CongducPham/PEPR_AgriFutur/README.md

Sensing Platform for the PEPR AgriFutur project
=======================================================

Read the latest news
-------

Read the [latest News for the PEPR AgriFutur project](https://iotsensingsystem.live-website.com/news-on-pepr-agrifutur) that are maintained on the [IoT-Sensing-System at UPPA web site](https://iotsensingsystem.live-website.com).

History
-------
- **Jan-25** Preliminary codes have been uploaded: the code for a Generic Simple Sensor Node and the code for a PoC LoRa image sensor node (LoRaCAM-AI).

- **Nov-24** We created the GitHub repository for the AgriFutur flagship project of the PEPR program. Check contributions & activities of UPPA team project on the [IoT-Sensing-System web site](https://iotsensingsystem.live-website.com/news-on-pepr-agrifutur). AgriFutur officially started in Feb. 1st, 2025. Stay tuned!

Quick start
-----------

The [Arduino sketch](https://github.com/CongducPham/PEPR_AgriFutur/tree/main/Arduino/Generic_Simple_Sensor_Node) for the Generic Simple Sensor Node is in the [Arduino folder](https://github.com/CongducPham/PEPR_AgriFutur/tree/main/Arduino). It is based on the code developed for the [PRIMA INTEL-IRRIS project](https://intel-irris.eu/) that is now extended and maintained in the context of AgriFutur. All the tutorials to build sensor devices with the developed PCB v4.1 (RFM95) and PCB v5 (RAK3172) are in the [Tutorials](https://github.com/CongducPham/PEPR_AgriFutur/tree/main/Tutorials) folder. Fully assembled PCBs can be ordered directly from the PCB manufacturer. See the [README](https://github.com/CongducPham/PEPR_AgriFutur/blob/main/PCBs/README.md) for guidelines to do so. 

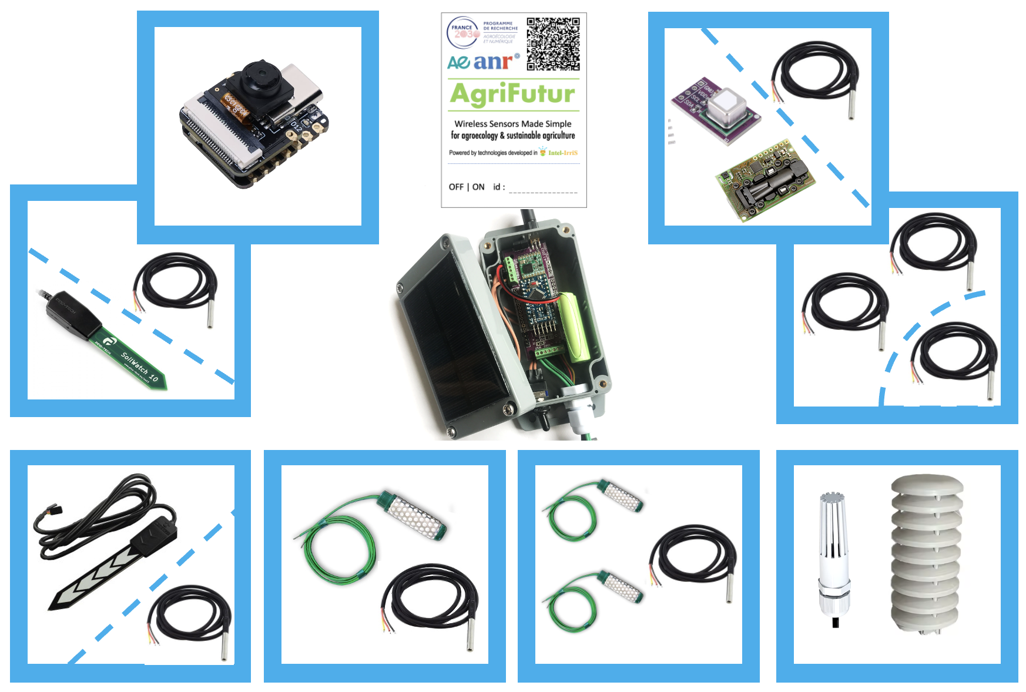
[picture p1: images/generic-sensors.png]


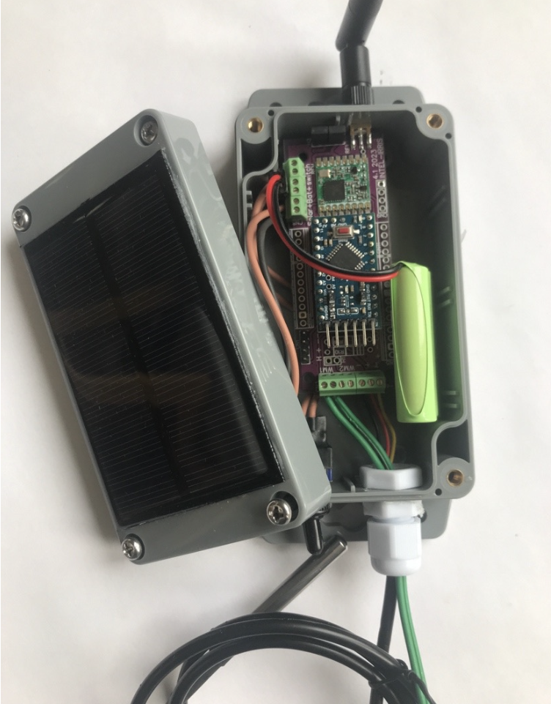
[picture p2: images/sensor-device.png]


The [PoC of a LoRa image sensor (LoRaCAM-AI)](https://github.com/CongducPham/PEPR_AgriFutur/tree/main/Arduino_ESP32/Arduino_ESP32_LoRaCAM_AI_on_esp32v3) based on ESP32 camera board is in the [Arduino_ESP32 folder](https://github.com/CongducPham/PEPR_AgriFutur/tree/main/Arduino_ESP32) where a dedicated [README](https://github.com/CongducPham/PEPR_AgriFutur/tree/main/Arduino_ESP32/README.md) is available. We tested several ESP32-based camera boards. The main criterion was to have enough pins left to easily connect an SPI LoRa radio module. 3 boards offer this capabilities: `Freenove ESP32-S3 WROOM`, `Freenove ESP32 WROVER v1.6` and `XIAO ESP32-S3 Sense`. The choice was finally set to the state-of-the-art `XIAO ESP32-S3 Sense` which has a huge developer community and enough resource to run some embedded AI processing that we want to add in the future, and all this in a quite compact format. If other boards appear on the market, the [LoRa test sketch](https://github.com/CongducPham/PEPR_AgriFutur/tree/main/Arduino_ESP32/Arduino_ESP32_LoRa_SX12XX_test) can be used to test whether the LoRa radio module you choose can be controlled by the pins on the new boards. Of course, you have to change the pin mapping and test.

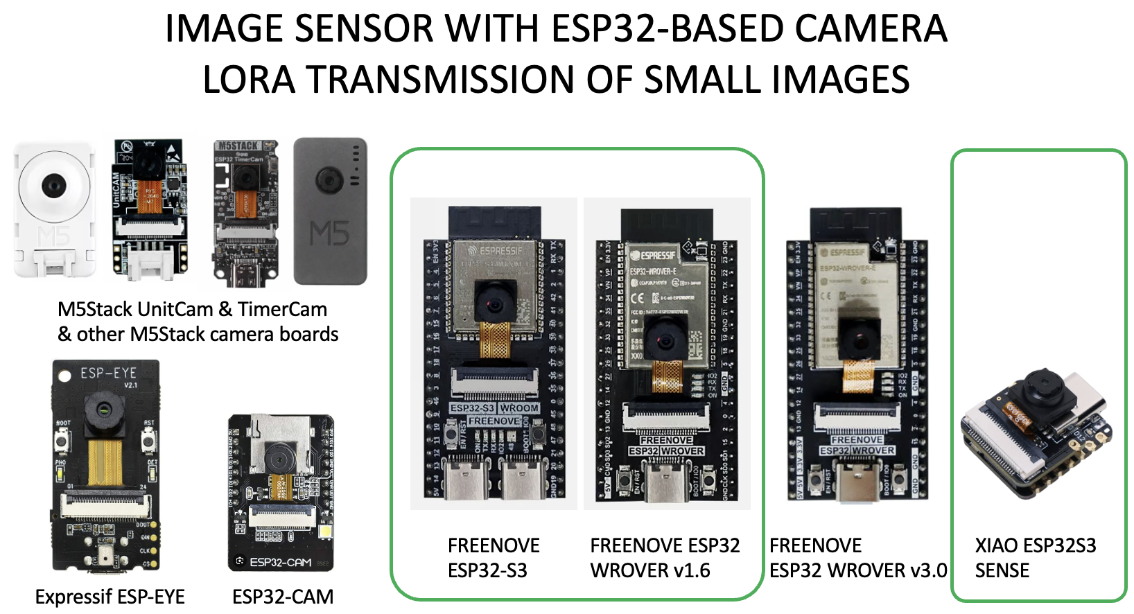
[picture p3: images/ESP32-camera-board.png]


For the LoRaCAM image sensor, the [Tools folder](https://github.com/CongducPham/PEPR_AgriFutur/tree/main/Arduino_ESP32/Tools) contains the various software tools to test the customized image encoding approach in order to have a robust encoding scheme for efficient LoRa transmission of images.

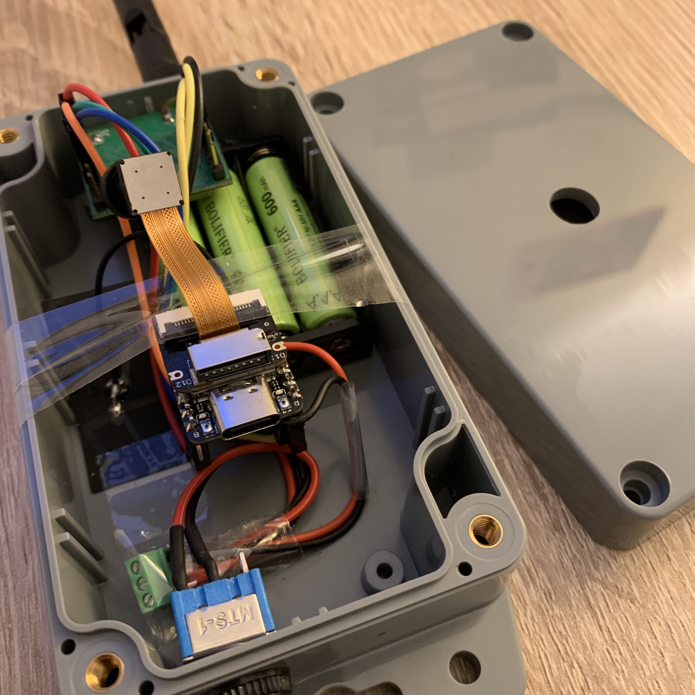
[picture p4: images/lora_cam_1.jpg]
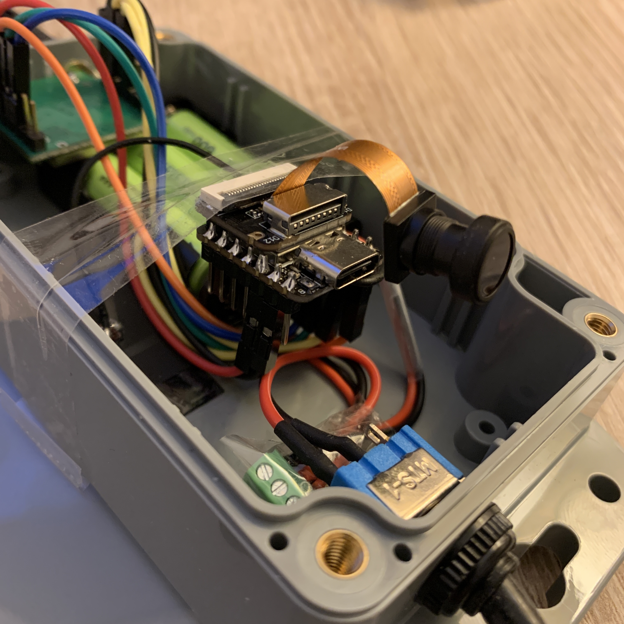
[picture p5: images/lora_cam_2.jpg]
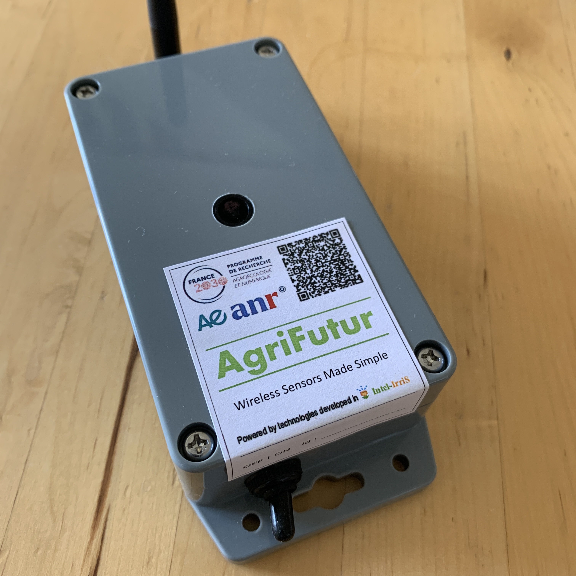
[picture p6: images/lora_cam_3.jpg]
  

Images from LoRaCAM-AI devices are integrated in the gateway dashboard using Home Assistant. Read this specific [README](https://github.com/CongducPham/PEPR_AgriFutur/tree/main/Gateway/scripts/loracam-ai/README.md) to understand how images from LoRaCAM-AI devices are handled and processed by the gateway.

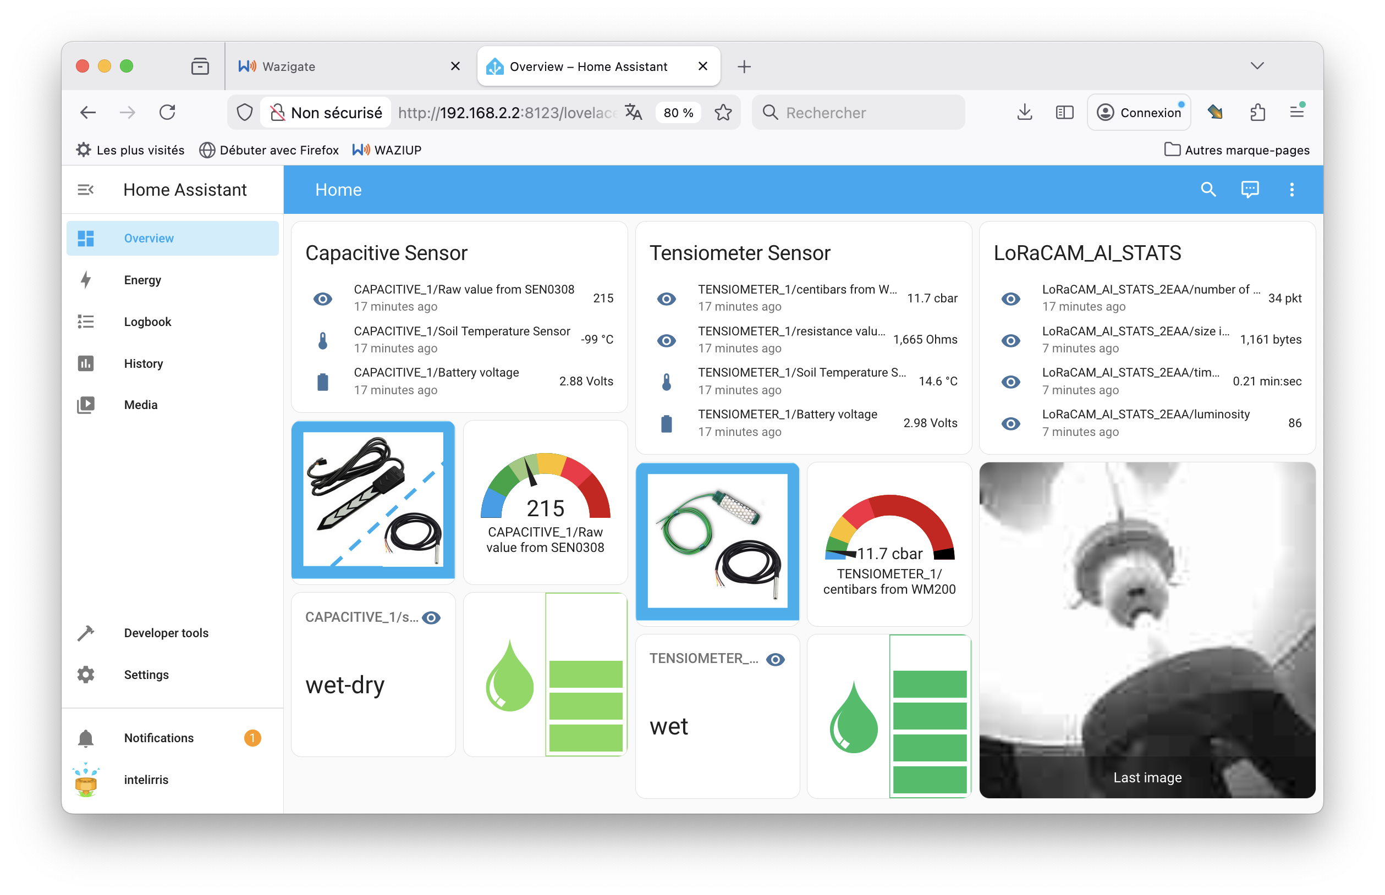
[picture p7: images/ha_default_view.png]


Enjoy!
C. Pham
Scientific Leader for the Sensing Platform
