CongducPham/PEPR_AgriFutur/PCBs/README.md

RFM95W/RFM96W breakout
----------------------

The RFM95W/RFM96W breakout board was developed in our early [LowCostLoRaGw project](https://github.com/CongducPham/LowCostLoRaGw/tree/master). It provides a simple solution to have a LoRa hat for the Raspberry Pi single-channel gateway.

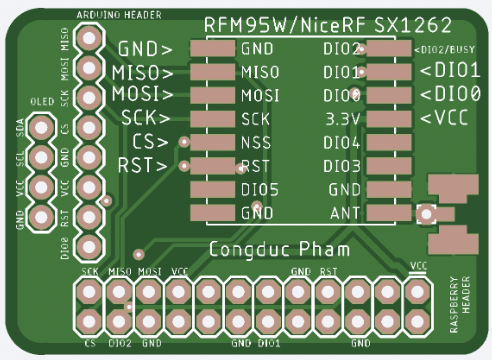
[picture p13: images/RFM95Breakout-pcb-top.png]


You can download the zipped Gerber file `RFM95Breakout_2020-11-13-long.zip` in this folder and make them manufactured by a PCB manufacturer. You can look at the tutorial produced in the context of the INTEL-IRRIS project on how to order PCB: [Building the INTEL-IRRIS IoT platform. Annex 1: ordering the PCBs, including PCBA](https://github.com/CongducPham/PRIMA-Intel-IrriS/blob/main/Tutorials/Intel-Irris-PCB-update-PCBA.pdf). 

PCB v4.1
----

This PCB for the Arduino ProMini (3.3v, 8MHz version) can be used for prototyping and even integration purpose. It allows much simpler wiring of the soil humidity sensor, the watermark sensors and the soil temperature sensor (placeholder for associated resistors are already there). It is based on the PCB developed by IRD for the [PRIMA INTEL-IRRIS](https://intel-irris.eu/) project. In PEPR AgriFutur, a larger variety of physical sensors will be connected.

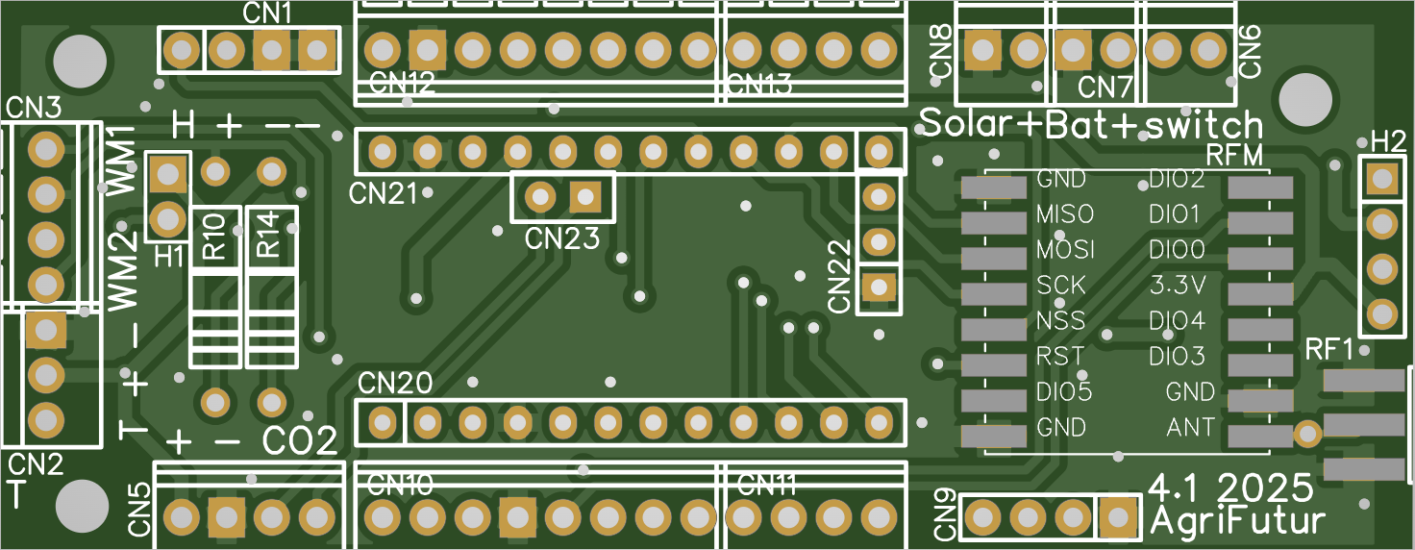
[picture p14: images/raw-pcbv4.1-top.png]


This PCB also integrates by default a low-cost solar charging circuit to add solar panel and rechargeable NiMh batteries. The whole solar circuit appears on the back of the PCB (left part of the PCB) as illustrated below.

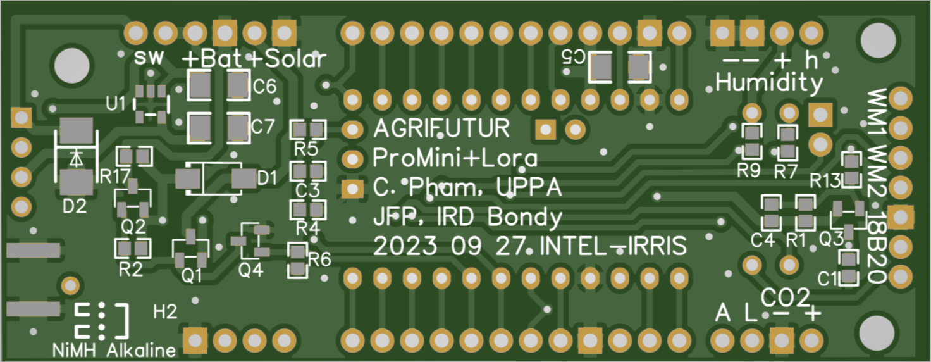
[picture p15: images/raw-pcbv4.1-bottom.png]


You can download the Gerber zipped archive and view them on an [online Gerber viewer](https://www.pcbgogo.com/GerberViewer.html).

- Arduino ProMini PCB v4.1 for RFM95W/RFM96W zipped Gerber archive, 2-layer board of 30.89x79.5mm [.zip](https://github.com/CongducPham/PEPR_AgriFutur/raw/main/PCBs/IRD_PCB_4_1/Gerber_IISS_4.1-version-for-PEPR-AgriFutur_PCB4_IISS_2025-02-19.zip)

The raw PCB will of course not have the additional electronic components. While it is possible to add these component manually, in practice it is not recommended as the components are small and manually soldering them is prone to errors. 

PCBA v4.1
----

Instead, the fully assembled PCB (PCBA) with solar circuit can be ordered fully assembled from PCB manufacturers.

You can download the BOM & CPL files to order the fully assembled board from PCB manufacturers. You can look at the tutorial produced in the context of the INTEL-IRRIS project on how to order PCB that are fully assembled by the manufacturer: [Building the INTEL-IRRIS IoT platform. Annex 1: ordering the PCBs, including PCBA](https://github.com/CongducPham/PRIMA-Intel-IrriS/blob/main/Tutorials/Intel-Irris-PCB-update-PCBA.pdf).  

- Bill of Materiels (BOM) file for the PCB v4.1 RFM95W 868 [.xlsx](https://github.com/CongducPham/PEPR_AgriFutur/raw/main/PCBs/IRD_PCB_4_1/BOM_SMT_TB_RFM95_868_IISS_PCB4_1_wH2_last-modified.xlsx). If you want the version without CN1 nor CN5 to have more flexibility to connect physical sensors, you can take this one [.xlsx](https://github.com/CongducPham/PEPR_AgriFutur/raw/main/PCBs/IRD_PCB_4_1/BOM_SMT_TB_RFM95_868_IISS_PCB4_1_wH2_last-modified-noCN1-noCN5.xlsx)

- CPL file for the PCB v4.1 [.csv](https://github.com/CongducPham/PEPR_AgriFutur/raw/main/PCBs/IRD_PCB_4_1/CPL_PCB4_1_RFM9X.csv)

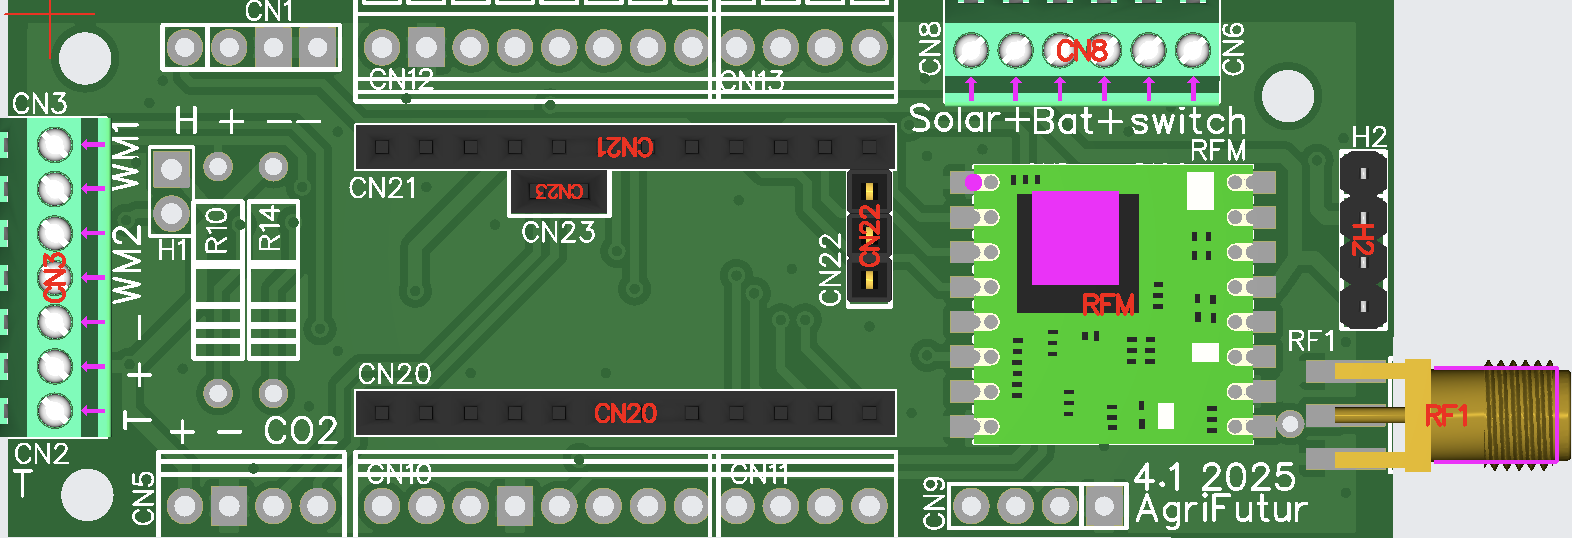
[picture p16: images/pcbav4.1-top.png]


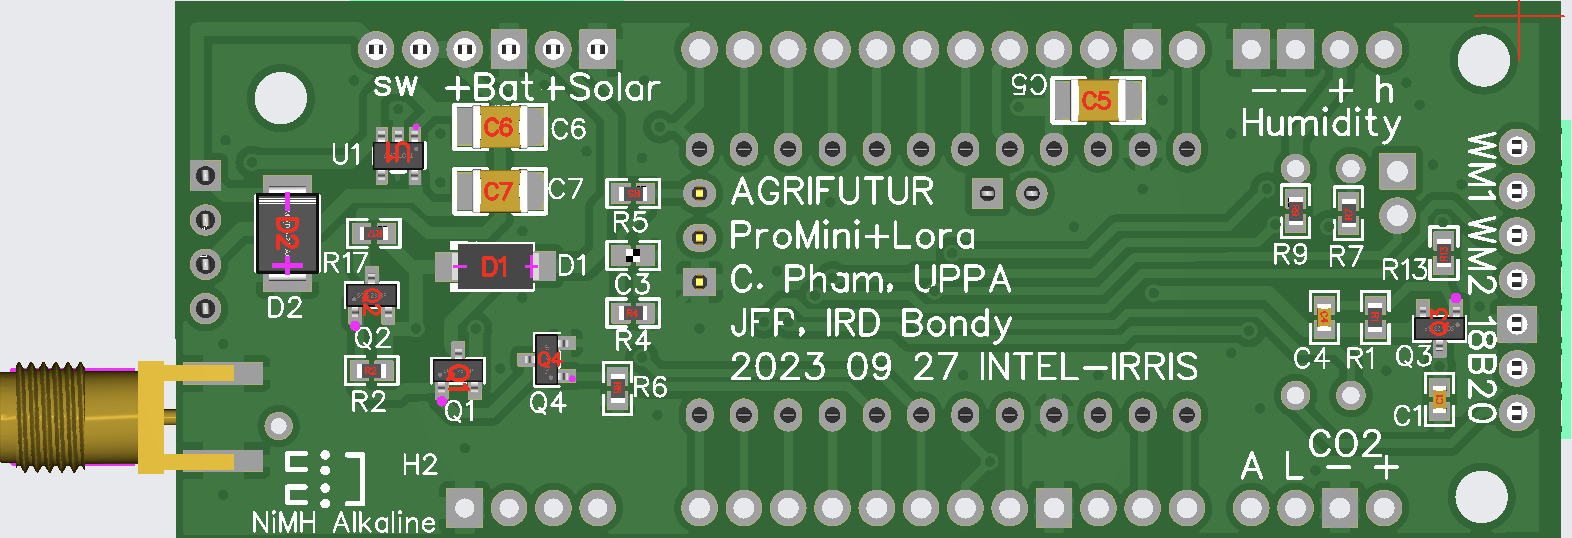
[picture p17: images/pcbav4.1-bottom.png]


Read [INTEL-IRRIS Newsletter #4](https://intel-irris.eu/intel-irris-newsletter-4) that presented a brief description with additional images.

PCB v5
----

This PCB is the RAK3172 version of the PCB v4.1. It is based on the PCB developed by IRD for the [PRIMA INTEL-IRRIS](https://intel-irris.eu/) project.

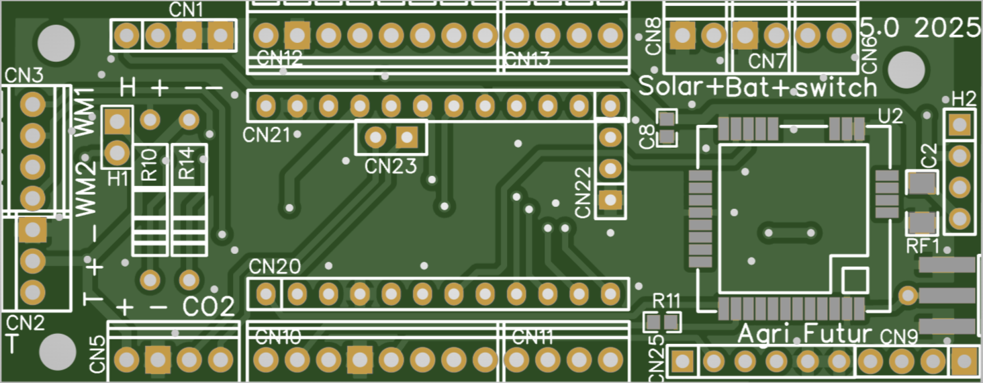
[picture p18: images/raw-pcbv5-top.png]


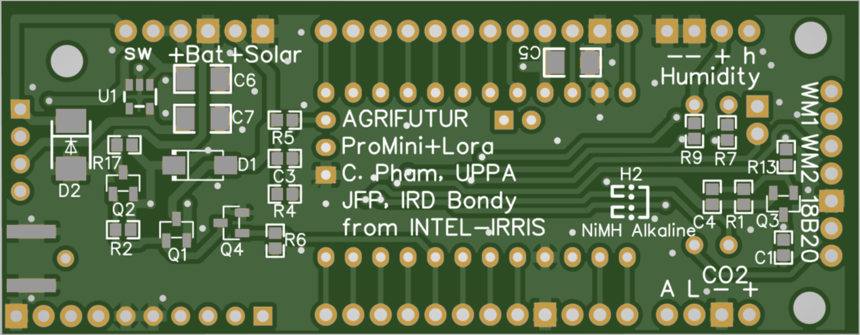
[picture p19: images/raw-pcbv5-bottom.png]


You can download the Gerber zipped archive and view them on an [online Gerber viewer](https://www.pcbgogo.com/GerberViewer.html).

- Arduino ProMini PCB v5 for RAK3172 zipped Gerber archive, 2 layer board of 30.89x79.5mm [.zip](https://github.com/CongducPham/PEPR_AgriFutur/raw/main/PCBs/IRD_PCB_5/Gerber_IISS_5-version-for-PEPR-AgriFutur_PCB5_IISS_2025-02-19.zip)

Because the RAK3172 module is connected to the Arduino's serial port (UART), there is a specific procedure to debug the board in order to see the text output normally printed to the serial monitor window of the Arduino IDE. See the [tutorial on using this PCB v5](https://docs.google.com/viewer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) produced in the context of the INTEL-IRRIS project. A correct output would be similar to [this output example](https://github.com/CongducPham/PEPR_AgriFutur/raw/main/PCBs/IRD_PCB_5/dump-serial-debug.txt)

PCBA v5
----

The fully assembled PCB (PCBA) with solar circuit can be ordered fully assembled from PCB manufacturers.

You can download the BOM & CPL files to order the fully assembled board from PCB manufacturers. You can look at the tutorial produced in the context of the INTEL-IRRIS project on how to order PCB that are fully assembled by the manufacturer: [Building the INTEL-IRRIS IoT platform. Annex 1: ordering the PCBs, including PCBA](https://github.com/CongducPham/PRIMA-Intel-IrriS/blob/main/Tutorials/Intel-Irris-PCB-update-PCBA.pdf). 

- Bill of Materiels (BOM) file for the PCB v5 RAK3172 [.xlsx](https://github.com/CongducPham/PEPR_AgriFutur/raw/main/PCBs/IRD_PCB_5/BOM_SMT_TB_RAK3172_868_IISS_PCB5.xlsx). If you want the version without CN1 nor CN5 to have more flexibility to connect physical sensors, you can take this one [.xlsx](https://github.com/CongducPham/PEPR_AgriFutur/raw/main/PCBs/IRD_PCB_5/BOM_SMT_TB_RAK3172_868_IISS_PCB5-noCN1-noCN5.xlsx) 

- CPL file for the PCB v5 [.csv](https://github.com/CongducPham/PEPR_AgriFutur/raw/main/PCBs/IRD_PCB_5/CPL_PCB5_RAK3172.csv)

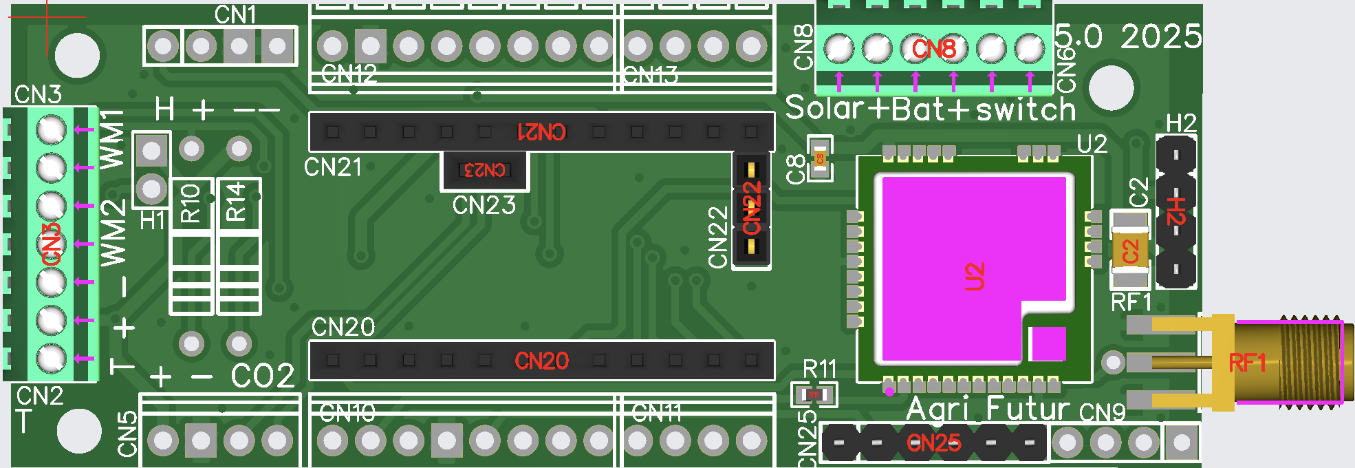
[picture p20: images/pcbav5-top.png]


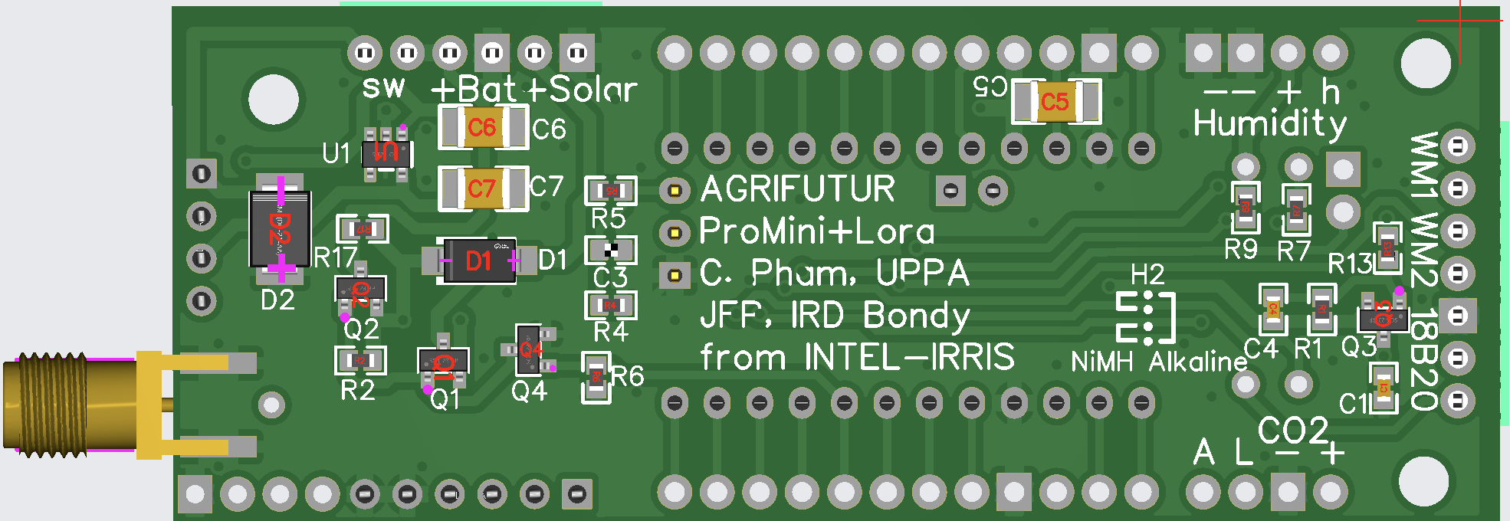
[picture p21: images/pcbav5-bottom.png]
