CongducPham/PEPR_AgriFutur/Gateway/custom-wazigate-version.txt

Main version history

Nov 6th, 2026
-------------
- addition of an MQTT Bridge service

Jun 4th, 2026
-------------
- A version of the SD card image has Home Assistant (Docker container) upgraded to Core 2026.6.0 and Frontend 20260527.4
  - Needs an RPI4B/4GB
  - For RPI3B/3B+ it is advised to keep the version with Home Assistant Core 2025.3.3 Frontend 20250306.0

May 5, 2026
-----------
- major updates in device creation scripts to be more generic and support OTAA devices

Mar 8, 2026
-----------
- major updates in scripts to better integrate with Home Assistant which will be used for dashboards

Feb 24, 2025
------------
- rebrand gateway to generic gateway that will be improved independently from INTEL-IRRIS project

For all changes up to Feb 24, 2025
see https://github.com/CongducPham/PRIMA-Intel-IrriS/commits/main for all commits
---------------------------------------------------------------------------------

Feb 5, 2023
-----------
- if /boot/gateway.zip then unzip -o /boot/gateway.zip to /home/pi to update the whole distribution

Jan 9, 2023
-----------
- add Home Assistant integration for starter-kit default devices

Nov 6, 2022
-----------
- Update for WaziGate v2

Jun 15, 2022 
------------
- add INTEL-IRRIS WaziGate auto configuration features
- add RTC support by default

Mar 14, 2022 
------------
- add main INTEL-IRRIS WaziGate features including OLED service
