CongducPham/PEPR_AgriFutur/Arduino_ESP32/Tools/crop-128x128-gray.bmp

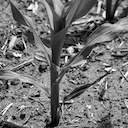
Arduino_ESP32/Tools/crop-128x128-gray.bmp
