CongducPham/PEPR_AgriFutur/Arduino_ESP32/Tools/desert-320x320-gray.bmp

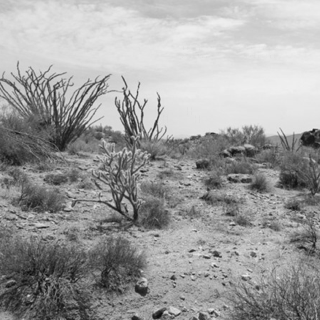
Arduino_ESP32/Tools/desert-320x320-gray.bmp
