CongducPham/PEPR_AgriFutur/Gateway-enclosure/Thingiverse-3012012/images/3a9fb1669e163fa8e6f62b41e994cbb3.png

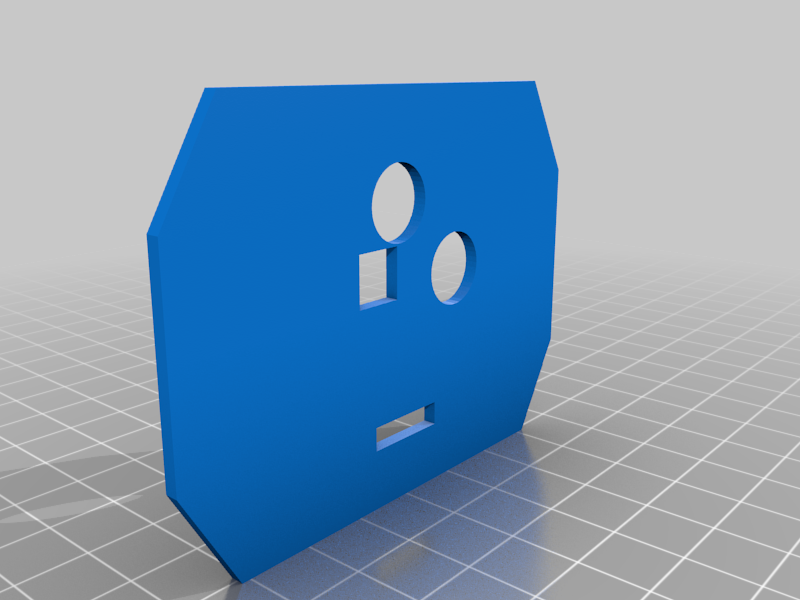
Gateway-enclosure/Thingiverse-3012012/images/3a9fb1669e163fa8e6f62b41e994cbb3.png
