CongducPham/PEPR_AgriFutur/Gateway-enclosure/Thingiverse-3012012/images/5d9ff9ce8ffc4cafd219a67ea2d53af6.png

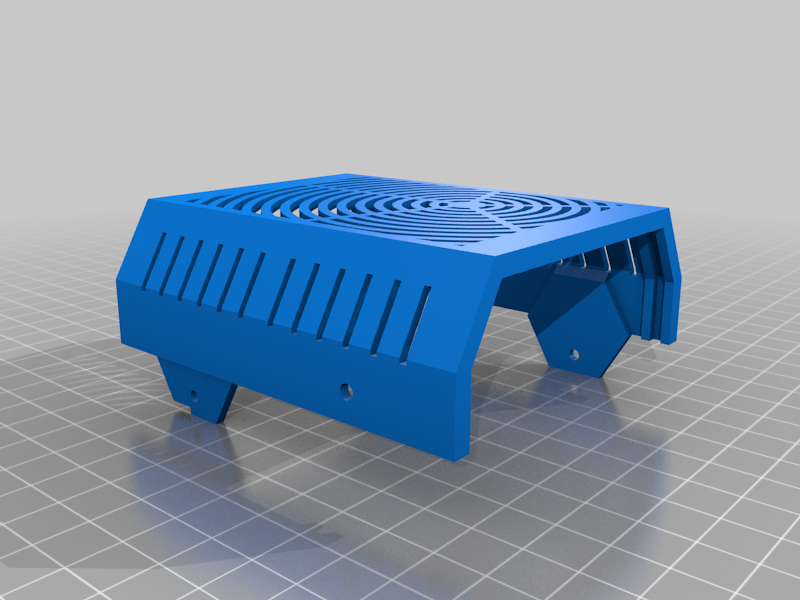
Gateway-enclosure/Thingiverse-3012012/images/5d9ff9ce8ffc4cafd219a67ea2d53af6.png
