CongducPham/PEPR_AgriFutur/Gateway-enclosure/Thingiverse-3012012/images/035e2898fc129eb11a27253a7164e232.png

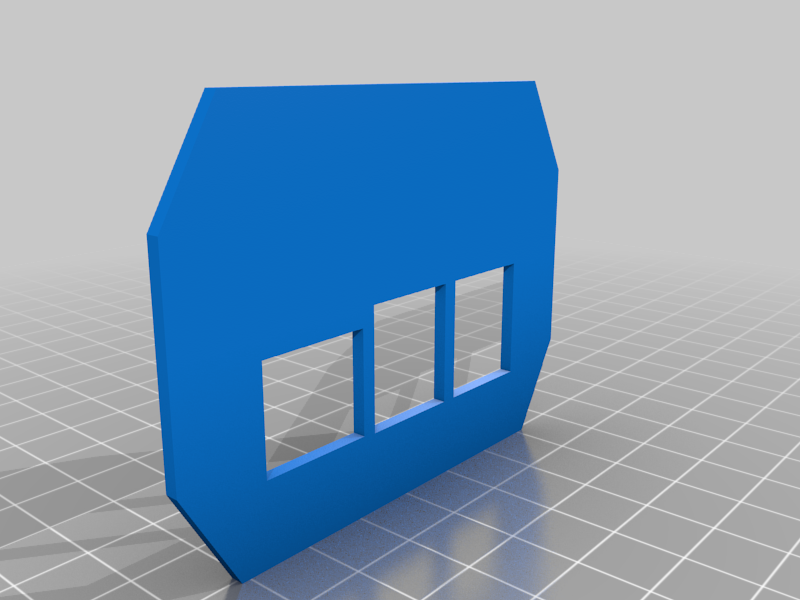
Gateway-enclosure/Thingiverse-3012012/images/035e2898fc129eb11a27253a7164e232.png
