CongducPham/PEPR_AgriFutur/Gateway-enclosure/Thingiverse-3012012/images/b7720d26d454f8fca5810aec2a01b513.png

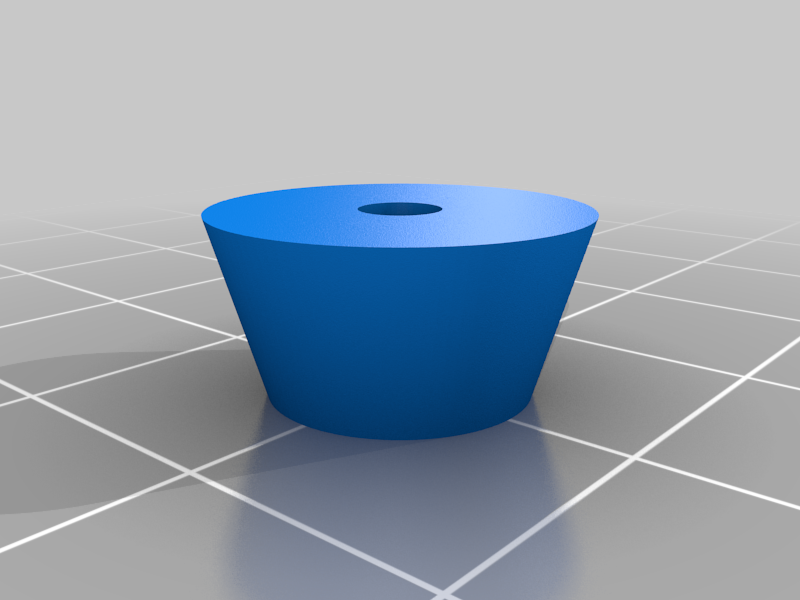
Gateway-enclosure/Thingiverse-3012012/images/b7720d26d454f8fca5810aec2a01b513.png
