CongducPham/PEPR_AgriFutur/Gateway-enclosure/Thingiverse-3012012/images/ffb8839986fd340b0de97bd7aa0d657d.png

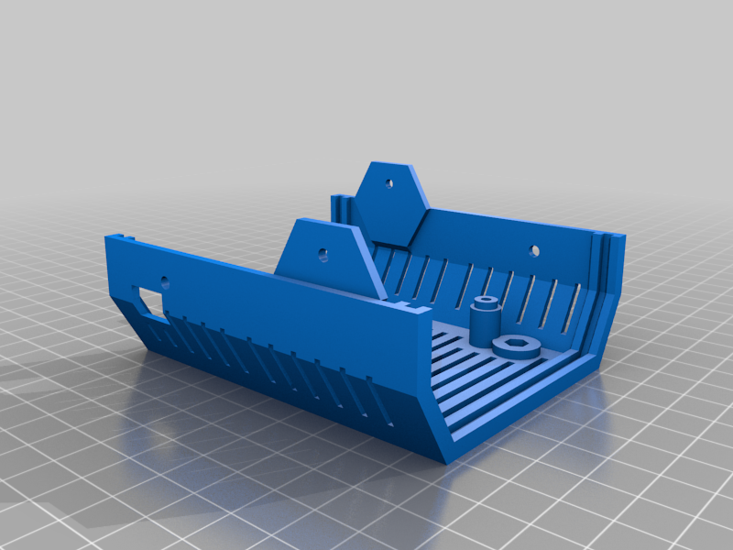
Gateway-enclosure/Thingiverse-3012012/images/ffb8839986fd340b0de97bd7aa0d657d.png
