CongducPham/PEPR_AgriFutur/Gateway-enclosure/Thingiverse-3012012/images/TTNRak831-001.jpg

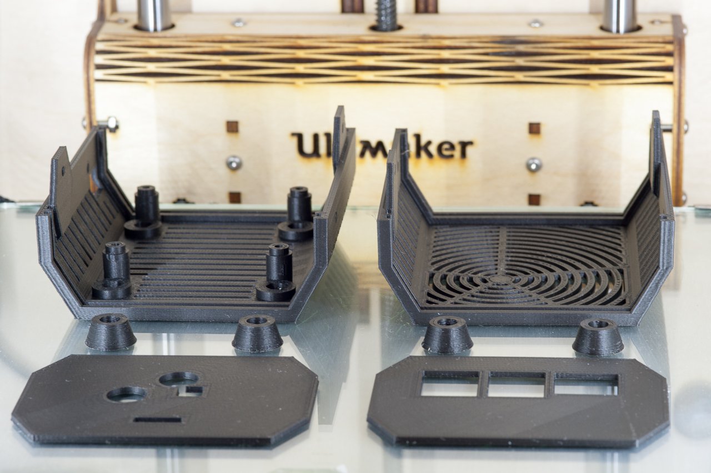
Gateway-enclosure/Thingiverse-3012012/images/TTNRak831-001.jpg
