CongducPham/PEPR_AgriFutur/Gateway-enclosure/Thingiverse-3012012/images/TTNRak831-002.jpg

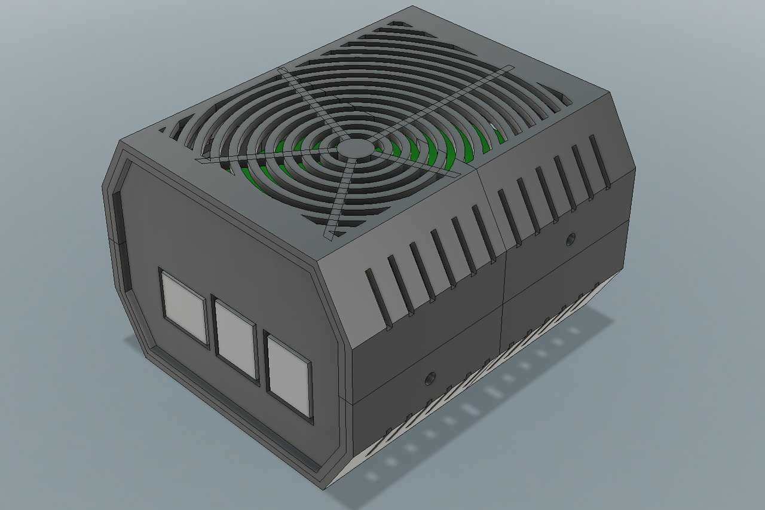
Gateway-enclosure/Thingiverse-3012012/images/TTNRak831-002.jpg
