CongducPham/PEPR_AgriFutur/Gateway-enclosure/Thingiverse-3012012/images/TTNRak831-003.jpg

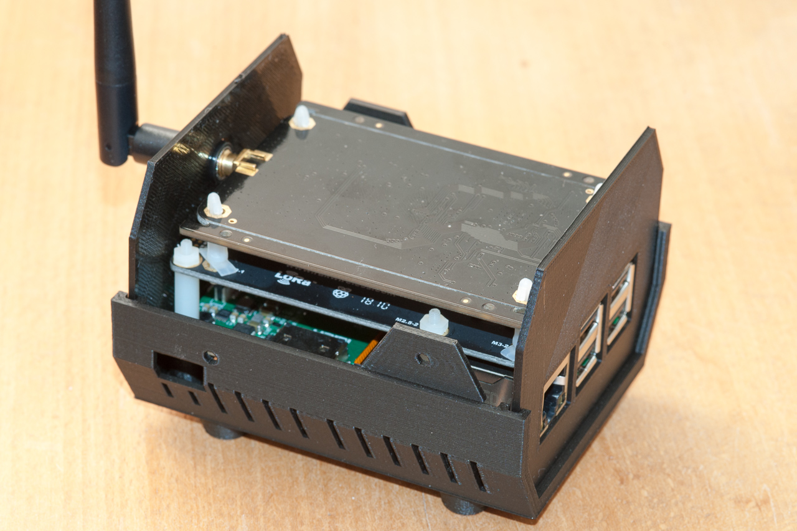
Gateway-enclosure/Thingiverse-3012012/images/TTNRak831-003.jpg
