CongducPham/PEPR_AgriFutur/Gateway-enclosure/Thingiverse-3012012/images/TTNRak831-004.jpg

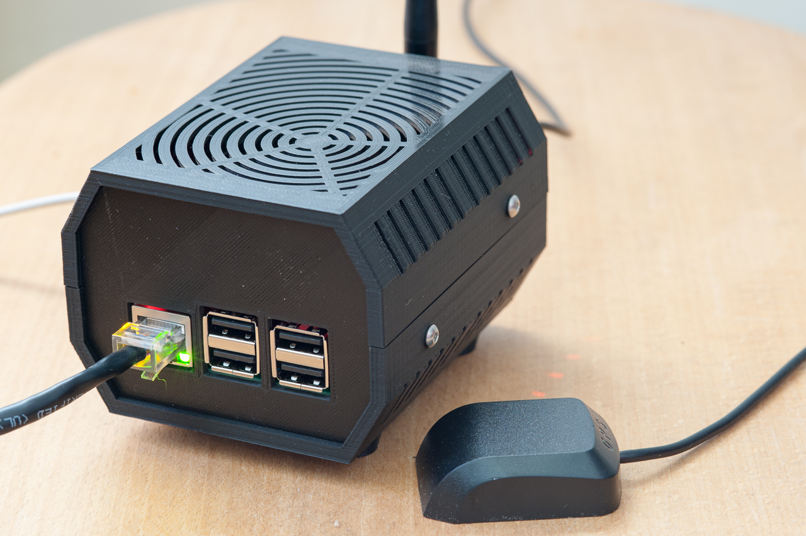
Gateway-enclosure/Thingiverse-3012012/images/TTNRak831-004.jpg
