CongducPham/PEPR_AgriFutur/Gateway-enclosure/Thingiverse-3012012/new-images/IMG_2732-removebg-preview.png

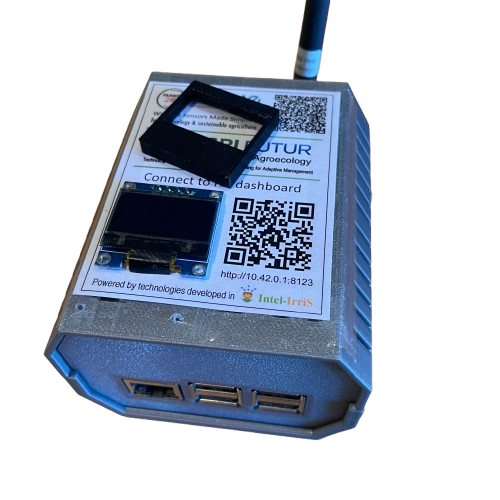
Gateway-enclosure/Thingiverse-3012012/new-images/IMG_2732-removebg-preview.png
