CongducPham/PEPR_AgriFutur/Gateway/homeassistant/www/sensors/2tensiometer_temp.png

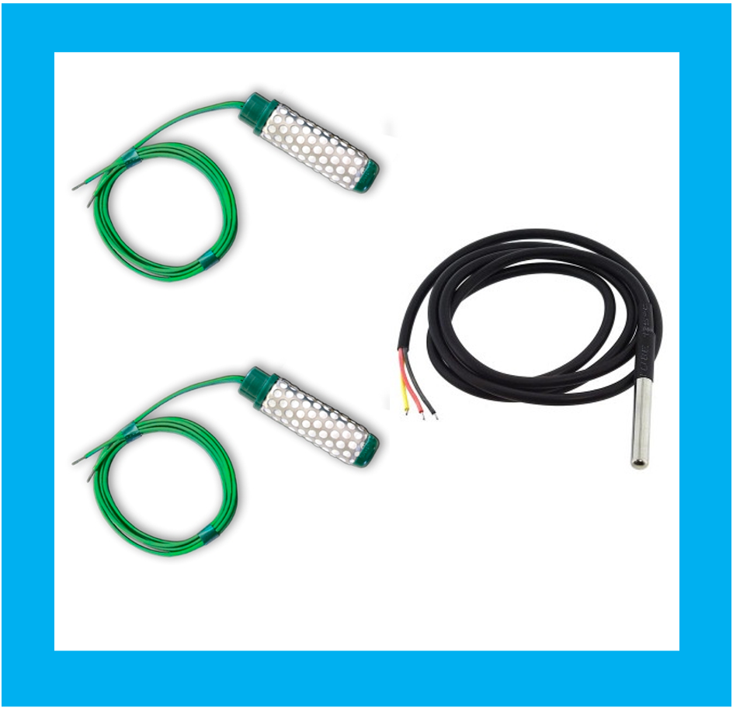
Gateway/homeassistant/www/sensors/2tensiometer_temp.png
