CongducPham/PEPR_AgriFutur/Gateway/homeassistant/www/sensors/air_temp_hum.png

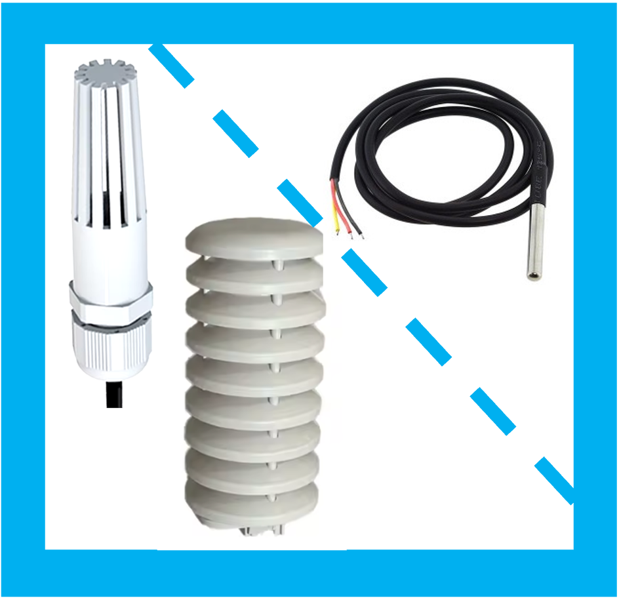
Gateway/homeassistant/www/sensors/air_temp_hum.png
