CongducPham/PEPR_AgriFutur/Gateway/homeassistant/www/sensors/capacitive_temp.png

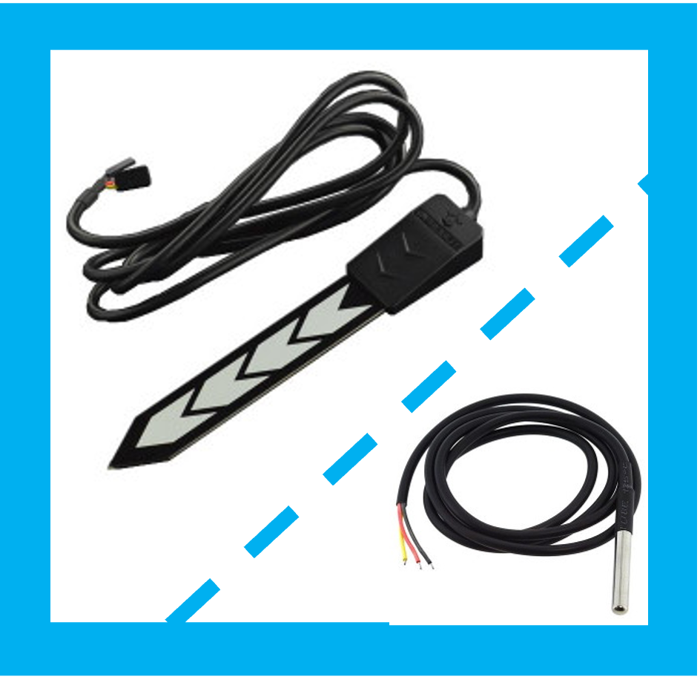
Gateway/homeassistant/www/sensors/capacitive_temp.png
