CongducPham/PEPR_AgriFutur/Gateway/homeassistant/www/sensors/co2_temp.png

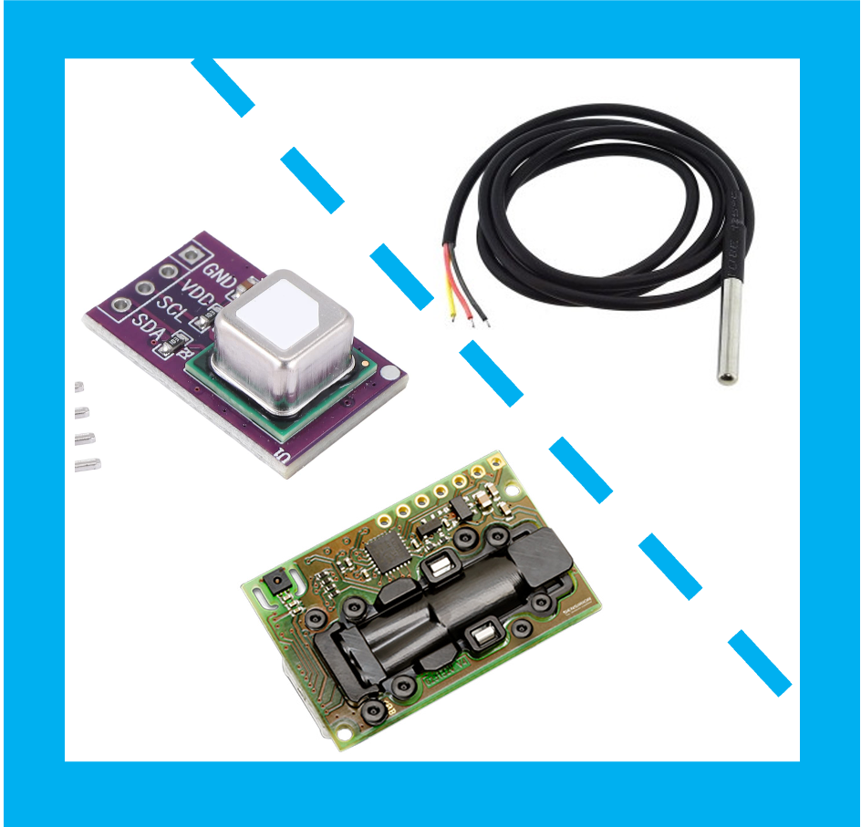
Gateway/homeassistant/www/sensors/co2_temp.png
