CongducPham/PEPR_AgriFutur/Gateway/homeassistant/www/sensors/lorain.png

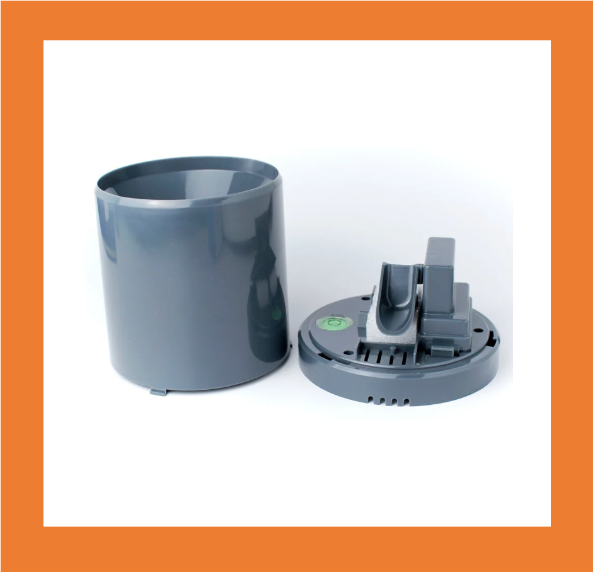
Gateway/homeassistant/www/sensors/lorain.png
