CongducPham/PEPR_AgriFutur/Gateway/homeassistant/www/sensors/sensecap2120.png

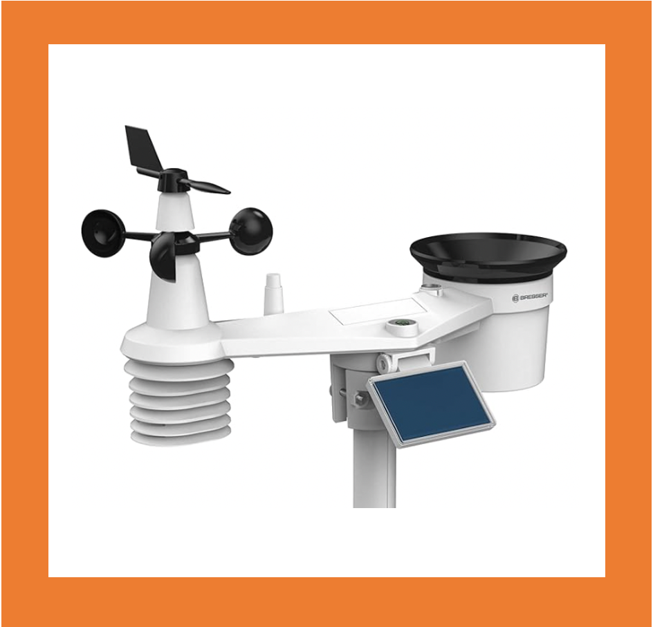
Gateway/homeassistant/www/sensors/sensecap2120.png
