CongducPham/PEPR_AgriFutur/Gateway/homeassistant/www/sensors/soil_temp.png

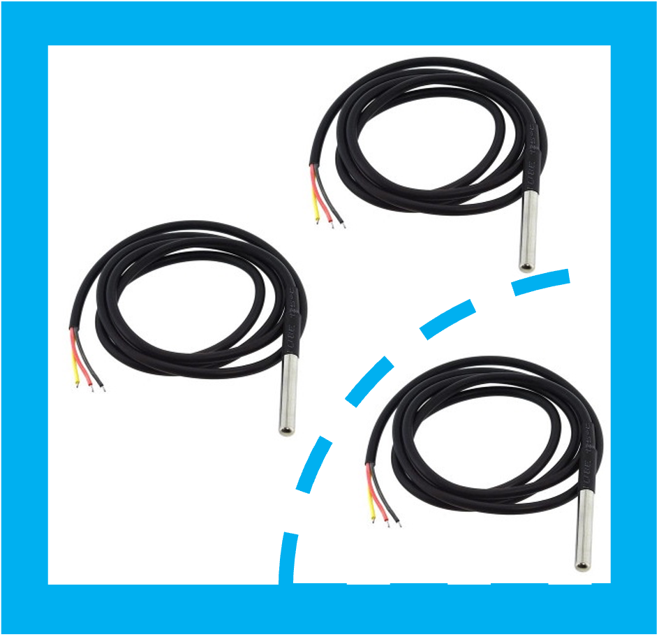
Gateway/homeassistant/www/sensors/soil_temp.png
