CongducPham/PEPR_AgriFutur/Gateway/homeassistant/www/sensors/tensiometer_temp.png

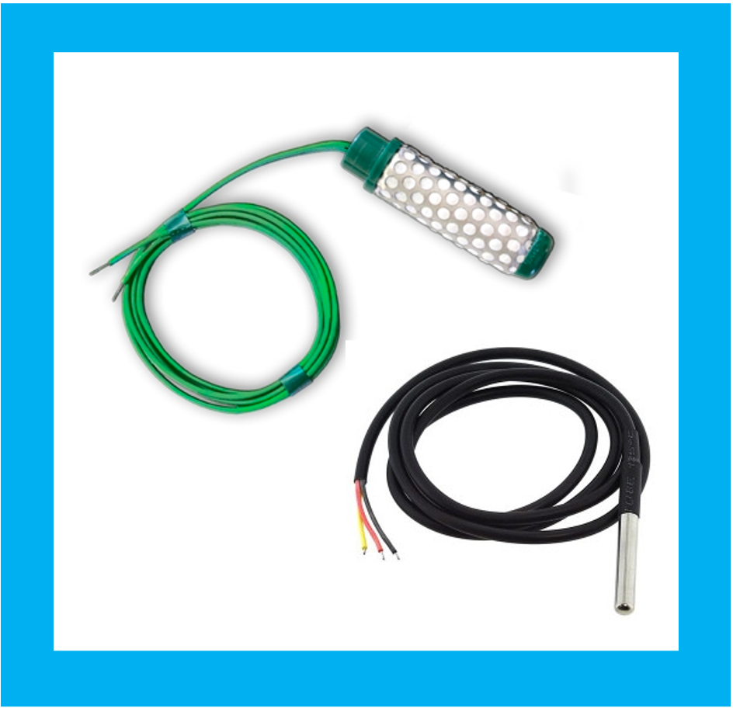
Gateway/homeassistant/www/sensors/tensiometer_temp.png
