CongducPham/PEPR_AgriFutur/Gateway/oled/wifi.png

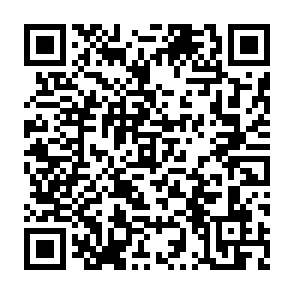
Gateway/oled/wifi.png
