CongducPham/PEPR_AgriFutur/Gateway/scripts/loracam-ai/tools/decode-2025-02-26-09-54-31_image_dat.txt-P60-S1985.bmp

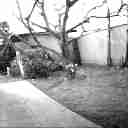
Gateway/scripts/loracam-ai/tools/decode-2025-02-26-09-54-31_image_dat.txt-P60-S1985.bmp
