CongducPham/PEPR_AgriFutur/Gateway/scripts/loracam-ai/tools/gw-images/example/decode-2025-02-28-11-00-41_LoRaCAM_AI_DEV_2DAB.txt-P49-S1699.bmp

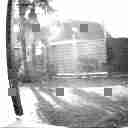
Gateway/scripts/loracam-ai/tools/gw-images/example/decode-2025-02-28-11-00-41_LoRaCAM_AI_DEV_2DAB.txt-P49-S1699.bmp
