CongducPham/PEPR_AgriFutur/Gateway/scripts/loracam-ai/tools/gw-images/example/decode-2025-03-20-22-11-55_LoRaCAM_AI_DEV_2DAA.txt-P34-S1161.bmp

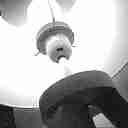
Gateway/scripts/loracam-ai/tools/gw-images/example/decode-2025-03-20-22-11-55_LoRaCAM_AI_DEV_2DAA.txt-P34-S1161.bmp
