CongducPham/PEPR_AgriFutur/Gateway/scripts/lorain-aquascope/lorain-1.png

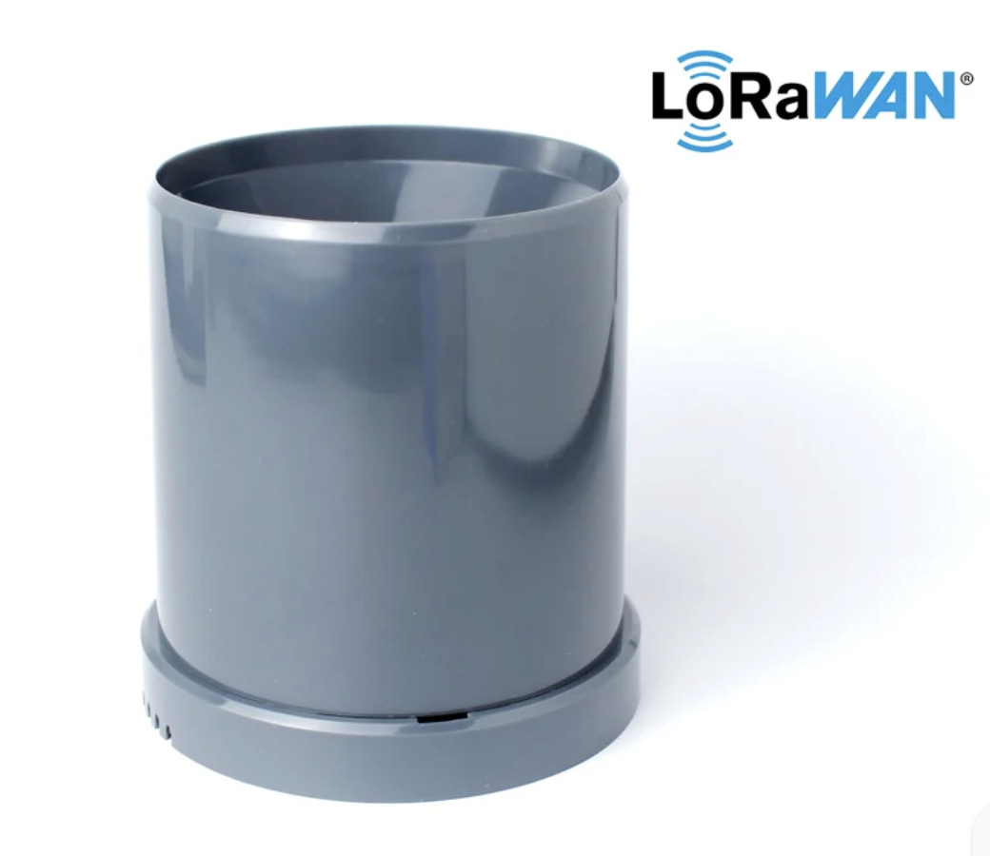
Gateway/scripts/lorain-aquascope/lorain-1.png
