CongducPham/PEPR_AgriFutur/Gateway/scripts/lorain-aquascope/lorain-2.png

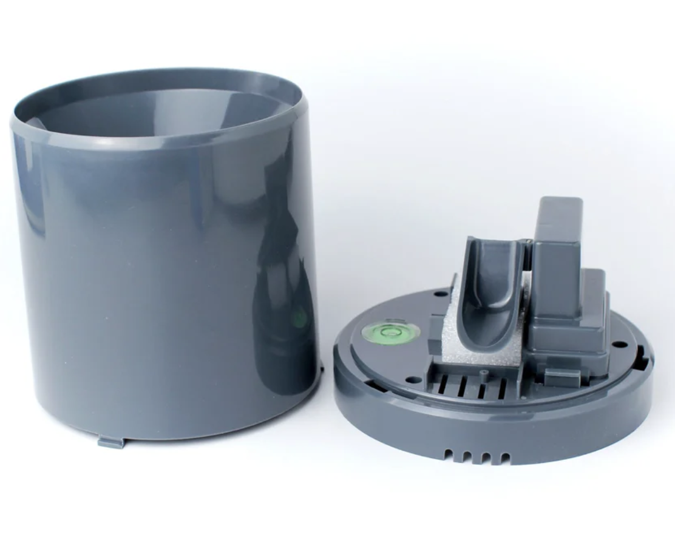
Gateway/scripts/lorain-aquascope/lorain-2.png
