CongducPham/PEPR_AgriFutur/images/RFM95Breakout-pcb-bottom.png

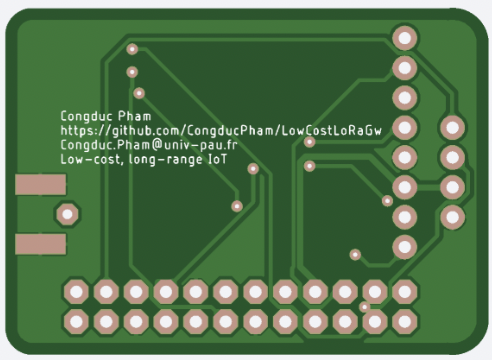
images/RFM95Breakout-pcb-bottom.png
