CongducPham/PEPR_AgriFutur/Gateway-enclosure/Thingiverse-3012012/new-images/new-parts.png

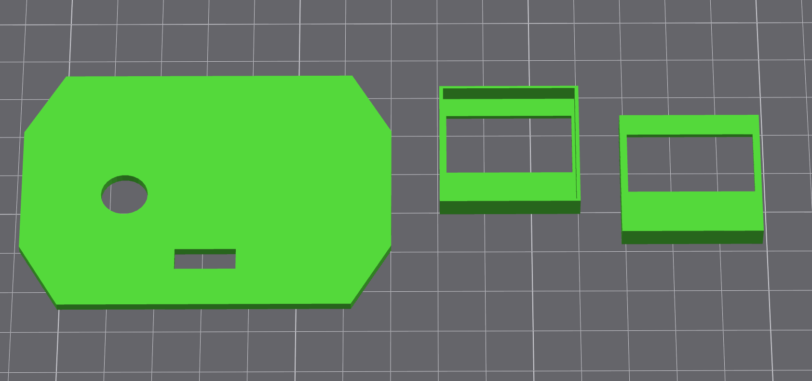
Gateway-enclosure/Thingiverse-3012012/new-images/new-parts.png
