CongducPham/PEPR_AgriFutur/Gateway-enclosure/Thingiverse-3012012/files/TTNRak831OledCover.stl

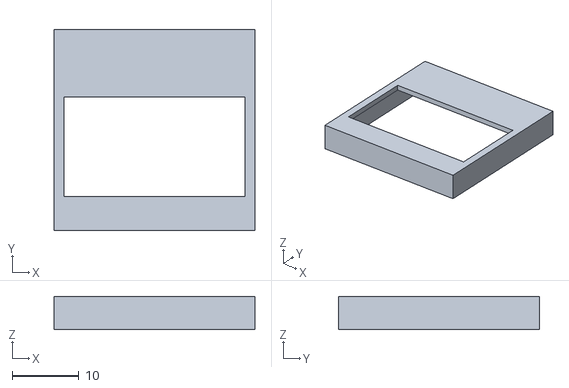
[picture p80: CAD file, 2026-05-27]
Gateway-enclosure/Thingiverse-3012012/files/TTNRak831OledCover.stl
30.0 x 30.0 x 5.00
