CongducPham/PEPR_AgriFutur/Gateway-enclosure/Thingiverse-3012012/files/TTNRak831PanelBackNew.stl

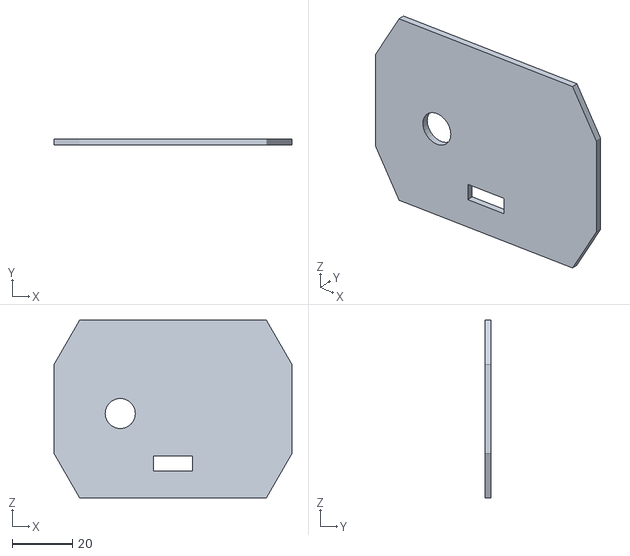
[picture p81: CAD file, 2026-05-27]
Gateway-enclosure/Thingiverse-3012012/files/TTNRak831PanelBackNew.stl
79.0 x 2.00 x 59.0
