CongducPham/PEPR_AgriFutur/Gateway-enclosure/Thingiverse-3012012/files/TTNRak831Foot.stl

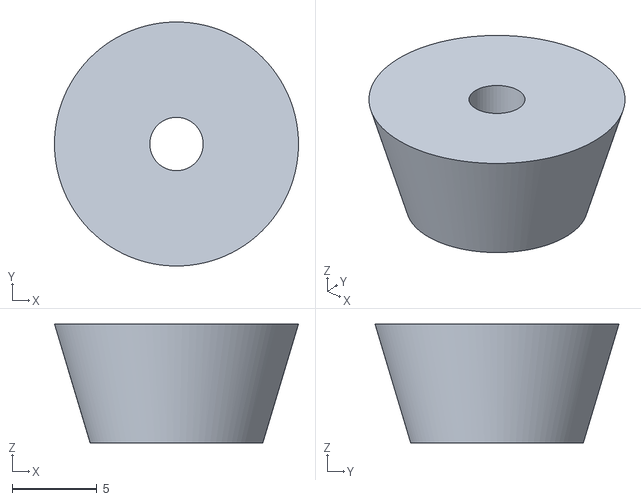
[picture p83: CAD file, 2026-05-21]
Gateway-enclosure/Thingiverse-3012012/files/TTNRak831Foot.stl
14.4 x 14.4 x 7.00
