CongducPham/PEPR_AgriFutur/Gateway-enclosure/Thingiverse-3012012/files/TTNRak831CaseTop.stl

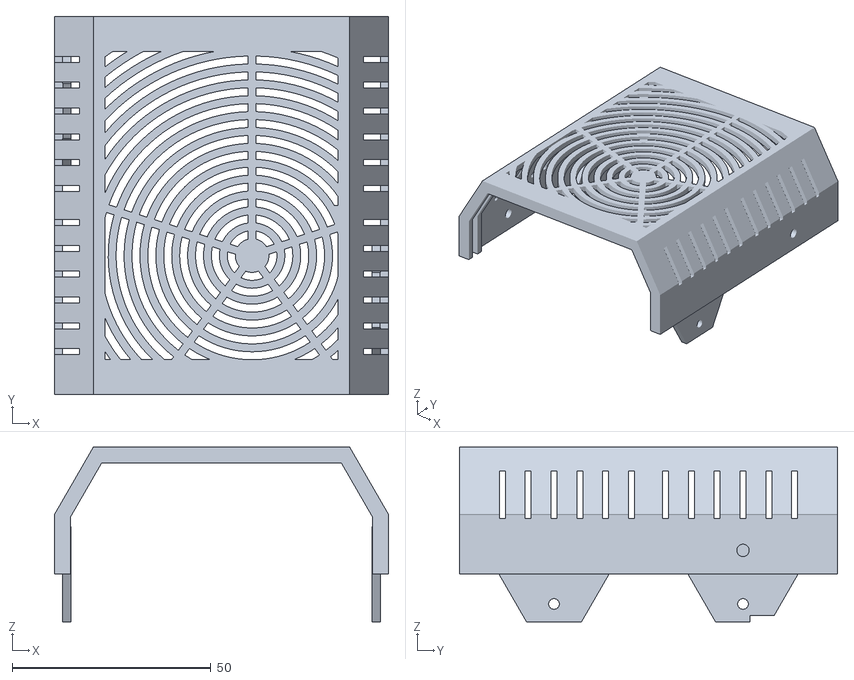
[picture p84: CAD file, 2026-05-21]
Gateway-enclosure/Thingiverse-3012012/files/TTNRak831CaseTop.stl
84.2 x 95.2 x 44.0
