CongducPham/PEPR_AgriFutur/Gateway-enclosure/Thingiverse-3012012/files/TTNRak831CaseBottom.stl

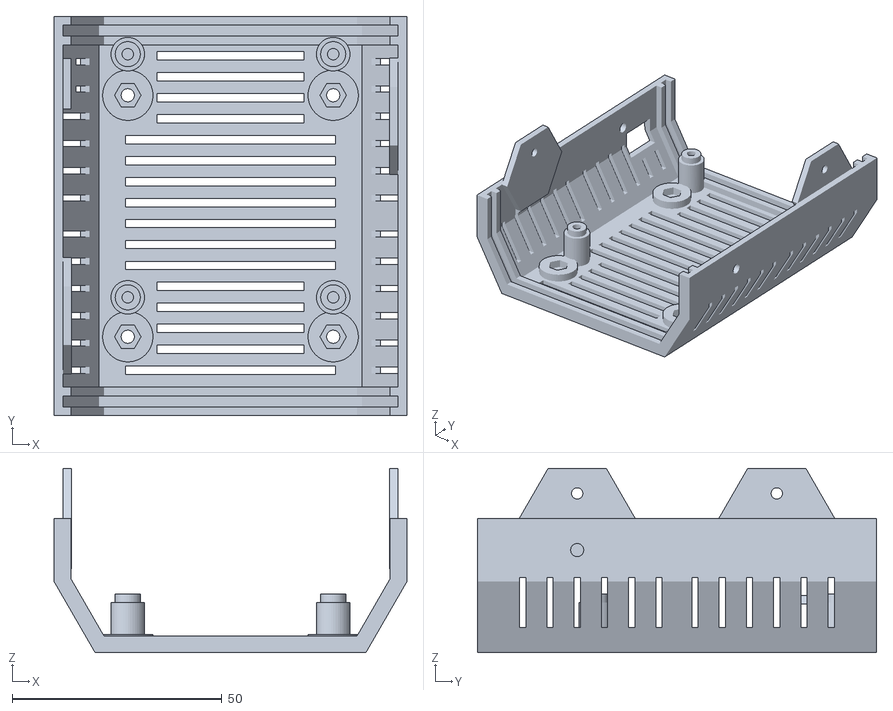
[picture p85: CAD file, 2026-05-21]
Gateway-enclosure/Thingiverse-3012012/files/TTNRak831CaseBottom.stl
84.2 x 95.2 x 44.0
