CongducPham/PEPR_AgriFutur/Gateway-enclosure/Thingiverse-3012012/files/TTNRak831PanelBack.stl

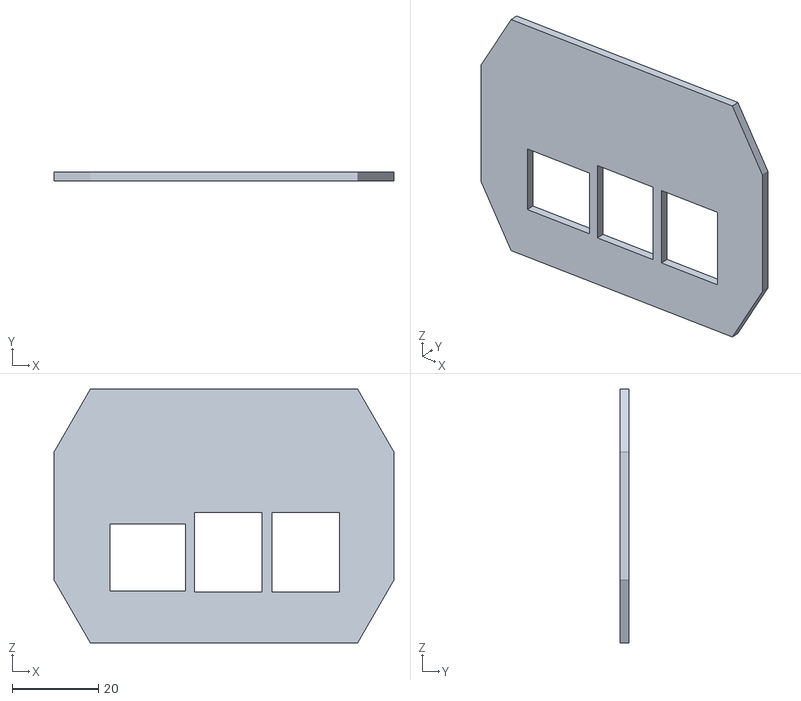
[picture p86: CAD file, 2026-05-21]
Gateway-enclosure/Thingiverse-3012012/files/TTNRak831PanelBack.stl
79.0 x 2.00 x 59.0
