CongducPham/PEPR_AgriFutur/Gateway-enclosure/Thingiverse-3012012/files/TTNRak831Case.step

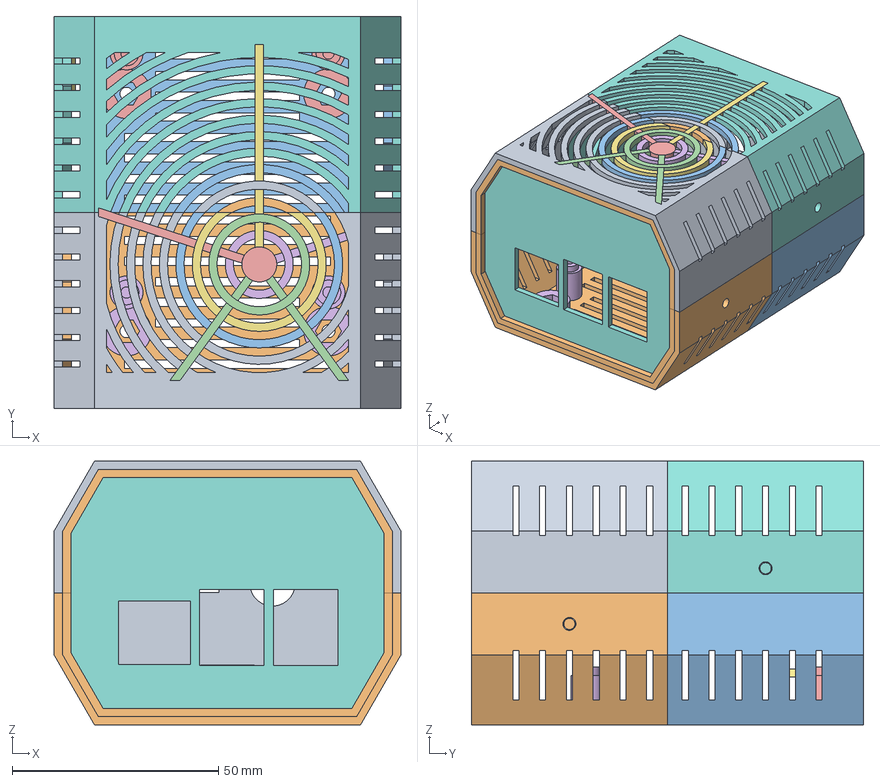
[picture p87: CAD file, 2026-05-21]
Gateway-enclosure/Thingiverse-3012012/files/TTNRak831Case.step
84.2 x 95.2 x 64.0 mm
QuarterCaseTopFront
QuarterCaseTopBack
PanelFront
PanelBack
QuarterCaseBottomFront
QuarterCaseBottomBack
BottomParts
PowerSupply
