CongducPham/PEPR_AgriFutur/Tutorials/Customized-edge-gateway.pdf

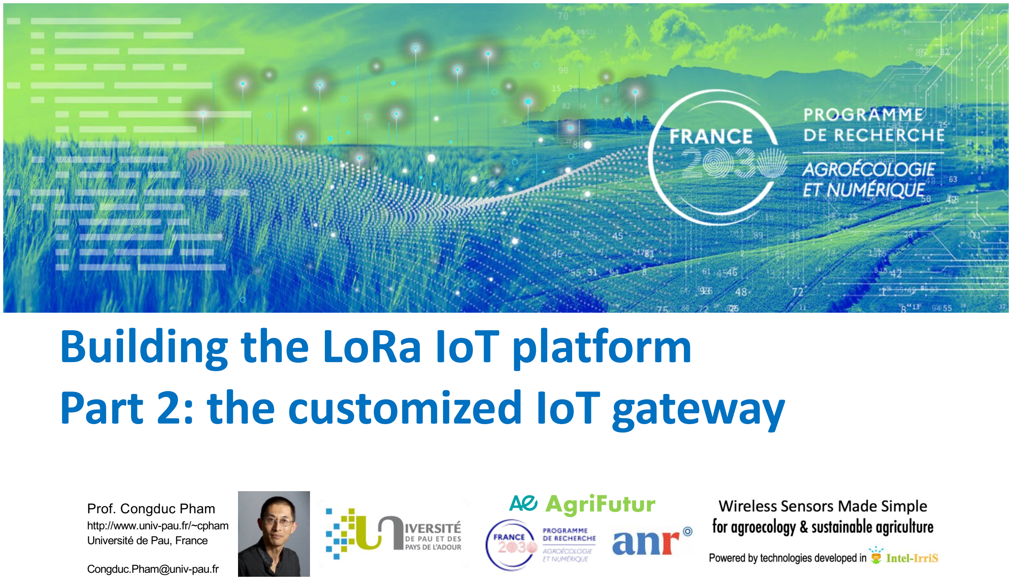
[picture p88: page 1]

Prof. Congduc Pham
http://www.univ-pau.fr/~cpham Université de Pau, France

Congduc.Pham@univ-pau.fr

AgriFutur

# Building the LoRa IoT platform Part 2: the customized IoT gateway

Prof. Congduc Pham

http://www.univ-pau.fr/~cpham

2

## The customized IoT gateway

⊙ The customized IoT gateway is based on the generic WaziGate ⊙ WaziGate is an IoT LoRa Gateway developed by WAZIUP
⊙ WaziGate implements the edge-enabled IoT gateway approach ⊙ customized applications can be directly hosted in the gateway
⊙ the gateway can easily work without Internet connectivity
⊙ data are available to end-users in an embedded database
⊙ web-based visualization module provides graphical user interface ⊙ You can find all the WaziGate documentation on the WaziGate documentation page. (https://www.waziup.io/documentation/wazigate/)
⊙ The customized IoT gateway adds many more features
⊙ Simple configuration for all supported sensor types
⊙ Sensor dashboard based on Home Assistant
⊙ Automatic backup and simple restore procedure for sensor data ⊙ Display on OLED screen, …

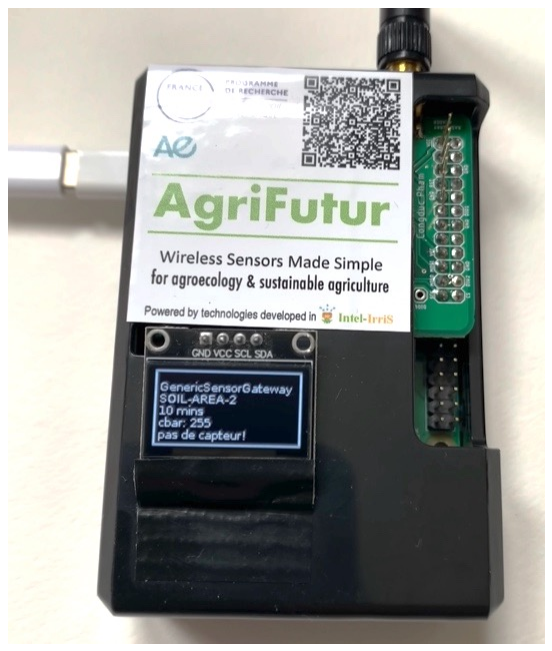
[picture p89: figure]

Prof. Congduc Pham

http://www.univ-pau.fr/~cpham

3

## Install software for your gateway

⊙ PEPR AgriFutur gateway distribution (RPI3B/3B+/4B)
⊙ comes pre-configured
⊙ will work out-of-the box with the default sensor devices
⊙ Including the LoRaCAM-AI device
⊙ Download the gateway SD card image from project GitHub
⊙ https://github.com/CongducPham/PEPR_AgriFutur/tree/main/Gateway ⊙ Image uses EU868 frequency band
⊙ EU433 or other bands can be configured afterwards
⊙ Flash the SD card image on a class 10 SD card

Look at the video produced for INTEL-IRRIS for the main steps Video at t=124s: https://youtu.be/j-1Nk0tv0xM?t=124

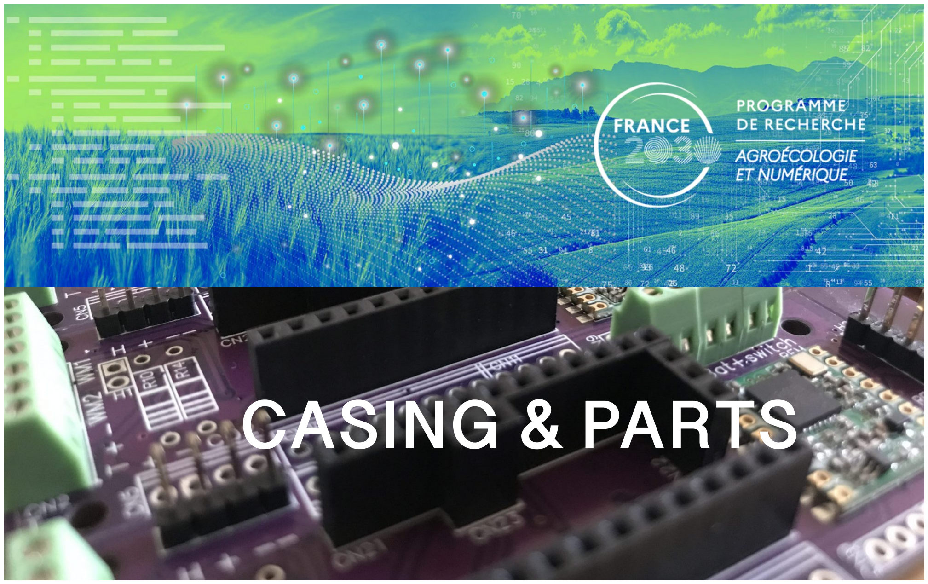
[picture p90: page 4]

# CASING & PARTS

## Raspberry PI enclosure

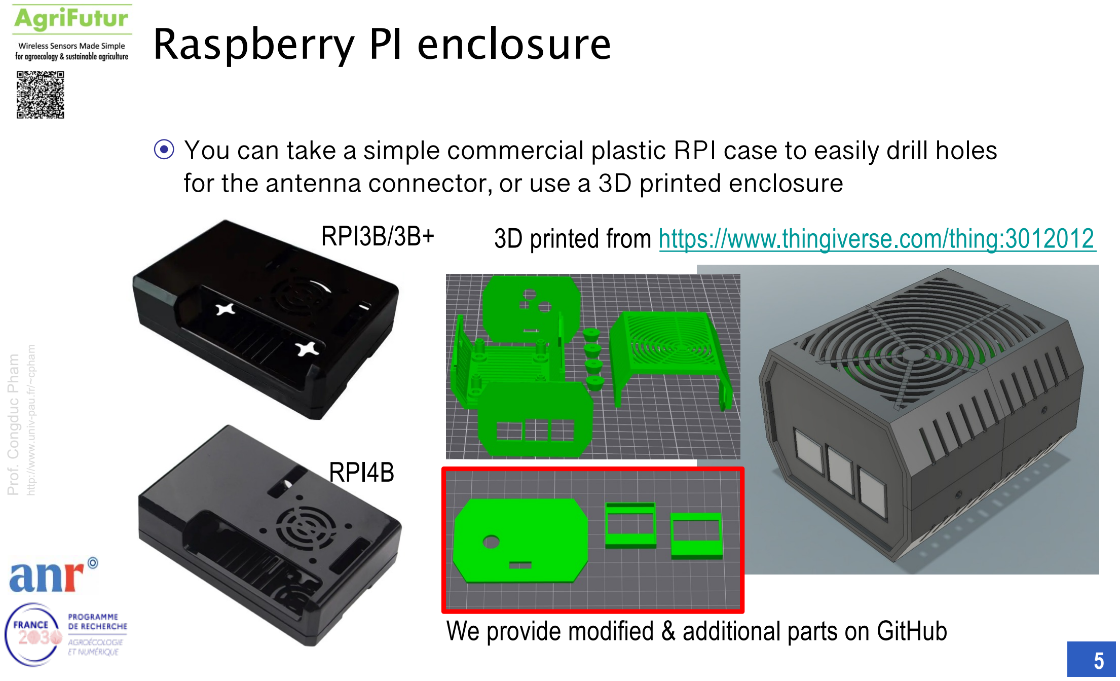
[picture p91: page 5]

Prof. Congduc Pham

http://www.univ-pau.fr/~cpham

5

⊙ You can take a simple commercial plastic RPI case to easily drill holes for the antenna connector, or use a 3D printed enclosure
RPI3B/3B+

RPI4B

3D printed from https://www.thingiverse.com/thing:3012012

We provide modified & additional parts on GitHub

Prof. Congduc Pham

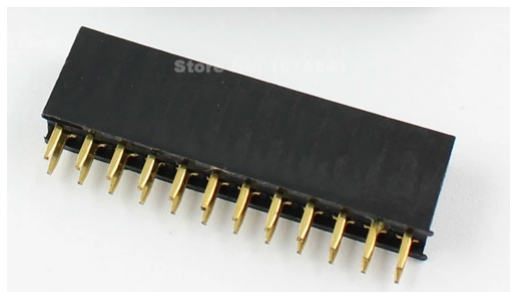
[picture p92: figure]

http://www.univ-pau.fr/~cpham

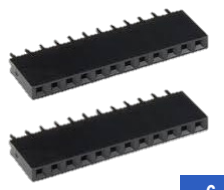
[picture p93: figure]

6

## Single-channel: the LoRa radio hat

2-row 12-pin header
or

### 2 X 1-row 12-pin header

Information on how to manufacture and order a PCB: https://github.com/CongducPham/PRIMA-Intel-IrriS/blob/main/Tutorials/Intel-Irris-PCB-update-PCBA.pdf

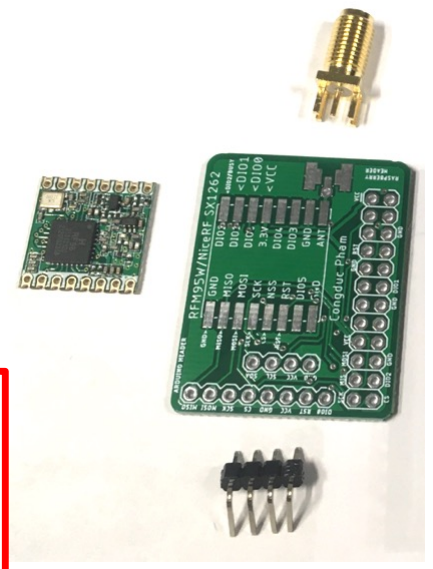
[picture p94: figure]
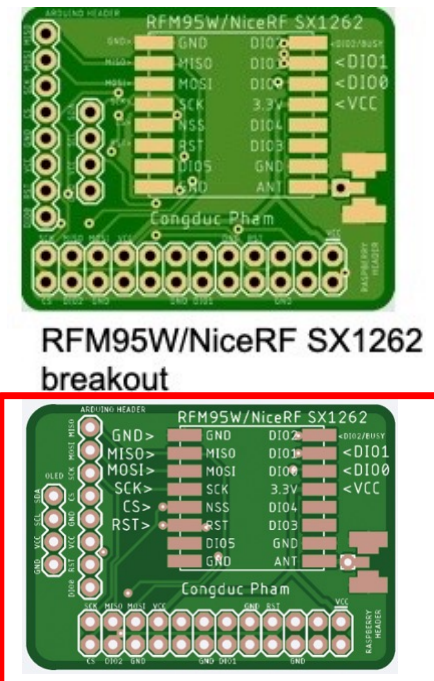
[picture p95: figure]

Get the zipped Gerber file from:

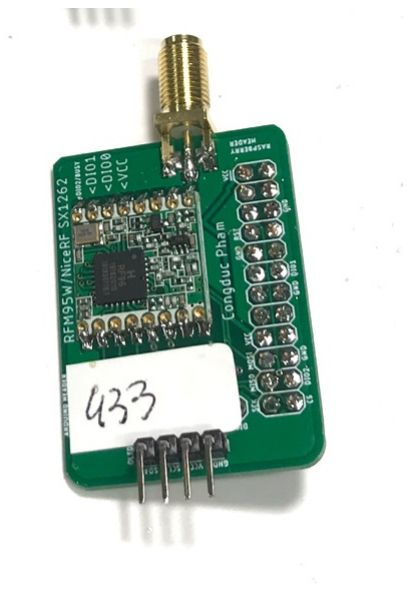
[picture p96: figure]

https://github.com/CongducPham/PEPR_AgriFutur/blob/main/PCBs/RFM95Breakout_2020-11-13-long.zip (https://github.com/CongducPham/PEPR_AgriFutur/blob/main/PCBs/RFM95Breakout_2020-11-13-long.zip)

## Installing OLED

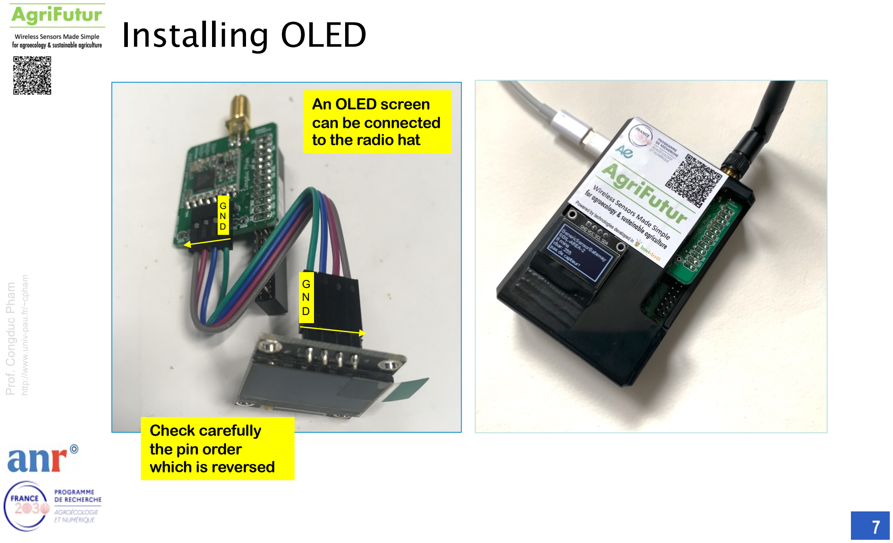
[picture p97: page 7]

Prof. Congduc Pham

http://www.univ-pau.fr/~cpham

7

An OLED screen
can be connected
to the radio hat

GND

GND

Check carefully
the pin order
which is reversed

## Connecting an RTC module

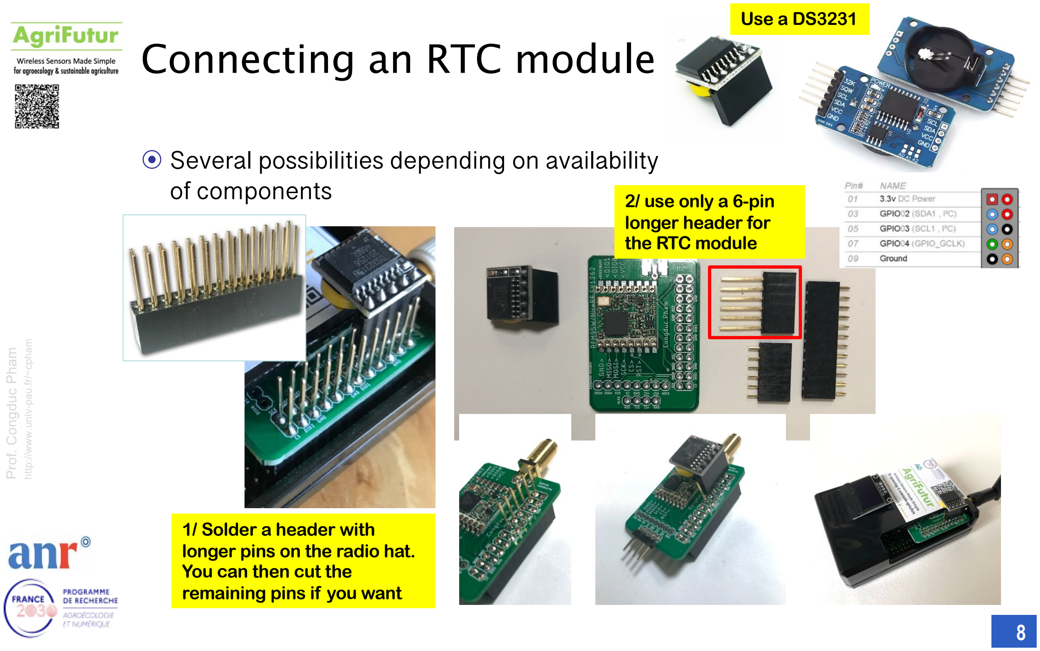
[picture p98: page 8]

Prof. Congduc Pham

http://www.univ-pau.fr/~cpham

8

⊙ Several possibilities depending on availability of components

1/ Solder a header with
longer pins on the radio hat. You can then cut the
remaining pins if you want

2/ use only a 6-pin
longer header for
the RTC module

Use a DS3231

## Preparing the enclosure

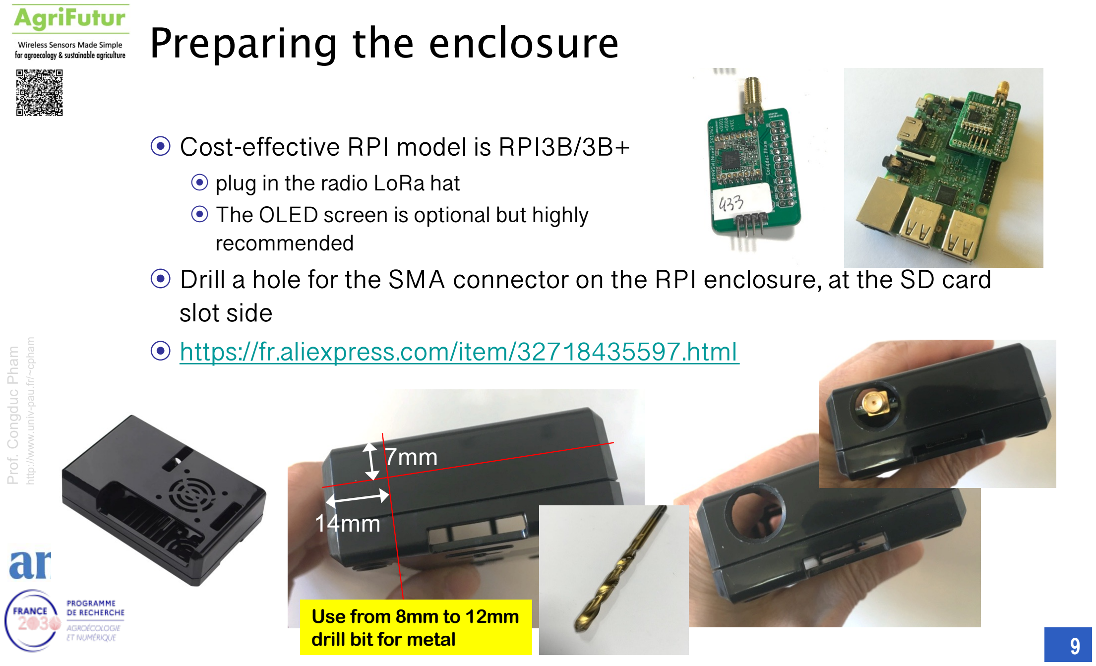
[picture p99: page 9]

Prof. Congduc Pham

http://www.univ-pau.fr/~cpham

9

⊙ Cost-effective RPI model is RPI3B/3B+
⊙ plug in the radio LoRa hat
⊙ The OLED screen is optional but highly
recommended
⊙ Drill a hole for the SMA connector on the RPI enclosure, at the SD card slot side
⊙ https://fr.aliexpress.com/item/32718435597.html

14mm

7mm

Use from 8mm to 12mm
drill bit for metal

## Using WAZIUP LoRa gateway hat

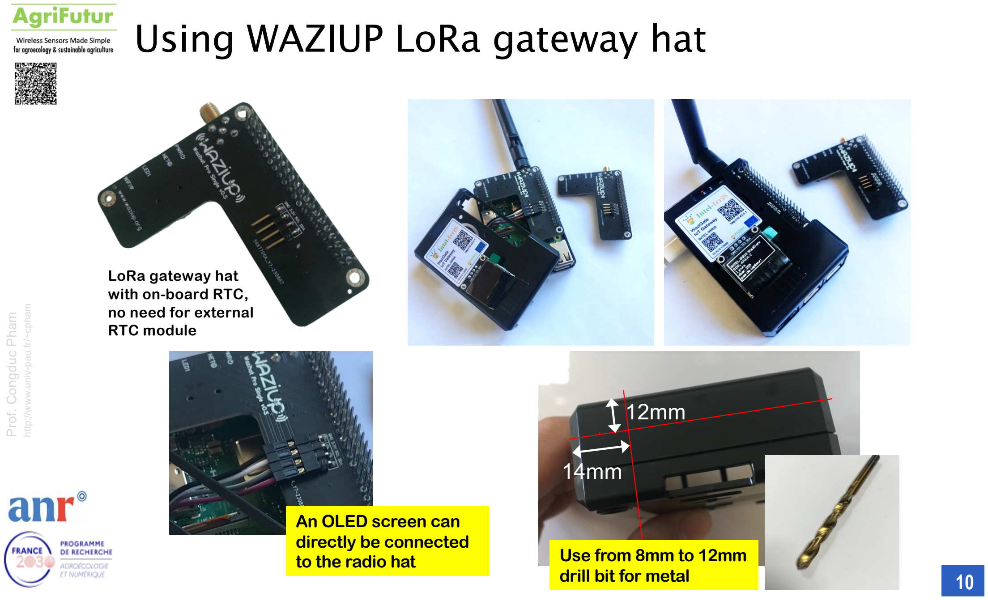
[picture p100: page 10]

Prof. Congduc Pham

http://www.univ-pau.fr/~cpham

10

LoRa gateway hat
with on-board RTC,
no need for external
RTC module

An OLED screen can
directly be connected
to the radio hat

14mm

12mm

Use from 8mm to 12mm
drill bit for metal

## Using the Thingiverse case

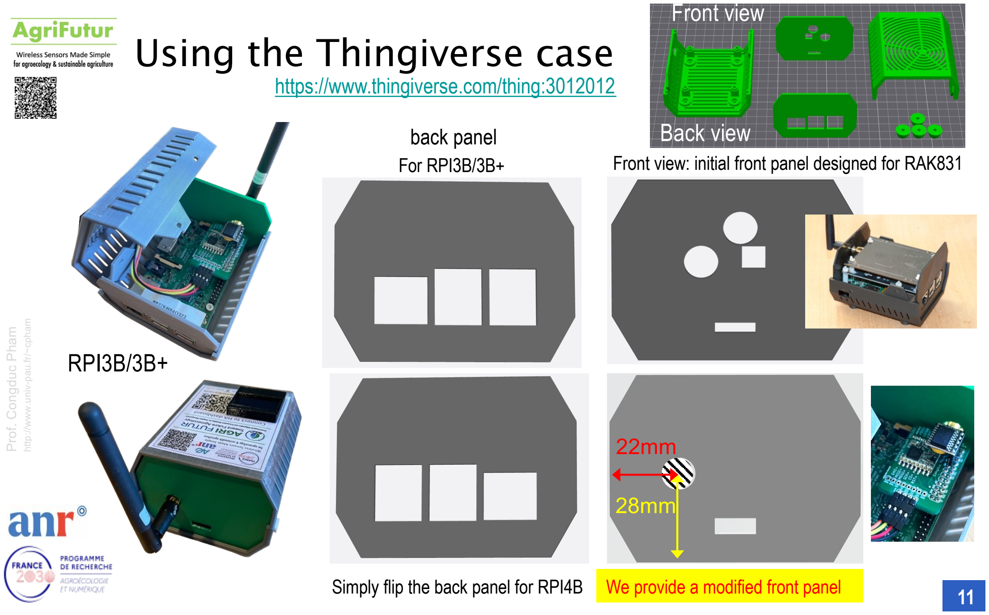
[picture p101: page 11]

Prof. Congduc Pham

http://www.univ-pau.fr/~cpham

11

RPI3B/3B+

For RPI3B/3B+

Simply flip the back panel for RPI4B

Front view: initial front panel designed for RAK831

back panel | Back view

Front view

We provide a modified front panel https://www.thingiverse.com/thing:3012012

28mm

22mm

## OLED cover with the Thingiverse case

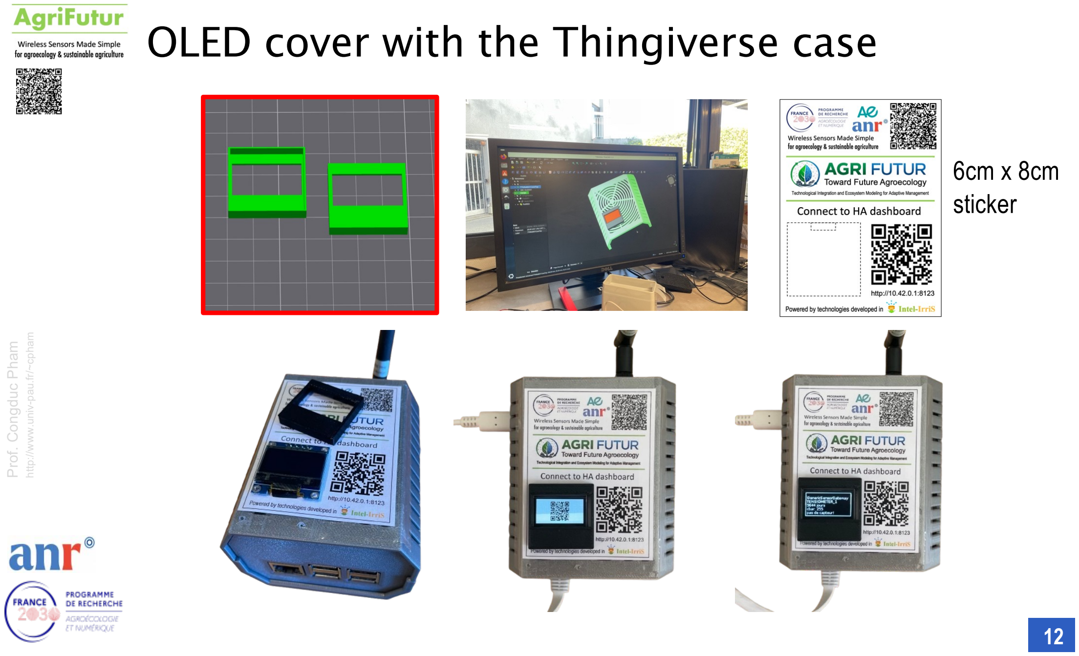
[picture p102: page 12]

Prof. Congduc Pham

http://www.univ-pau.fr/~cpham

12

6cm x 8cm
sticker

Prof. Congduc Pham

http://www.univ-pau.fr/~cpham

13

## Multi-channel/Multi-SF

⊙ It is possible to have a muti-channel/multi-SF gateway by connecting a LoRa radio concentrator such as the RAK2245 or the new RAK5146 with the RAK5146 Pi Hat (right photo)
⊙ The LoRa radio concentrator will be automatically detected
⊙ IMPORTANT: a reliable 5V 2.5A power source is necessary

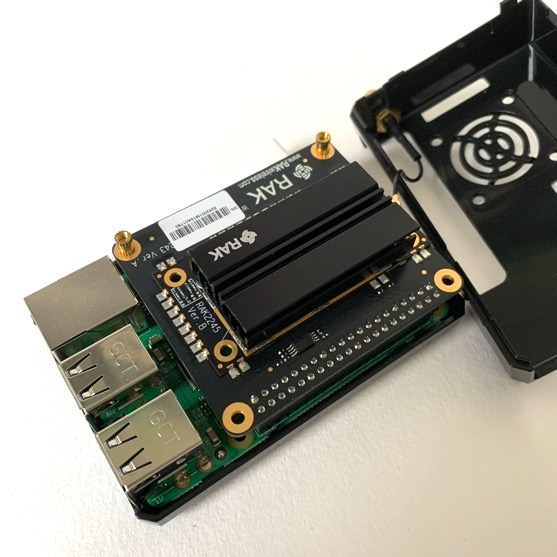
[picture p103: figure]
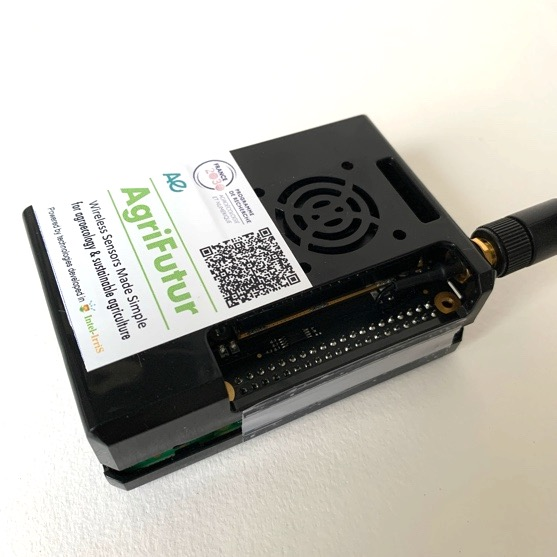
[picture p104: figure]
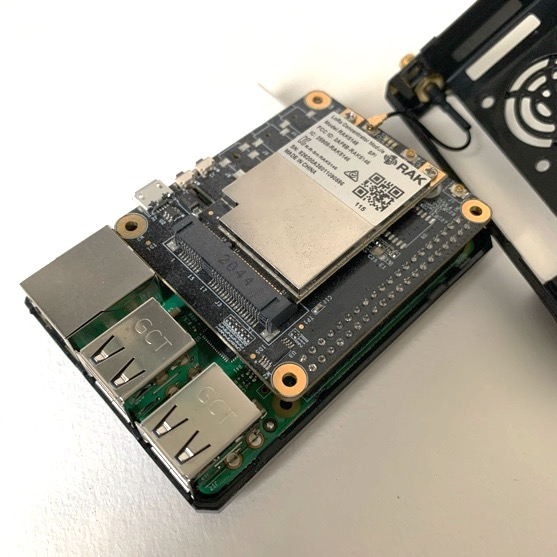
[picture p105: figure]

RAK2245 | RAK5146

## Thingiverse enclosure with multi-channel

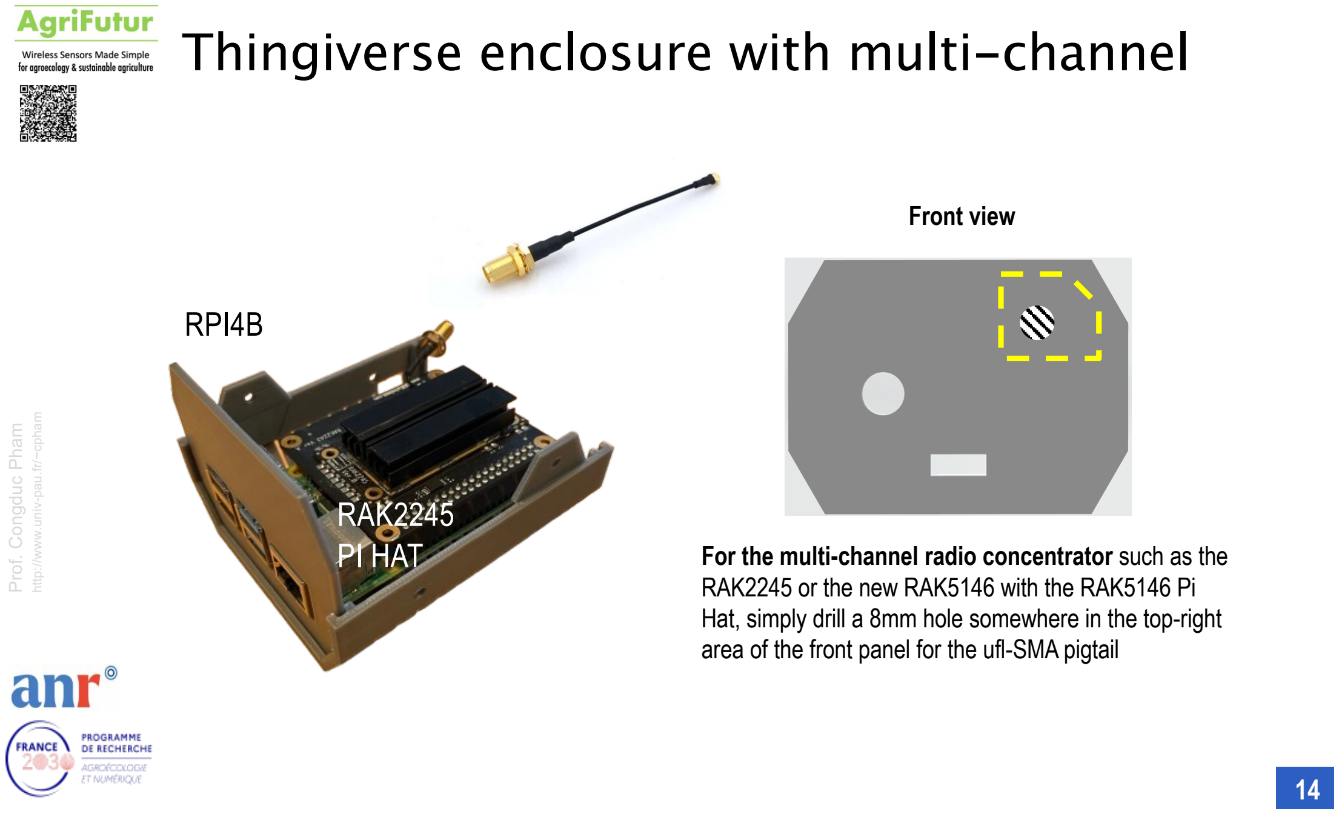
[picture p106: page 14]

Prof. Congduc Pham

http://www.univ-pau.fr/~cpham

14

Front view

For the multi-channel radio concentrator such as the RAK2245 or the new RAK5146 with the RAK5146 Pi Hat, simply drill a 8mm hole somewhere in the top-right area of the front panel for the ufl-SMA pigtail

RAK2245
PI HAT

RPI4B

## Boot with mSATA SSD

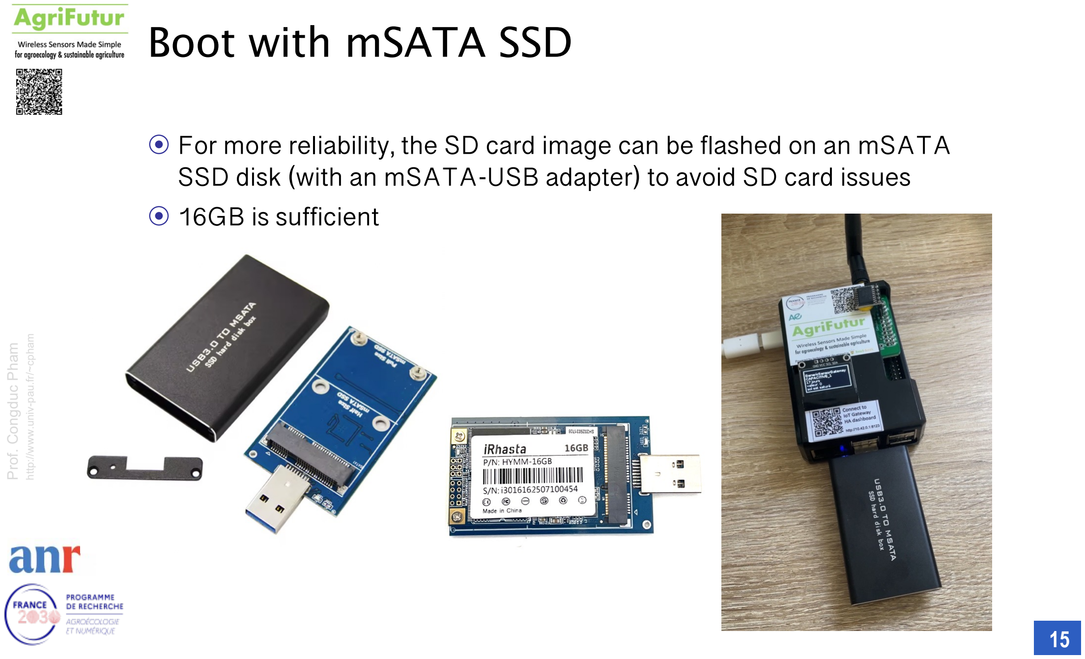
[picture p107: page 15]

Prof. Congduc Pham

http://www.univ-pau.fr/~cpham

15

⊙ For more reliability, the SD card image can be flashed on an mSATA SSD disk (with an mSATA-USB adapter) to avoid SD card issues
⊙ 16GB is sufficient

## Compute Module 4 with eMMC

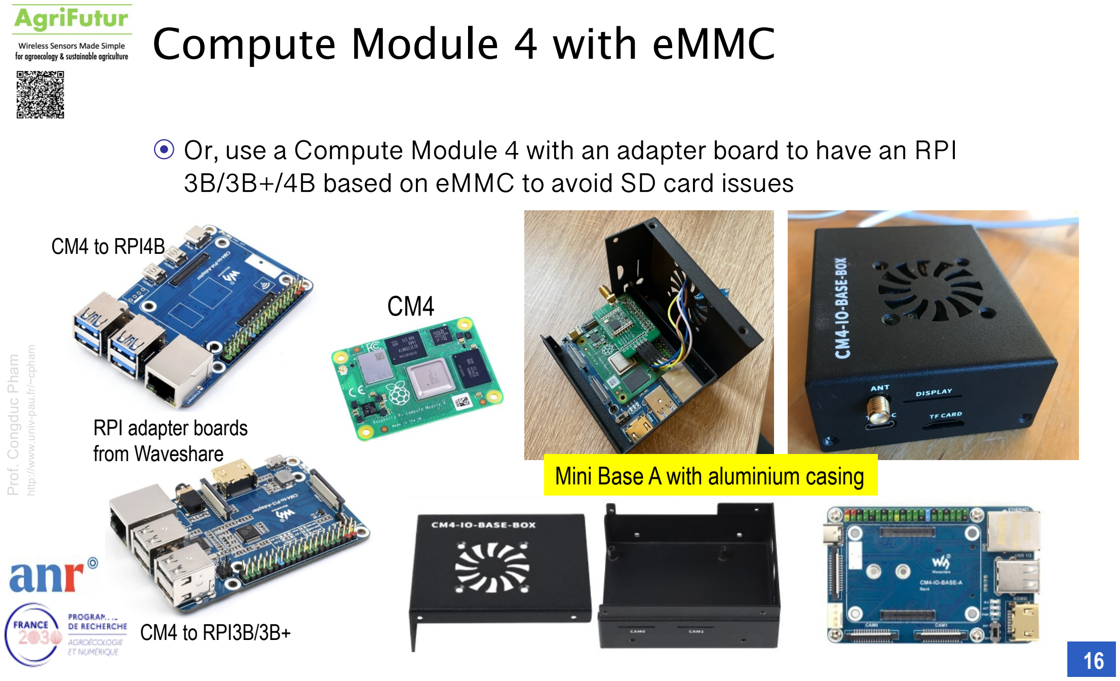
[picture p108: page 16]

Prof. Congduc Pham

http://www.univ-pau.fr/~cpham

16

⊙ Or, use a Compute Module 4 with an adapter board to have an RPI 3B/3B+/4B based on eMMC to avoid SD card issues

CM4 to RPI4B

CM4 to RPI3B/3B+

Mini Base A with aluminium casing

RPI adapter boards
from Waveshare

CM4

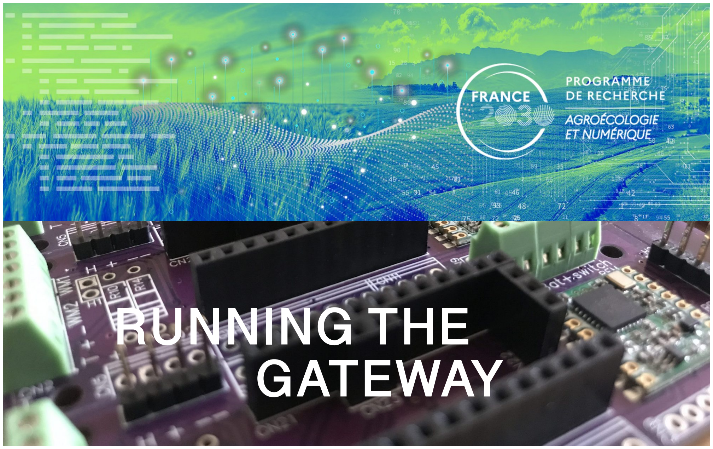
[picture p109: page 17]

# RUNNING THE GATEWAY

Prof. Congduc Pham

http://www.univ-pau.fr/~cpham

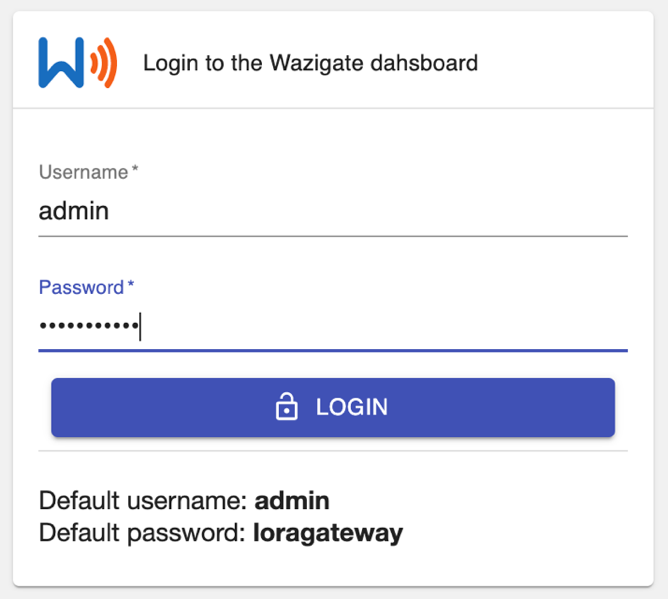
[picture p110: figure]

18

## Checking the gateway (Ethernet cable)

⊙ Connect the gateway to your laptop which has Internet
⊙ Enable Internet sharing, laptop provides IP address to gateway ⊙ Power the gateway, wait 3-4mins for boot process
⊙ Open web navigator. Go to http://wazigate.local or use IP address

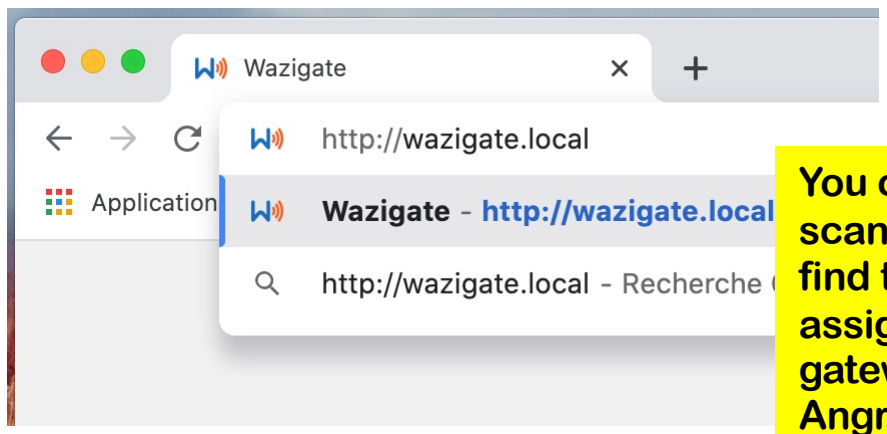
[picture p111: figure]

⊙ Use default login to connect
⊙ User: admin
⊙ Password: loragateway

You can use an IP
scanner program to
find the IP address
assigned to your
gateway (such as
Angry IP Scanner)

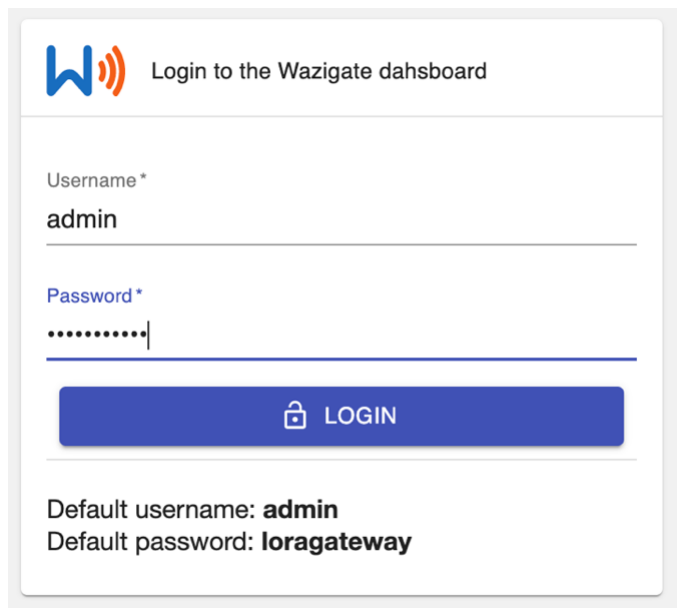
[picture p112: figure]

Prof. Congduc Pham

http://www.univ-pau.fr/~cpham

19

## Checking the gateway (WiFi)

⊙ Use a smartphone to check access to gateway through WiFi
⊙ Connect to WAZIGATE_XXXXXXXXXXXX WiFi network
⊙ default WiFi password is loragateway
⊙ Open web navigator. Go to http://wazigate.local or http://10.42.0.1

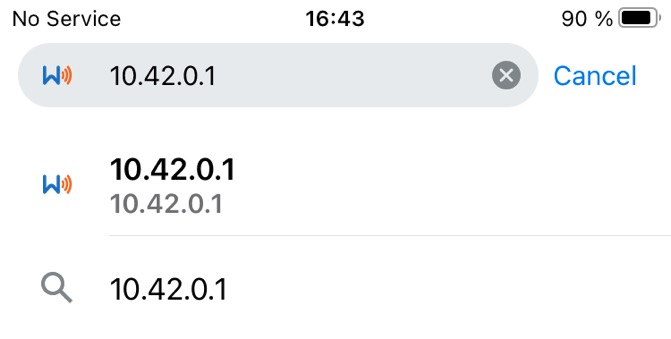
[picture p113: figure]

⊙ Use default login to connect
⊙ User: admin
⊙ Password: loragateway

## Default gateway configuration ⊙ The default configuration will

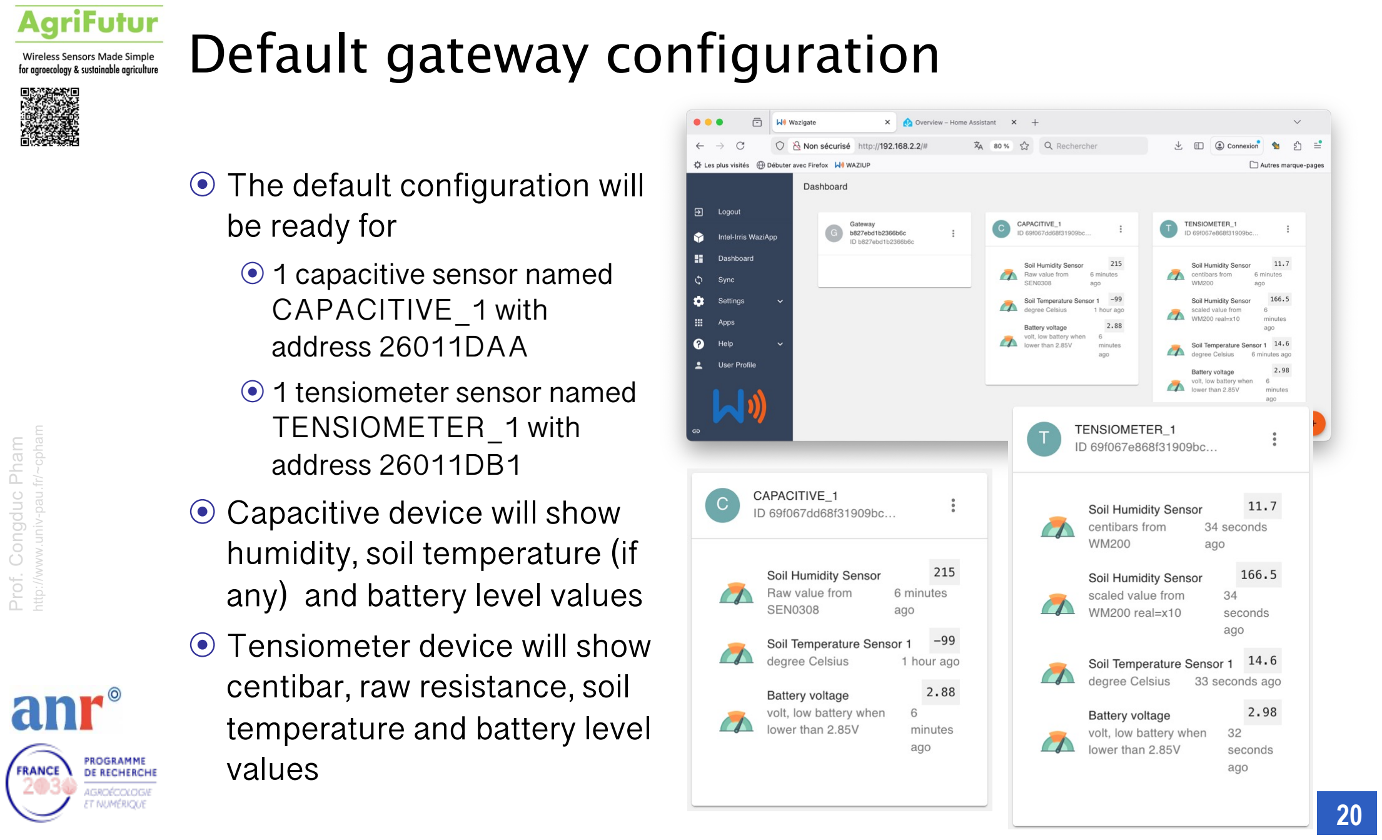
[picture p114: page 20]

Prof. Congduc Pham

http://www.univ-pau.fr/~cpham

20

be ready for ⊙ 1 capacitive sensor named

CAPACITIVE_1 with
address 26011DAA
⊙ 1 tensiometer sensor named TENSIOMETER_1 with
address 26011DB1
⊙ Capacitive device will show humidity, soil temperature (if any) and battery level values ⊙ Tensiometer device will show centibar, raw resistance, soil temperature and battery level values

## From a smartphone

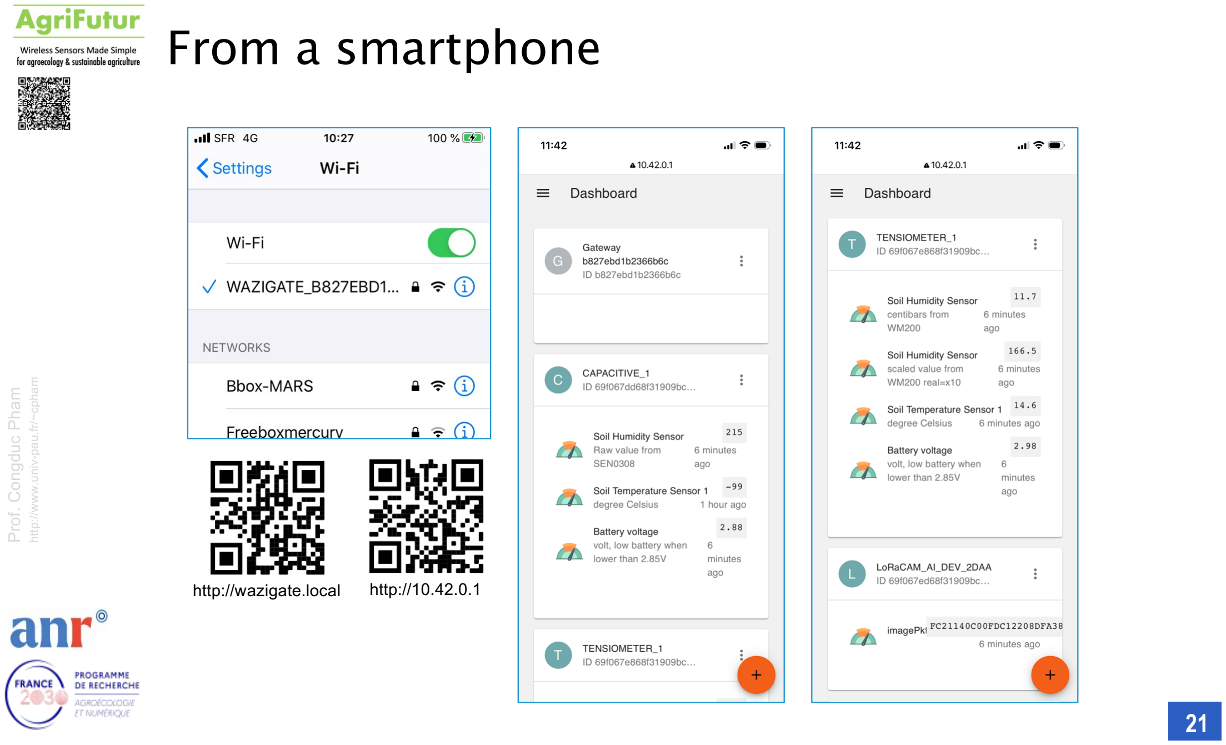
[picture p115: page 21]

Prof. Congduc Pham

http://www.univ-pau.fr/~cpham

21

http://wazigate.local http://10.42.0.1

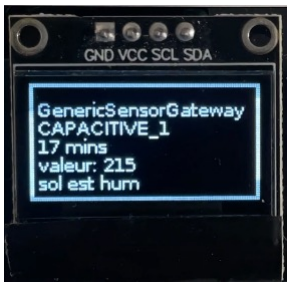
[picture p116: figure]
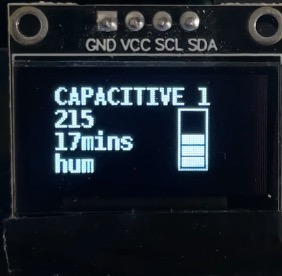
[picture p117: figure]
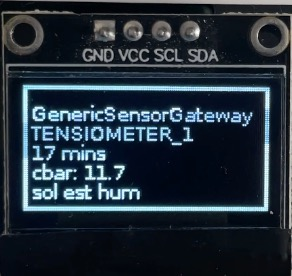
[picture p118: figure]

Prof. Congduc Pham

http://www.univ-pau.fr/~cpham

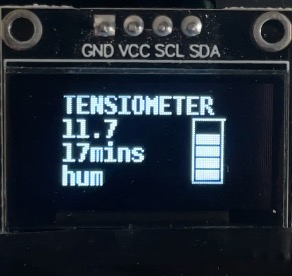
[picture p119: figure]

22

Sensor information on OLED ⊙ The OLED displays the latest

received sensor data for the end

user: the device name, the time of last received data, the sensor raw value and the soil condition
⊙ The main screen is displayed for 6s every 30s. Then a screen saver display will show a shorter version of these information with a 5

-bar
visual
⊙ 5 bars: saturated | 4 bars: wet ⊙ 3 bars: wet | | 2 bars: dry ⊙ 1 bar: dry | | 0 bar: very dry

Prof. Congduc Pham

http://www.univ-pau.fr/~cpham

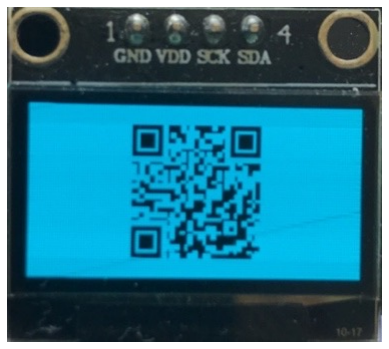
[picture p120: figure]
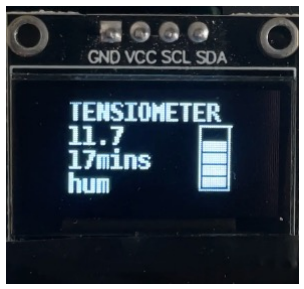
[picture p121: figure]

23

## QR code for connecting to WiFi

⊙ The gateway WiFi is WAZIGATE_XXXXXXXXXXXX where XXXXXXXXXXXX will be the MAC address of the RPI
⊙ For instance, WAZIGATE_B827EBD1B236
⊙ A QR code for joining the WiFi network is displayed for 10s before the main screen to join with a smartphone
⊙ Then, users can scan static QR code to connect to the
gateway's dashboard
⊙ OLED cycling pattern | http://wazigate.local http://10.42.0.1

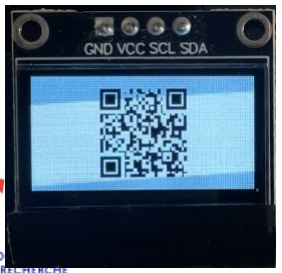
[picture p122: figure]
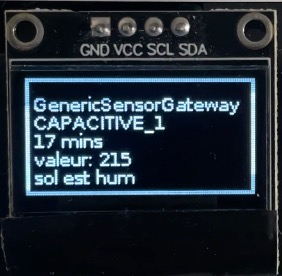
[picture p123: figure]

## Home Assistant dashboard

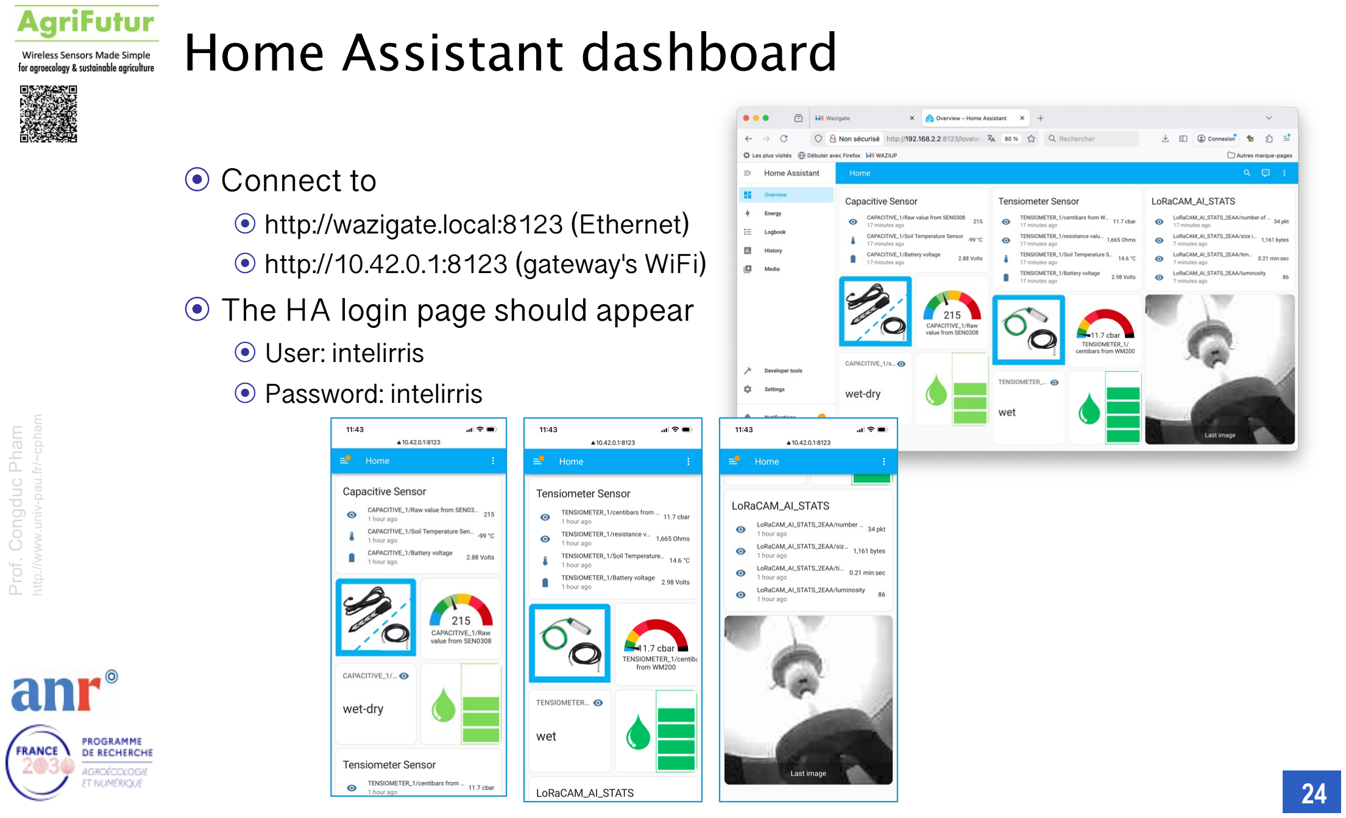
[picture p124: page 24]

Prof. Congduc Pham

http://www.univ-pau.fr/~cpham

24

⊙ Connect to
⊙ http://wazigate.local:8123 (Ethernet) ⊙ http://10.42.0.1:8123 (gateway's WiFi)
⊙ The HA login page should appear
⊙ User: intelirris
⊙ Password: intelirris

Prof. Congduc Pham

http://www.univ-pau.fr/~cpham

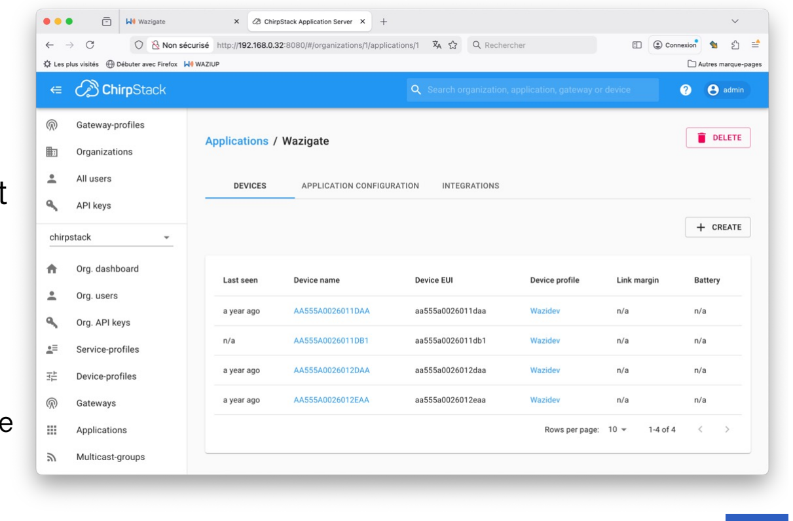
[picture p125: figure]

25

## Connect to ChirpStack Network Server

⊙ The generic WaziGate comes with ChirpStack Network Server
⊙ Open web navigator. Go to http://wazigate.local:8080 or use IP address

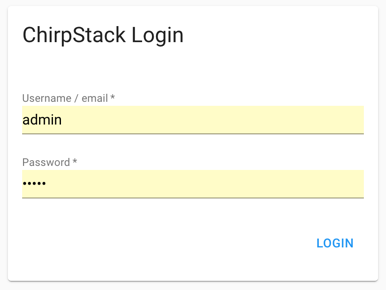
[picture p126: figure]

⊙ Use default login to connect
⊙ User: admin
⊙ Password: admin
⊙ Then get access to
⊙ registered devices
⊙ live LoRaWAN packet capture ⊙ downlink, …

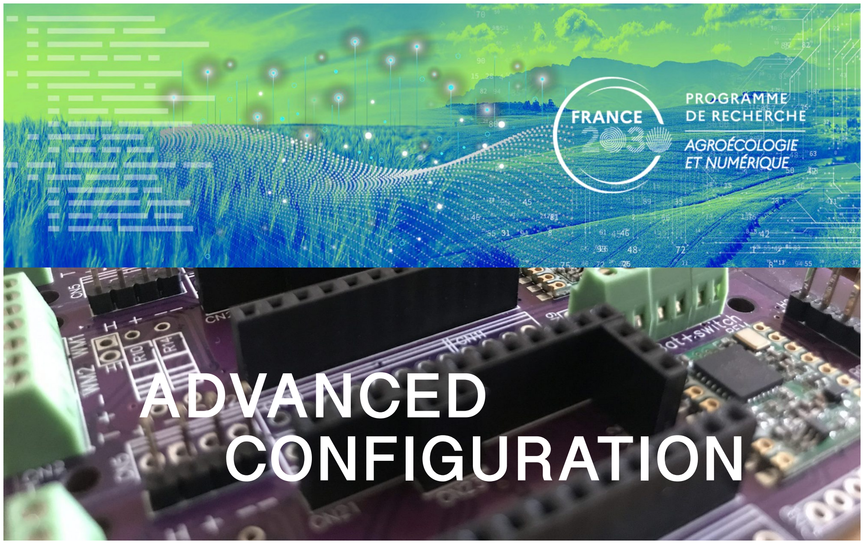
[picture p127: page 26]

# ADVANCED CONFIGURATION

Prof. Congduc Pham

http://www.univ-pau.fr/~cpham

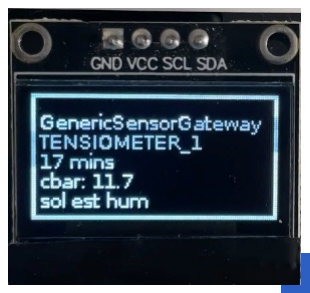
[picture p128: figure]

27

## Synching RTC module

Option 1: with Internet, enabling RTC to sync on boot

⊙ Use your laptop that should itself be connected to the Internet (using your smartphone's WiFi sharing feature for instance)
⊙ Make sure that your laptop will share its Internet connection to devices connected on its Ethernet port. See how to do so: https://www.waziup.io/documentation/wazigate/v2/install/#connect-with-ethernet-cable-to-pc (https://www.waziup.io/documentation/wazigate/v2/install/)
⊙ Before powering gateway, connect it to your laptop by Ethernet cable ⊙ As the gateway will normally run without Internet once deployed, its clock should be synched with the RTC that also needs to be synched ⊙ Then power the gateway. You should see the first [Internet OK] screen. Wait 3-4mins for the main gateway screen to appear
⊙ On boot (and only on boot), the RTC
module will then be automatically
synched with Internet's time & date

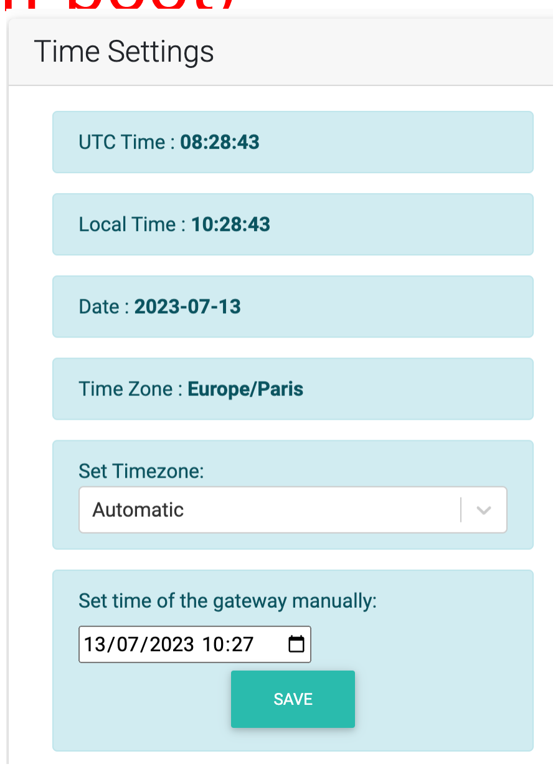
[picture p129: figure]

Prof. Congduc Pham

http://www.univ-pau.fr/~cpham

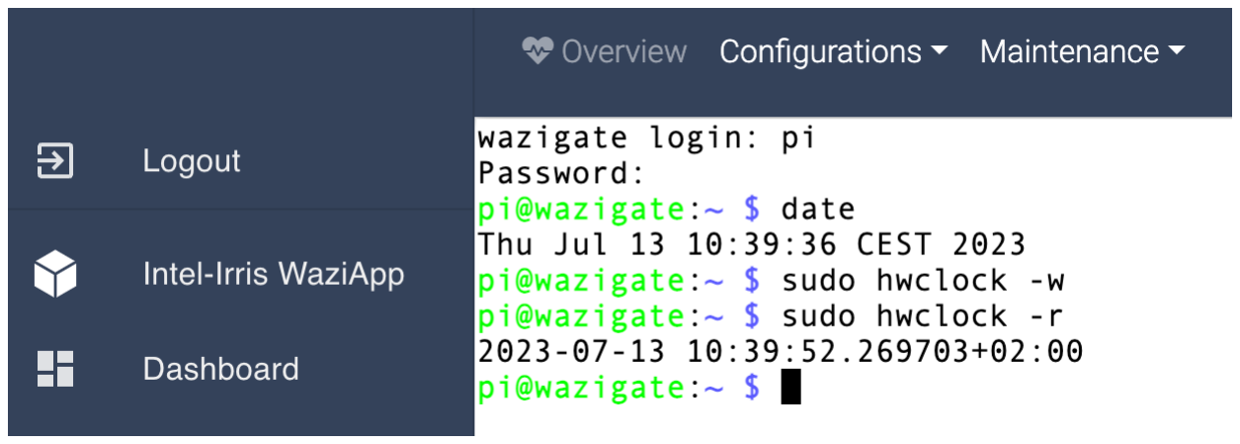
[picture p130: figure]

28

## Synching RTC module

Option 2: without Internet (RTC can not sync on boot)

⊙ It is possible to sync the RTC manually, after boot
⊙ First, power gateway then connect to gateway's WiFi
⊙ Go to Settings then Configuration in Configurations top menu. Set time & date manually. Click on SAVE ⊙ Then use the embedded SSH functionalities (in Settings/Maintenance) to log in the gateway (user pi/ pwd loragateway)
⊙ Then type "date" to check if the previously date & time has been saved
⊙ Then "sudo hwclock -w"
⊙ Check with "sudo hwclock -r"
⊙ It is possible to sync other RTC modules with this method by hot plugging another RTC module

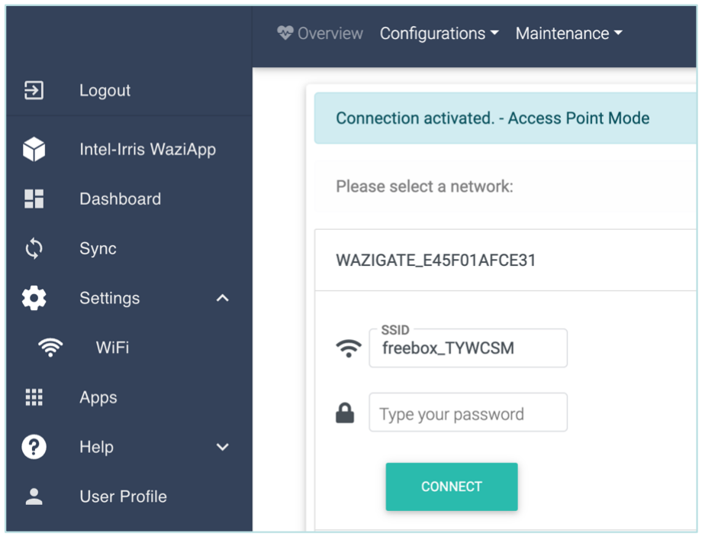
[picture p131: figure]

Prof. Congduc Pham

http://www.univ-pau.fr/~cpham

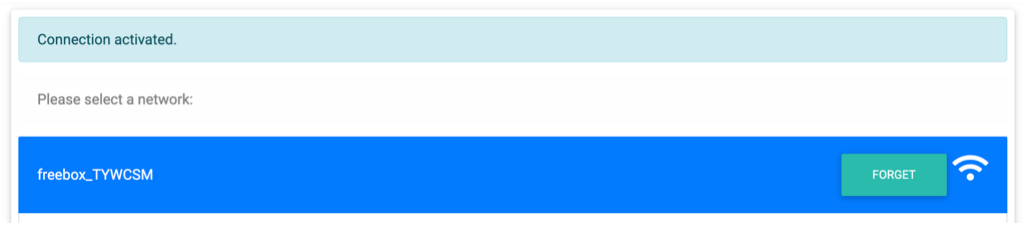
[picture p132: figure]

29

## WiFi client

connect gateway to a WiFi network ⊙ By default, the gateway acts as a

WiFi Access Point
⊙ To connect the gateway to a WiFi network, go to Setting/WiFi to list all available WiFi networks
⊙ Then select the one you want in order to provide the WiFi password ⊙ Ex: connect to freebox_TYWCSM ⊙ Once connected, gateway is in

WiFi Client mode

Prof. Congduc Pham

http://www.univ-pau.fr/~cpham

30

## WiFi client

connect gateway to a WiFi network, con't

⊙ You can connect to several WiFi networks, one after another, to have a list of known WiFi networks
⊙ They will be memorized and if the current WiFi network is not available, another available network in the list of known WiFi networks will be selected
⊙ If there are no available WiFi networks in the list of known WiFi networks anymore, then the gateway switches back to Access Point mode

Prof. Congduc Pham

http://www.univ-pau.fr/~cpham

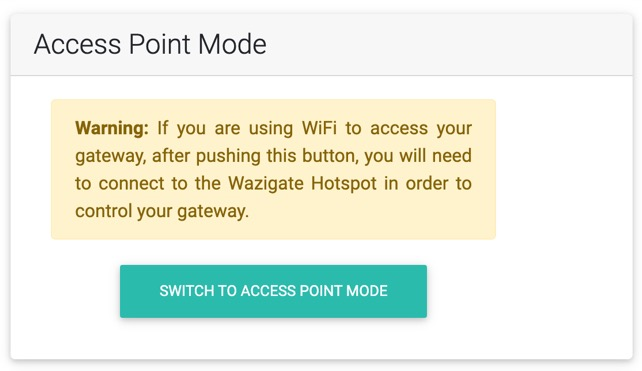
[picture p133: figure]

31

## WiFi AP

switch gateway back to WiFi access point mode

⊙ To get back to Access Point mode, got to Setting/WiFi and simply click on "Forget" for the current WiFi network

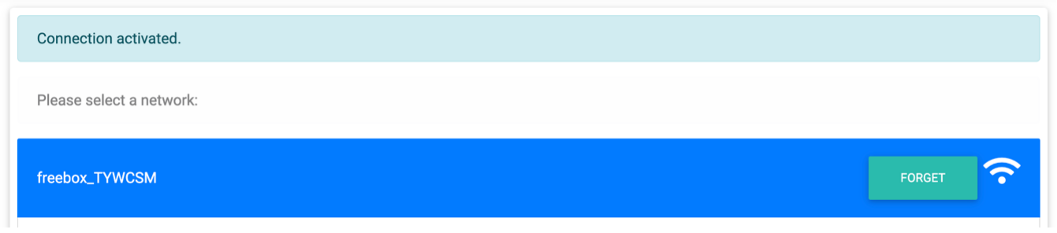
[picture p134: figure]

⊙ If you previously added several WiFi networks, click on "Forget" for ALL known & memorized WiFi networks
⊙ DO NOT USE the "SWITCH TO
ACCESS POINT MODE" option
⊙ IT IS NOT STABLE!

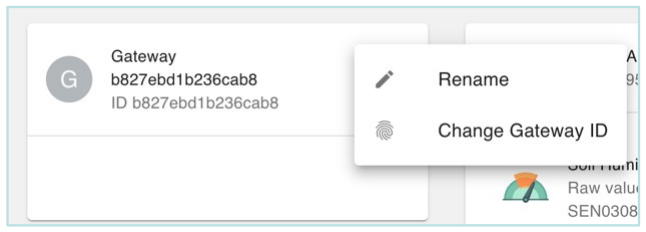
[picture p135: figure]

Prof. Congduc Pham

http://www.univ-pau.fr/~cpham

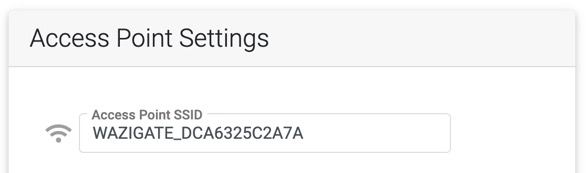
[picture p136: figure]
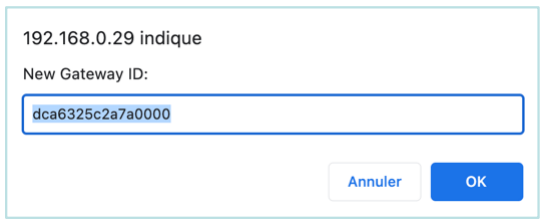
[picture p137: figure]

32

## WaziCloud

Synching your gateway to the cloud

⊙ If you want to sync your gateway to the WAZIUP Cloud (WaziCloud), look at this tutorial page
⊙ https://www.waziup.io/documentation/wazigate/v2/install/#registration-with-the-cloud (https://www.waziup.io/documentation/wazigate/v2/install/)
⊙ You will need an account on WaziCloud
⊙ If you don't have one, you need to create one first
⊙ https://dashboard.waziup.io/
⊙ Then, you NEED to change your gateway id
⊙ Use the unique MAC address of your gateway that appears in Settings/Configuration (it is used as your gateway's WiFi hotspot)
⊙ Here: DCA6325C2A7A
⊙ Add 0000 at the end to have 16 digits
⊙ -> DCA6325C2A7A0000

Prof. Congduc Pham

http://www.univ-pau.fr/~cpham

33

## WaziCloud

Synching your gateway to the cloud, con't

⊙ You should have a new gateway on your dashboard with the new ID

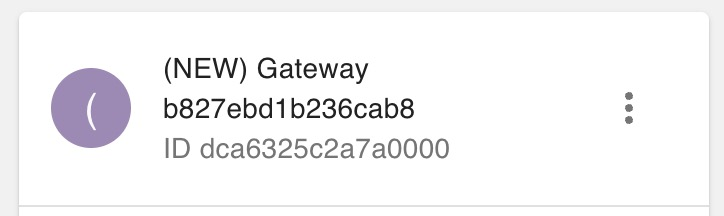
[picture p138: figure]

⊙ Enter your WaziCloud credentials in the Sync menu
⊙ Then, just activate sync on your gateway
which needs to be connected to Internet
⊙ Log in the WaziCloud dashboard

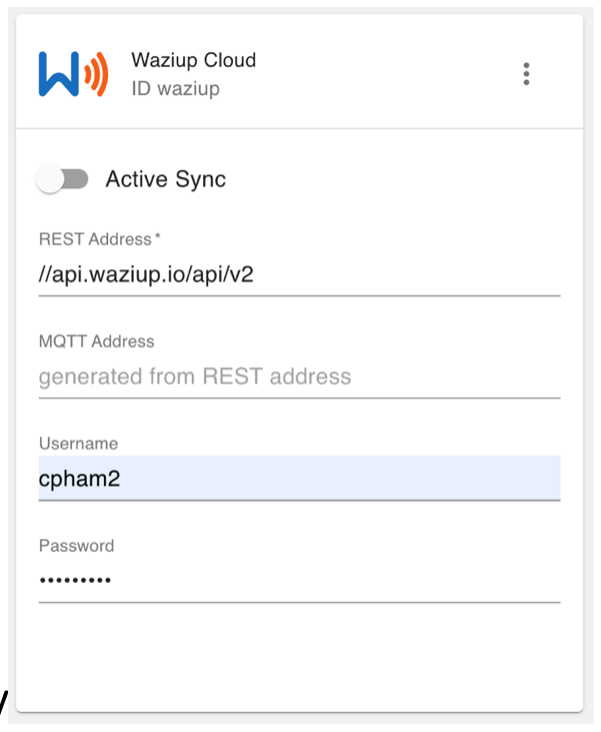
[picture p139: figure]

and check that you see your gateway and your device ⊙ You can activate/deactivate synchronization at anytime

Prof. Congduc Pham

http://www.univ-pau.fr/~cpham

34

## MQTT

MQTT integration from WaziCloud

⊙ With sensor data on WaziCloud, it is possible to subscribe to those data with MQTT protocol
⊙ With command line mosquitto_sub
⊙ moquitto_sub
-L "mqtt://api.waziup.io/devices/<deviceID>/sensors/<sensorID>/value" ⊙ mosquitto_sub
-h api.waziup.io -t devices/<deviceID>/sensors/<sensorID>/value
⊙ With other MQTT integration client/platform
⊙ Host: api.waziup.io
⊙ Topic: devices/<deviceID>/sensors/<sensorID>/value
⊙ Output
⊙ {"value":34,"timestamp":"2022-12-23T10:23:54Z"}

## MQTT

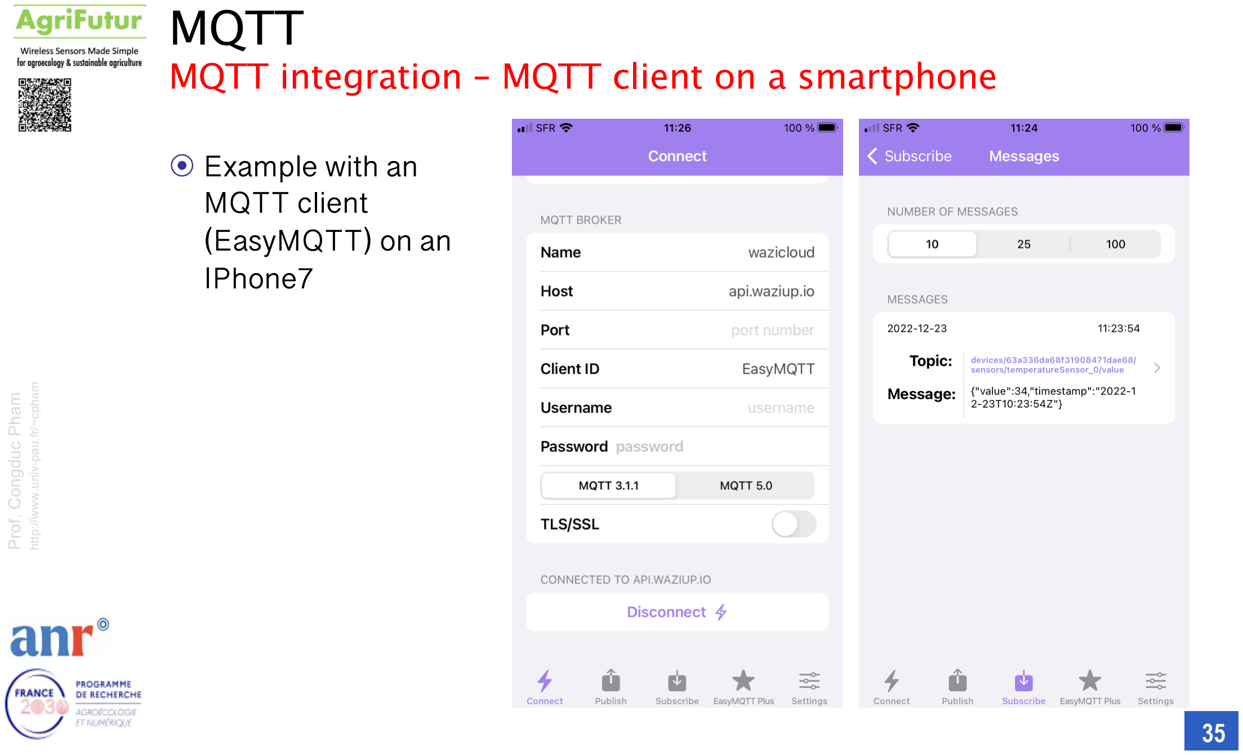
[picture p140: page 35]

Prof. Congduc Pham

http://www.univ-pau.fr/~cpham

35

MQTT integration – MQTT client on a smartphone

⊙ Example with an
MQTT client
(EasyMQTT) on an
IPhone7
