CongducPham/PEPR_AgriFutur/Tutorials/agrifutur-approach.pdf

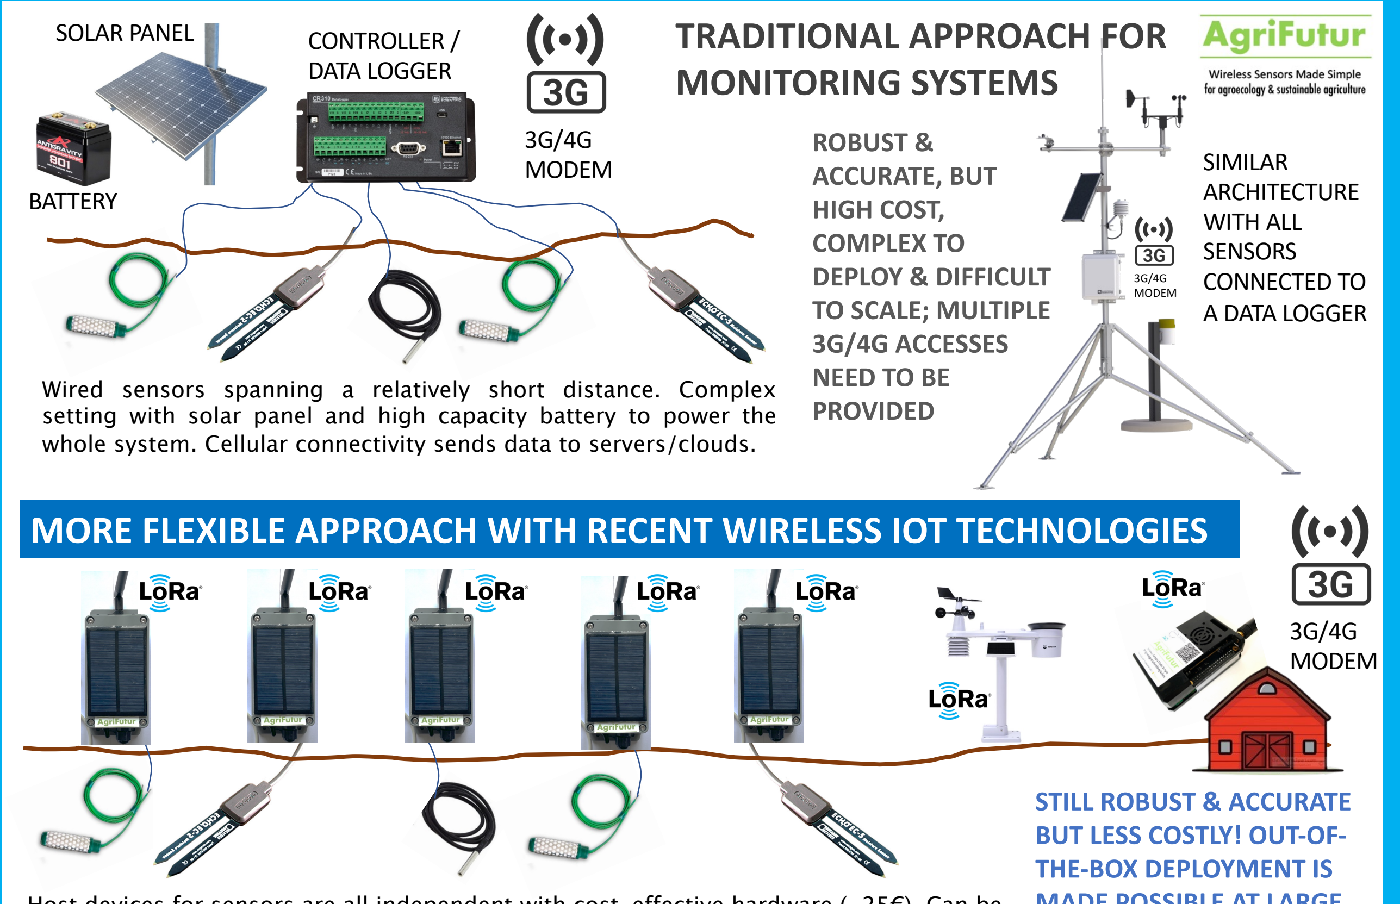
[picture p141: figure]
CONTROLLER / DATA LOGGER; SOLAR PANEL; 3G/4G MODEM; TRADITIONAL APPROACH FOR MONITORING SYSTEMS; SIMILAR ARCHITECTURE WITH ALL SENSORS CONNECTED TO A DATA LOGGER; ROBUST & ACCURATE, BUT HIGH COST, COMPLEX TO DEPLOY & DIFFICULT TO SCALE; MULTIPLE 3G/4G ACCESSES NEED TO BE PROVIDED; BATTERY; STILL ROBUST & ACCURATE BUT LESS COSTLY! OUT-OF- THE-BOX DEPLOYMENT IS

Wired sensors spanning a relatively short distance. Complex setting with solar panel and high capacity battery to power the whole system. Cellular connectivity sends data to servers/clouds.

Host devices for sensors are all independent with cost-effective hardware (~25€). Can be deployed on a large area and run on AA batteries for several years. Small solar panel on device can provide extended autonomy for more power-consuming sensors. IoT wireless connectivity (no charge, 2-8km range) sends data to a single edge-enabled IoT gateway.

# MORE FLEXIBLE APPROACH WITH RECENT WIRELESS IOT TECHNOLOGIES

## MADE POSSIBLE AT LARGE SCALE! EDGE-ENABLED GATEWAY PROVIDES

ADVANCED FEATURES.

# THE ECOSYSTEM WE ARE DEVELOPING FOR OUT-OF-THE-BOX SENSING SYSTEMS – MORE ADAPTED TO SMALL FARMS

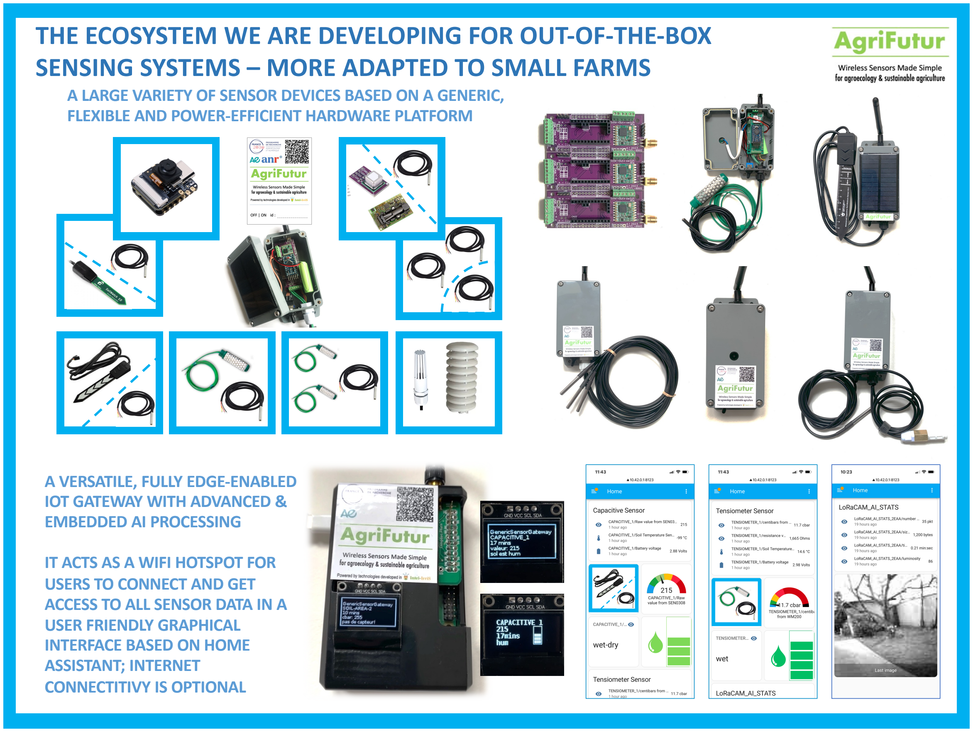
[picture p142: page 2]

A LARGE VARIETY OF SENSOR DEVICES BASED ON A GENERIC,

### FLEXIBLE AND POWER-EFFICIENT HARDWARE PLATFORM

### A VERSATILE, FULLY EDGE-ENABLED IOT GATEWAY WITH ADVANCED & EMBEDDED AI PROCESSING

### IT ACTS AS A WIFI HOTSPOT FOR USERS TO CONNECT AND GET ACCESS TO ALL SENSOR DATA IN A USER FRIENDLY GRAPHICAL INTERFACE BASED ON HOME ASSISTANT; INTERNET CONNECTITIVY IS OPTIONAL
