CongducPham/PEPR_AgriFutur/Tutorials/Generic-IOT-platform-PCBv4-PCBA.pdf

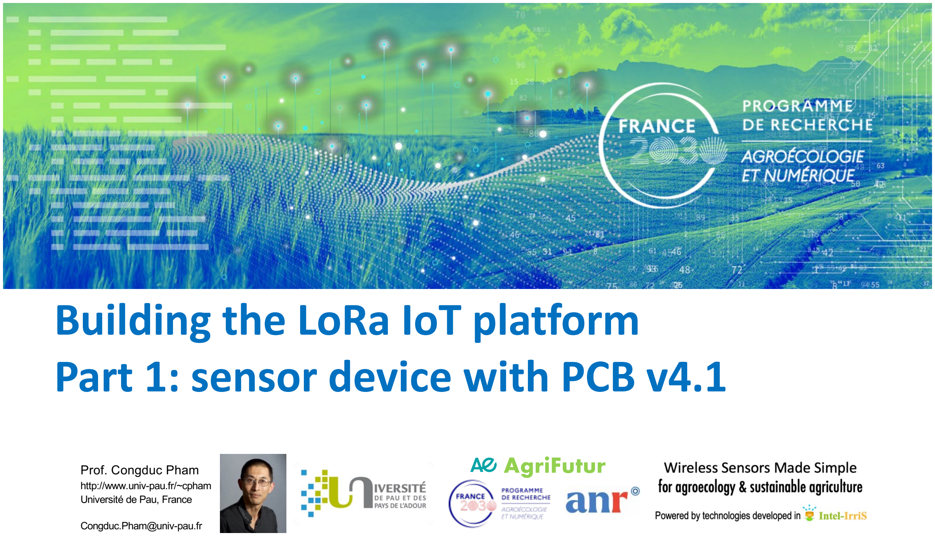
[picture p143: page 1]

Prof. Congduc Pham
http://www.univ-pau.fr/~cpham Université de Pau, France

Congduc.Pham@univ-pau.fr

AgriFutur

# Building the LoRa IoT platform Part 1: sensor device with PCB v4.1

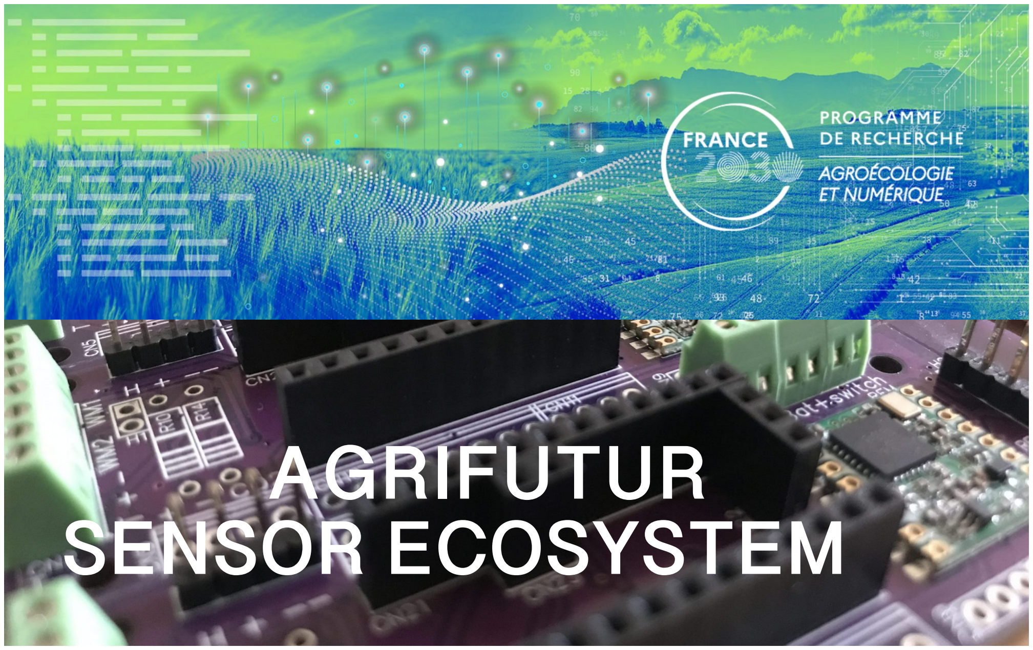
[picture p144: page 2]

# AGRIFUTUR SENSOR ECOSYSTEM

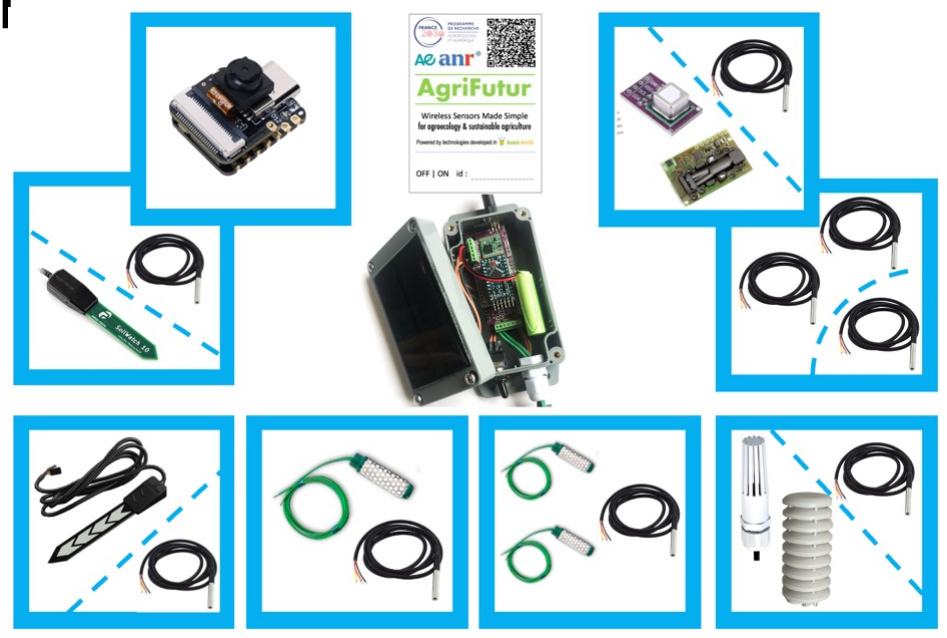
[picture p145: figure]
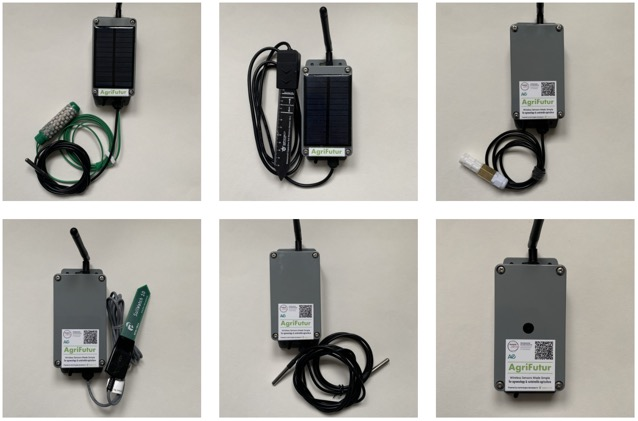
[picture p146: figure]

Prof. Congduc Pham

http://www.univ-pau.fr/~cpham

3

Going beyond irrigation ⊙ Use the same approach of cost-

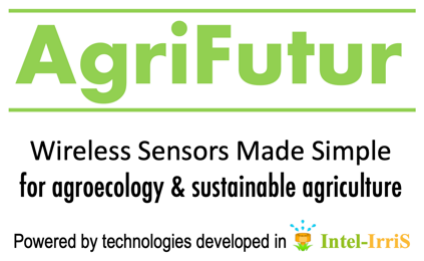
[picture p147: figure]

efficiency and out-of-the-box deployment, expanding the sensor ecosystem
⊙ Complementarity & Adaptability: high -
end, low

-end, innovative,

…
⊙ Target Agroecology, Nature
-Based
Solutions & Sustainable Agriculture ⊙ Better Qualify & Quantify the impact of these new practices
⊙ More data = more correlation in agroecological system


# CASING & PARTS

## List of components

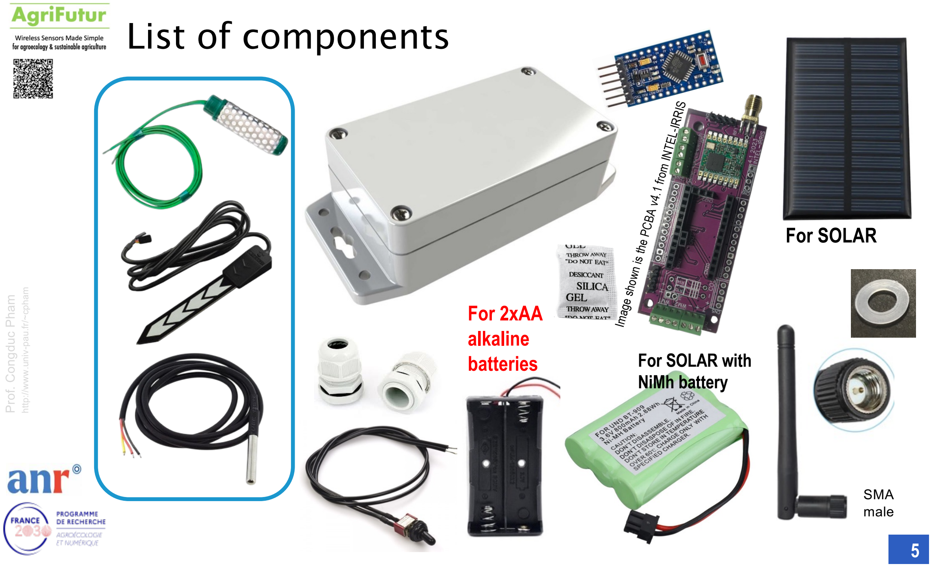
[picture p148: page 5]

Prof. Congduc Pham

http://www.univ-pau.fr/~cpham

5

SMA
male

For SOLAR with
NiMh battery

For 2xAA
alkaline
batteries

For SOLAR

# Image shown is the PCBA v4.1 from INTEL-IRRIS

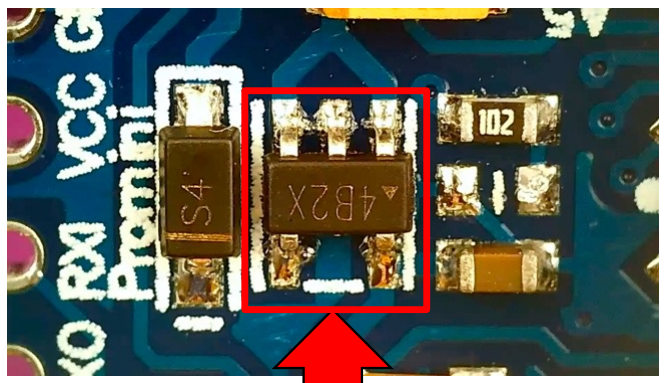
[picture p149: figure]

Prof. Congduc Pham

http://www.univ-pau.fr/~cpham

6

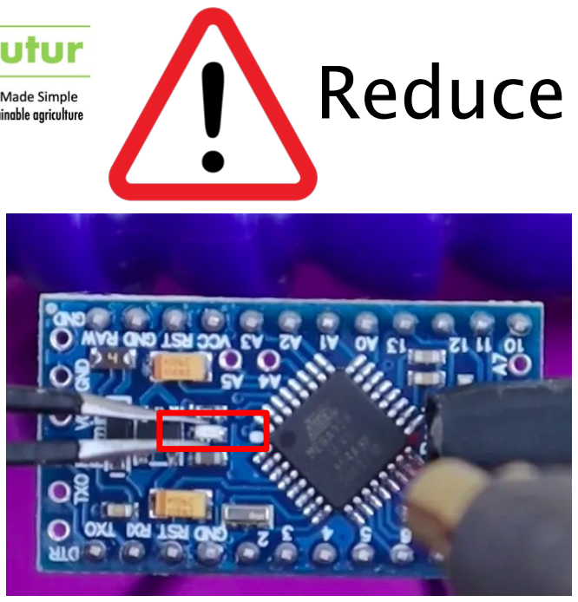
[picture p150: figure]

## Reduce power consumption

Do not forget to remove the power LED by just clipping it off with some wire cutters

Do not forget to
remove the
voltage regulator
with a small plier

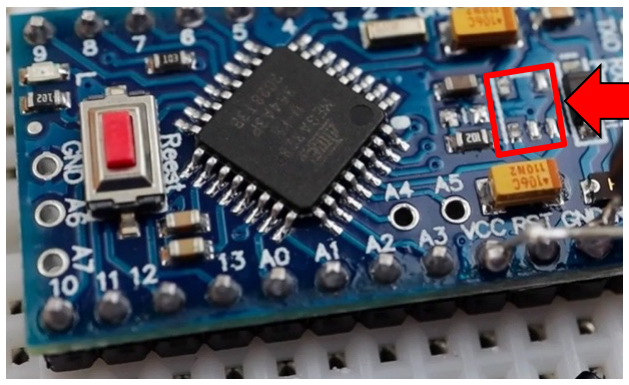
[picture p151: figure]

Only inject up to 3.6V through the VCC pin

https://www.the-diy-life.com/making-an-ultra-low-power-arduino-pro/

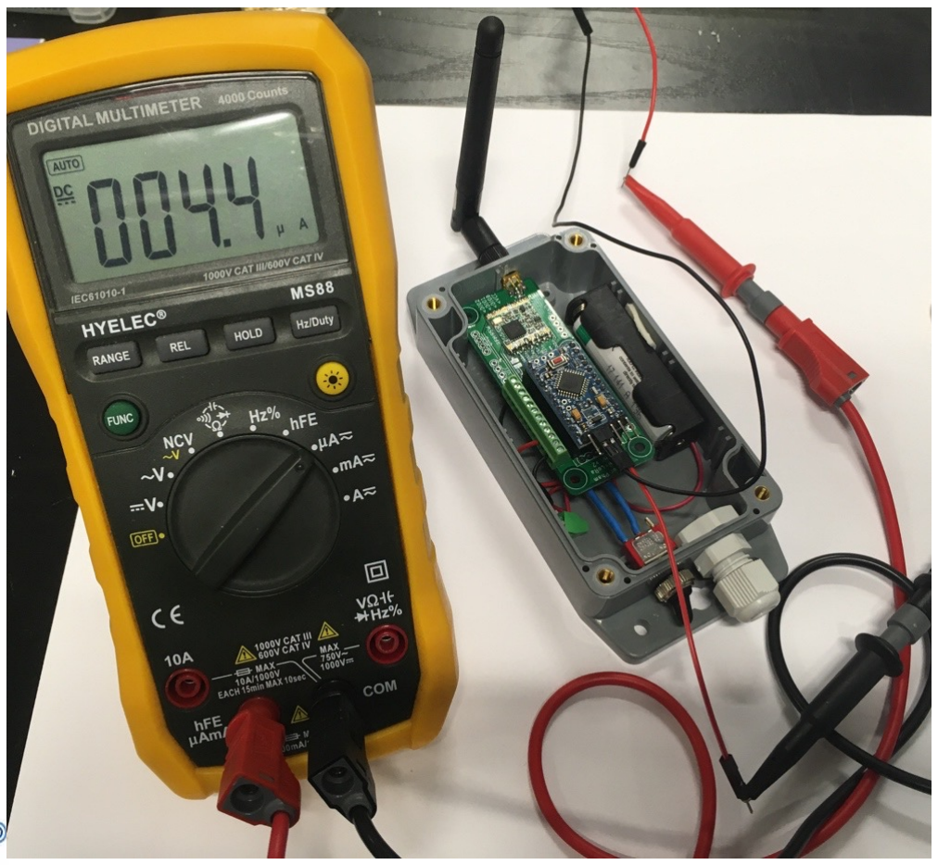
[picture p152: figure]

Prof. Congduc Pham

http://www.univ-pau.fr/~cpham

7

## Power consumption in deep sleep

Measured below 5uA in deep sleep, between 2 active
periods with transmissions

Expected autonomy with 1
transmission / hour is over 2 years with 2 AA batteries

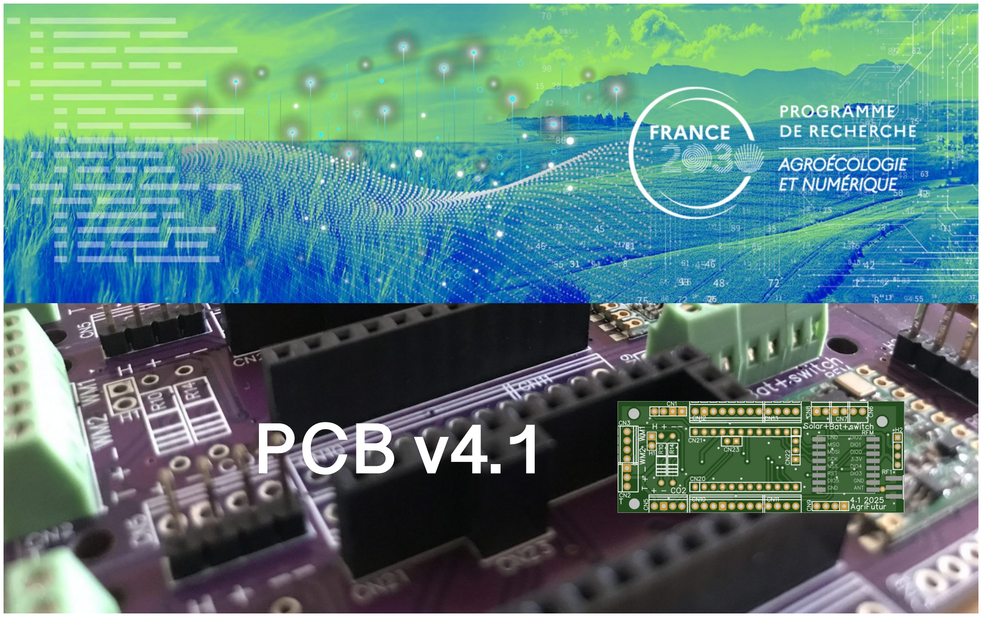
[picture p153: page 8]

# PCB v4.1

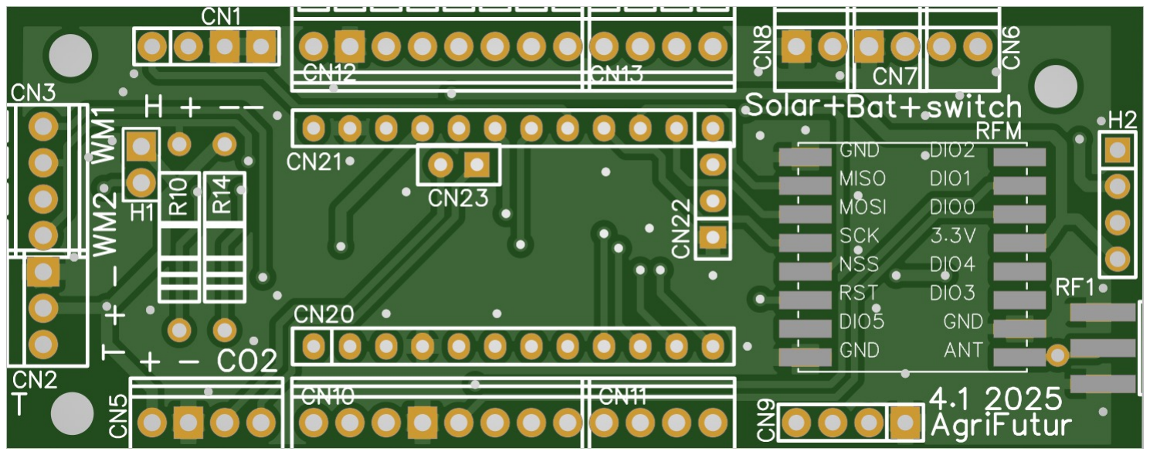
[picture p154: figure]

Prof. Congduc Pham

http://www.univ-pau.fr/~cpham

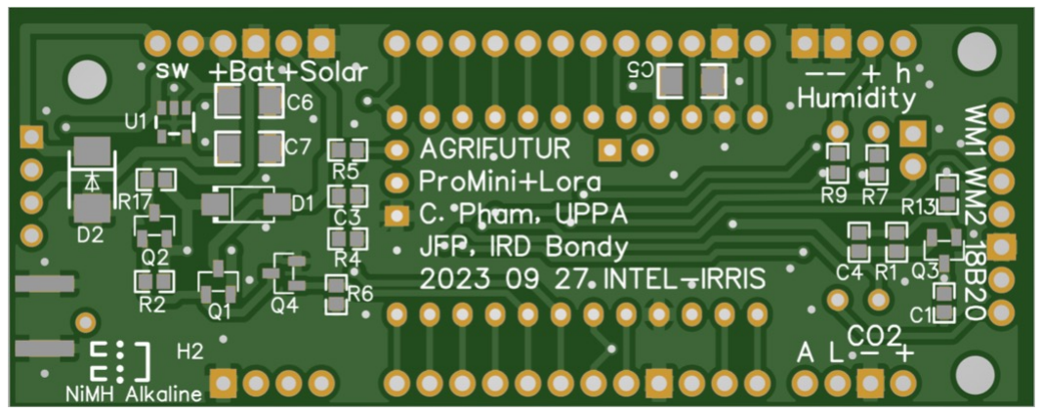
[picture p155: figure]

9

## The PCB v4.1 – raw version

⊙ You can order the raw version of IRD PCB, which means only the PCB, without any electronic components soldered by the manufacturer
⊙ It is the so-called
DIY approach
⊙ The raw version is not
intended to have solar
charging capabilities

## Electronic parts

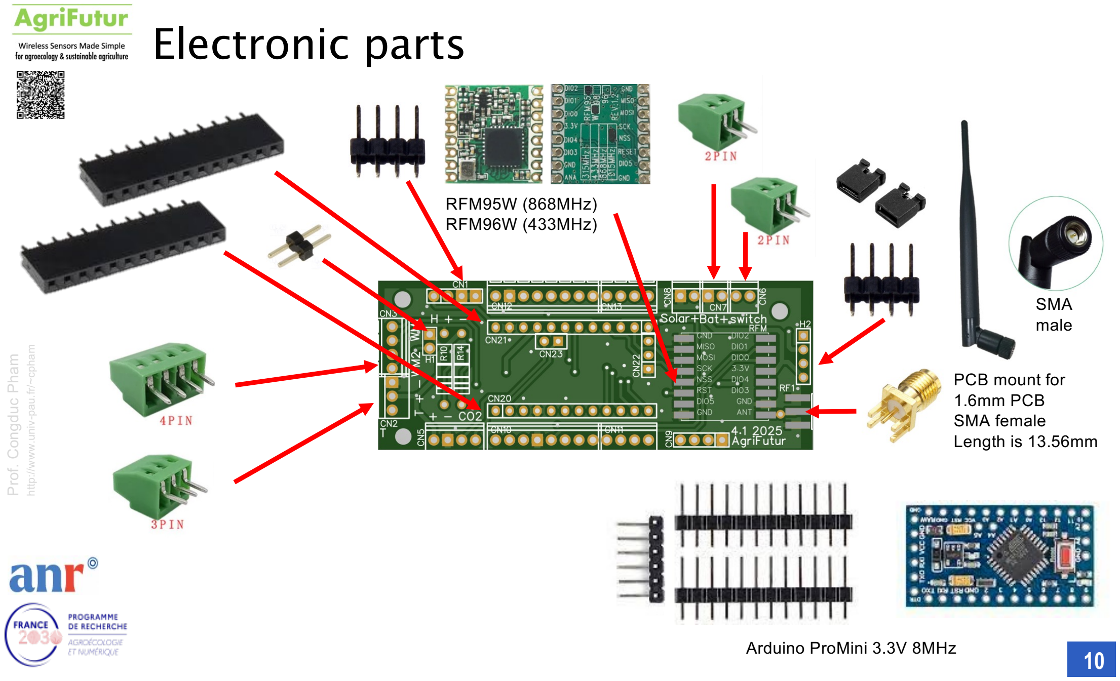
[picture p156: page 10]

Prof. Congduc Pham

http://www.univ-pau.fr/~cpham

10

RFM95W (868MHz)
RFM96W (433MHz)

PCB mount for
1.6mm PCB
SMA female
Length is 13.56mm

Arduino ProMini 3.3V 8MHz

SMA
male

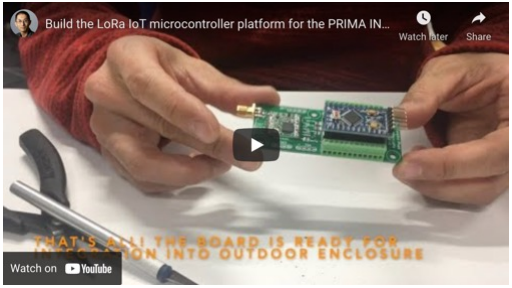
[picture p157: figure]

Prof. Congduc Pham

http://www.univ-pau.fr/~cpham

11

## Tutorial video

⊙ This dedicated video from INTEL-IRRIS will show how to solder all the components: Video n°1: https://youtu.be/3jdQ0Uo0phQ
⊙ It features the "old" version of the INTEL-IRRIS PCB but you can easily adapt for the PCB v4.1

Prof. Congduc Pham

http://www.univ-pau.fr/~cpham

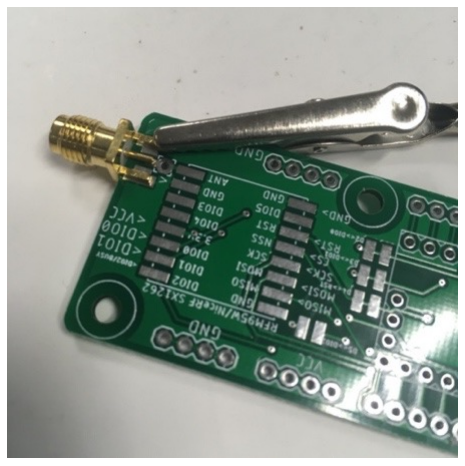
[picture p158: figure]
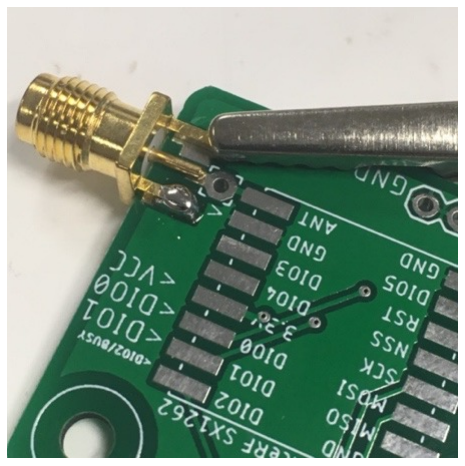
[picture p159: figure]
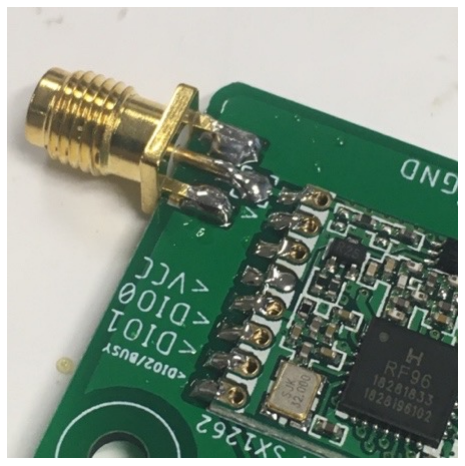
[picture p160: figure]

12

## Updates on Video n°1

⊙ Clip the SMA connector to the PCB to correctly align the connector before soldering one of the GND pad, then remove clip and finish soldering
⊙ Or, gently press SMA connector pads so that insertion on PCB is harder and SMA connector will not move during soldering
⊙ Make sure that the GND pads and the central pin are not touching each other, in doubt, do a continuity check

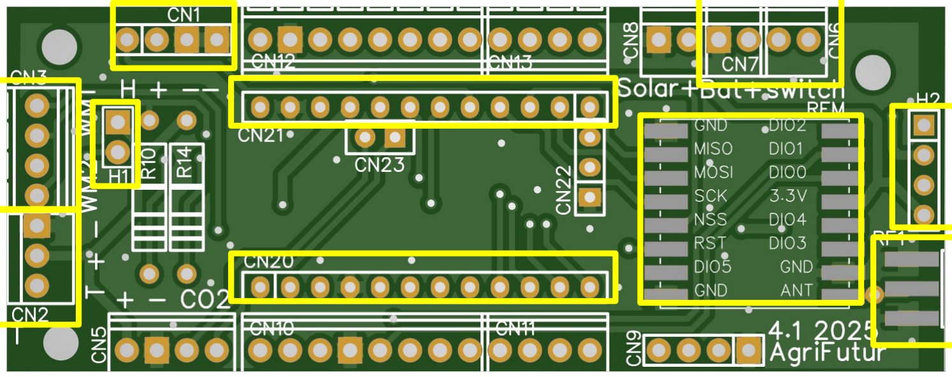
[picture p161: figure]

Prof. Congduc Pham

http://www.univ-pau.fr/~cpham

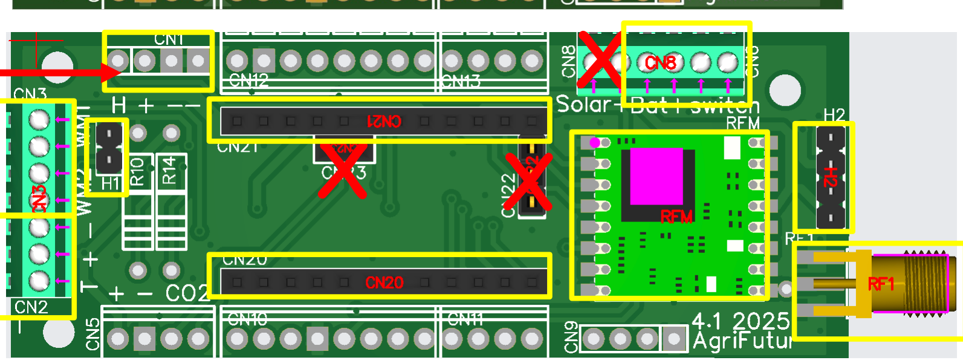
[picture p162: figure]

13

⊙ Solder the various components on the top face

## Soldering parts on PCB v4.1

X Not needed for the
raw PCB which is not
designed to have the
solar circuit
manually soldered

The raw version is not
intended to have solar
charging capabilities.
For solar charging, the
full version (see later) is the dedicated PCBA

## Wiring switch & bat on PCB v4.1

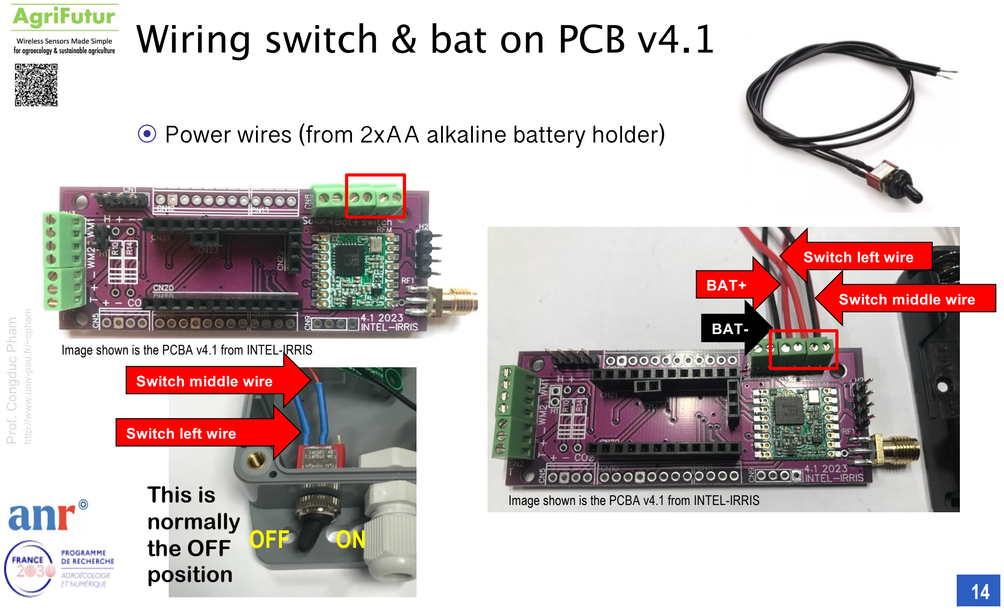
[picture p163: page 14]

Prof. Congduc Pham

http://www.univ-pau.fr/~cpham

14

⊙ Power wires (from 2xAA alkaline battery holder)

BAT+

BAT-

Switch middle wire

Switch left wire

Switch middle wire

Switch left wire

Image shown is the PCBA v4.1 from INTEL-IRRIS

This is | Image shown is the PCBA v4.1 from INTEL-IRRIS
normally
the OFF
position

OFF ON

## H1 & H2 header on PCB v4.1

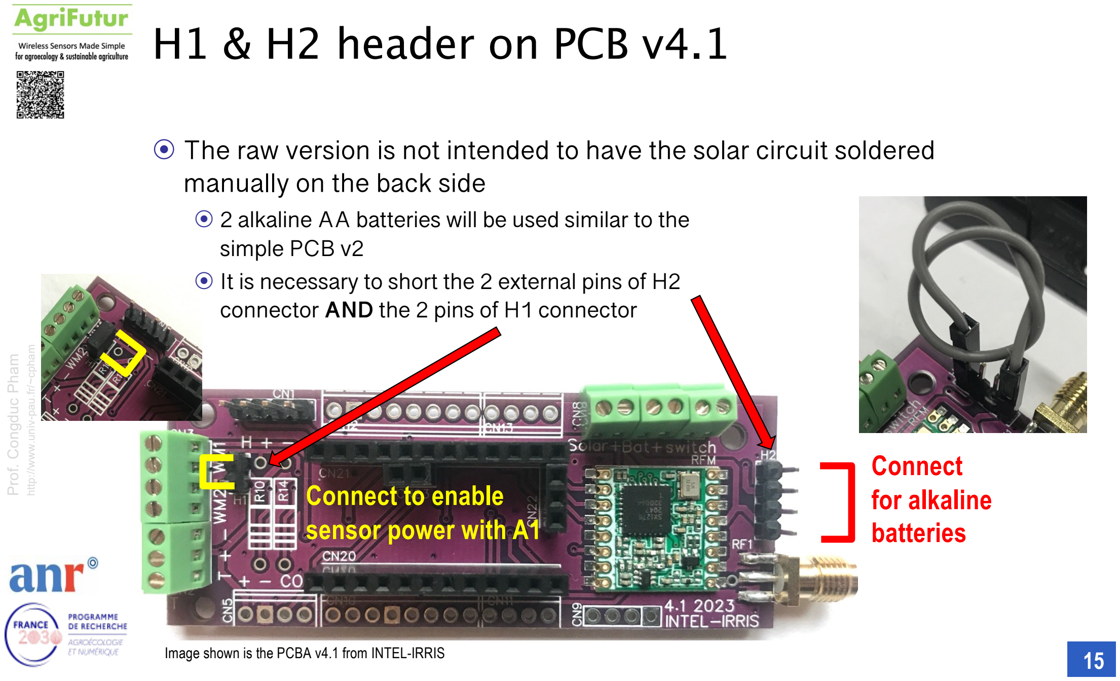
[picture p164: page 15]

Prof. Congduc Pham

http://www.univ-pau.fr/~cpham

15

⊙ The raw version is not intended to have the solar circuit soldered manually on the back side
⊙ 2 alkaline AA batteries will be used similar to the
simple PCB v2
⊙ It is necessary to short the 2 external pins of H2 connector AND the 2 pins of H1 connector

Connect
for alkaline
batteries

Connect to enable
sensor power with A1

Image shown is the PCBA v4.1 from INTEL-IRRIS

## Explanation of previous slide

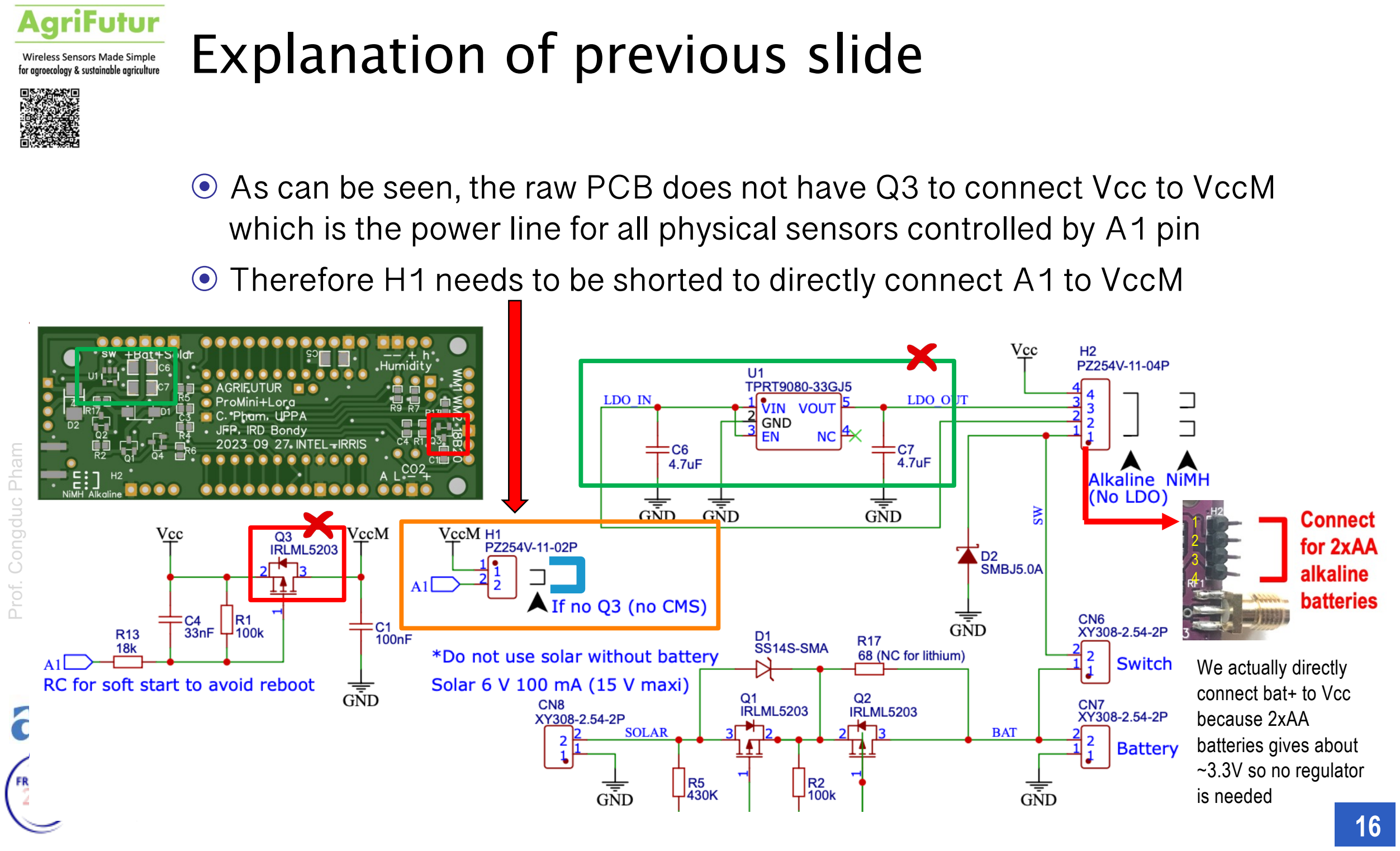
[picture p165: page 16]

Prof. Congduc Pham

http://www.univ-pau.fr/~cpham

16

⊙ As can be seen, the raw PCB does not have Q3 to connect Vcc to VccM which is the power line for all physical sensors controlled by A1 pin
⊙ Therefore H1 needs to be shorted to directly connect A1 to VccM

1
2
3
4

We actually directly
connect bat+ to Vcc
because 2xAA
batteries gives about
~3.3V so no regulator
is needed

Prof. Congduc Pham

http://www.univ-pau.fr/~cpham

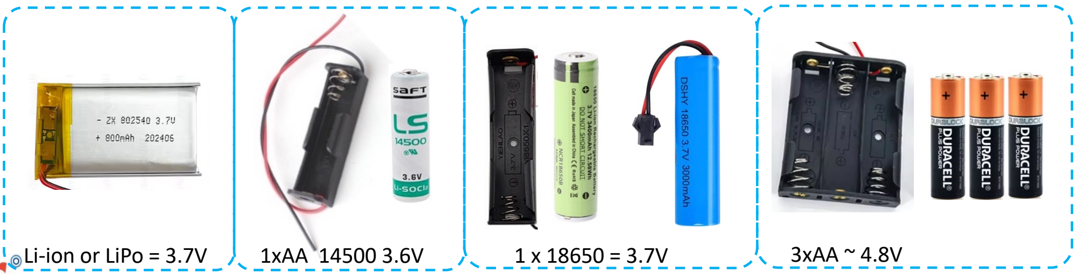
[picture p166: figure]
Li-ion or LiPo = 3.7V; 1xAA 14500 3.6V; 3xAA ~ 4.8V

17

## Alternatives for batteries

⊙ Simple 2xAA 1.5V batteries delivering ~3.2V when new can be too low for some settings where the connected sensors needs a stable voltable close to 3.3V, especially when the highest quality for alkaline/lithium AA 1.5V batteries are not easily found
⊙ There are other alternatives as illustrated below

⊙ The 3xAA is the simplest and the cheapest alternative

Prof. Congduc Pham

http://www.univ-pau.fr/~cpham

## Using 3xAA alkaline batteries

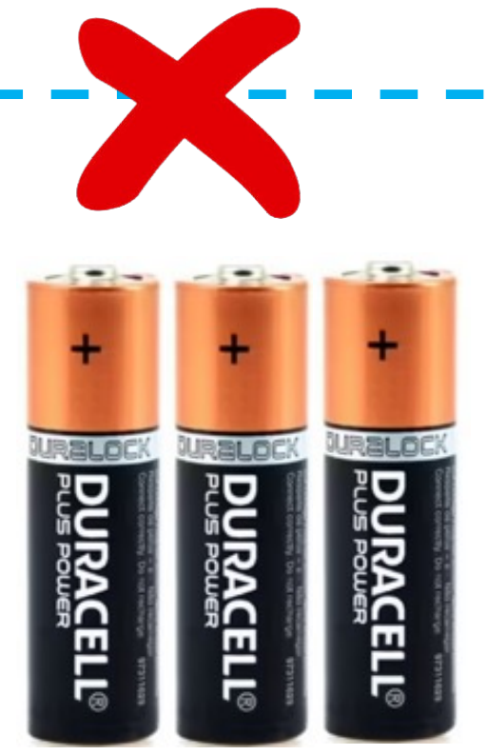
[picture p167: figure]

⊙ The 3xAA battery holder is too big for the selected case. If we keep the same case, here is a possible solution
⊙ In addition to the already 2xAA battery holder, add a 1xAA battery holder

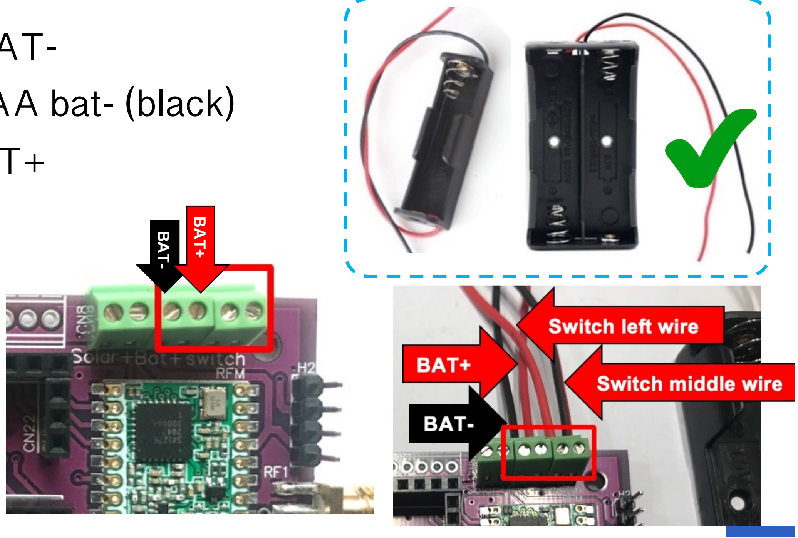
[picture p168: figure]
BAT-; BAT+

⊙ Connect 2xAA bat- (black) to BAT-
⊙ Connect 2xAA bat+ (red) to 1xAA bat- (black)
⊙ Connect 1xAA bat+ (red) to BAT+
⊙ Both battery holders can be put
in the case , see next slide

Prof. Congduc Pham

http://www.univ-pau.fr/~cpham

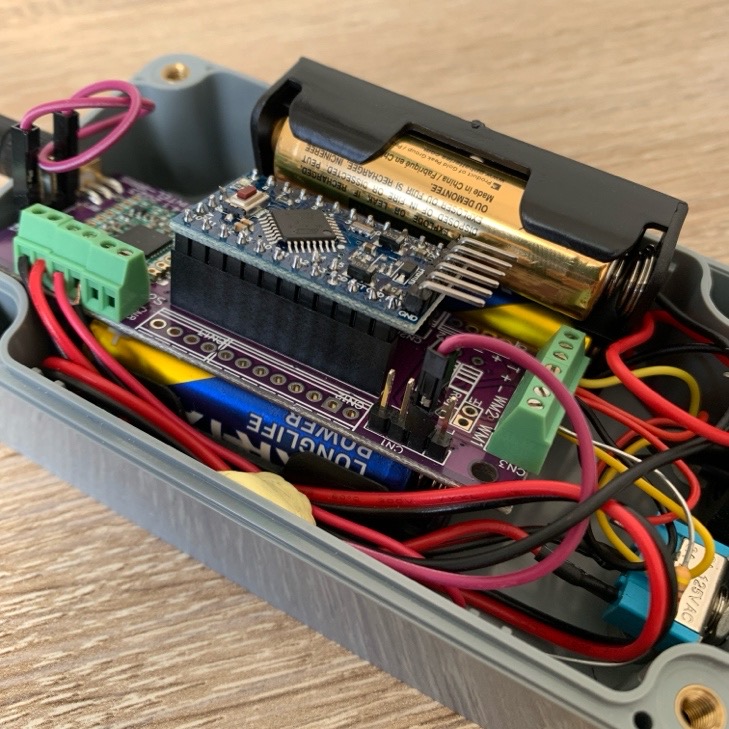
[picture p169: figure]

19

## Using 3xAA, keep Pro Mini regulator

⊙ With 3xAA providing ~ 4.8V, we MUST KEEP the Arduino Pro Mini on-

Both battery holders can be put in the case

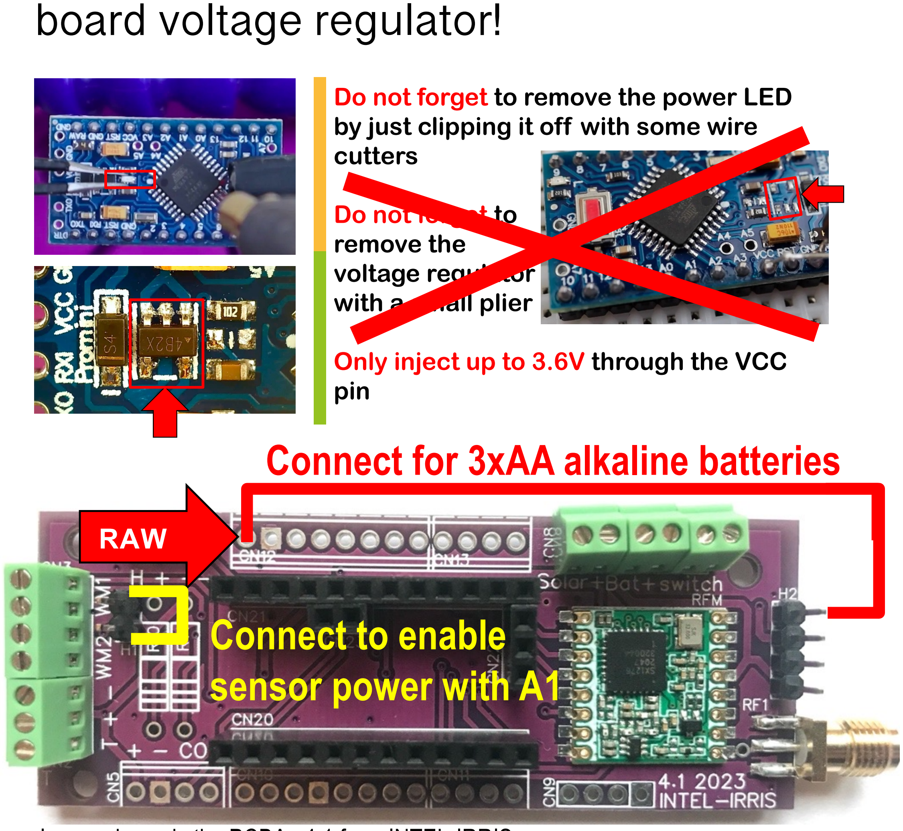
[picture p170: figure]
board voltage regulator!; Do not forget to remove the power LED by just clipping it off with some wire cutters; Do not forget to remove the voltage regulator with a small plier; Only inject up to 3.6V through the VCC pin Connect for 3xAA alkaline batteries; RAW; Connect to enable sensor power with A1

Image shown is the PCBA v4.1 from INTEL-IRRIS

## Explanation of previous slide

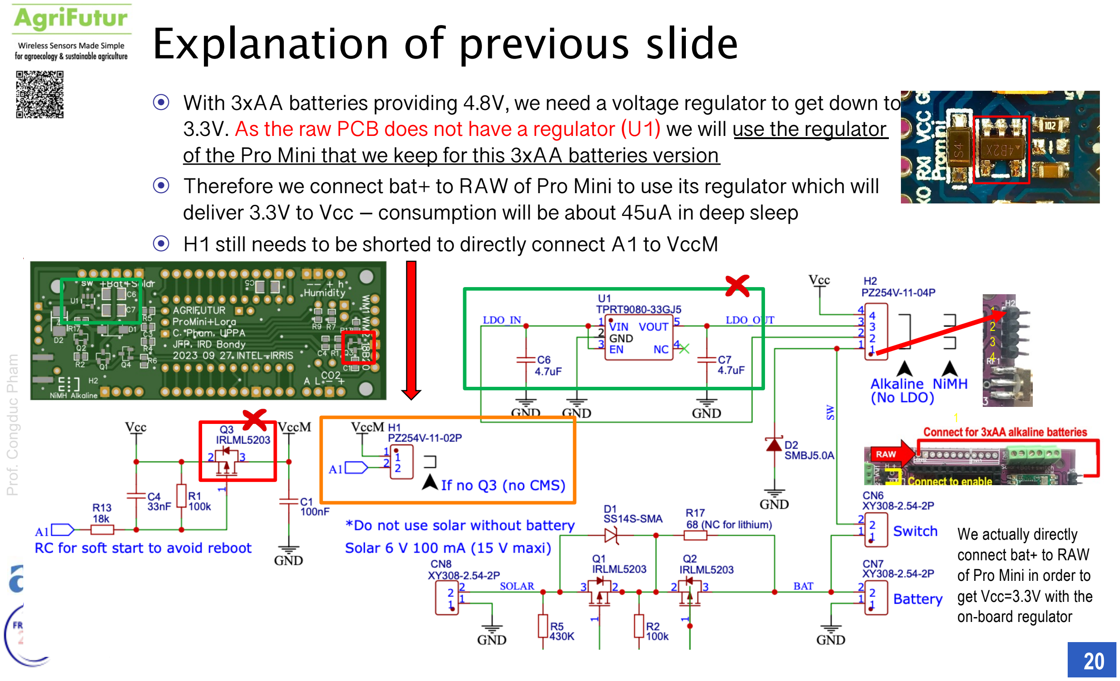
[picture p171: page 20]

Prof. Congduc Pham

http://www.univ-pau.fr/~cpham

20

⊙ With 3xAA batteries providing 4.8V, we need a voltage regulator to get down to 3.3V. As the raw PCB does not have a regulator (U1) we will use the regulator of the Pro Mini that we keep for this 3xAA batteries version
⊙ Therefore we connect bat+ to RAW of Pro Mini to use its regulator which will deliver 3.3V to Vcc – consumption will be about 45uA in deep sleep
⊙ H1 still needs to be shorted to directly connect A1 to VccM

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
We actually directly
connect bat+ to RAW
of Pro Mini in order to
get Vcc=3.3V with the
on-board regulator

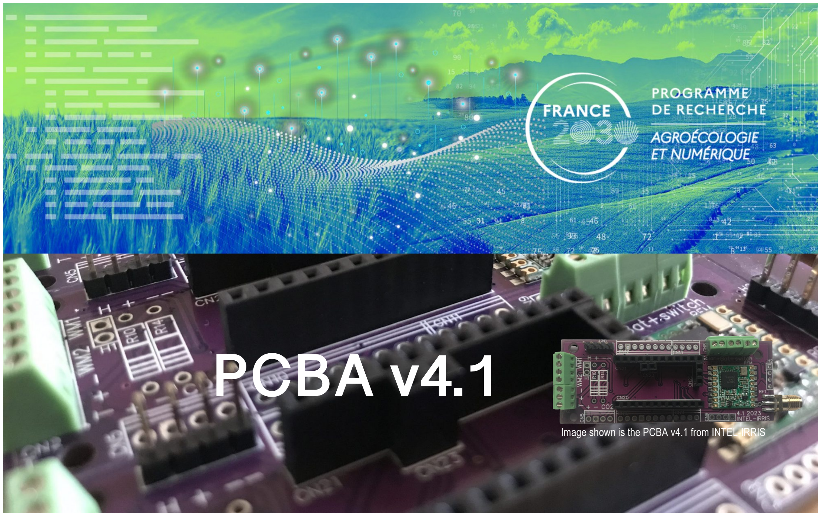
[picture p172: page 21]

# PCBA v4.1

Image shown is the PCBA v4.1 from INTEL-IRRIS

## Wiring with PCBA v4.1

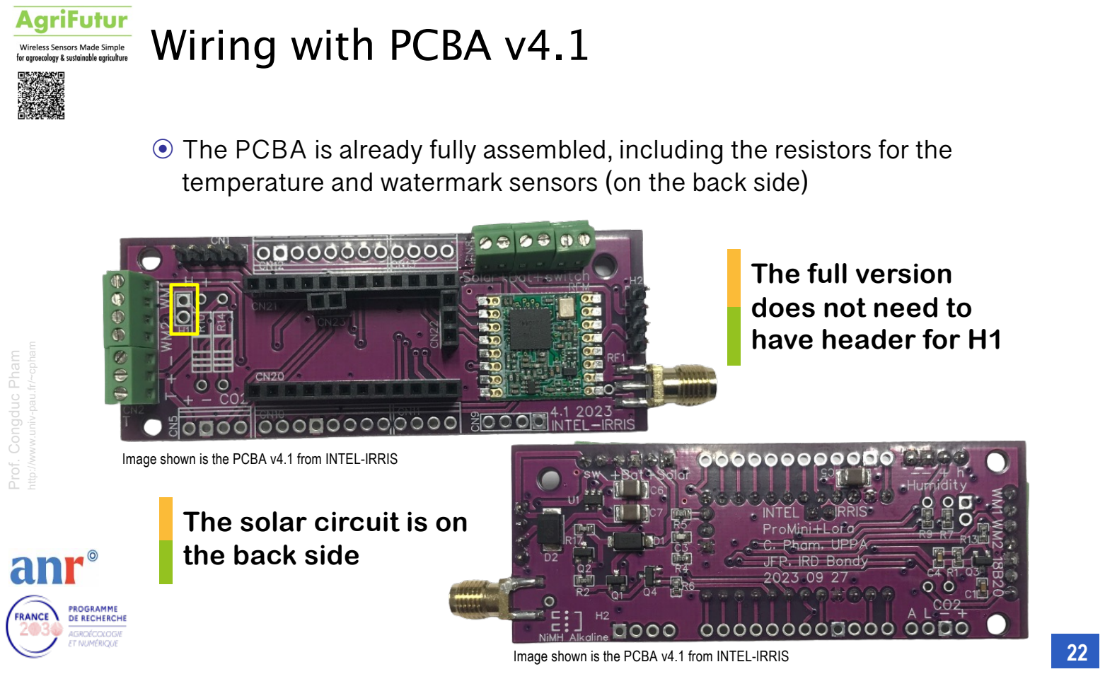
[picture p173: page 22]

Prof. Congduc Pham

http://www.univ-pau.fr/~cpham

22

⊙ The PCBA is already fully assembled, including the resistors for the temperature and watermark sensors (on the back side)

The solar circuit is on
the back side

The full version
does not need to
have header for H1

Image shown is the PCBA v4.1 from INTEL-IRRIS

Image shown is the PCBA v4.1 from INTEL-IRRIS

## Wiring with PCBA v4.1

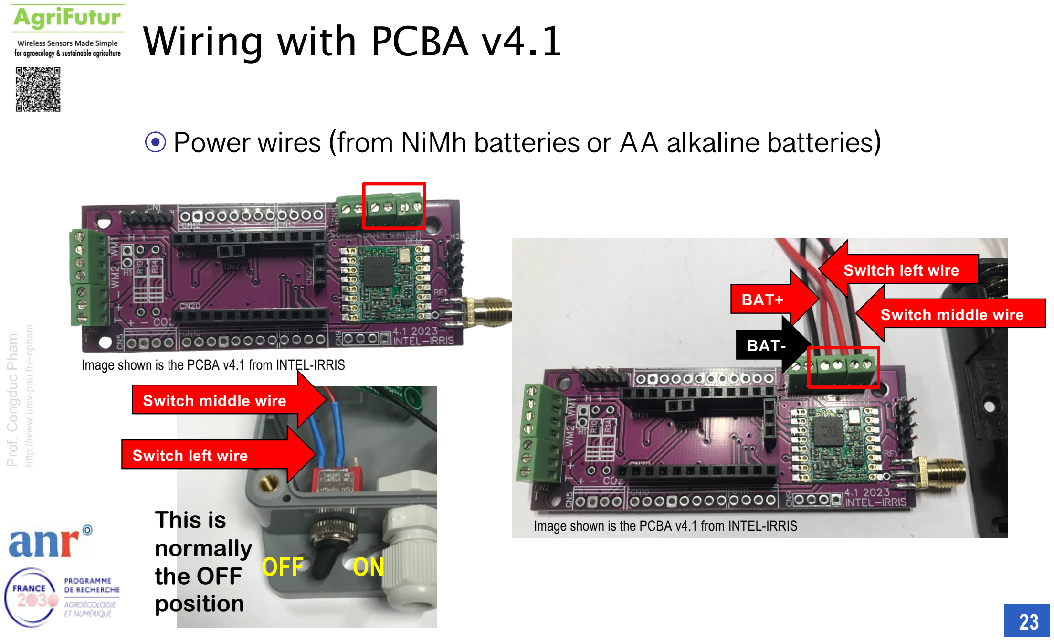
[picture p174: page 23]

Prof. Congduc Pham

http://www.univ-pau.fr/~cpham

23

⊙ Power wires (from NiMh batteries or AA alkaline batteries)

BAT+

BAT-

Switch middle wire

Switch left wire

Switch middle wire

Switch left wire

Image shown is the PCBA v4.1 from INTEL-IRRIS

This is | Image shown is the PCBA v4.1 from INTEL-IRRIS
normally
the OFF
position

OFF ON

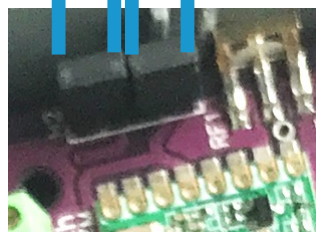
[picture p175: figure]

Prof. Congduc Pham

http://www.univ-pau.fr/~cpham

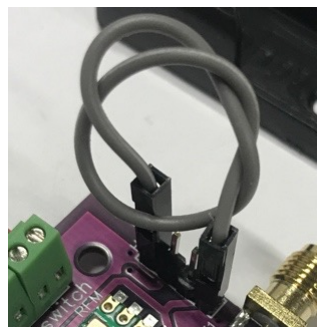
[picture p176: figure]

24

## Wiring with PCBA v4.1

⊙ The full version (PCBA) comes with the solar charging circuit
⊙ BUT you can still power it with 2 alkaline AA batteries without using a solar panel to avoid external fragile parts
⊙ You can select between solar charging with NiMh batteries or no solar charging with 2 alkaline AA batteries

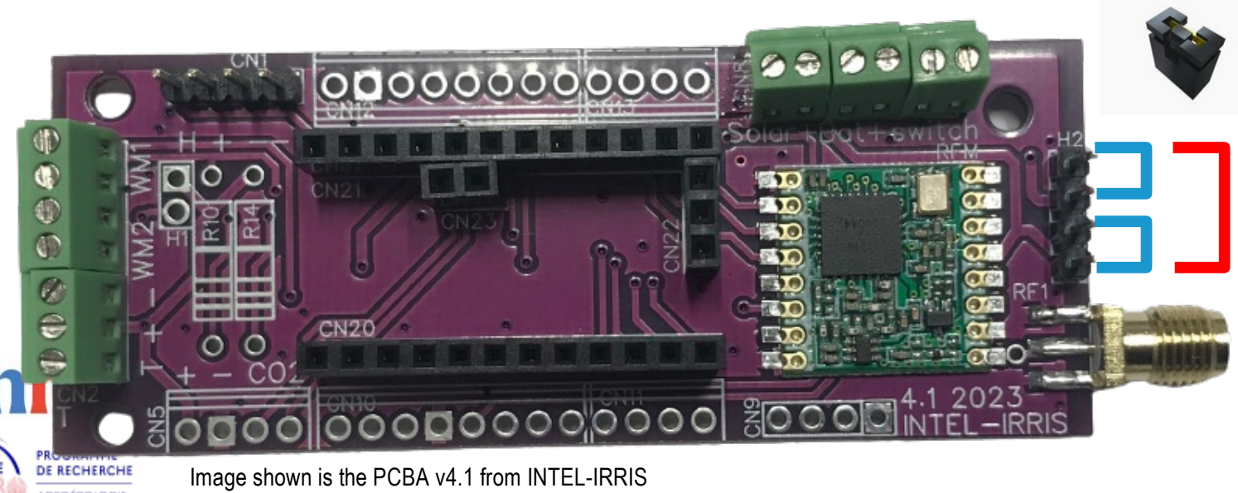
[picture p177: figure]

Connect
for SOLAR
with NiMh

Connect
for alkaline
batteries

Image shown is the PCBA v4.1 from INTEL-IRRIS

Prof. Congduc Pham

http://www.univ-pau.fr/~cpham

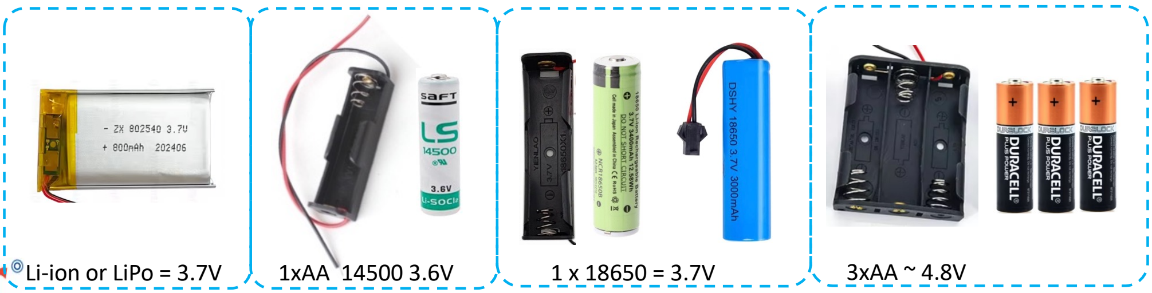
[picture p178: figure]
Li-ion or LiPo = 3.7V; 1xAA 14500 3.6V; 3xAA ~ 4.8V

25

## Alternatives for no rechargeable batteries

⊙ Simple 2xAA 1.5V batteries delivering ~3.2V when new can be too low for some settings where the connected sensors needs a stable voltable close to 3.3V, especially when the highest quality for alkaline/lithium AA 1.5V batteries are not easily found
⊙ There are other alternatives as illustrated below

⊙ The 3xAA is the simplest and the cheapest alternative

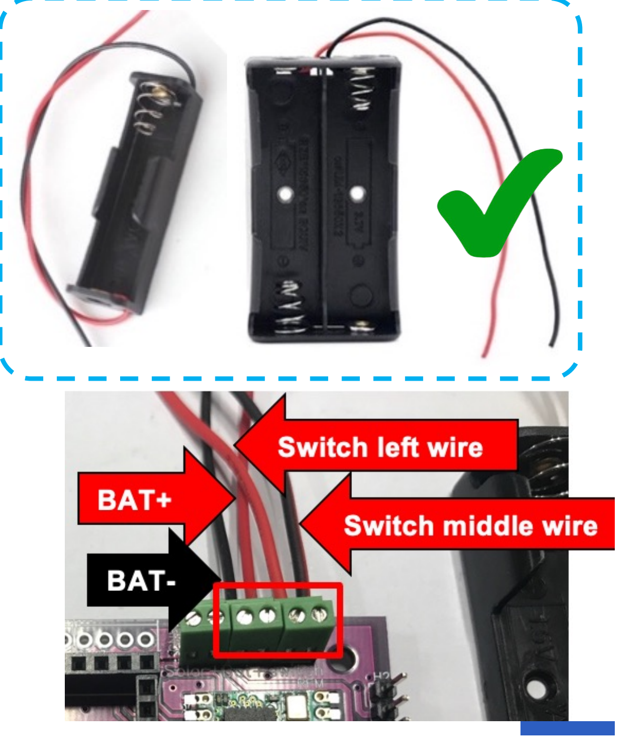
[picture p179: figure]

Prof. Congduc Pham

http://www.univ-pau.fr/~cpham

## Using 3xAA alkaline batteries

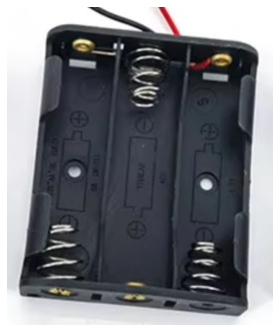
[picture p180: figure]

⊙ The 3xAA battery holder is too big for the selected case. If we keep the same case, here is a possible solution
⊙ In addition to the already 2xAA battery holder, add a 1xAA battery holder
⊙ Connect 2xAA bat- (black) to BAT-
⊙ Connect 2xAA bat+ (red) to 1xAA bat- (black)
⊙ Connect 1xAA bat+ (red) to BAT+
⊙ Both battery holder can be put
in the case , see next slide

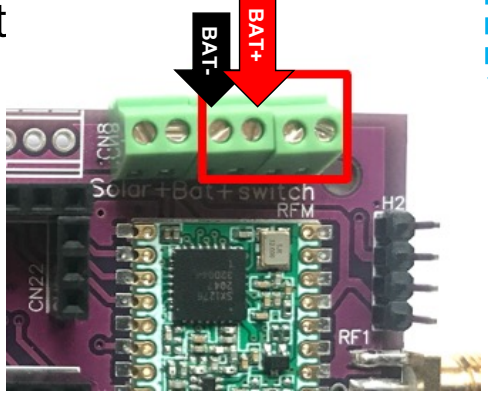
[picture p181: figure]
BAT-; BAT+

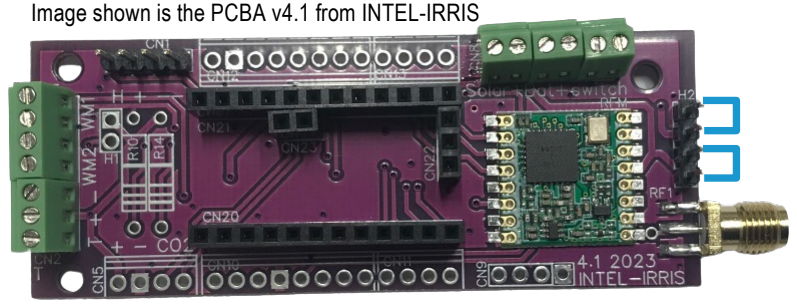
[picture p182: figure]

Prof. Congduc Pham

http://www.univ-pau.fr/~cpham

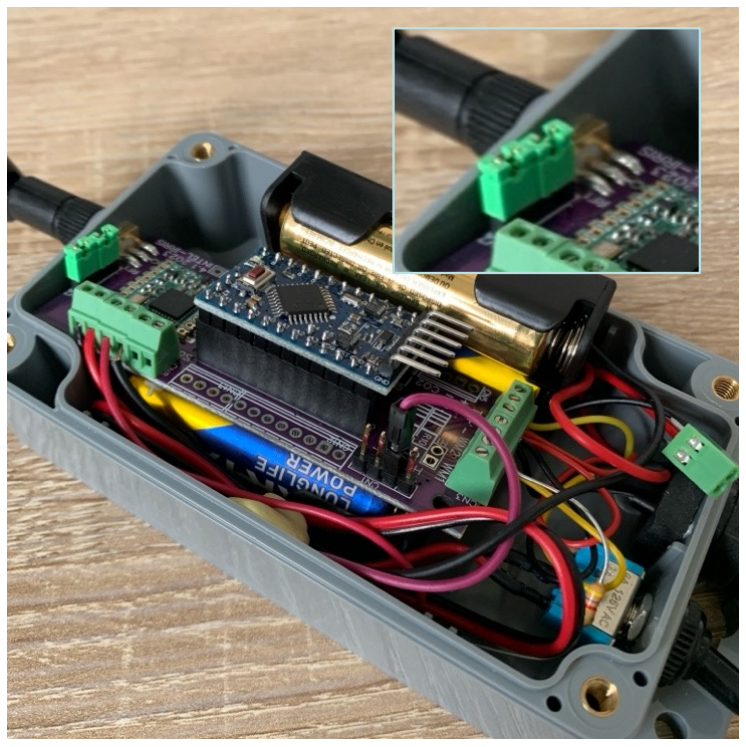
[picture p183: figure]

27

## Using 3xAA, use PCBA voltage regulator

⊙ With 3xAA providing ~ 4.8V, we can use the PCBAv4.1 on-board voltage regulator that is more efficient than the one of the Pro Mini ⊙ The regulator on the Pro Mini should then
be removed with the PCBA version
⊙ Consumption will be about 55uA in deep
sleep

Both battery holders can be put in the case

Image shown is the PCBA v4.1 from INTEL-IRRIS

## Explanation of previous slide

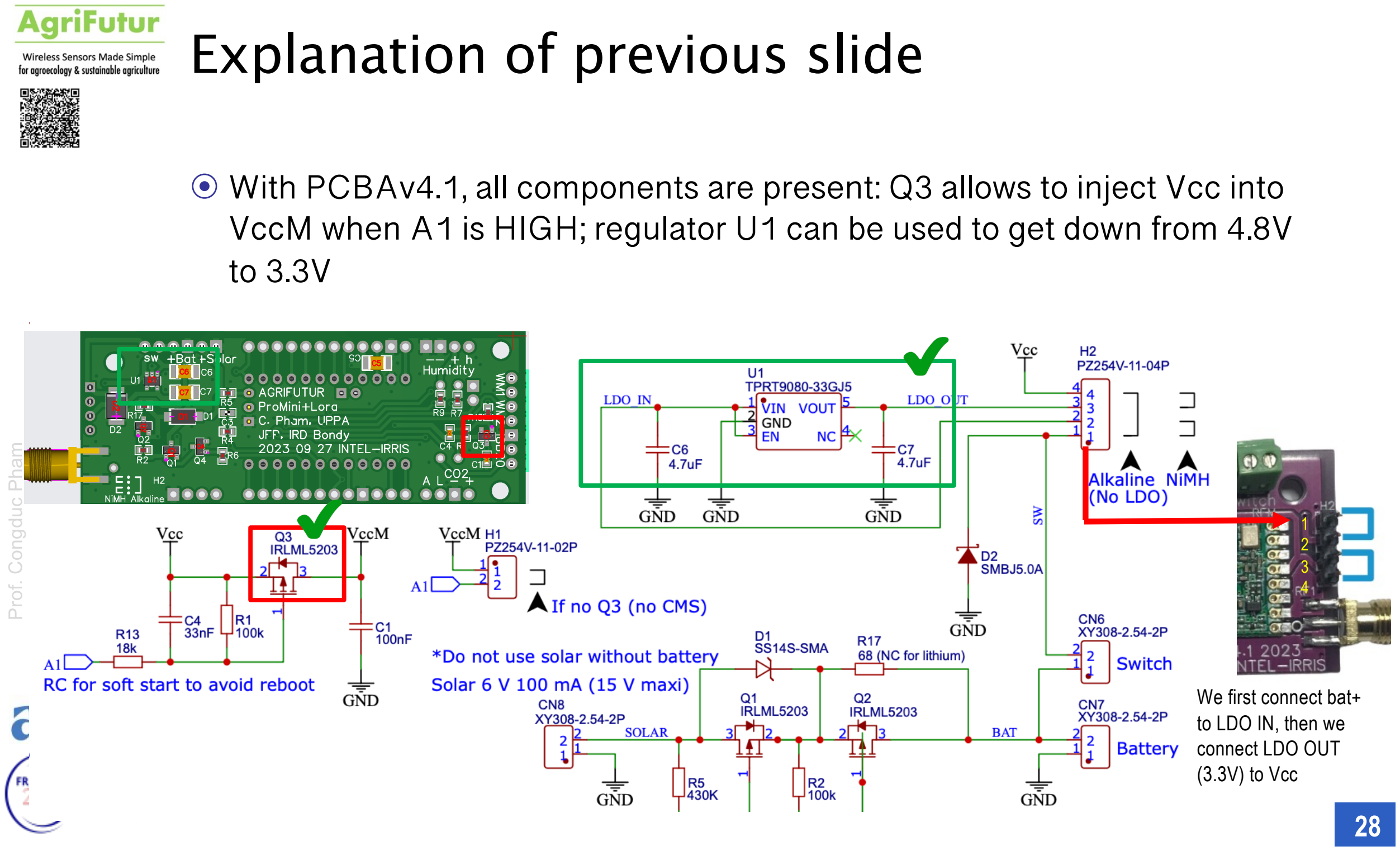
[picture p184: page 28]

Prof. Congduc Pham

http://www.univ-pau.fr/~cpham

28

⊙ With PCBAv4.1, all components are present: Q3 allows to inject Vcc into VccM when A1 is HIGH; regulator U1 can be used to get down from 4.8V to 3.3V

We first connect bat+
to LDO IN, then we
connect LDO OUT
(3.3V) to Vcc

1
2
3
4

## PCBA: Installing solar panel (1)

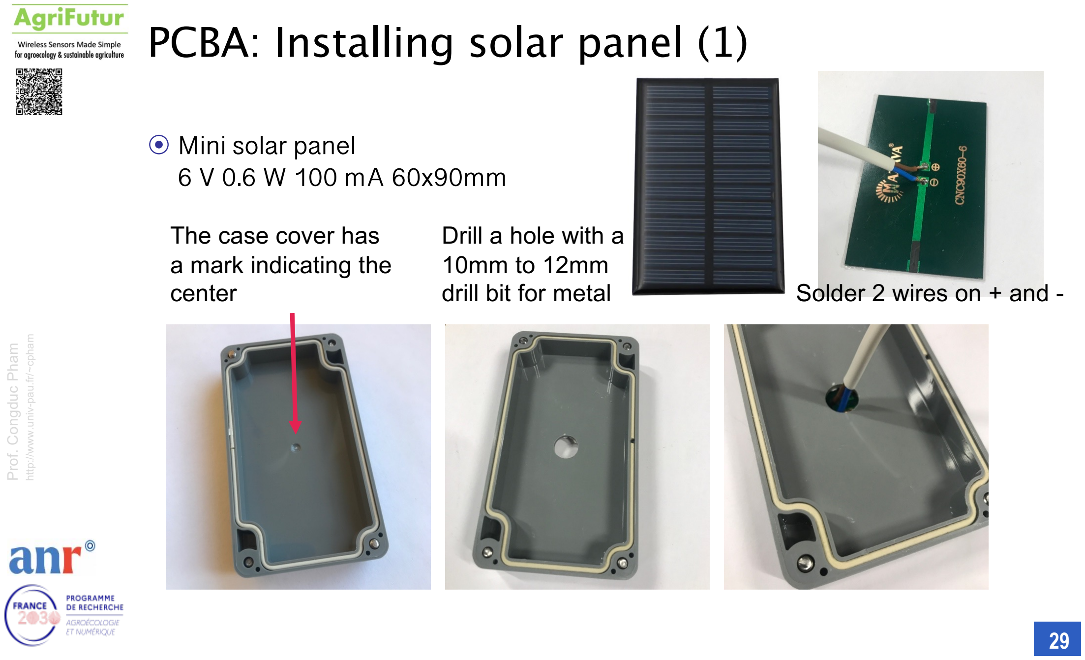
[picture p185: page 29]

Prof. Congduc Pham

http://www.univ-pau.fr/~cpham

29

⊙ Mini solar panel
6 V 0.6 W 100 mA 60x90mm

The case cover has
a mark indicating the
center

Drill a hole with a
10mm to 12mm
drill bit for metal | Solder 2 wires on + and -

## PCBA: Installing solar panel (2)

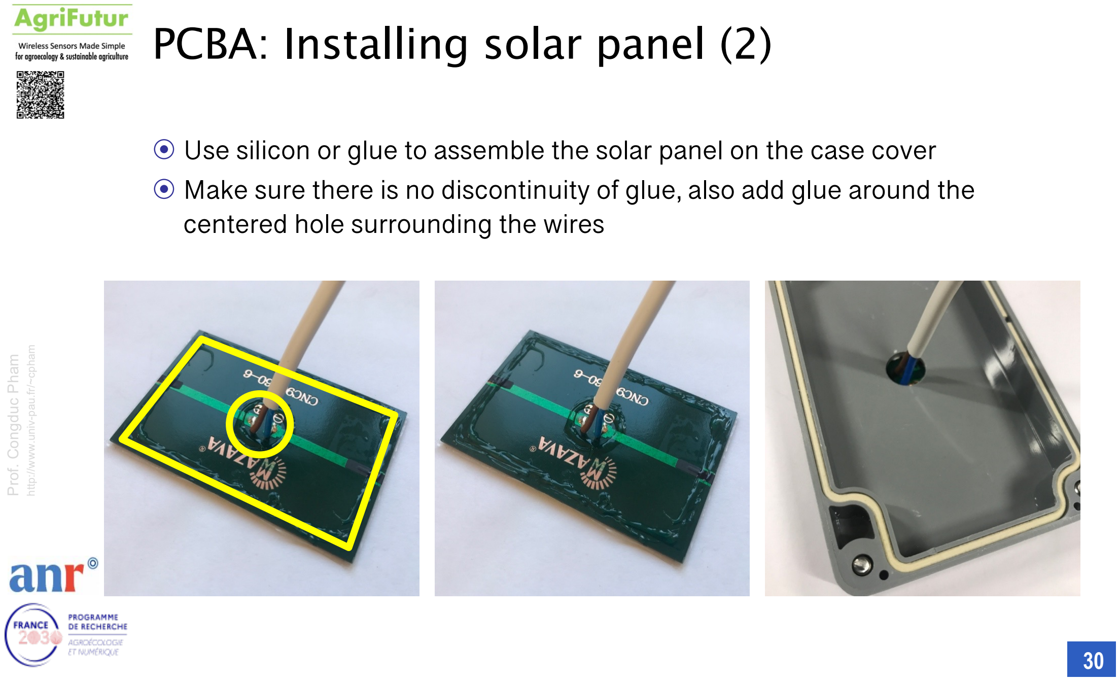
[picture p186: page 30]

Prof. Congduc Pham

http://www.univ-pau.fr/~cpham

30

⊙ Use silicon or glue to assemble the solar panel on the case cover
⊙ Make sure there is no discontinuity of glue, also add glue around the centered hole surrounding the wires

## Wiring with PCB1 v4.1

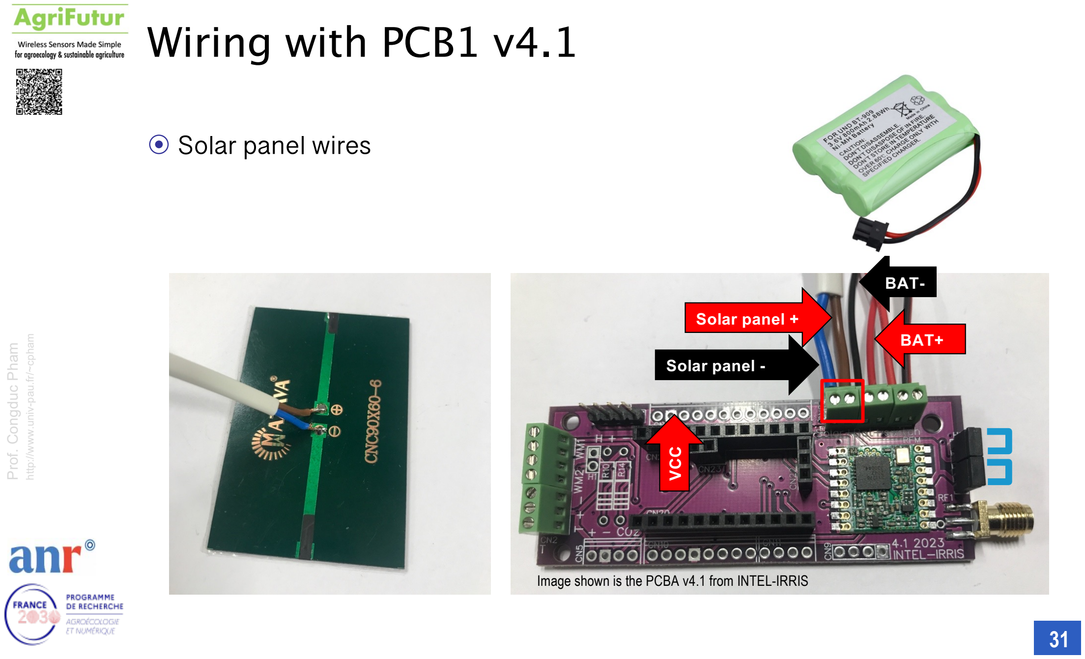
[picture p187: page 31]

Prof. Congduc Pham

http://www.univ-pau.fr/~cpham

31

⊙ Solar panel wires

VCC

BAT+

BAT-

Solar panel -

Solar panel +

Image shown is the PCBA v4.1 from INTEL-IRRIS

Prof. Congduc Pham

http://www.univ-pau.fr/~cpham

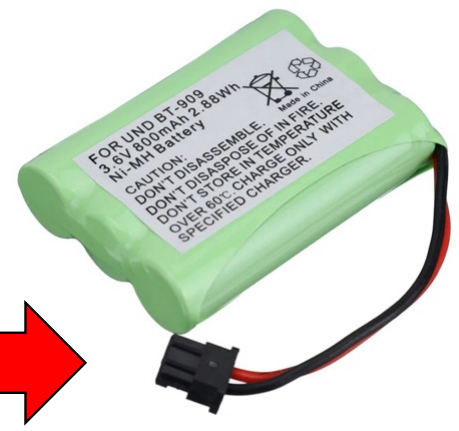
[picture p188: figure]

32

## Wiring with PCB1 v4.1

⊙ Connect NiMh batterie packs with a 2-pin female connector ⊙ You can screw in a 2-pin male 90° header

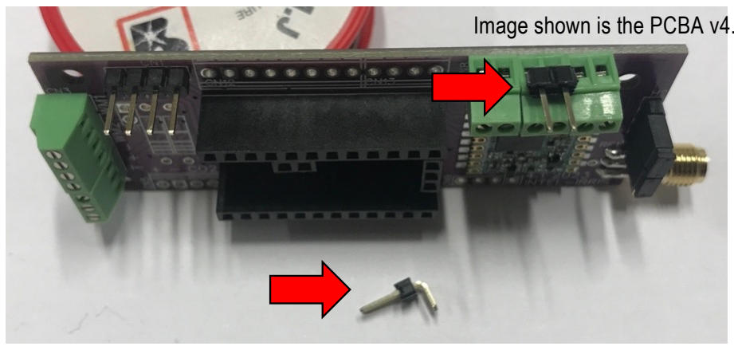
[picture p189: figure]
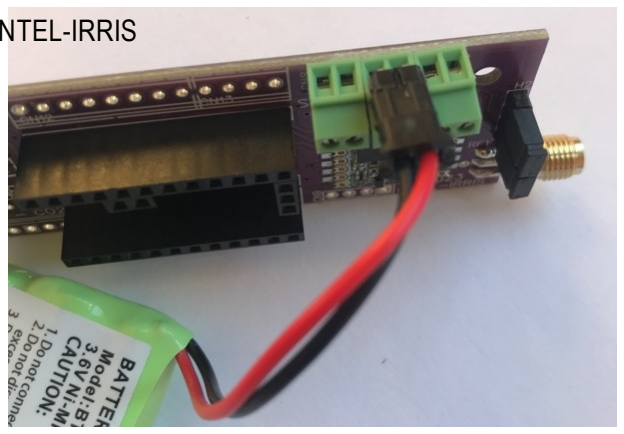
[picture p190: figure]

You can buy NiMh
battery packs with
a 2 pin connector
that can be used
for fast connection

Image shown is the PCBA v4.1 from INTEL-IRRIS

## IMPORTANT: Arduino ProMini

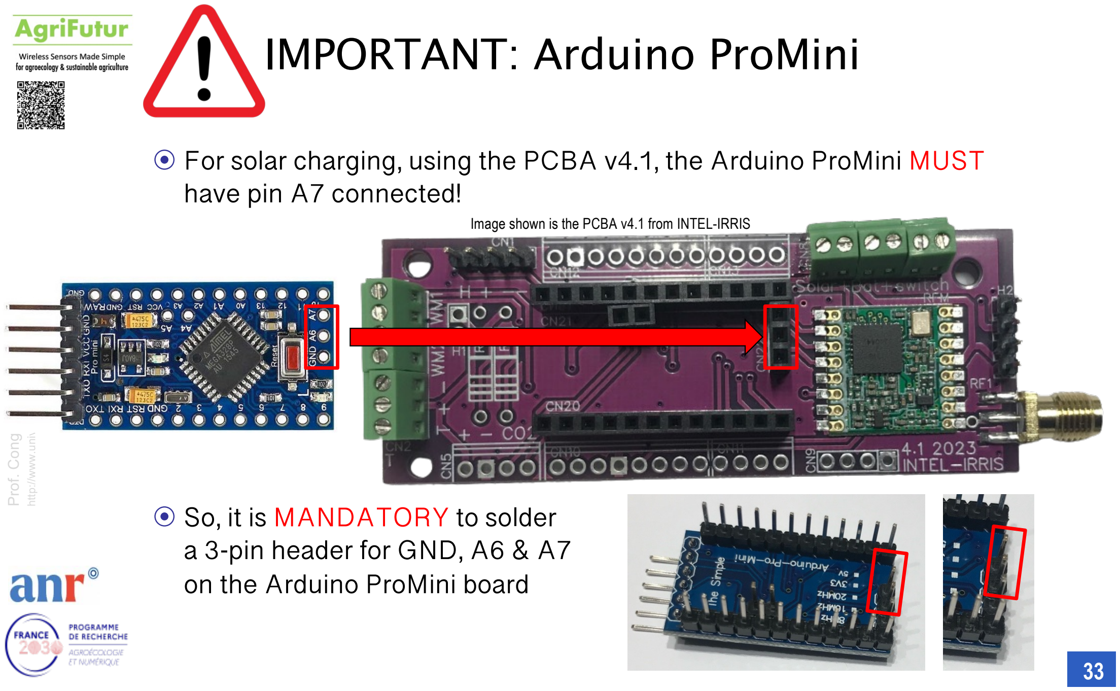
[picture p191: page 33]

Prof. Congduc Pham

http://www.univ-pau.fr/~cpham

33

⊙ For solar charging, using the PCBA v4.1, the Arduino ProMini MUST have pin A7 connected!

⊙ So, it is MANDATORY to solder a 3-pin header for GND, A6 & A7 on the Arduino ProMini board

Image shown is the PCBA v4.1 from INTEL-IRRIS

## Soil device with PCBA v4.1, final result

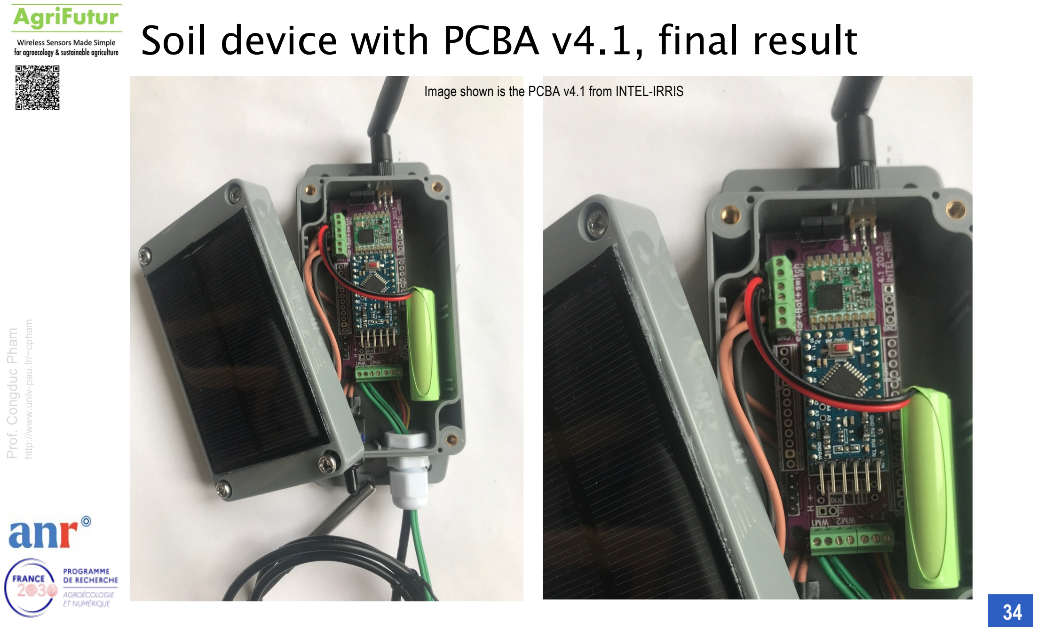
[picture p192: page 34]

Prof. Congduc Pham

http://www.univ-pau.fr/~cpham

34

Image shown is the PCBA v4.1 from INTEL-IRRIS

## Using 3xAAA batteries

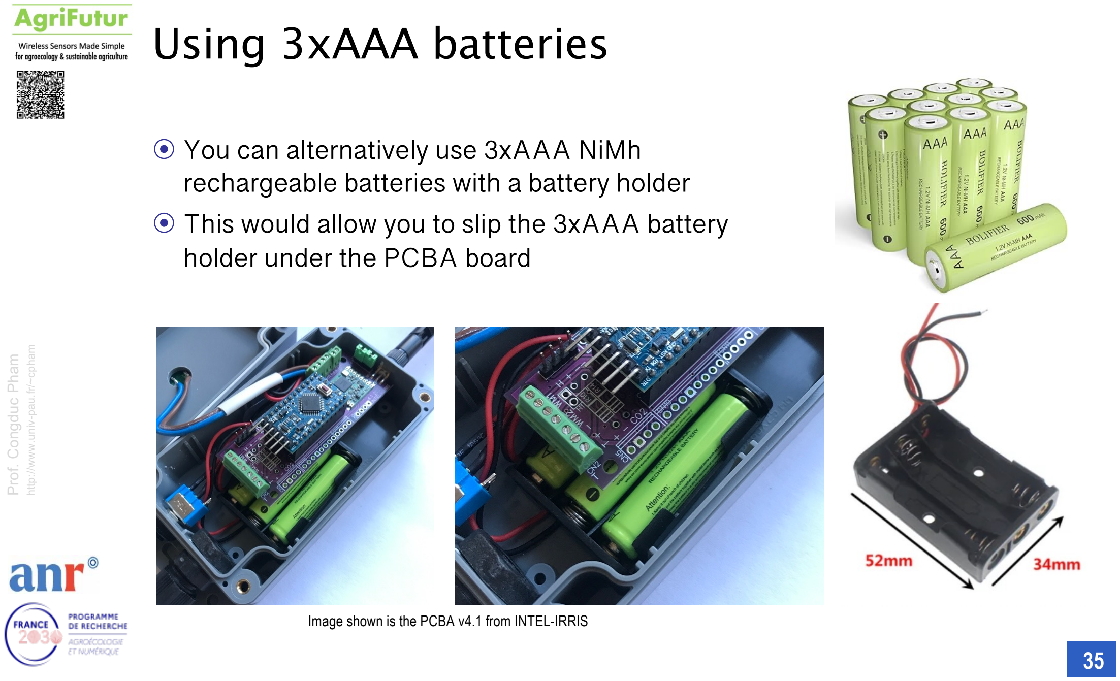
[picture p193: page 35]

Prof. Congduc Pham

http://www.univ-pau.fr/~cpham

35

⊙ You can alternatively use 3xAAA NiMh rechargeable batteries with a battery holder
⊙ This would allow you to slip the 3xAAA battery holder under the PCBA board

Image shown is the PCBA v4.1 from INTEL-IRRIS

Prof. Congduc Pham

http://www.univ-pau.fr/~cpham

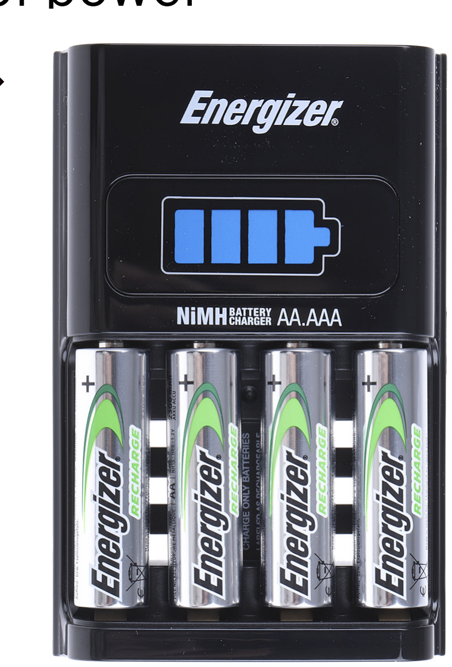
[picture p194: figure]

36

## Externally charging NiMH batteries (1)

⊙ Normally, the solar panel should charge the NiMH batteries during the day, with sufficient power for regular operation of the device
⊙ However, if the device has been stored for a long period in the dark, the battery charge level may have dropped too much
⊙ In this case, it will need to be charged by an external source of power ⊙ If you are using 3xAAA NiMh rechargeable batteries
with a battery holder, it is straightforward to charge the
individual AAA batteries with an NiMh battery charger
⊙ If you are using a 3xAAA battery pack,
you can directly use the PCBA to charge
the pack as described
in the next slide

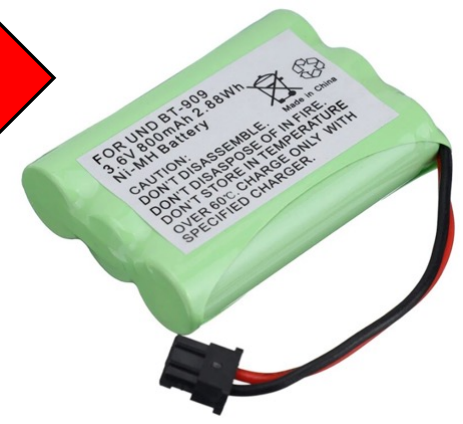
[picture p195: figure]
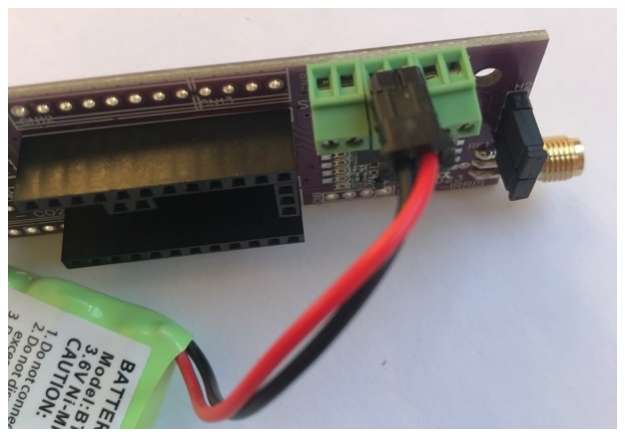
[picture p196: figure]

Image shown is the PCBA v4.1 from INTEL-IRRIS

## Externally charging NiMH batteries (2)

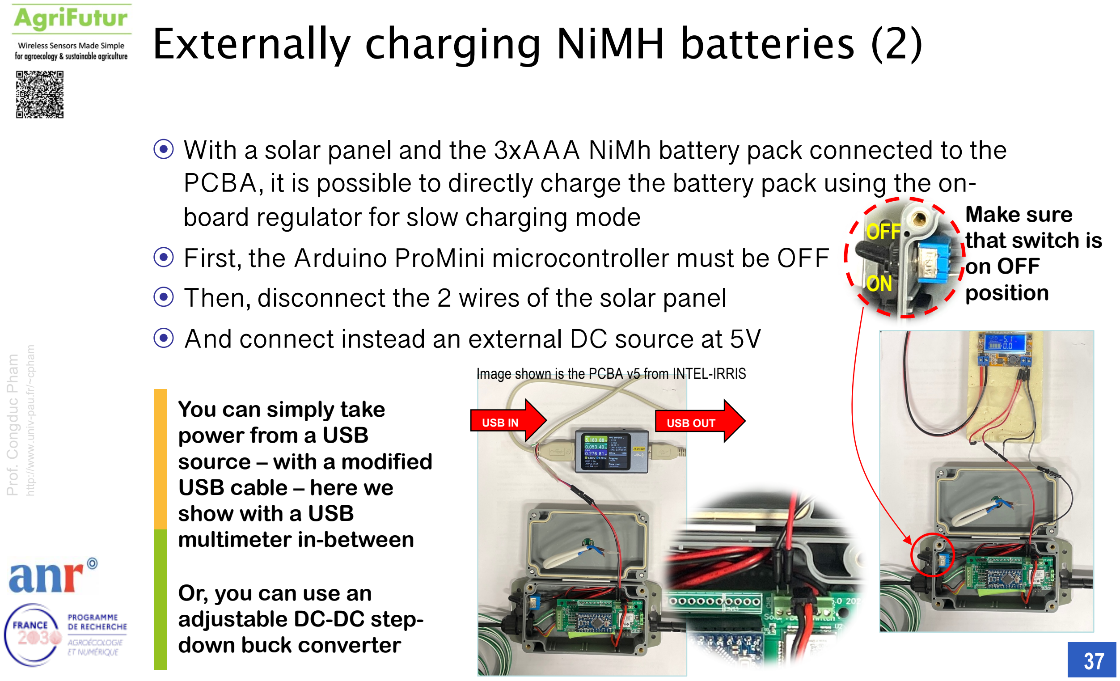
[picture p197: page 37]

Prof. Congduc Pham

http://www.univ-pau.fr/~cpham

37

⊙ With a solar panel and the 3xAAA NiMh battery pack connected to the PCBA, it is possible to directly charge the battery pack using the on-board regulator for slow charging mode
⊙ First, the Arduino ProMini microcontroller must be OFF
⊙ Then, disconnect the 2 wires of the solar panel
⊙ And connect instead an external DC source at 5V

You can simply take
power from a USB
source – with a modified
USB cable – here we
show with a USB
multimeter in-between

Or, you can use an
adjustable DC-DC step-down buck converter
USB IN | USB OUT

Make sure
that switch is
on OFF
position

Image shown is the PCBA v5 from INTEL-IRRIS

OFF

ON

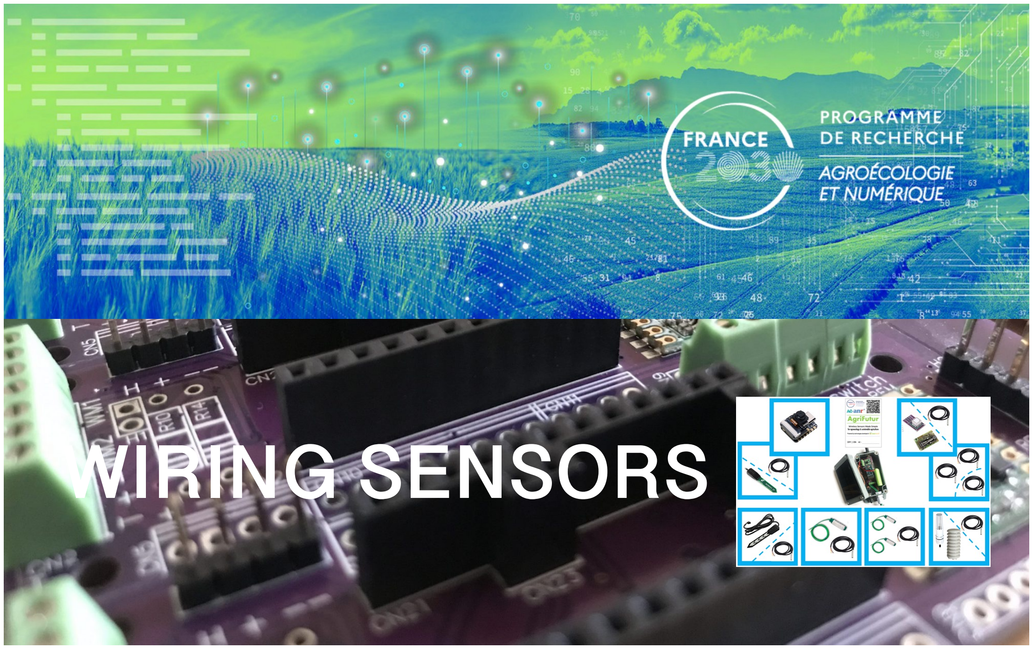
[picture p198: page 38]

# WIRING SENSORS

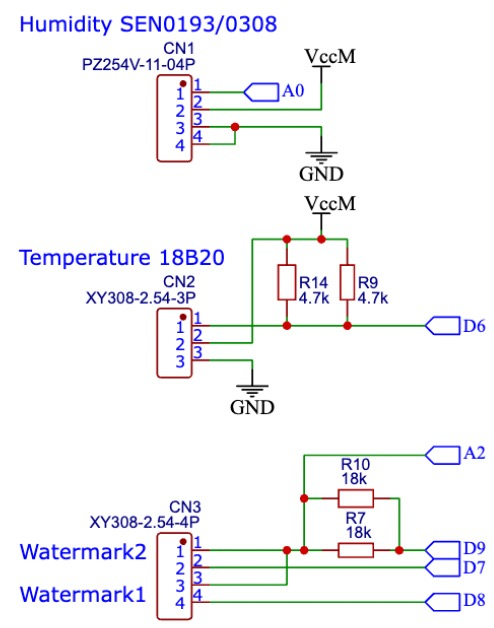
[picture p199: figure]
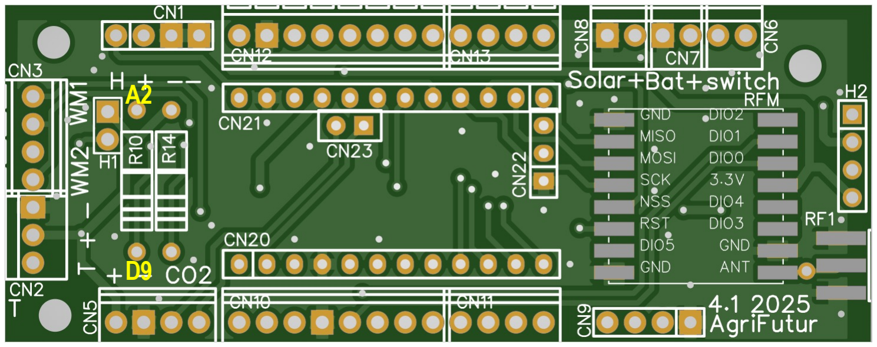
[picture p200: figure]

Prof. Congduc Pham

http://www.univ-pau.fr/~cpham

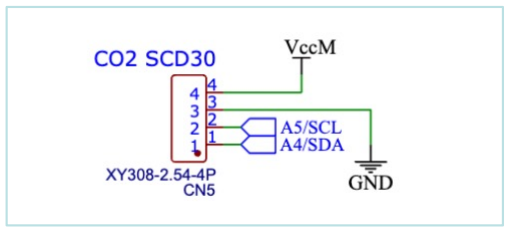
[picture p201: figure]

39

## PCB/PCBA v4.1 pin description

⊙ The PCB has the following pre-defined wiring to Arduino ProMini pin
https://github.com/CongducPham/PEPR_AgriFutur/blob/main/PCBs/IRD_PCB_4_1/Schematic_IISS_4_1_2023-09-27.pdf

D6

D8
A2
D7
A2

A0

A5 A4

## Wiring sensors with PCB/PCBA v4.1

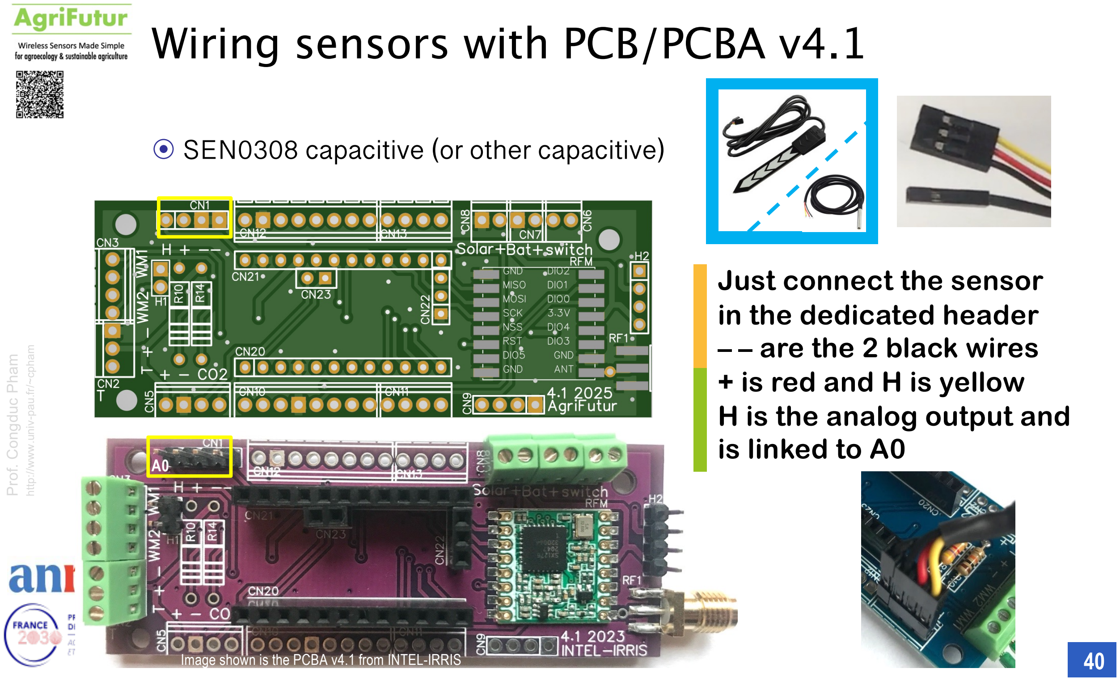
[picture p202: page 40]

Prof. Congduc Pham

http://www.univ-pau.fr/~cpham

40

⊙ SEN0308 capacitive (or other capacitive)

Just connect the sensor
in the dedicated header
– – are the 2 black wires
+ is red and H is yellow
H is the analog output and is linked to A0

Image shown is the PCBA v4.1 from INTEL-IRRIS

A0

## Wiring sensors on PCB/PCBA v4.1

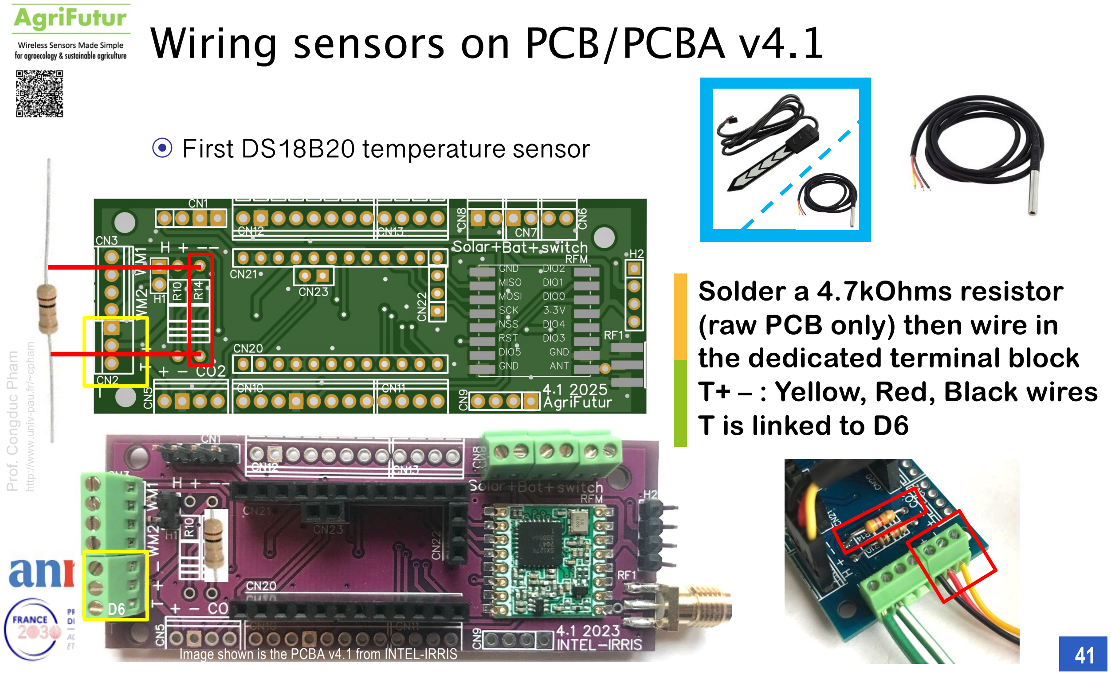
[picture p203: page 41]

Prof. Congduc Pham

http://www.univ-pau.fr/~cpham

41

⊙ First DS18B20 temperature sensor

Solder a 4.7kOhms resistor (raw PCB only) then wire in the dedicated terminal block T+ – : Yellow, Red, Black wires T is linked to D6

Image shown is the PCBA v4.1 from INTEL-IRRIS

D6

## Wiring sensors on PCB/PCBA v4.1

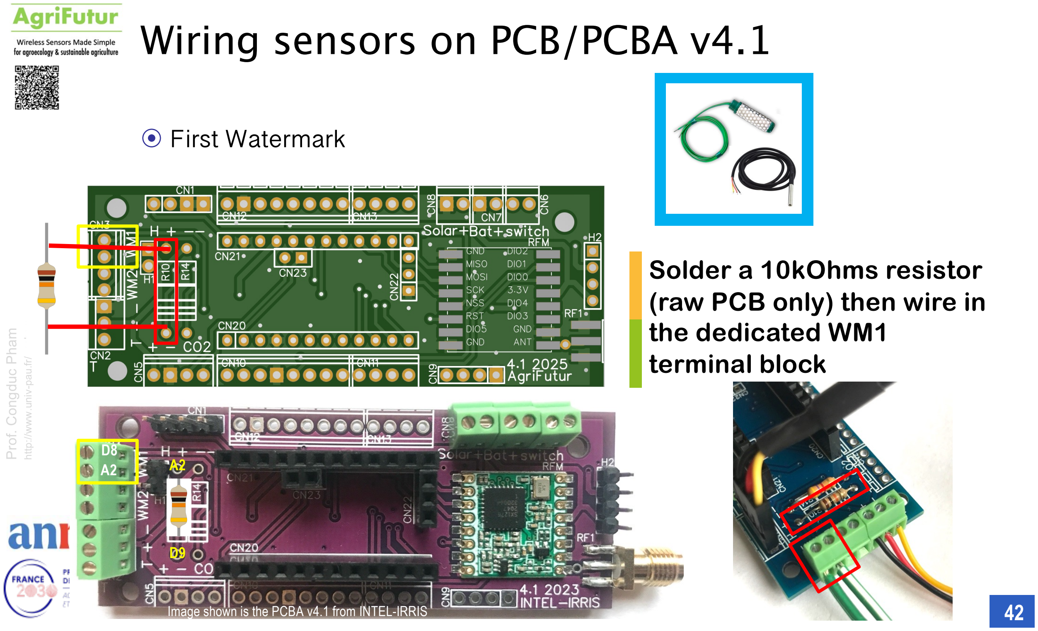
[picture p204: page 42]

Prof. Congduc Pham

http://www.univ-pau.fr/~cpham

42

⊙ First Watermark

Solder a 10kOhms resistor
(raw PCB only) then wire in the dedicated WM1
terminal block

Image shown is the PCBA v4.1 from INTEL-IRRIS

D8
A2

D9

A2

## Wiring sensors on PCB/PCBA v4.1

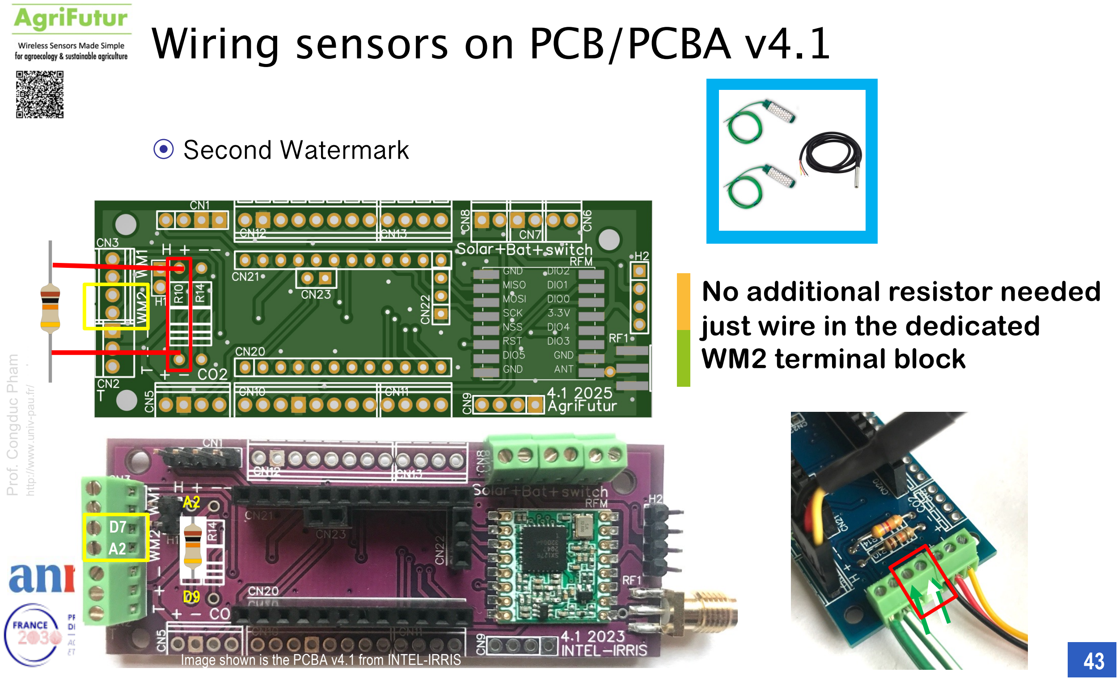
[picture p205: page 43]

Prof. Congduc Pham

http://www.univ-pau.fr/~cpham

43

⊙ Second Watermark

No additional resistor needed just wire in the dedicated WM2 terminal block

D7
A2

Image shown is the PCBA v4.1 from INTEL-IRRIS

D9

A2

## Wiring sensors on PCB/PCBA v4.1

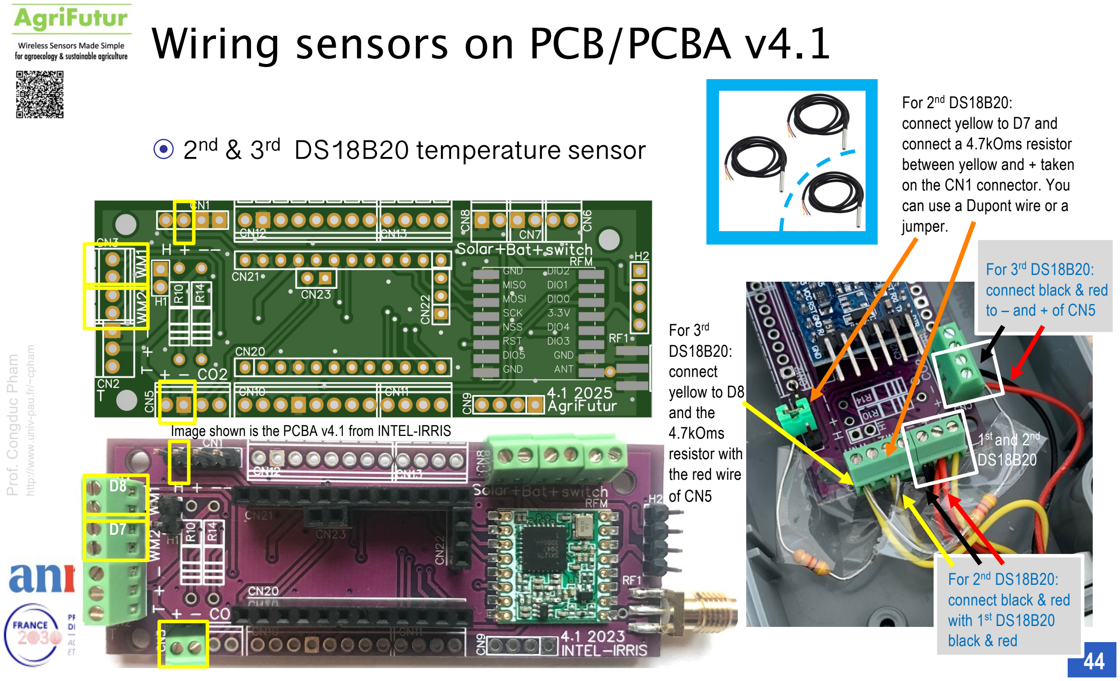
[picture p206: page 44]

Prof. Congduc Pham

http://www.univ-pau.fr/~cpham

44

⊙ 2nd & 3rd DS18B20 temperature sensor

Image shown is the PCBA v4.1 from INTEL-IRRIS | 1st and 2nd
DS18B20

For 2nd DS18B20:
connect black & red
with 1st DS18B20
black & red

For 2nd DS18B20:
connect yellow to D7 and
connect a 4.7kOms resistor between yellow and + taken on the CN1 connector. You
can use a Dupont wire or a jumper.

D7

D8

For 3rd DS18B20:
connect black & red
to – and + of CN5
For 3rd
DS18B20:
connect
yellow to D8
and the
4.7kOms
resistor with
the red wire
of CN5

## Wiring sensors on PCB/PCBA v4.1

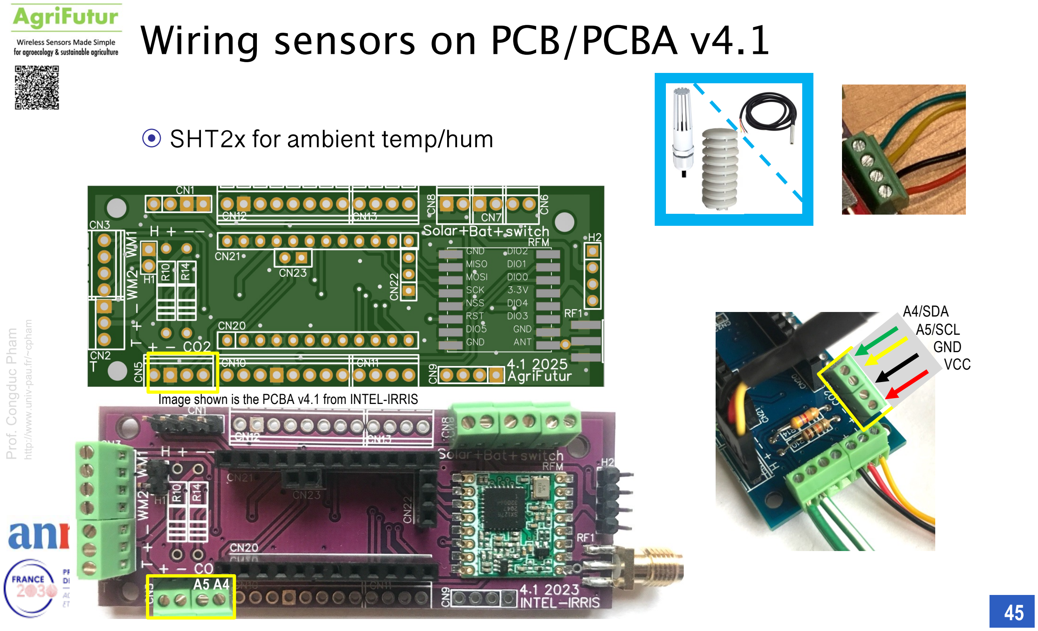
[picture p207: page 45]

Prof. Congduc Pham

http://www.univ-pau.fr/~cpham

45

⊙ SHT2x for ambient temp/hum

Image shown is the PCBA v4.1 from INTEL-IRRIS

A4/SDA
A5/SCL
GND
VCC

A5 A4

## Wiring sensors on PCB/PCBA v4.1

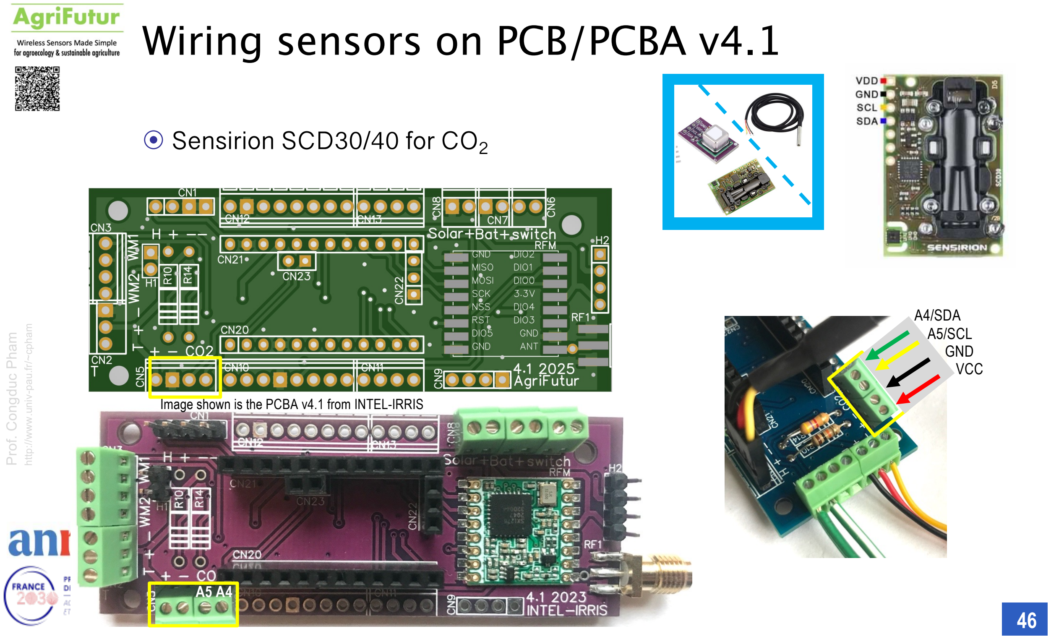
[picture p208: page 46]

Prof. Congduc Pham

http://www.univ-pau.fr/~cpham

46

⊙ Sensirion SCD30/40 for CO2

Image shown is the PCBA v4.1 from INTEL-IRRIS

A4/SDA
A5/SCL
GND
VCC

A5 A4

## IMPORTANT: Arduino ProMini

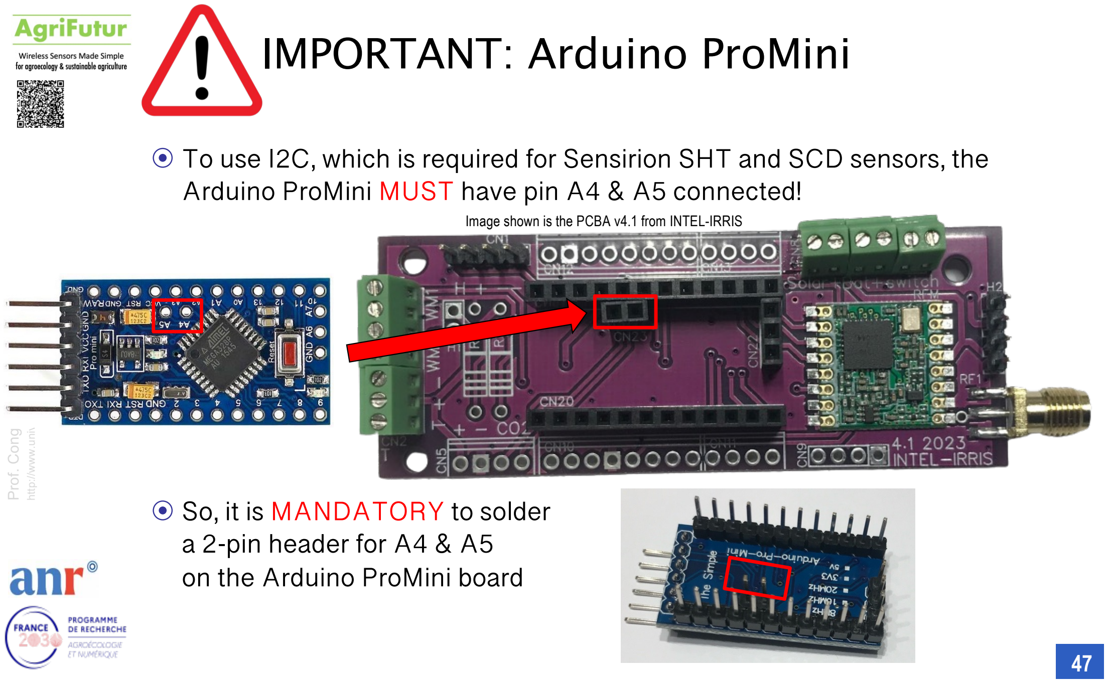
[picture p209: page 47]

Prof. Congduc Pham

http://www.univ-pau.fr/~cpham

47

⊙ To use I2C, which is required for Sensirion SHT and SCD sensors, the Arduino ProMini MUST have pin A4 & A5 connected!

⊙ So, it is MANDATORY to solder a 2-pin header for A4 & A5
on the Arduino ProMini board

Image shown is the PCBA v4.1 from INTEL-IRRIS

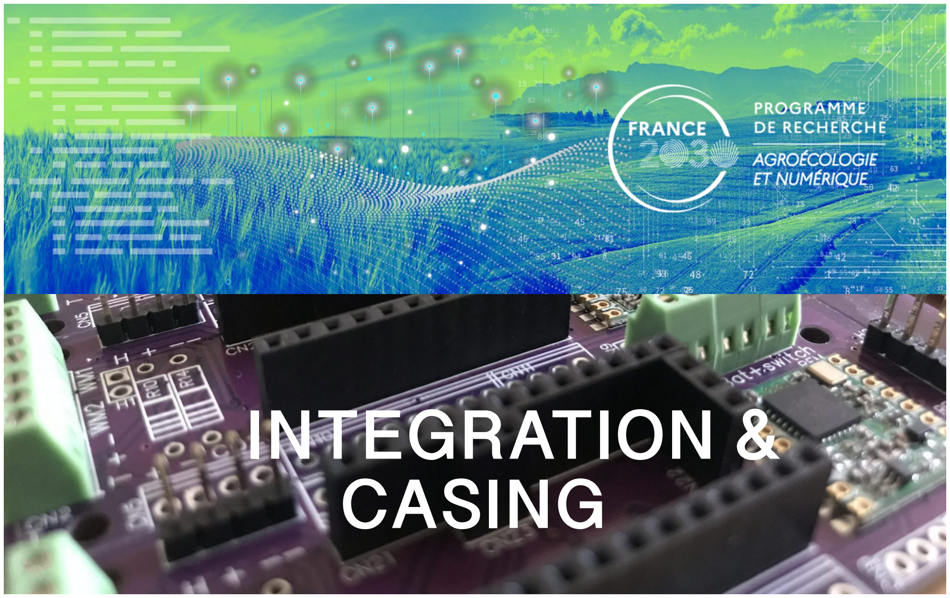
[picture p210: page 48]

# INTEGRATION & CASING

Prof. Congduc Pham

http://www.univ-pau.fr/~cpham

49

## Get an enclosure for outdoor usage

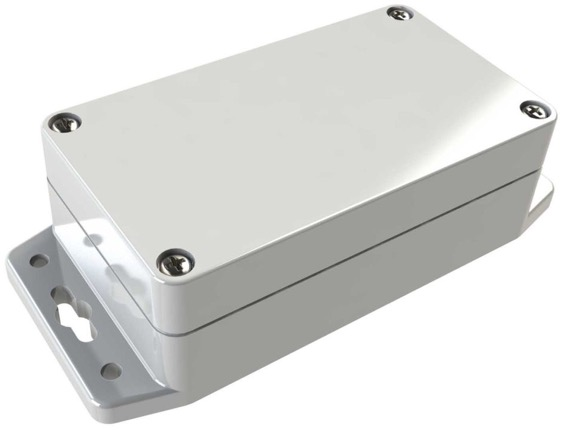
[picture p211: figure]

Here, it is an IP65 box which dimension is 115 x 65 x 40mm https://www.gotronic.fr/art-boitier-abs-etanche-g304m-17977.htm

## Drilling machine and drilling bits

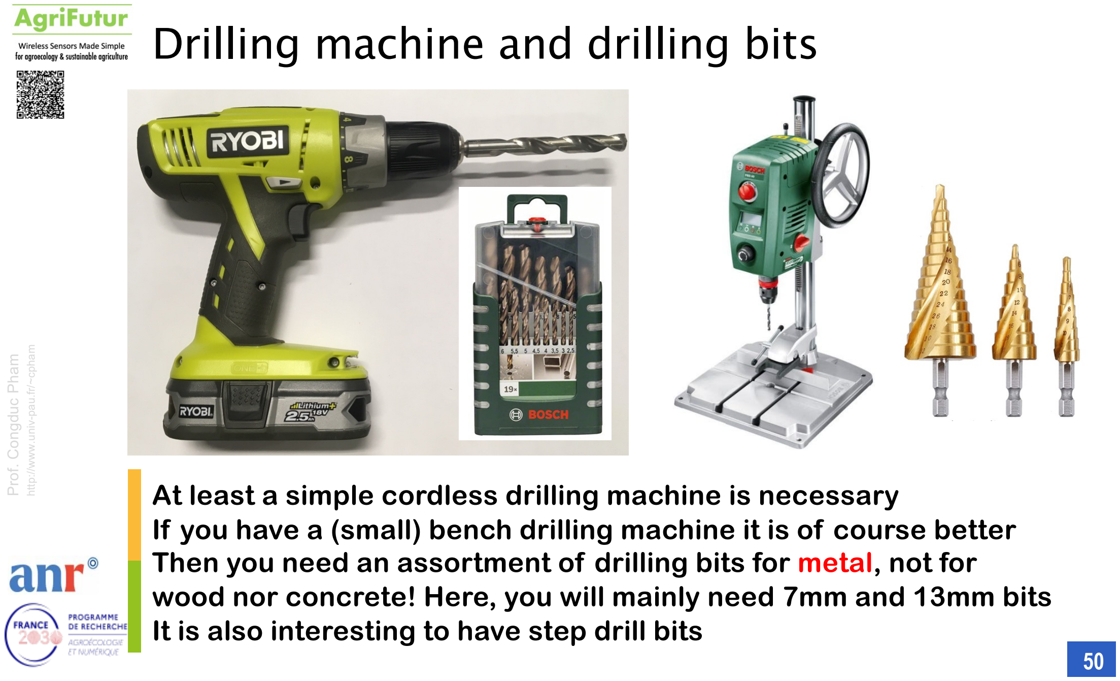
[picture p212: page 50]

Prof. Congduc Pham

http://www.univ-pau.fr/~cpham

50

At least a simple cordless drilling machine is necessary
If you have a (small) bench drilling machine it is of course better Then you need an assortment of drilling bits for metal, not for wood nor concrete! Here, you will mainly need 7mm and 13mm bits It is also interesting to have step drill bits

## Drill a hole for the SMA connector

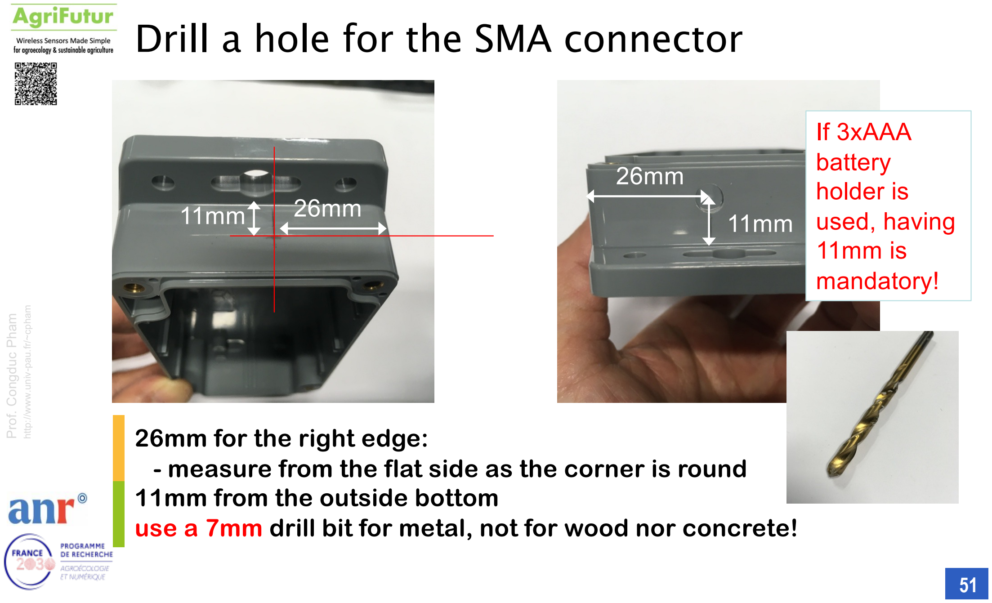
[picture p213: page 51]

Prof. Congduc Pham

http://www.univ-pau.fr/~cpham

51

26mm for the right edge:
- measure from the flat side as the corner is round 11mm from the outside bottom
use a 7mm drill bit for metal, not for wood nor concrete!

11mm 26mm

26mm
11mm

If 3xAAA
battery
holder is
used, having
11mm is
mandatory!

Prof. Congduc Pham

http://www.univ-pau.fr/~cpham

52

## Placing the PCB board

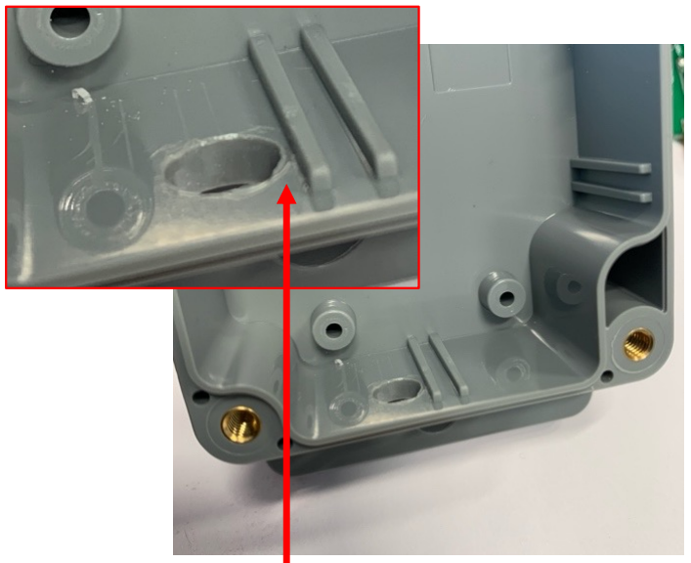
[picture p214: figure]
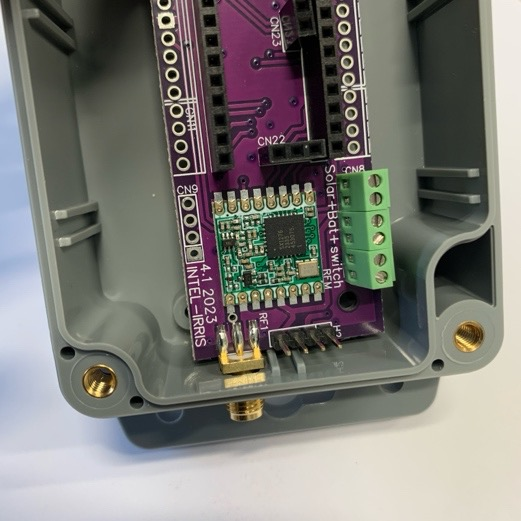
[picture p215: figure]

With this particular enclosure case, it is
better to have the hole about 1mm next to
the plastic reinforcement part

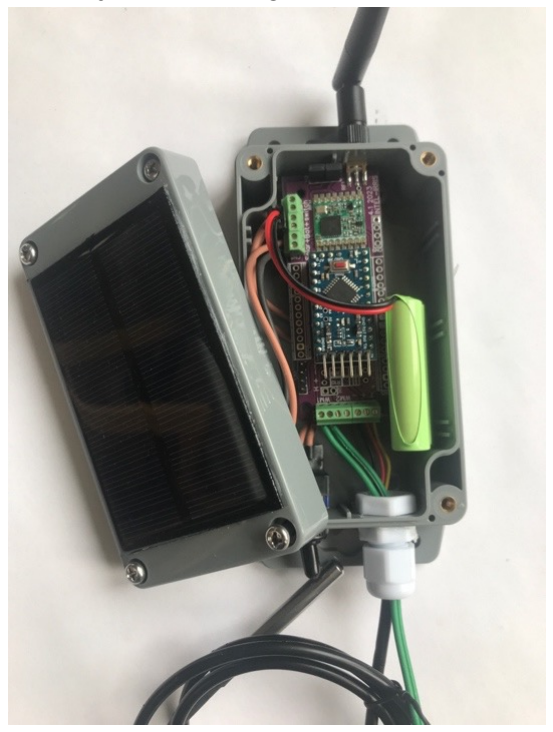
[picture p216: figure]

The board can be placed with the SMA connector going through the hole. The 2-AA battery holder is put next to the PCB

Image shown is the PCBA v4.1 from INTEL-IRRIS

Prof. Congduc Pham

http://www.univ-pau.fr/~cpham

53

## Drill a hole for the external power switch

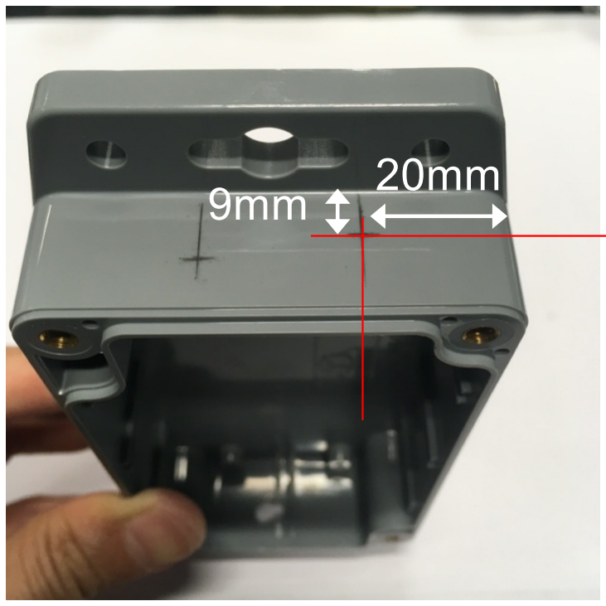
[picture p217: figure]

20mm for the right edge:

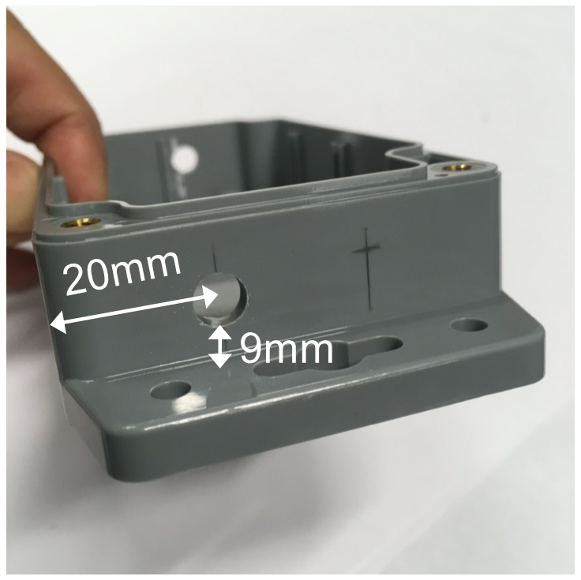
[picture p218: figure]

- measure from the flat side as the corner is round 9mm from the outside bottom
use a 7mm drill bit for metal

## Drill a hole for the cable gland

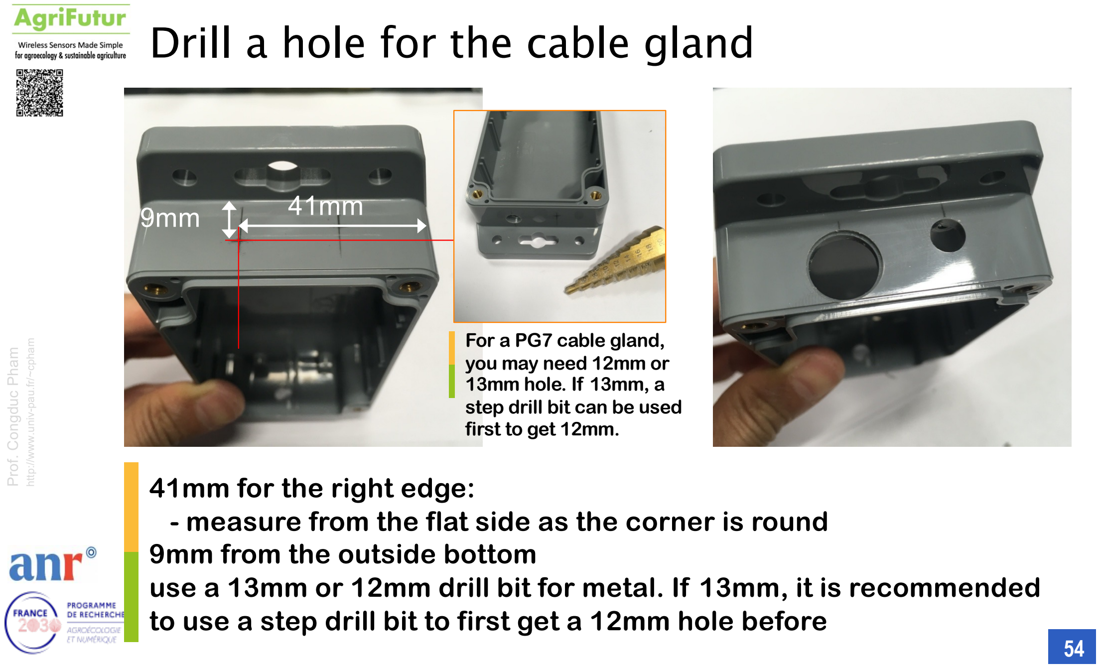
[picture p219: page 54]

Prof. Congduc Pham

http://www.univ-pau.fr/~cpham

54

41mm 9mm

For a PG7 cable gland,
you may need 12mm or
13mm hole. If 13mm, a
step drill bit can be used first to get 12mm.

41mm for the right edge:
- measure from the flat side as the corner is round
9mm from the outside bottom
use a 13mm or 12mm drill bit for metal. If 13mm, it is recommended to use a step drill bit to first get a 12mm hole before

Prof. Congduc Pham

http://www.univ-pau.fr/~cpham

55

## Remove unwanted plastic part

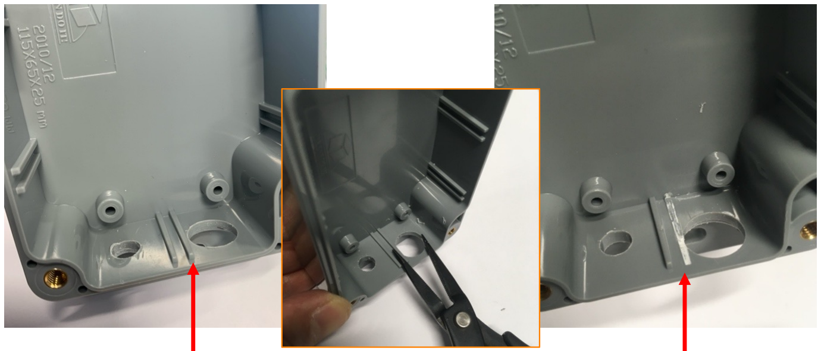
[picture p220: figure]
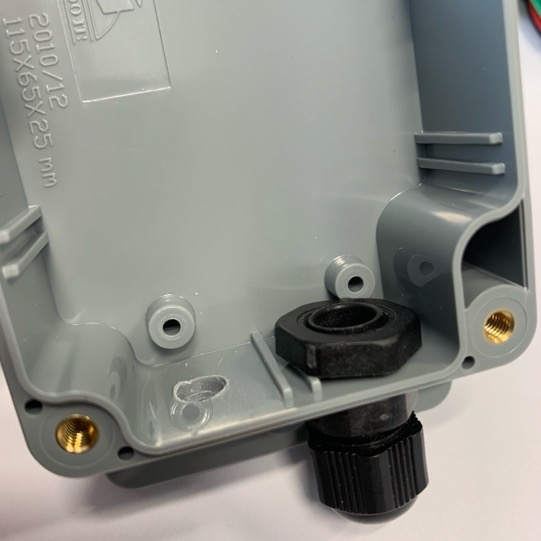
[picture p221: figure]

It may be needed to remove the plastic reinforcement part for this particular enclosure: use a flat cutter for instance to remove and smooth the inside part (a small plier can be used first to remove most of the part)

But that may be not necessary if you can securely screw in the cable gland (right-most photo)

Prof. Congduc Pham

http://www.univ-pau.fr/~cpham

56

## Going for larger production

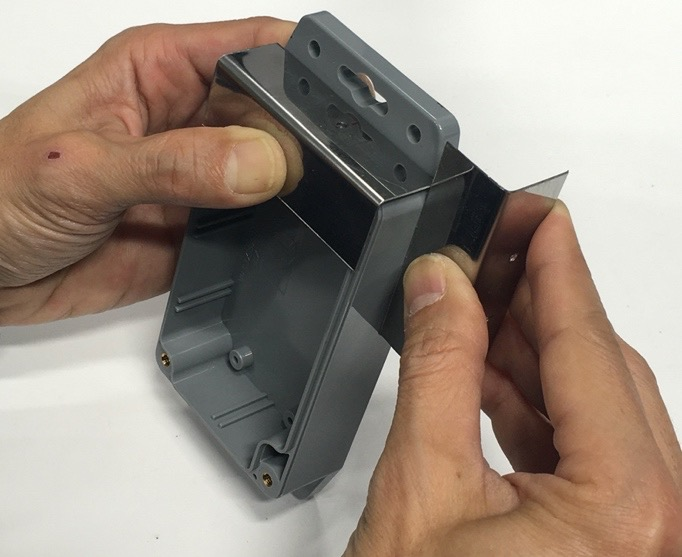
[picture p222: figure]
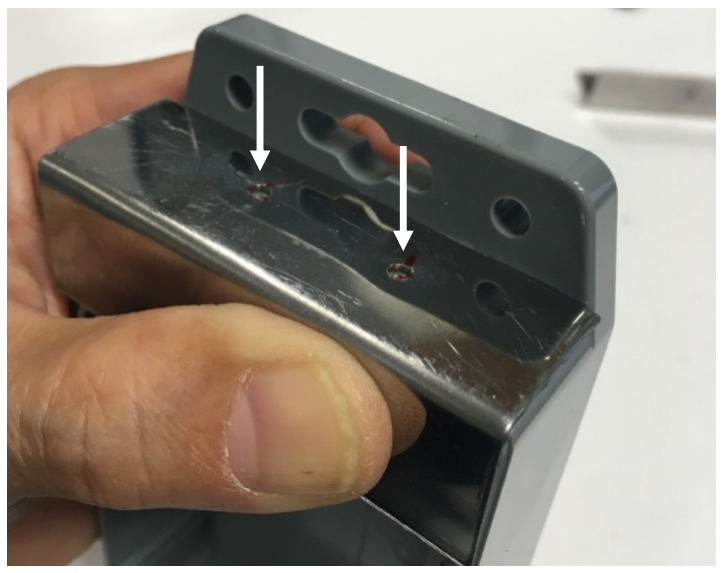
[picture p223: figure]

If you need to prepare many enclosures, it may be faster to first make an assembly jig (here a piece of metal) for marking the holes

But be sure to precisely align the edge of the jig with the edge of the enclosure

## Placing power switch and cable gland

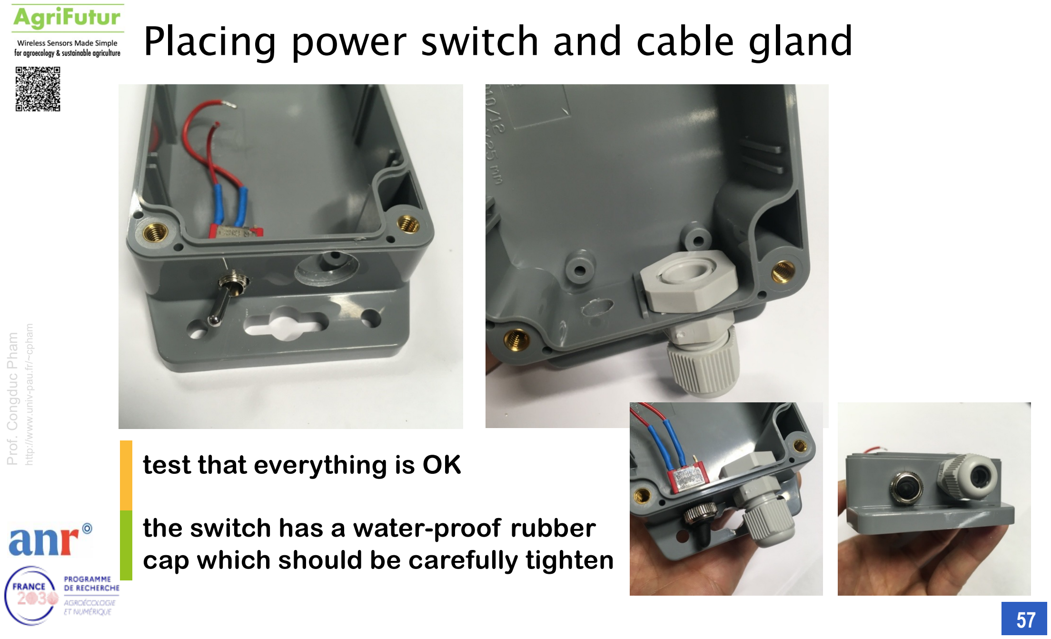
[picture p224: page 57]

Prof. Congduc Pham

http://www.univ-pau.fr/~cpham

57

test that everything is OK

the switch has a water-proof rubber cap which should be carefully tighten

## Connecting antenna

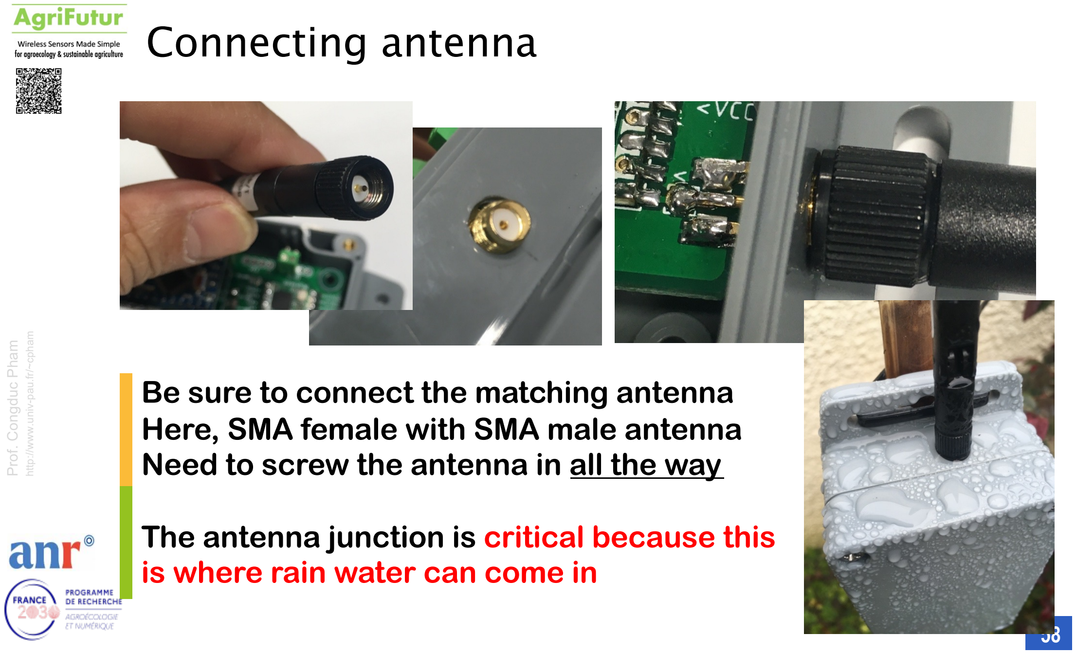
[picture p225: page 58]

Prof. Congduc Pham

http://www.univ-pau.fr/~cpham

58

Be sure to connect the matching antenna Here, SMA female with SMA male antenna Need to screw the antenna in all the way

The antenna junction is critical because this is where rain water can come in

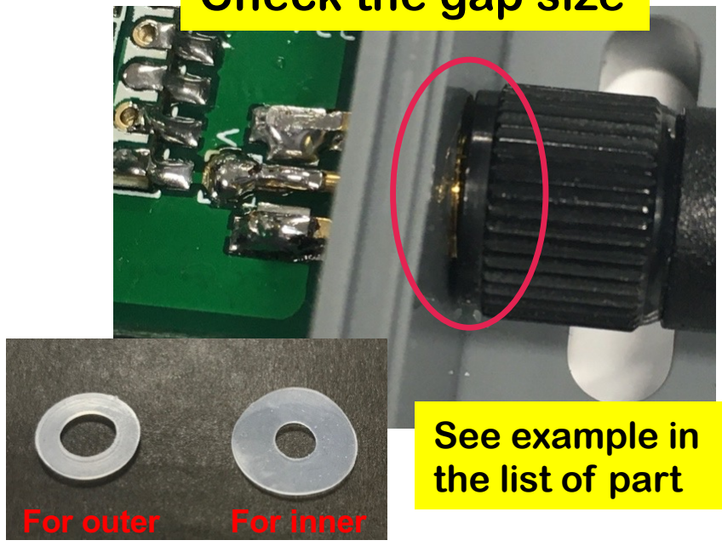
[picture p226: figure]
See example in the list of part; For inner; For outer

Prof. Congduc Pham

http://www.univ-pau.fr/~cpham

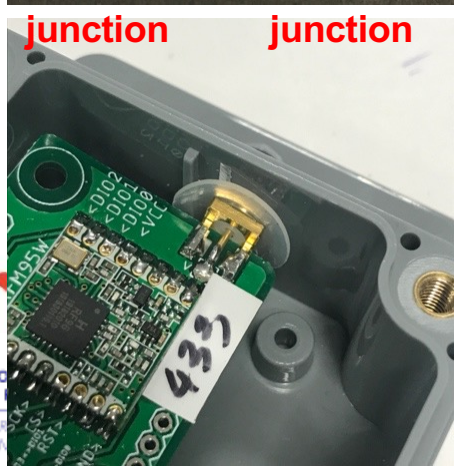
[picture p227: figure]
junction
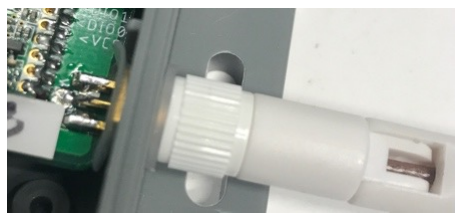
[picture p228: figure]

59

## Waterproofing the antenna junction

Even when the antenna is
screwed in all the way, there might still be a gap

Even with no apparent gap, it is necessary to waterproof the junction

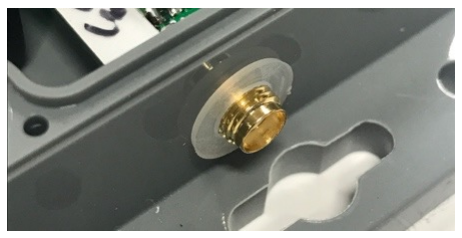
[picture p229: figure]

Take flat silicon seals for that purpose, but do not take it too thick or too large!

Too thick: the antenna will not be screwed in all the way!

Check the gap size

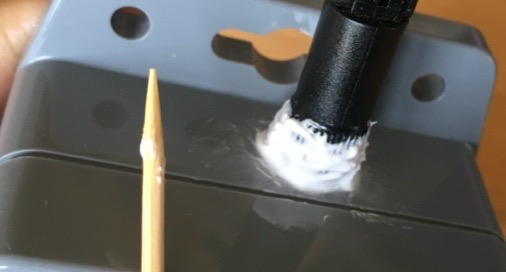
[picture p230: figure]

Prof. Congduc Pham

http://www.univ-pau.fr/~cpham

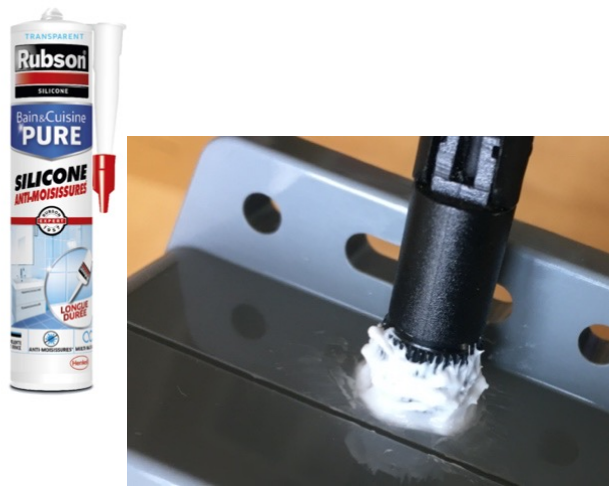
[picture p231: figure]
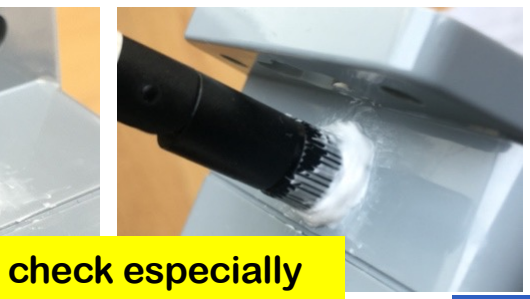
[picture p232: figure]
check especially

60

## Do not have or can not use flat seal ?

Maybe the gap is too big? Use
silicon joint sealant

First, screw in the antenna all the way

Put small amount of silicon around the antenna junction (use a flat screw driver or other flat tool)

Use a wet toothpick to finish and clean the silicon all around the antenna junction

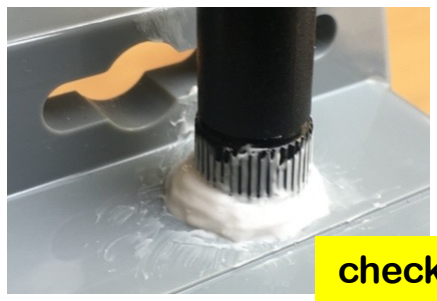
[picture p233: figure]

the back side

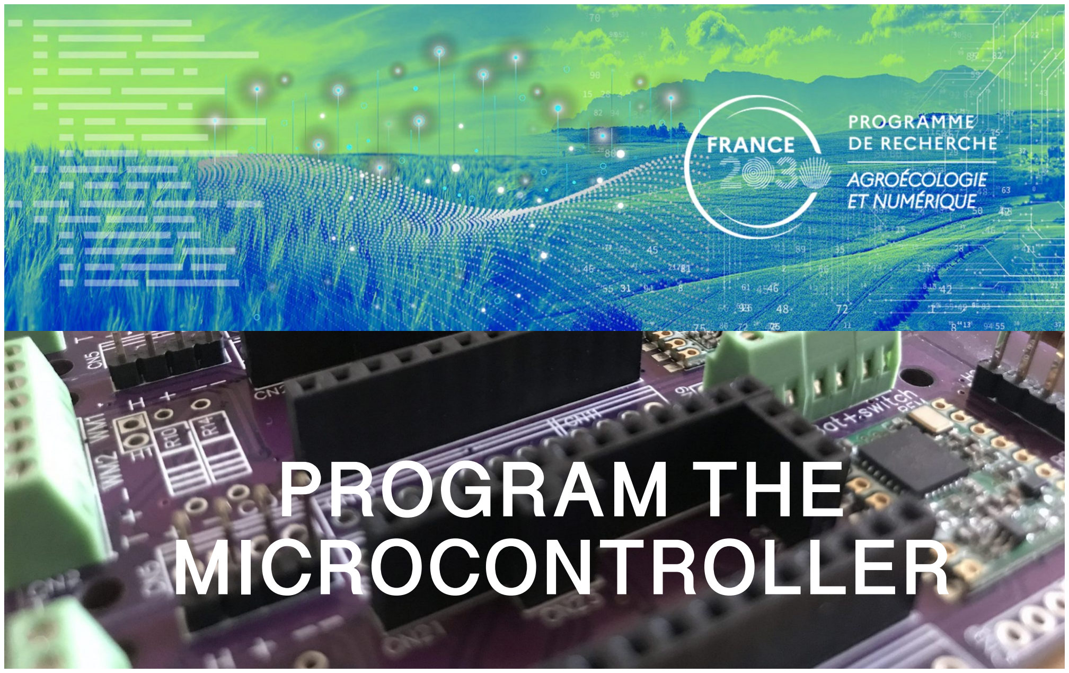
[picture p234: page 61]

# PROGRAM THE MICROCONTROLLER

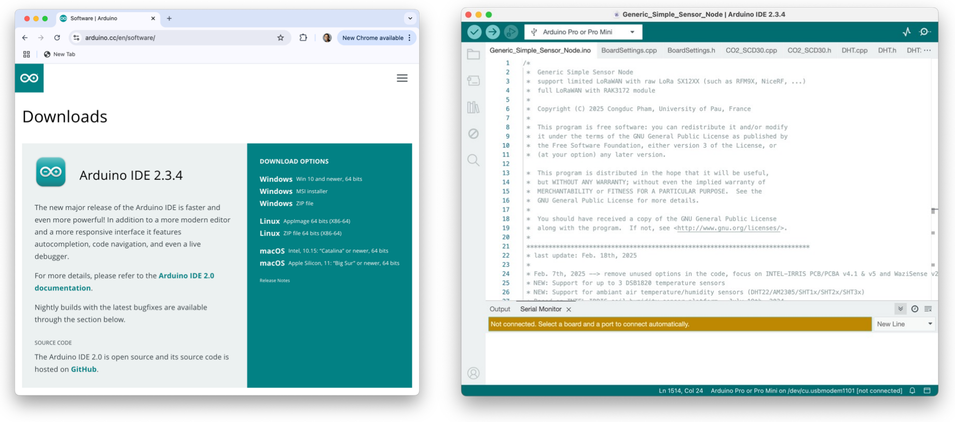
[picture p235: figure]

Prof. Congduc Pham

http://www.univ-pau.fr/~cpham

62

## Getting the software: Arduino IDE

Install latest version of Arduino IDE from https://www.arduino.cc/en/software

Prof. Congduc Pham

http://www.univ-pau.fr/~cpham

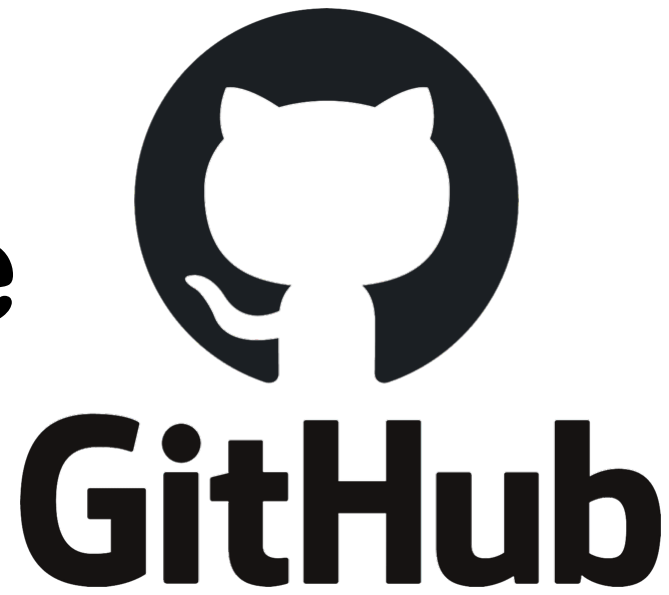
[picture p236: figure]

63

## Getting the AgriFutur code

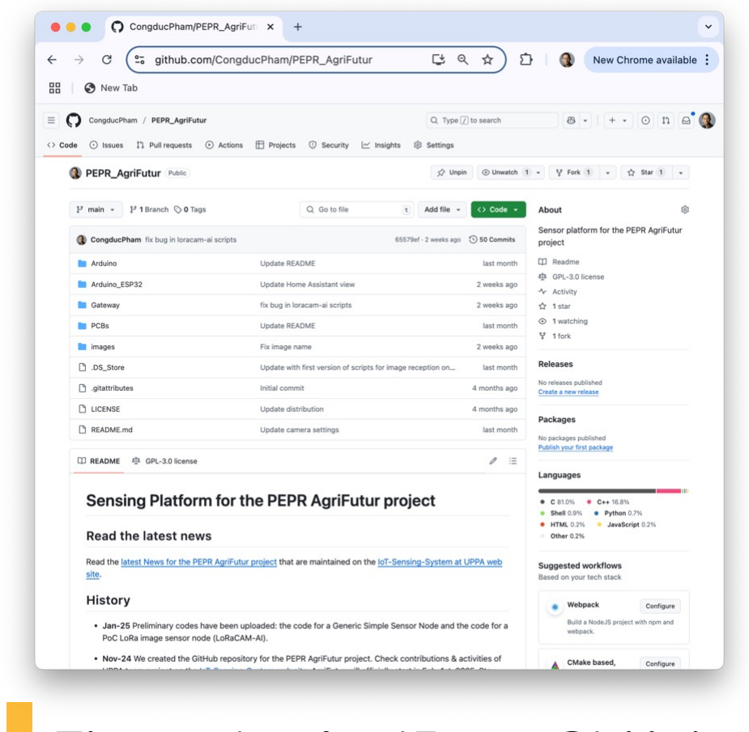
[picture p237: figure]

The entire AgriFutur GitHub repository is hosted here https://github.com/CongducPham/PEPR_AgriFutur

On your computer, create a sketch folder

Then download the whole
repository as ZIP file

Unzip the file and copy the content of Arduino folder
into your sketch folder

With the librairies folder

Prof. Congduc Pham

http://www.univ-pau.fr/~cpham

64

## Setting your Arduino IDE

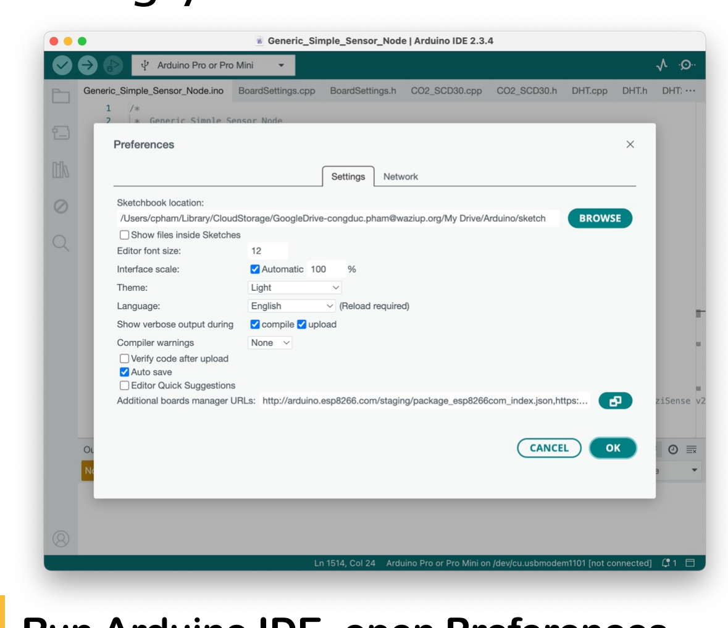
[picture p238: figure]

Run Arduino IDE, open Preferences
Indicate your sketch folder in Sketchbook location

Prof. Congduc Pham

http://www.univ-pau.fr/~cpham

65

## Configuration for PCB/PCBA v4.1

⊙ For raw version, uncomment IRD_PCB in BoardSettings.h ⊙ For PCBA version, also uncomment IRD_PCBA

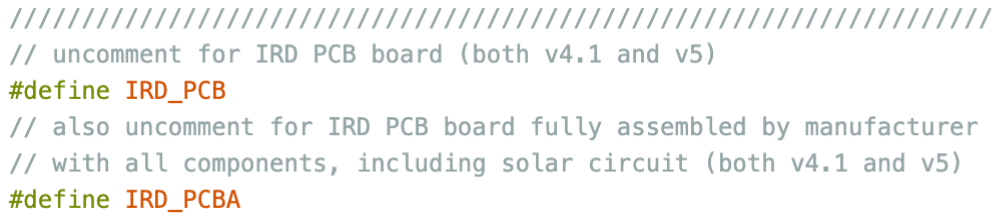
[picture p239: figure]

⊙ ONLY for solar version, uncomment SOLAR_BAT

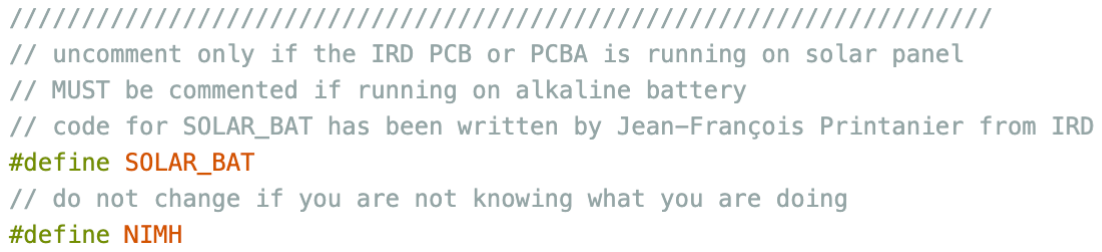
[picture p240: figure]

## Compiling the soil sensor code

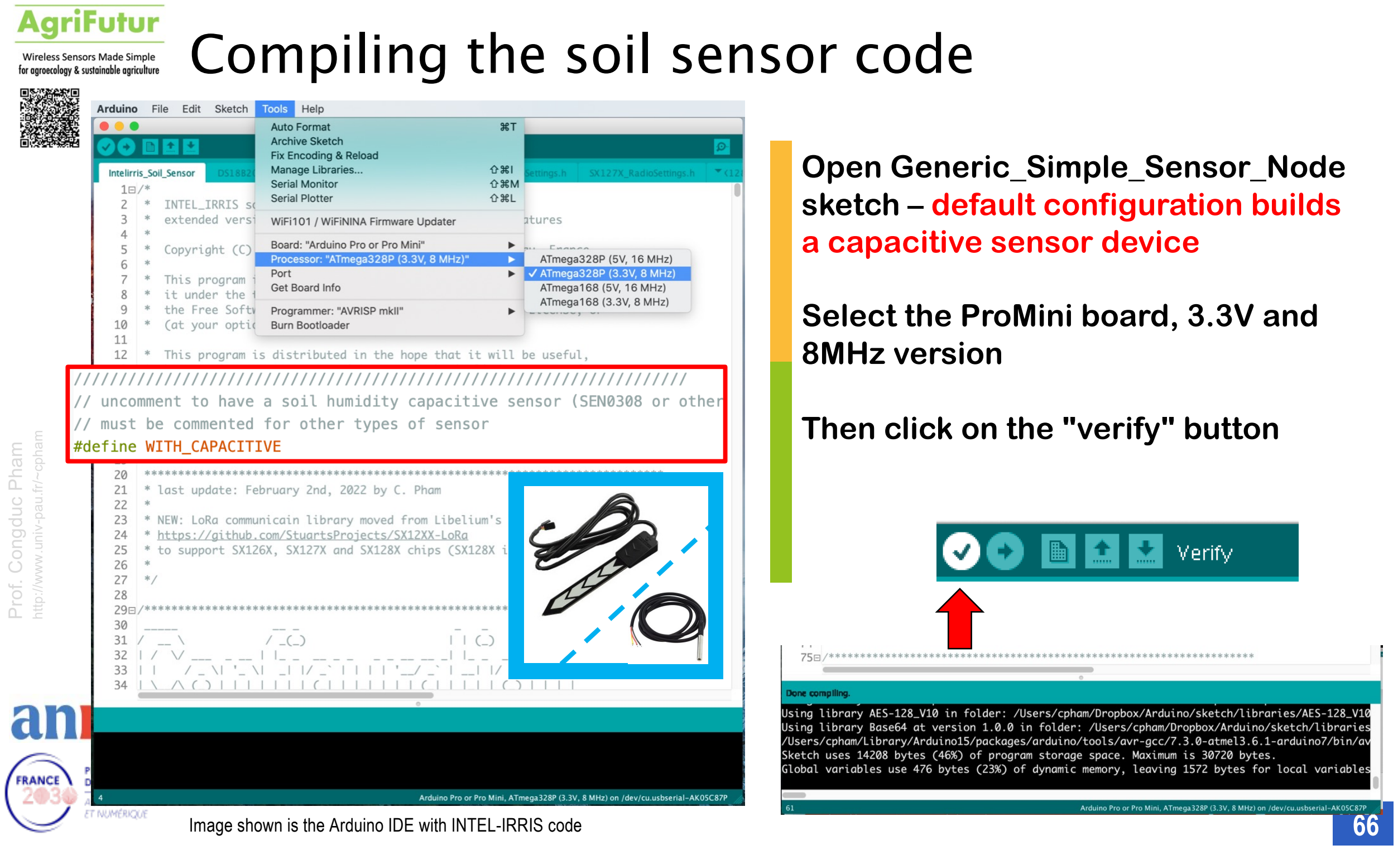
[picture p241: page 66]

Prof. Congduc Pham

http://www.univ-pau.fr/~cpham

66

Open Generic_Simple_Sensor_Node sketch – default configuration builds a capacitive sensor device

Select the ProMini board, 3.3V and 8MHz version

Then click on the "verify" button

Image shown is the Arduino IDE with INTEL-IRRIS code

Prof. Congduc Pham

http://www.univ-pau.fr/~cpham

67

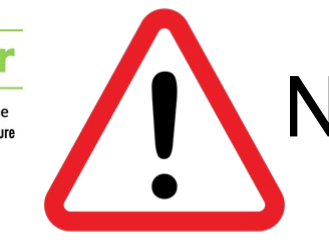
[picture p242: figure]

## Never transmit without antenna

⊙ NEVER, NEVER transmit without an antenna
⊙ Doing so can damage the radio module
⊙ If your board is already connected to the radio module and you need to flash the board, then connect the antenna
⊙ If you need to update the existing code and your device already run a code that transmit data, connect the antenna
⊙ It is safer when programming the device to remove the Arduino board from the female header and program it disconnected from the radio module
⊙ If you deploy a device, make sure that the antenna is correctly connected before powering on the device and realizing any transmission test

Prof. Congduc Pham

http://www.univ-pau.fr/~cpham

68

## Connecting with an FTDI cable

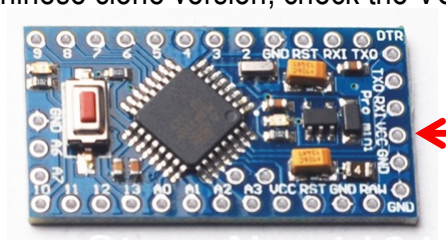
[picture p243: figure]
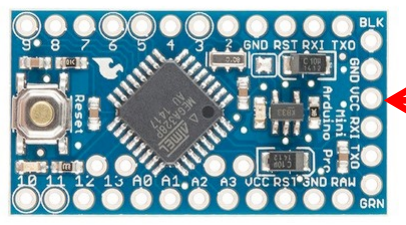
[picture p244: figure]

Original Sparkfun
version

Most Chinese clone version, check the VCC pin

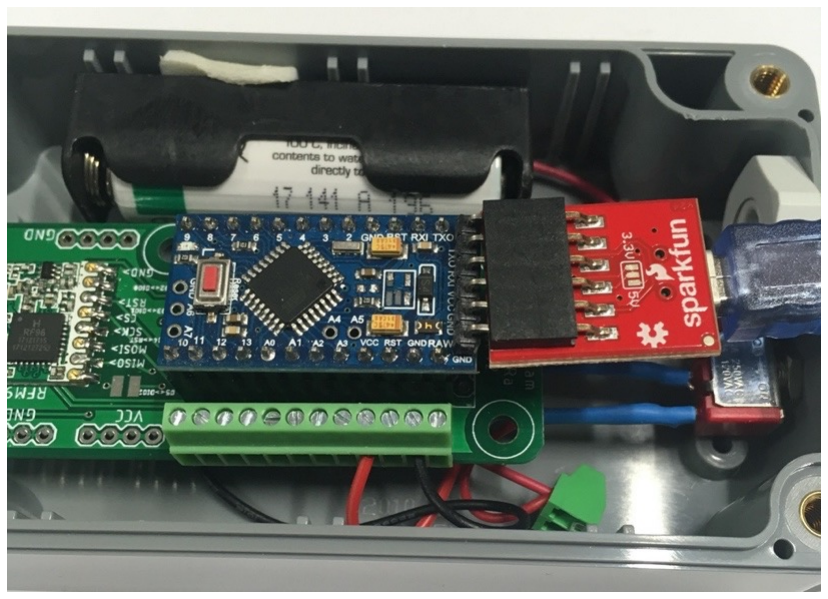
[picture p245: figure]
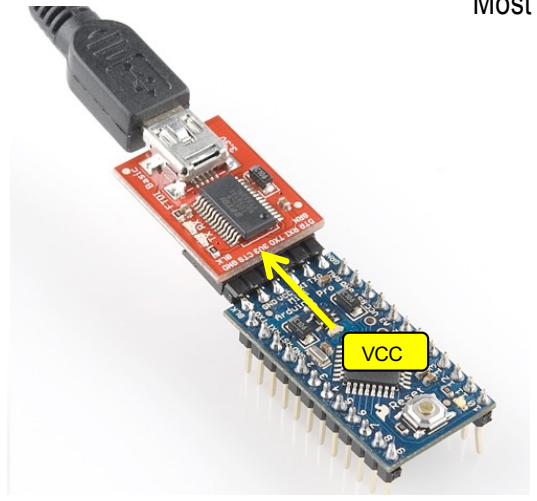
[picture p246: figure]
VCC

For the ProMini, you need to have an FTDI breakout cable working at 3.3v

Check the VCC pin position and make it to correspond to the VCC pin of the FTDI breakout.

Prof. Congduc Pham

http://www.univ-pau.fr/~cpham

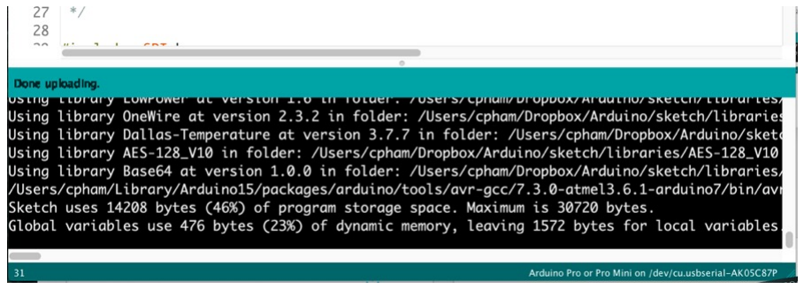
[picture p247: figure]

69

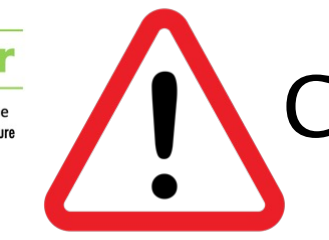
[picture p248: figure]

## Check the Arduino board

⊙ First, just solder the programming header

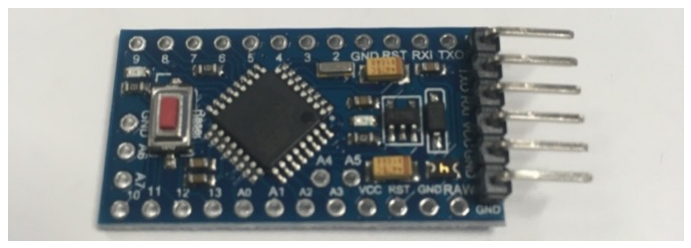
[picture p249: figure]
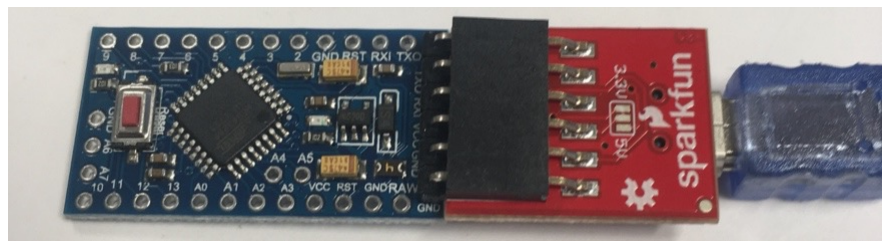
[picture p250: figure]

⊙ To flash the Arduino board with the AgriFutur code
⊙ See slides from "Getting the software: Arduino IDE" to "Uploading to your board"
⊙ If uploading is successful, then you
can continue with soldering the
remaining header pins, otherwise, take another board as this one may have hardware issue

Prof. Congduc Pham

http://www.univ-pau.fr/~cpham

70

## Select serial port for uploading

After connecting the cable to your computer/laptop USB
port, try to find the serial port

If you don't find it, you may need to install specific drivers

https://learn.sparkfun.com/tutorials/how-to-install-ch340-drivers/all (https://learn.sparkfun.com/tutorials/how-to-install-ch340-drivers/all)

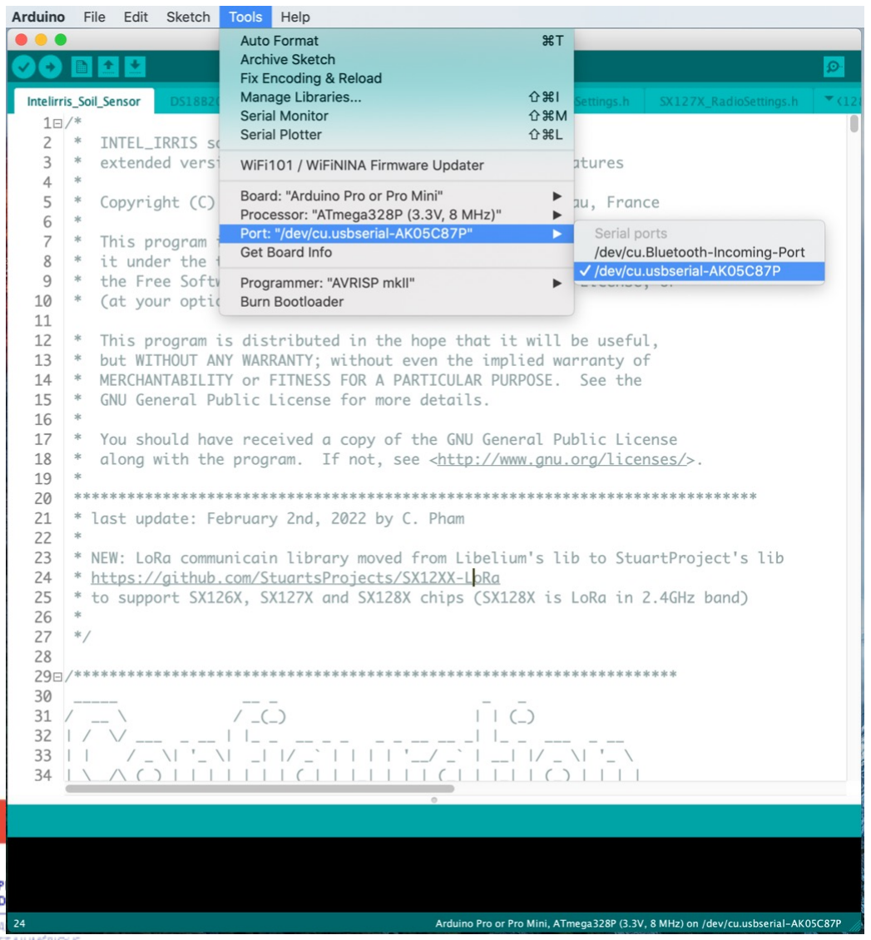
[picture p251: figure]

Image shown is the Arduino IDE with INTEL-IRRIS code

## Uploading to your board

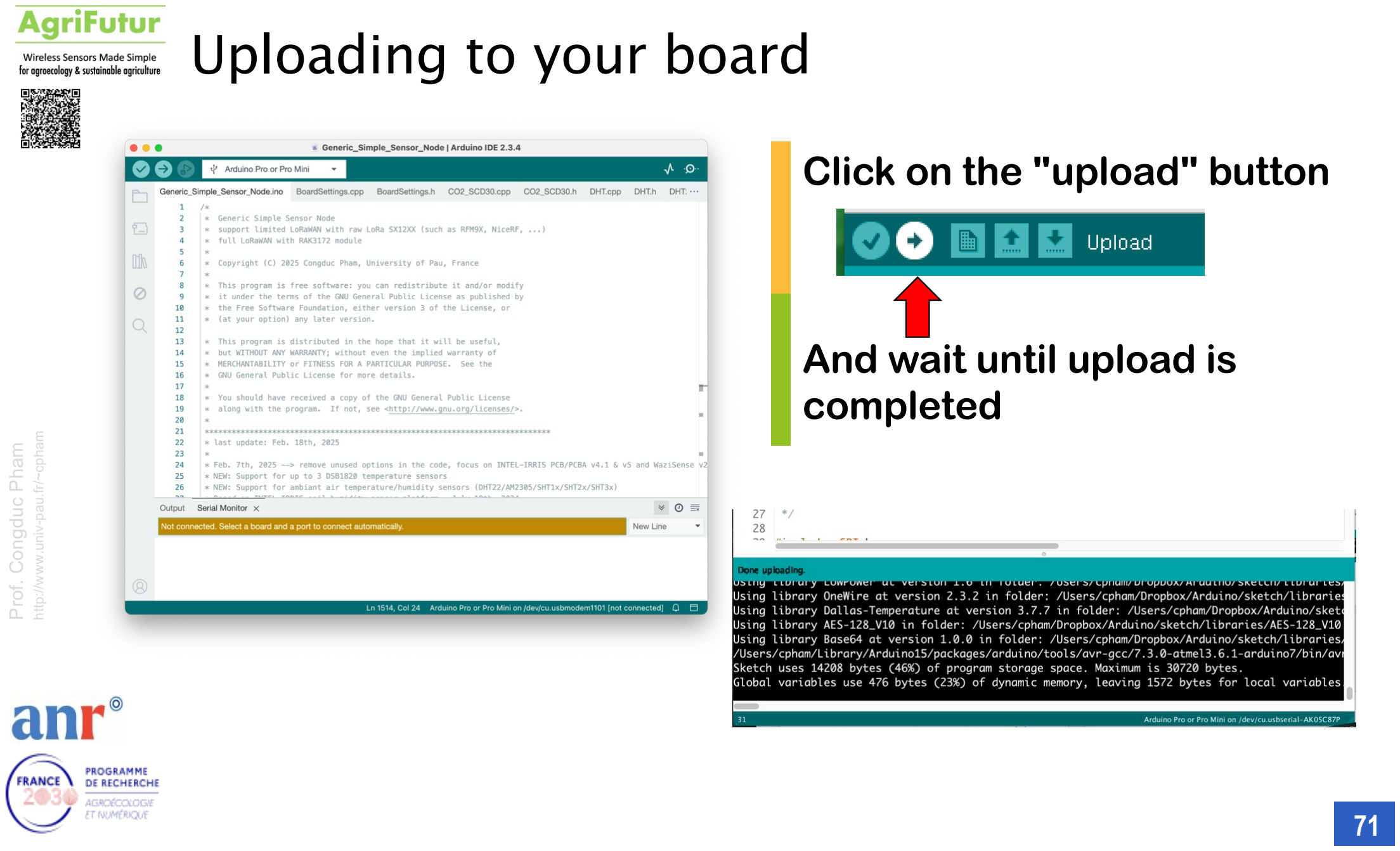
[picture p252: page 71]

Prof. Congduc Pham

http://www.univ-pau.fr/~cpham

71

Click on the "upload" button

And wait until upload is
completed

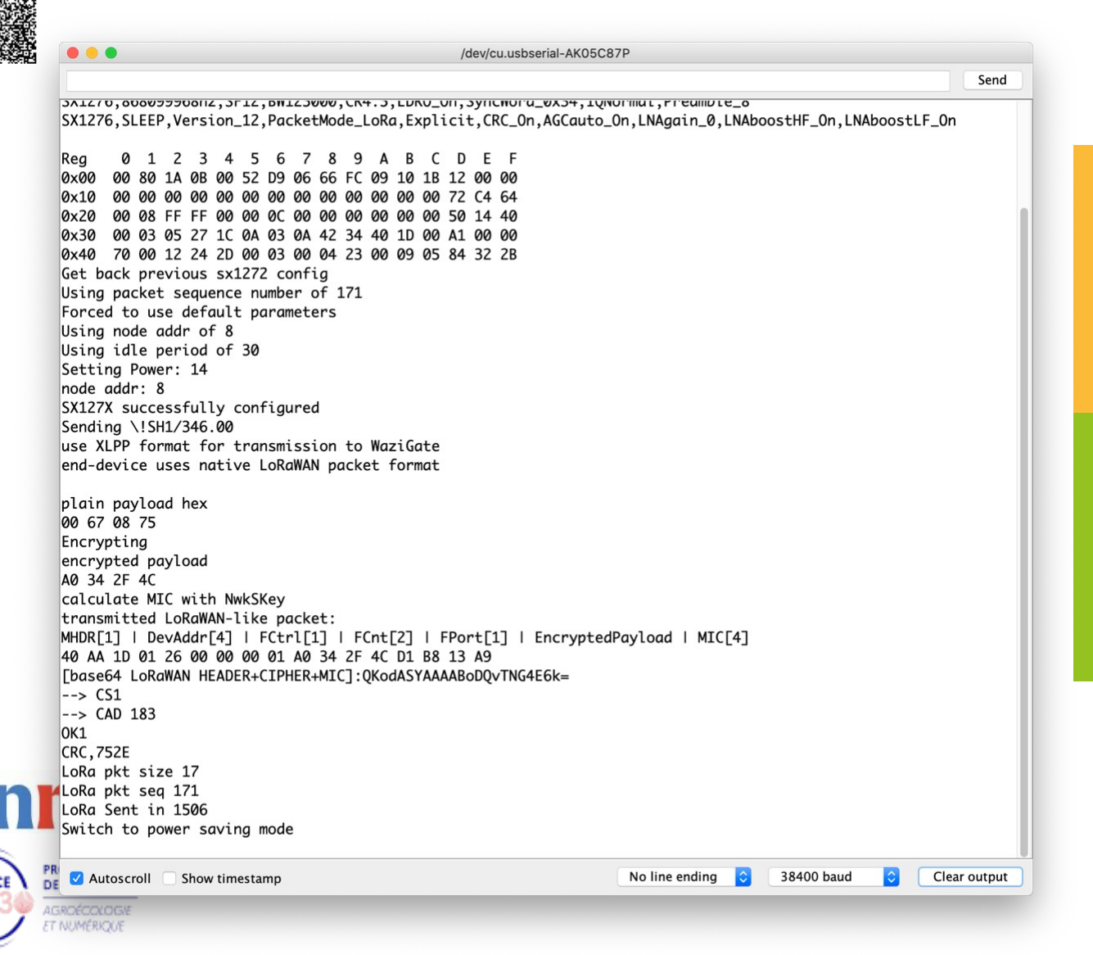
[picture p253: figure]

Prof. Congduc Pham

http://www.univ-pau.fr/~cpham

72

## Checking that device is operational

Open serial monitor

Set baud rate to 38400

See output from board

Check that
transmission is OK

## Generic & cyclic behavior

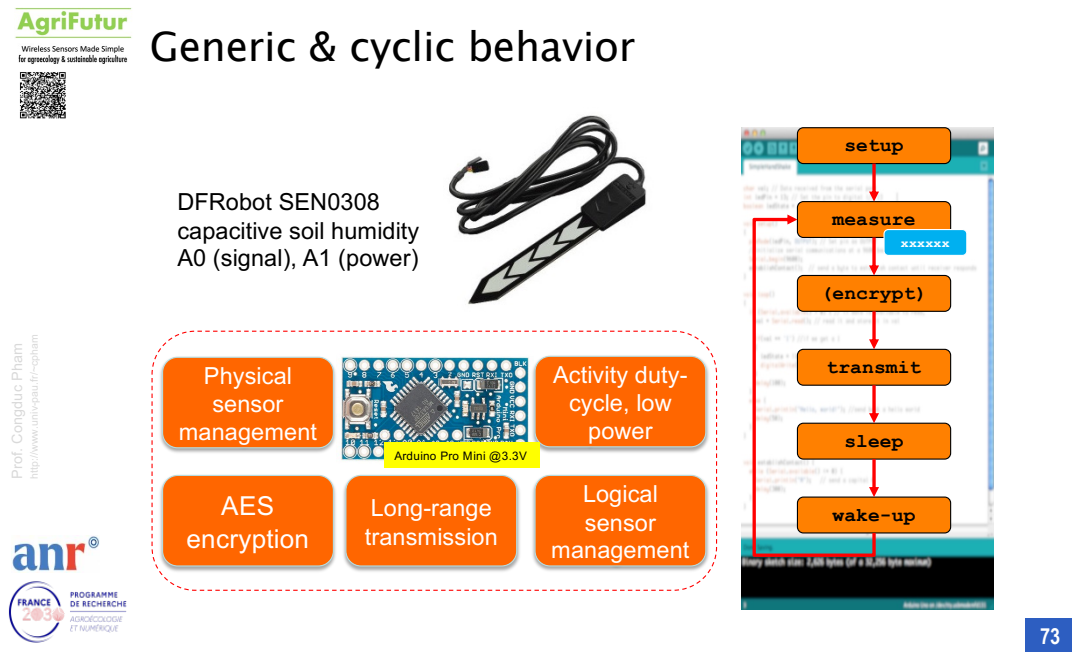
[picture p254: page 73]
Physical sensor management; Activity duty- cycle, low power; Logical sensor management; AES encryption; setup; measure; (encrypt); transmit; sleep; wake-up; xxxxxx

DFRobot SEN0308
capacitive soil humidity
A0 (signal), A1 (power)

http://www.univ-pau.fr/~cpham

Prof. Congduc Pham

Arduino Pro Mini @3.3V
Long-range
transmission

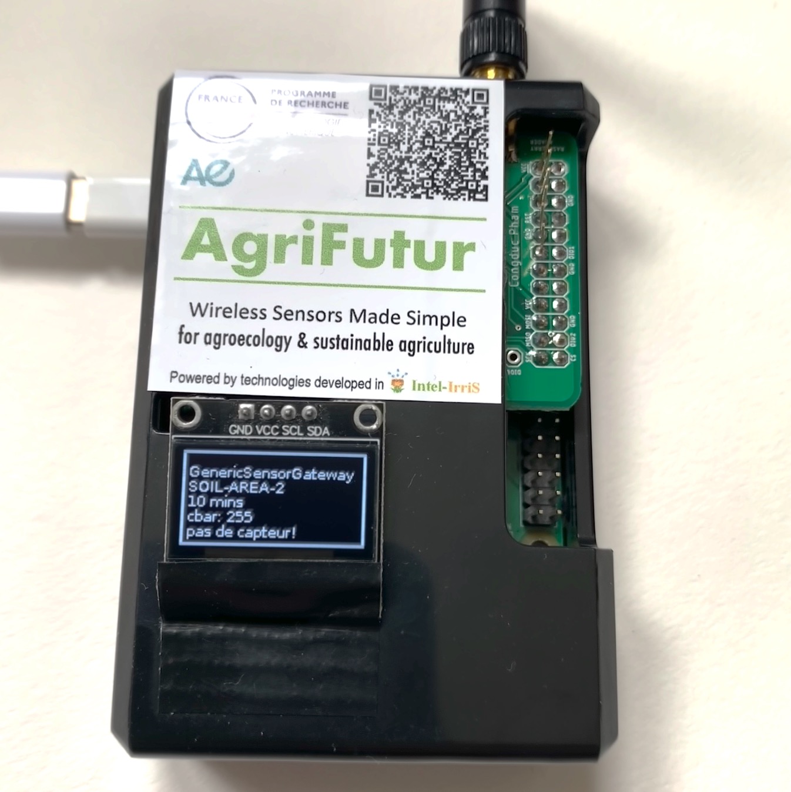
[picture p255: figure]

Prof. Congduc Pham

http://www.univ-pau.fr/~cpham

74

## Transmission to gateway

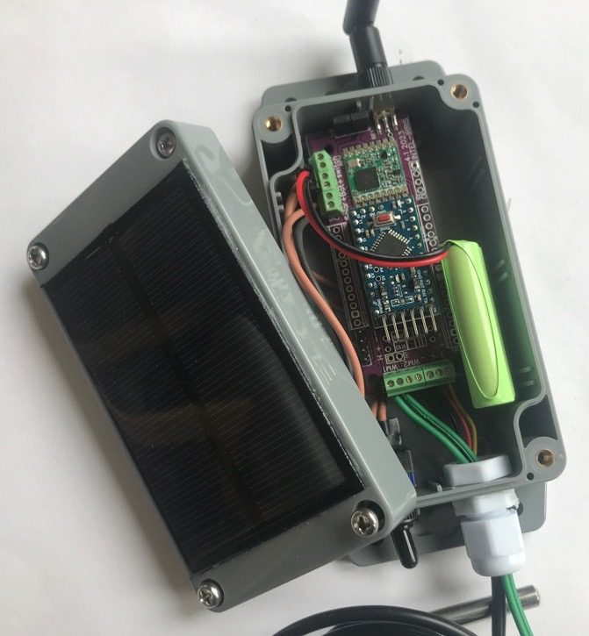
[picture p256: figure]
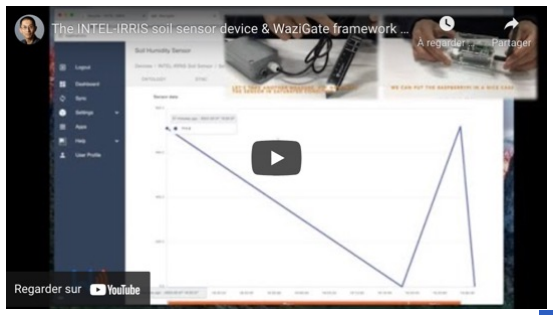
[picture p257: figure]

This video from INTEL

-IRRIS will show all
these steps, from connecting the SEN0308 to testing transmission to the gateway Video n

°4: https://youtu.be/j

-1Nk0tv0xM (https://youtu.be/j-1Nk0tv0xM)

LoRa parameters

Limited LoRaWAN
SF12BW125
868.1MHz
ABP mode
Dev addr is 26011DAA
1 msg/60mins
1 sensor
XLPP data

Image shown is the PCBA v4.1 from INTEL

-IRRIS

## Configuration for other type of sensors

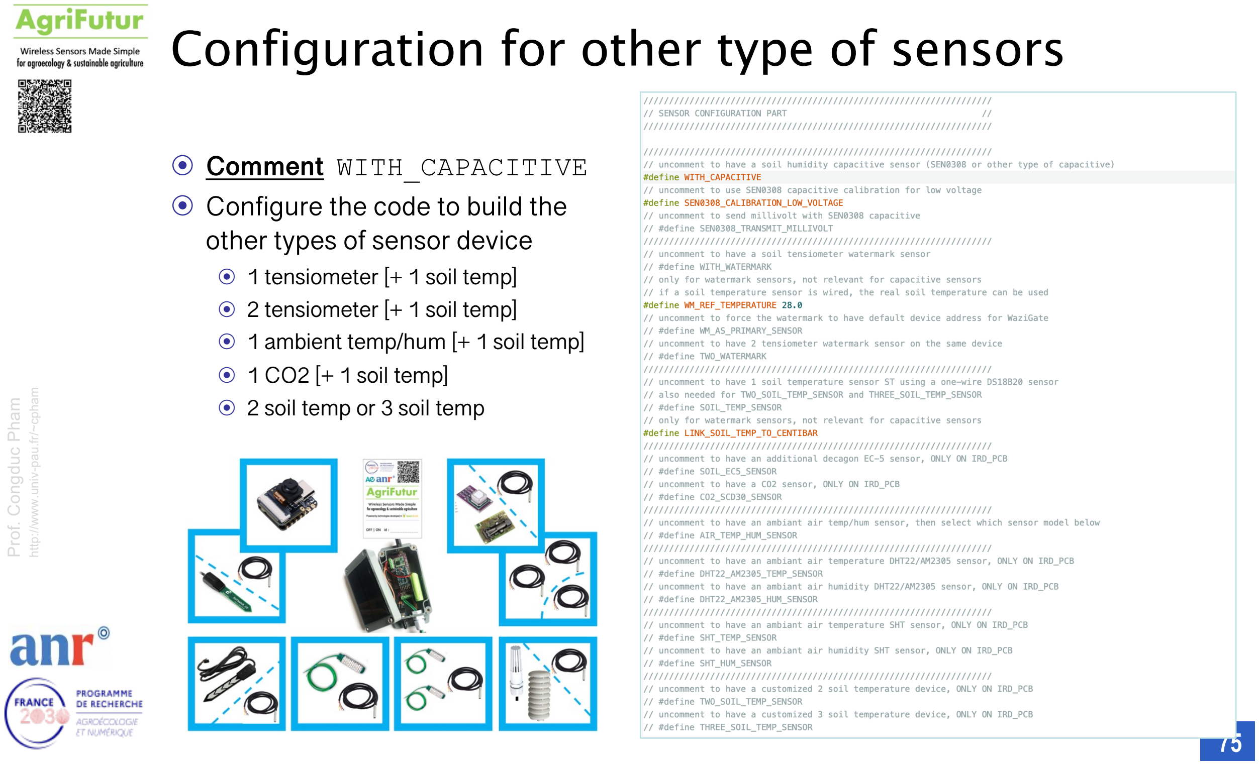
[picture p258: page 75]

Prof. Congduc Pham

http://www.univ-pau.fr/~cpham

75

⊙ Comment WITH_CAPACITIVE
⊙ Configure the code to build the other types of sensor device
⊙ 1 tensiometer [+ 1 soil temp]
⊙ 2 tensiometer [+ 1 soil temp]
⊙ 1 ambient temp/hum [+ 1 soil temp] ⊙ 1 CO2 [+ 1 soil temp]
⊙ 2 soil temp or 3 soil temp

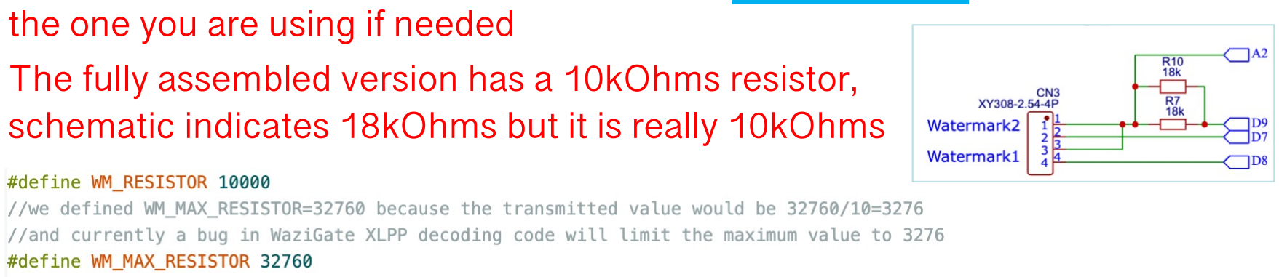
[picture p259: figure]
the one you are using if needed

Prof. Congduc Pham

http://www.univ-pau.fr/~cpham

76

## Configuration for Watermark tensiometer

⊙ Default resistor value is 10kOhms
⊙ Change in watermark.h file
the WM_RESISTOR value to match

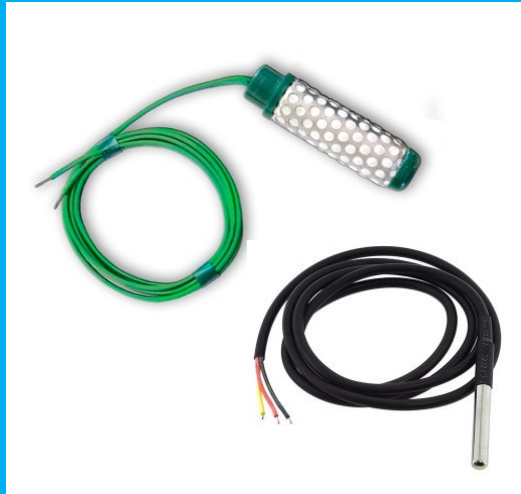
[picture p260: figure]

⊙ The fully assembled version has a 10kOhms resistor, schematic indicates 18kOhms but it is really 10kOhms

⊙ Uncomment in main program WITH_WATERMARK

Prof. Congduc Pham

http://www.univ-pau.fr/~cpham

77

## Transmission with the WM sensor

⊙ Devices with a WM sensor will have a different default address
⊙ 26011DB1 instead of 26011DAA for capacitive
⊙ 2 values are transmitted
⊙ Centibars converted from resistance value
⊙ Raw resistance value measured for WM sensor, but scaled down by a factor of 10 ➞ 300 = 3000 Ohms

LoRa parameters

Limited LoRaWAN
SF12BW125
868.1MHz
ABP mode
Dev addr is 26011DB1
1 msg/60mins
1 sensor
XLPP data

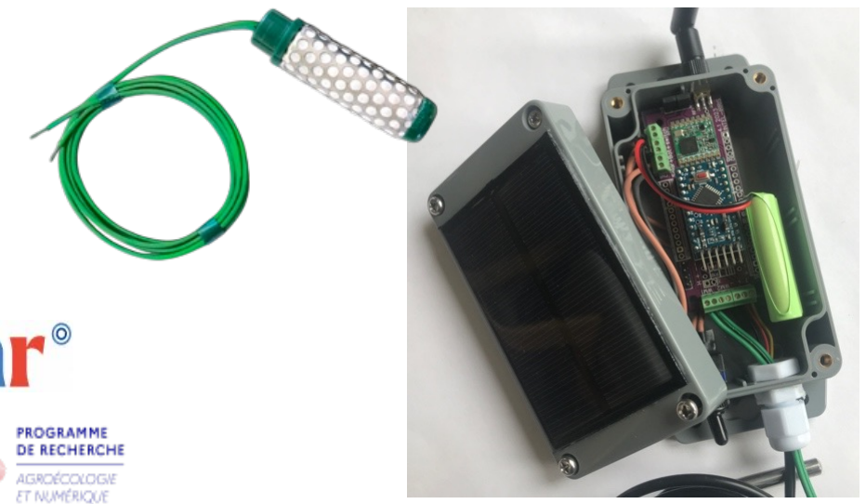
[picture p261: figure]

Image shown is the PCBA v4.1 from INTEL-IRRIS

## See it on the dashboard

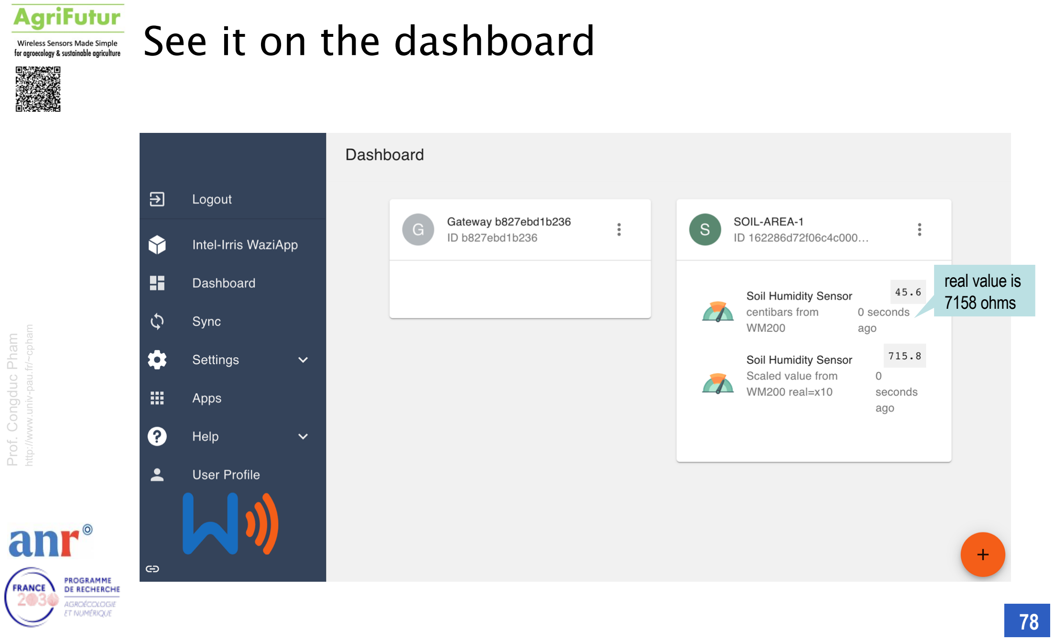
[picture p262: page 78]

Prof. Congduc Pham

http://www.univ-pau.fr/~cpham

78

real value is
7158 ohms

Prof. Congduc Pham

http://www.univ-pau.fr/~cpham

79

## Static soil temperature with WM sensor

⊙ Without a real temperature sensor, the INTEL-IRRIS code uses a default soil temperature set to 28°C to convert the resistance value into centibars (see https://www.irrometer.com/200ss.html)

⊙ You can change this setting in the code for testing purposes
⊙ It is better to use a real temperature sensor to dynamically get the soil temperature

Prof. Congduc Pham

http://www.univ-pau.fr/~cpham

80

## Real soil temperature with WM sensor

⊙ A DS18B20 temperature sensor can be connected to the device

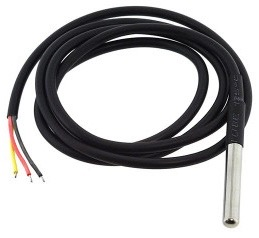
[picture p263: figure]
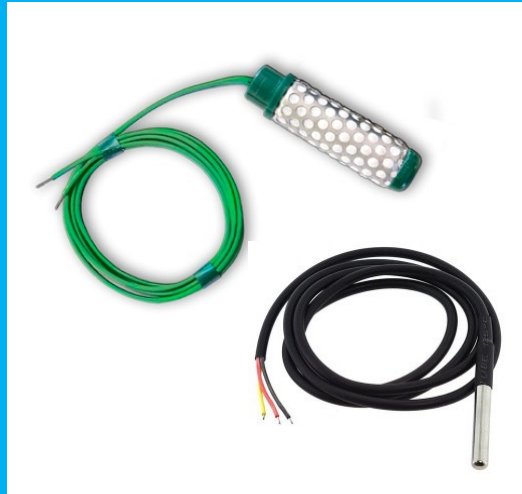
[picture p264: figure]

⊙ Uncomment in main program SOIL_TEMP_SENSOR

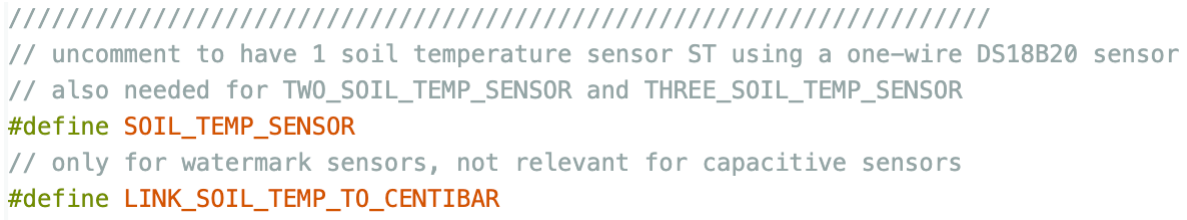
[picture p265: figure]

⊙ Then, link the measured soil temperature to the centibar calculation performed by the device itself (set by default)

## The Capacitive and Tensiometer sensors

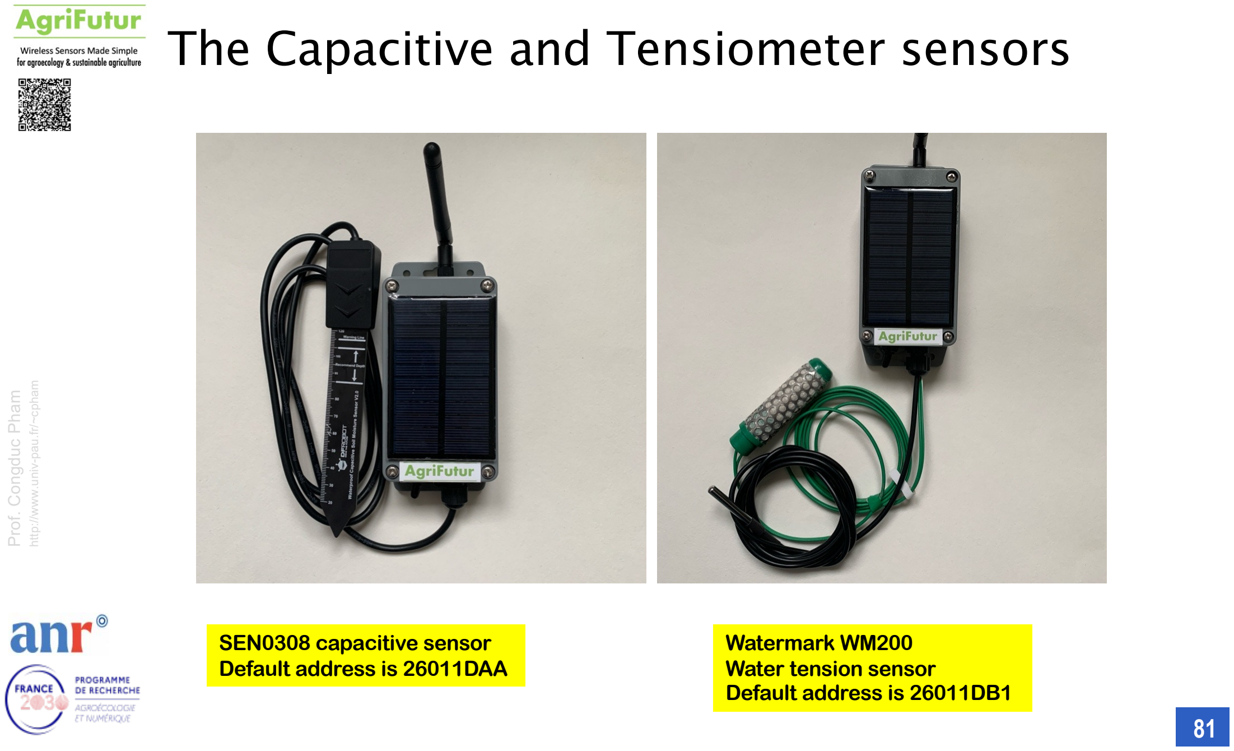
[picture p266: page 81]

Prof. Congduc Pham

http://www.univ-pau.fr/~cpham

81

SEN0308 capacitive sensor
Default address is 26011DAA

Watermark WM200
Water tension sensor
Default address is 26011DB1

## Configuration for 2 Watermark

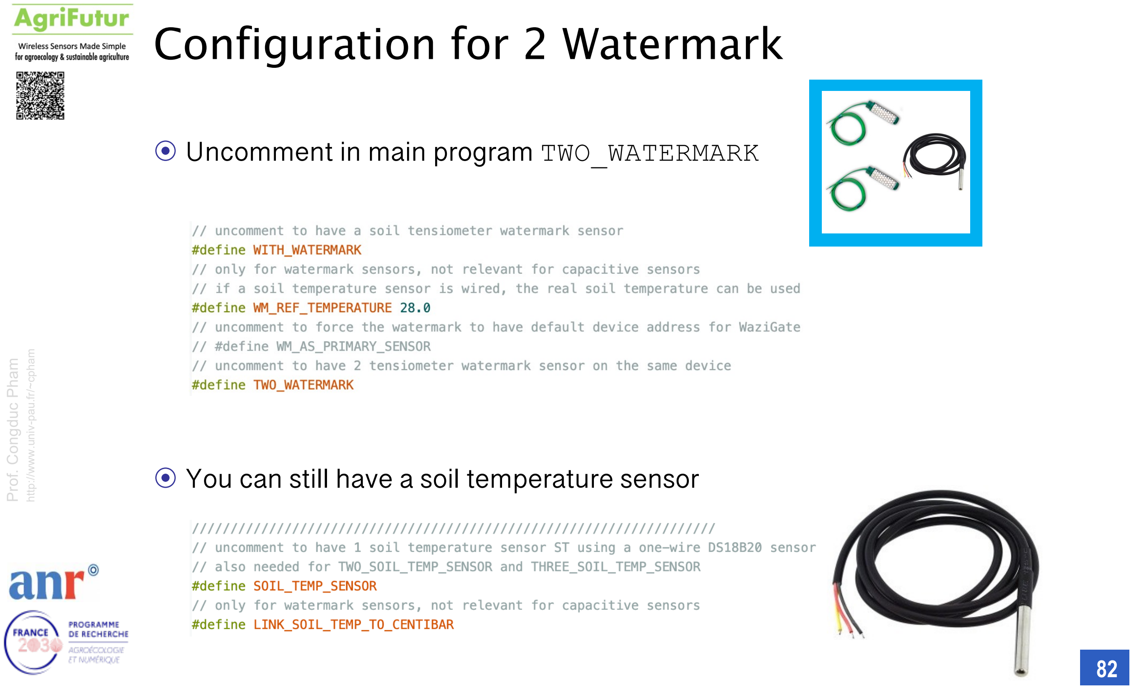
[picture p267: page 82]

Prof. Congduc Pham

http://www.univ-pau.fr/~cpham

82

⊙ Uncomment in main program TWO_WATERMARK

⊙ You can still have a soil temperature sensor

## Configuration for ambient air temp/hum

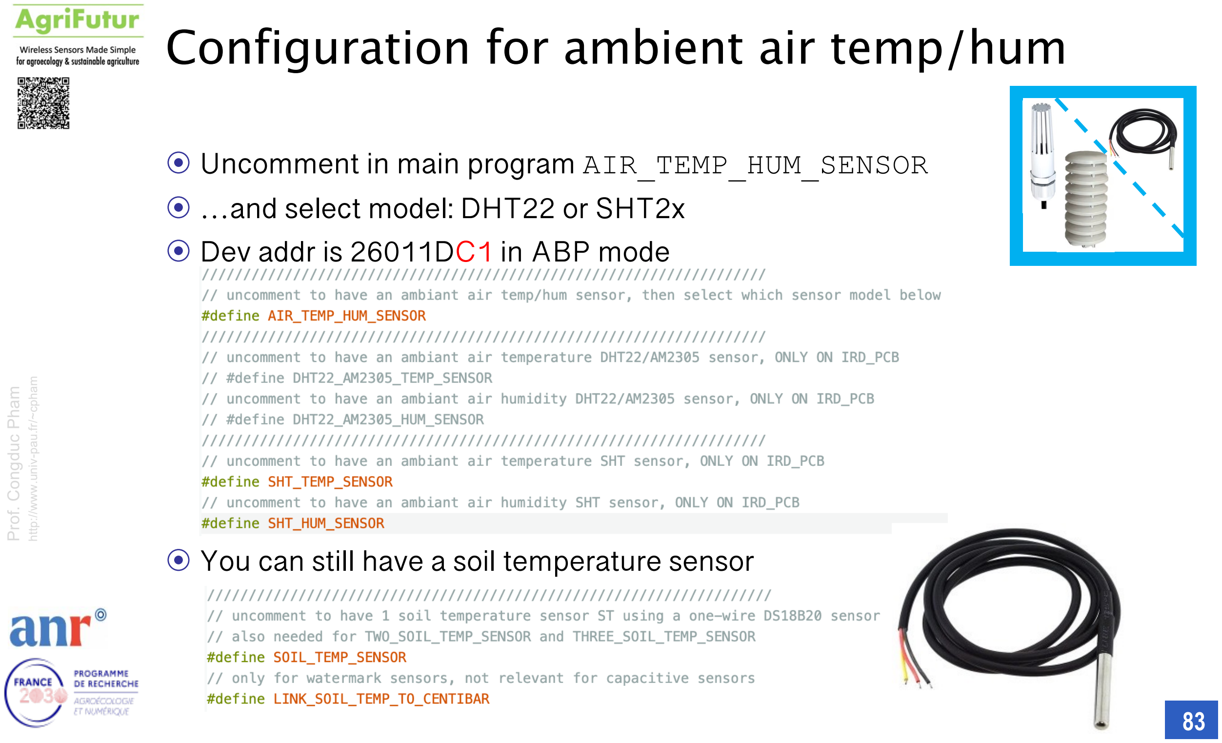
[picture p268: page 83]

Prof. Congduc Pham

http://www.univ-pau.fr/~cpham

83

⊙ Uncomment in main program AIR_TEMP_HUM_SENSOR ⊙ …and select model: DHT22 or SHT2x
⊙ Dev addr is 26011DC1 in ABP mode

⊙ You can still have a soil temperature sensor

Prof. Congduc Pham

http://www.univ-pau.fr/~cpham

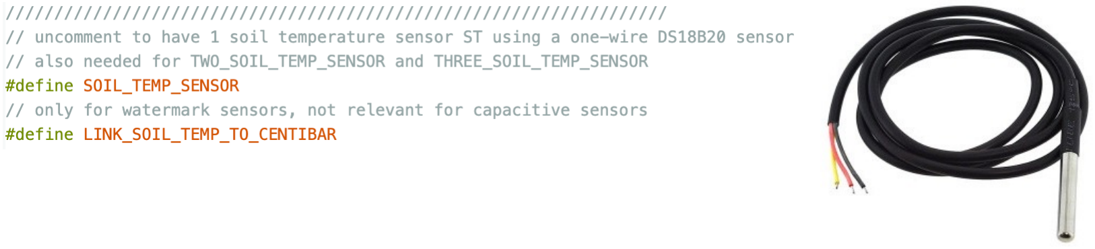
[picture p269: figure]

84

## Configuration for 2 & 3 soil temp

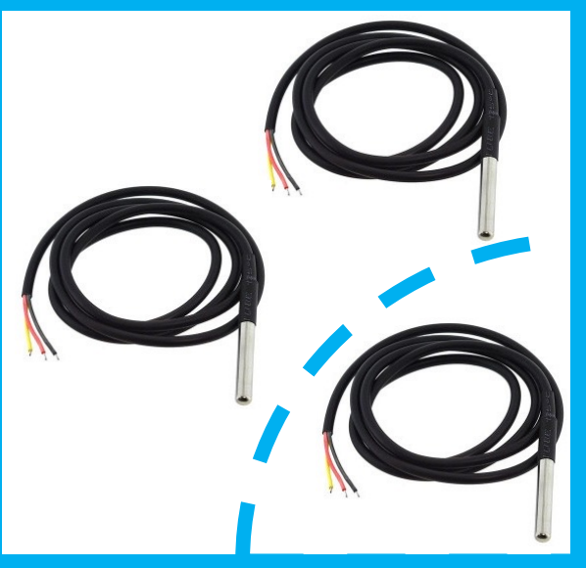
[picture p270: figure]

⊙ Uncomment in main program either TWO_SOIL_TEMP_SENSOR
or
THREE_SOIL_TEMP_SENSOR

⊙ Dev addr is 26011DD1 in ABP mode
⊙ You MUST also have the primary soil temperature sensor

Prof. Congduc Pham

http://www.univ-pau.fr/~cpham

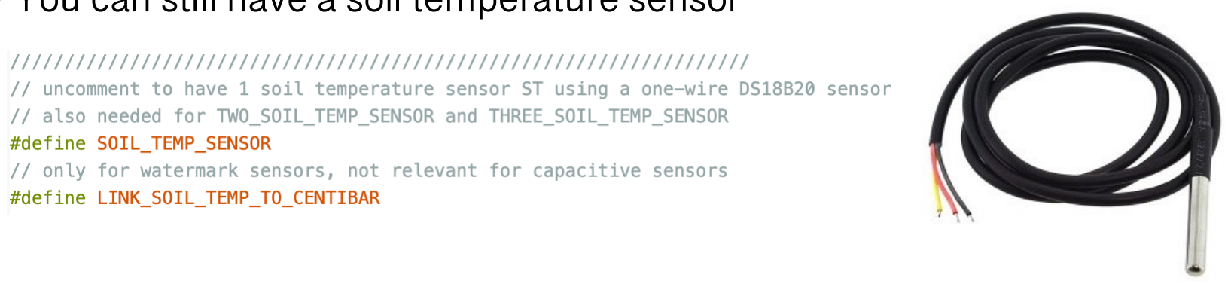
[picture p271: figure]

85

## Configuration for SCD30/40 CO2 sensor

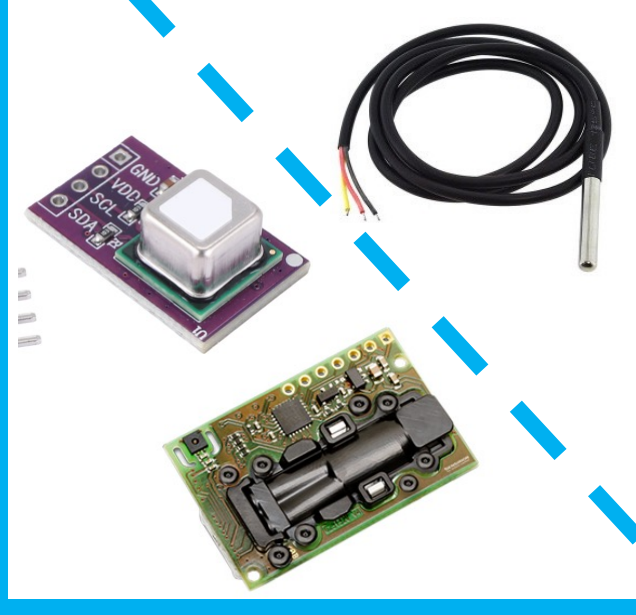
[picture p272: figure]

⊙ Uncomment in main program
CO2_SCD30_SENSOR
or
CO2_SCD40_SENSOR

⊙ Dev addr is 26011DE1 in ABP mode
⊙ You can still have a soil temperature sensor

Prof. Congduc Pham

http://www.univ-pau.fr/~cpham

86

## Check list summary

⊙ PCBA v4.1 à default configuration, nothing to do
⊙ RAW PCB v4.1 à comment IRD_PCBA
⊙ No solar panel à default configuration, nothing to do
⊙ Solar panel à uncomment SOLAR_BAT, typically use 3xAAA NiMh
⊙ Capacitive Soil Humidity à default configuration, nothing to do
⊙ Other than Capacitive Soil Humidity à comment WITH_CAPACITIVE ⊙ Then, uncomment WITH_WATERMARK, SOIL_TEMP_SENSOR, AIR_TEMP_HUM_SENSOR, … according to attached sensor type

Prof. Congduc Pham

http://www.univ-pau.fr/~cpham

87

## Low battery voltage indication

⊙ The sensor device code has low battery voltage indication feature, by default, low battery voltage threshold is set to 2.85V

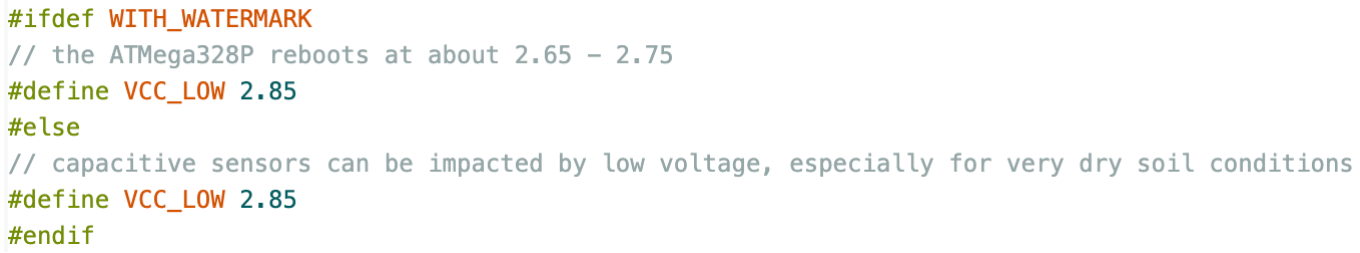
[picture p273: figure]

⊙ The battery voltage will be transmitted to the gateway as well and will appear on the gateway's dashboard to warn end-user
⊙ When low battery voltage is detected, the measure & transmission time interval will increase from 1h to 4h to preserve battery

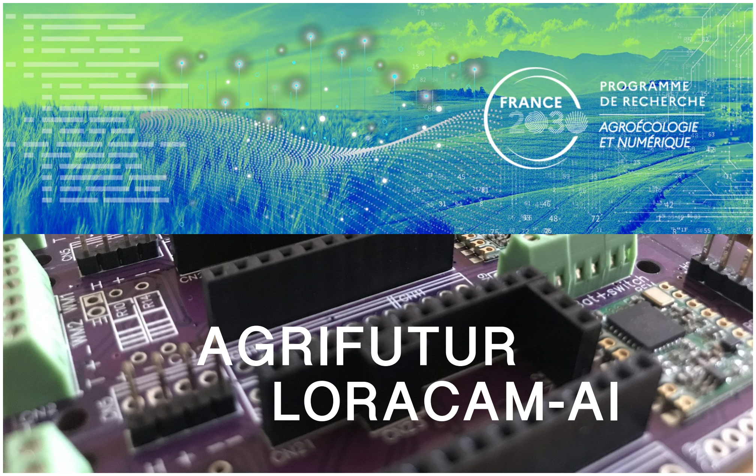
[picture p274: page 88]

# AGRIFUTUR LORACAM-AI

Prof. Congduc Pham

http://www.univ-pau.fr/~cpham

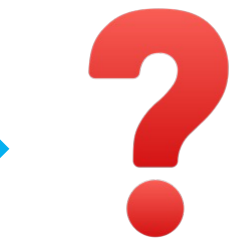
[picture p275: figure]
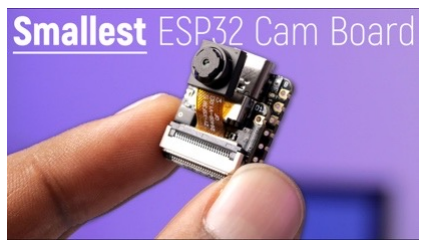
[picture p276: figure]
Sense

89

## Advanced Sensing Systems

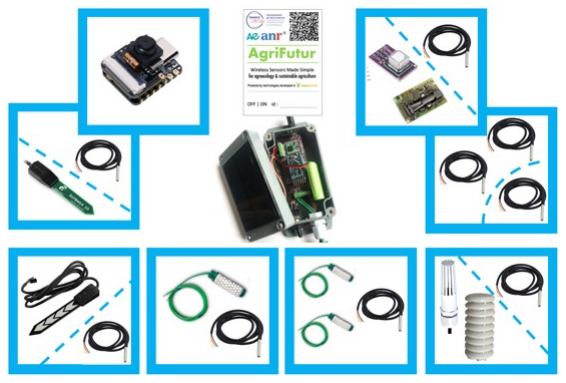
[picture p277: figure]
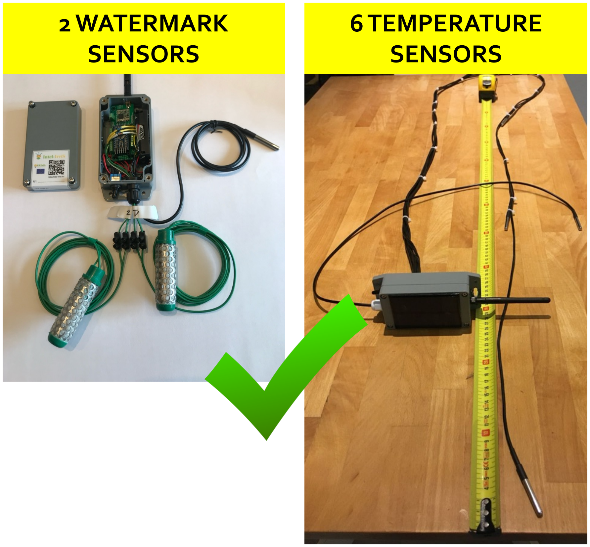
[picture p278: figure]
2 WATERMARK SENSORS; 6 TEMPERATURE SENSORS

⊙ Many applications need visual information à Image Sensing IoT

AIR
TEMP/HUM

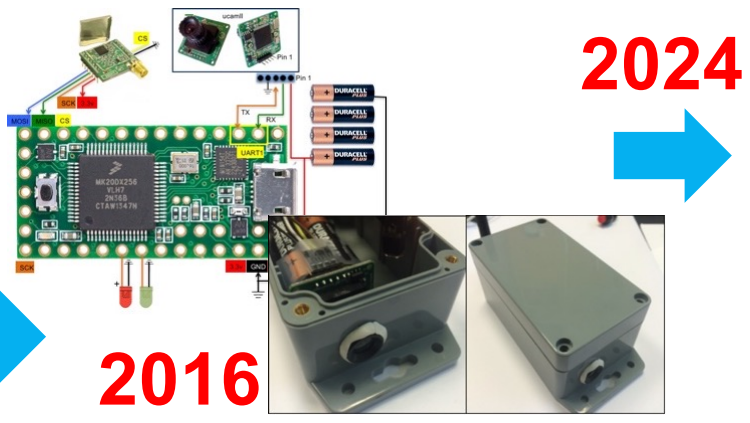
[picture p279: figure]
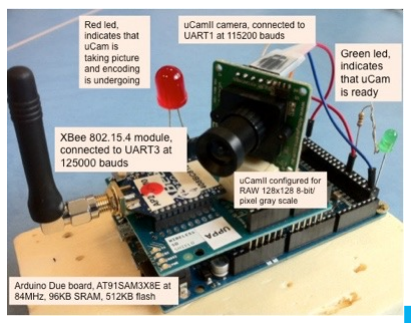
[picture p280: figure]

2012 2016

XIAO
ESP32S3

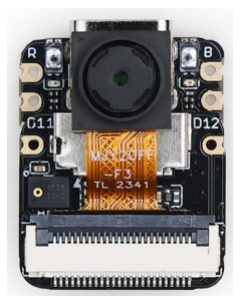
[picture p281: figure]

ESP32S3 32-
bit, dual-core,
up to 240
MHz

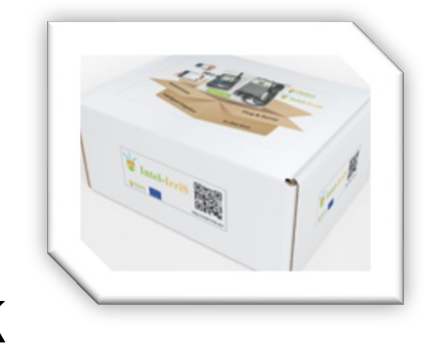
[picture p282: figure]
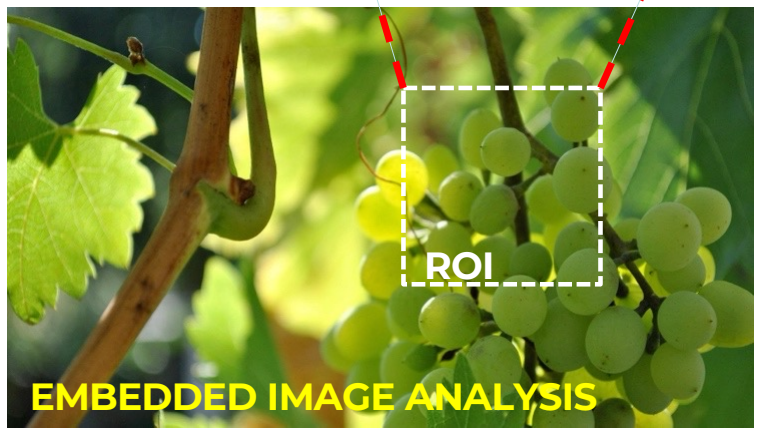
[picture p283: figure]
ROI; EMBEDDED IMAGE ANALYSIS

Prof. Congduc Pham

http://www.univ-pau.fr/~cpham

90

## Image Sensor? Quite a challenge!

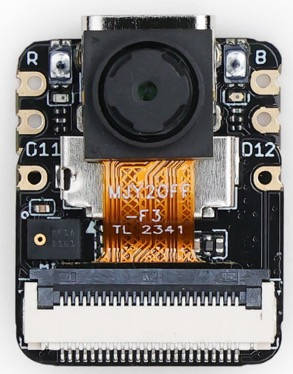
[picture p284: figure]

⊙ Low Power
⊙ Plug-and-Sense, out-of-the-box ⊙ Embedded AI processing
⊙ Versatile AI learning framework
⊙ Application-specific AI models
⊙ Robust image encoding against losses ⊙ Long-range radio transmissions
⊙ Efficient usage of radio resources

## Agriculture

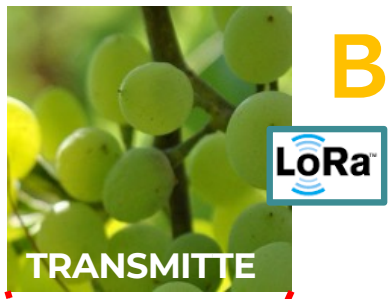
[picture p285: figure]
TRANSMITTE

# Biodiversity Agroecology Environment

## Surveillance

# Wildlife

D

Prof. Congduc Pham

http://www.univ-pau.fr/~cpham

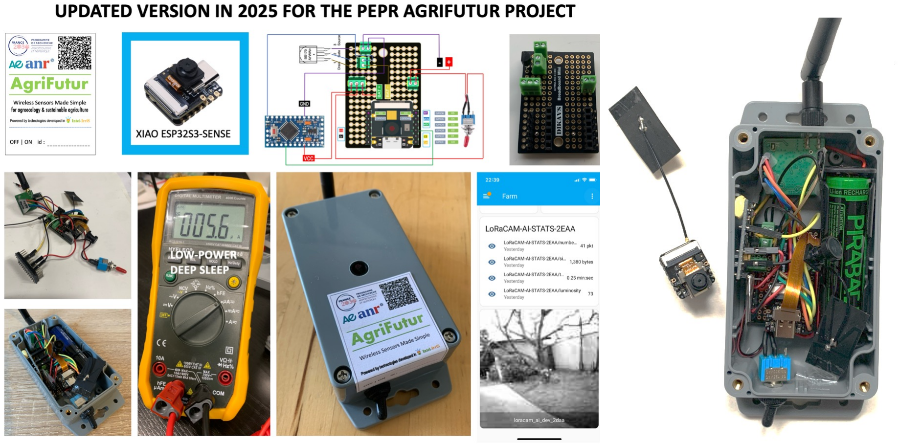
[picture p286: figure]

91

## Proof-of-concept: LORACAM-AI

## Going beyond terrestrial network!

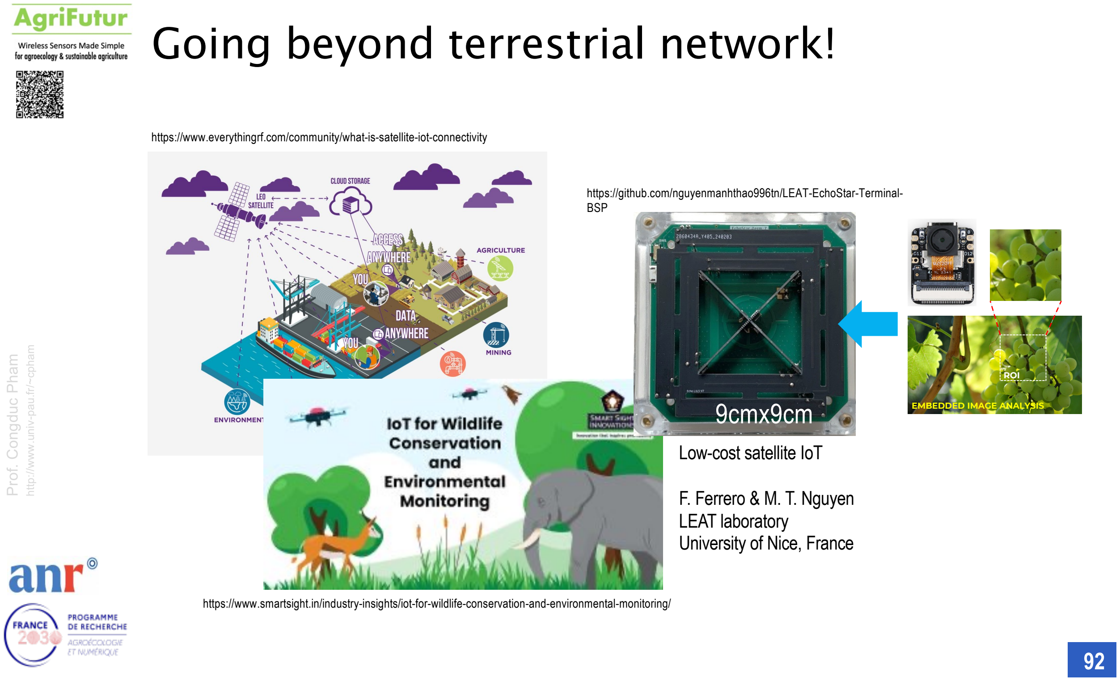
[picture p287: page 92]

Prof. Congduc Pham

http://www.univ-pau.fr/~cpham

92

https://www.everythingrf.com/community/what-is-satellite-iot-connectivity

https://www.smartsight.in/industry-insights/iot-for-wildlife-conservation-and-environmental-monitoring/https://github.com/nguyenmanhthao996tn/LEAT-EchoStar-Terminal-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

Low-cost satellite IoT

F. Ferrero & M. T. Nguyen
LEAT laboratory
University of Nice, France

ROI

EMBEDDED IMAGE ANALYSIS 9cmx9cm
