CongducPham/PEPR_AgriFutur/Tutorials/Generic-IOT-platform-PCBv5-PCBA.pdf

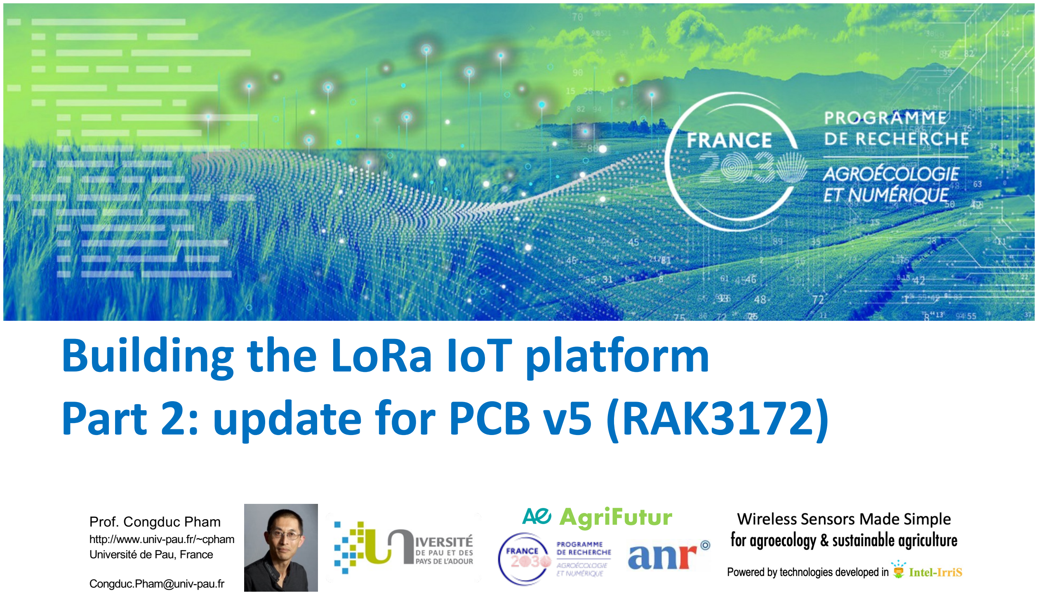
[picture p288: page 1]

Prof. Congduc Pham
http://www.univ-pau.fr/~cpham Université de Pau, France

Congduc.Pham@univ-pau.fr

AgriFutur

# Building the LoRa IoT platform Part 2: update for PCB v5 (RAK3172)

## List of components

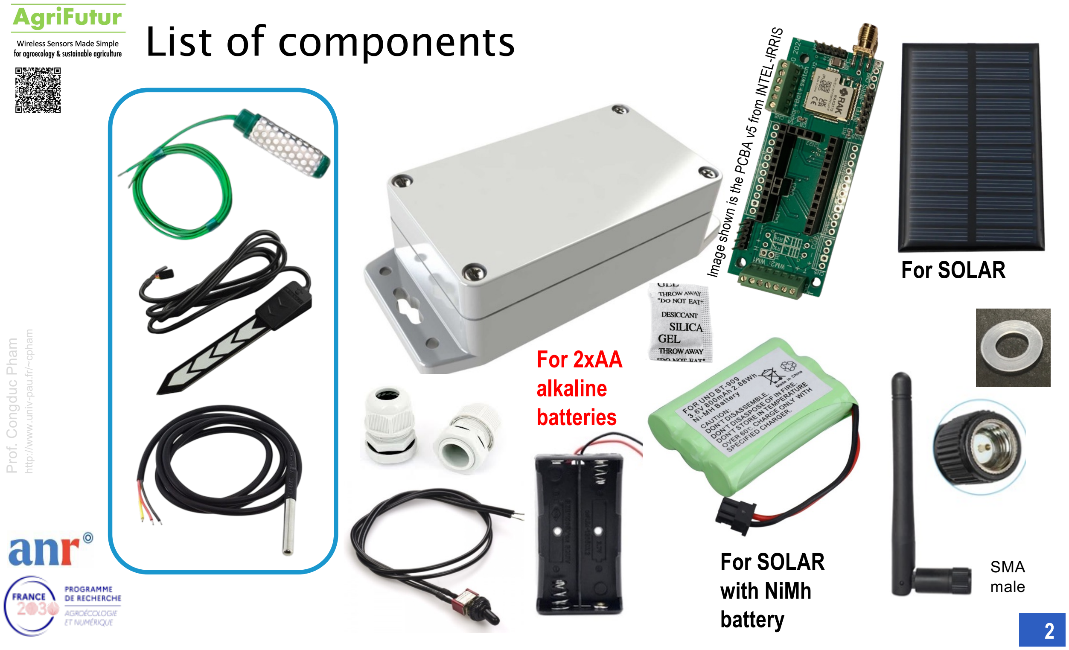
[picture p289: page 2]

Prof. Congduc Pham

http://www.univ-pau.fr/~cpham

2

SMA
male

For SOLAR
with NiMh
battery

For 2xAA
alkaline
batteries

# Image shown is the PCBA v5 from INTEL

For SOLAR

-IRRIS

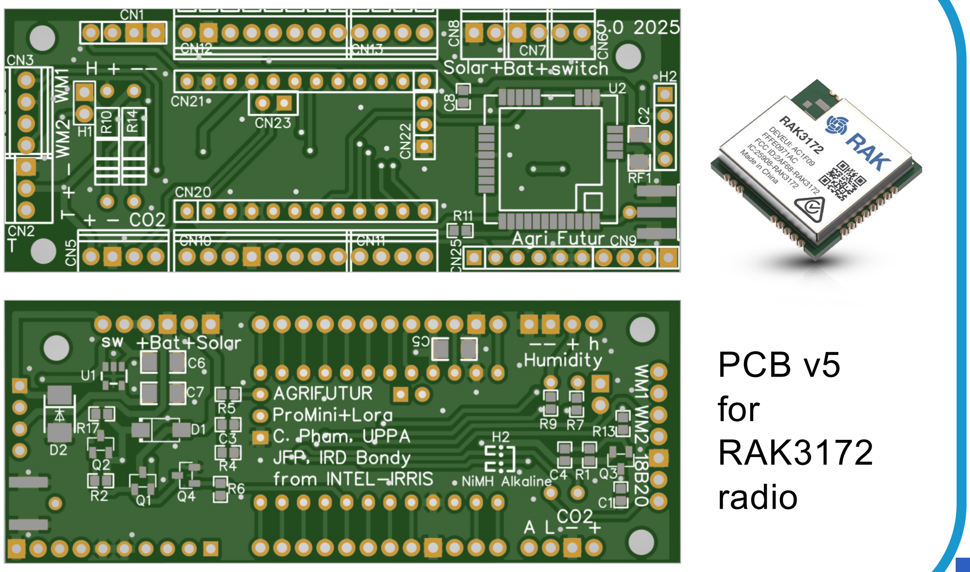
[picture p290: figure]
PCB v5 for RAK3172 radio
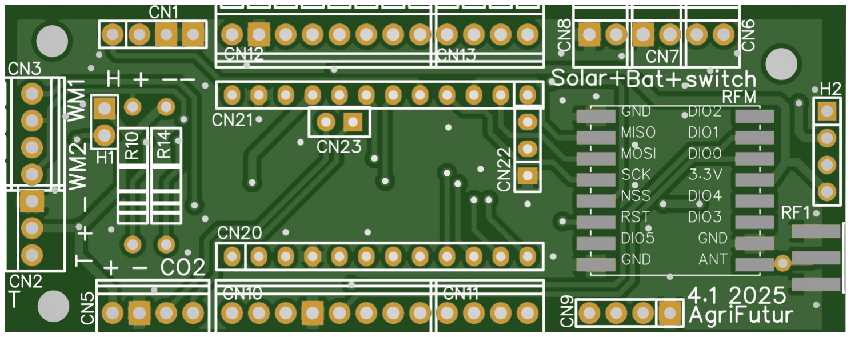
[picture p291: figure]

Prof. Congduc Pham

http://www.univ-pau.fr/~cpham

3

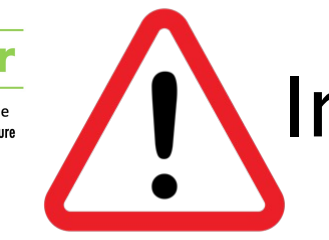
[picture p292: figure]

## Important

⊙ This tutorial is an update for the PCB v5 based on the RAK3172 radio module
⊙ Reader MUST first look at the tutorial presenting the PCB v4.1 to understand the common instructions
⊙ This tutorial only presents the differences between the 2 versions

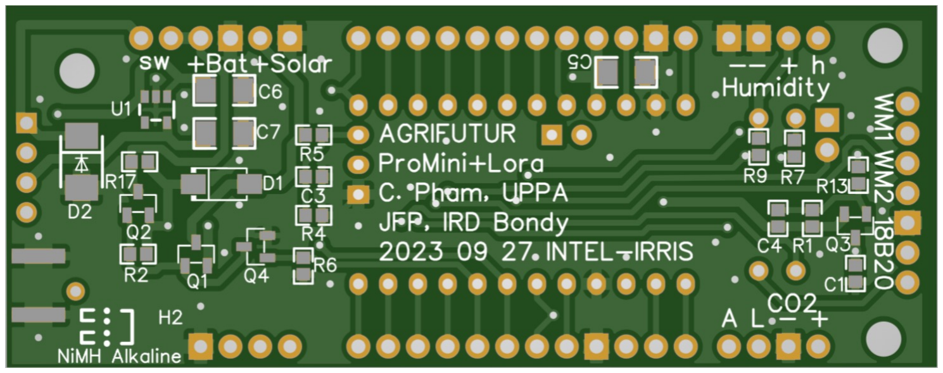
[picture p293: figure]

PCB v4.1
for
RFM95W
radio

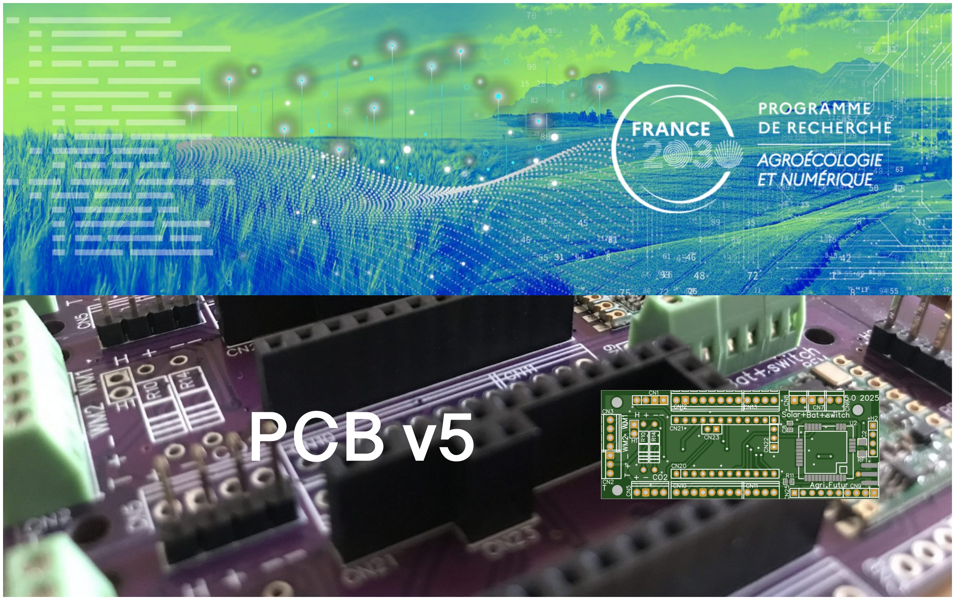
[picture p294: page 4]

# PCB v5

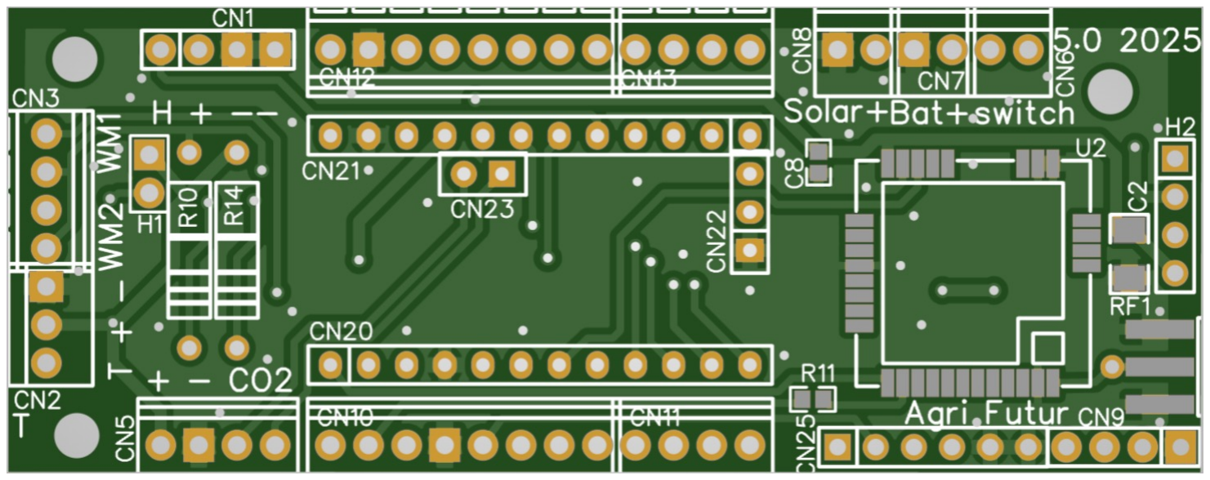
[picture p295: figure]

Prof. Congduc Pham

http://www.univ-pau.fr/~cpham

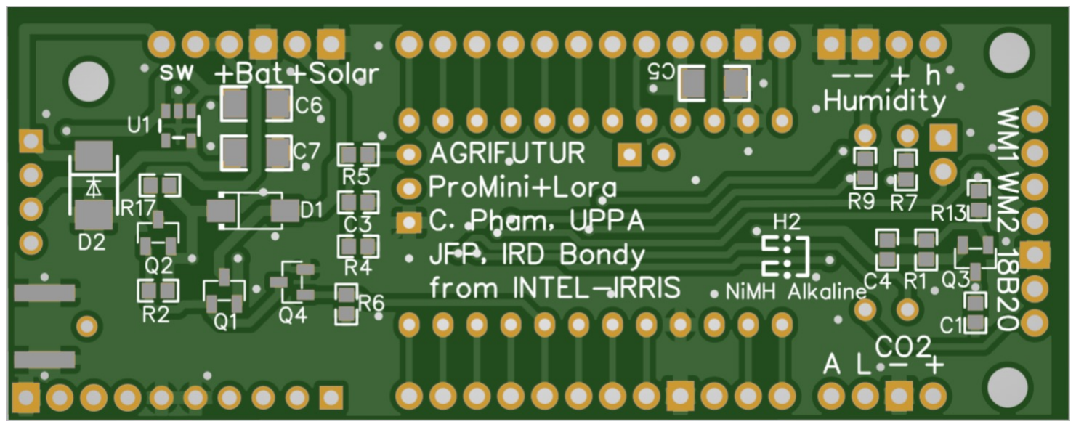
[picture p296: figure]

5

## The PCB v5 – raw version

⊙ You can order the raw version of the PCB, which means only the PCB, without any electronic components soldered by the manufacturer
⊙ It is the so-called
DIY approach
⊙ The raw version is not
intended to have solar
charging capabilities

## Electronic parts – starter-kit version

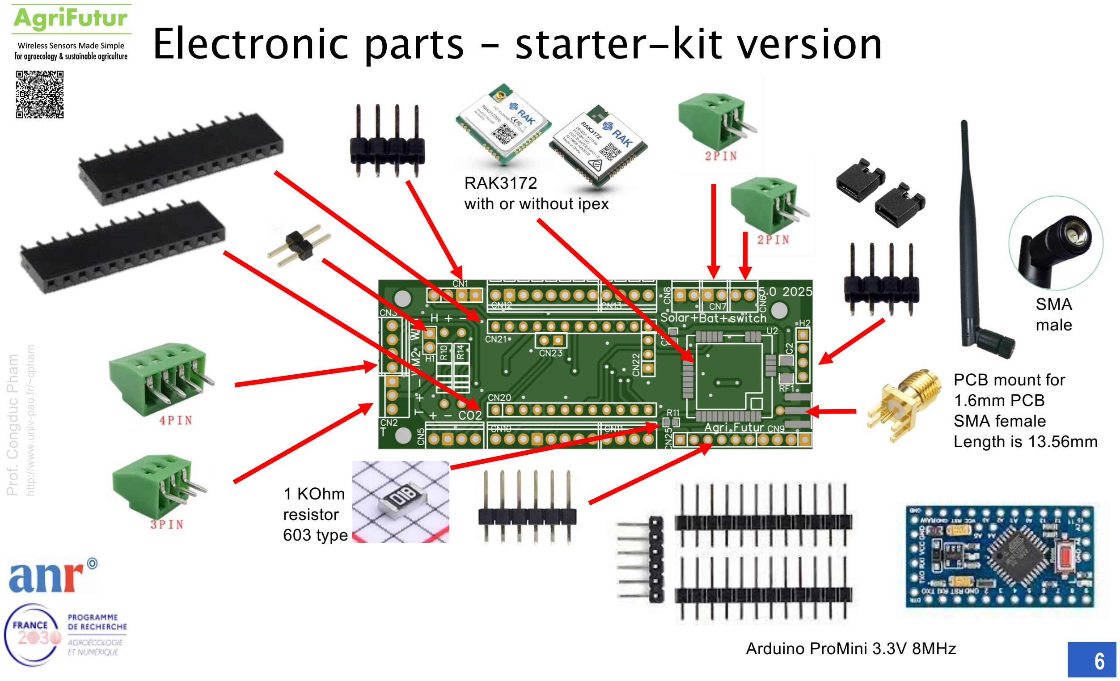
[picture p297: page 6]

Prof. Congduc Pham

http://www.univ-pau.fr/~cpham

6

PCB mount for
1.6mm PCB
SMA female
Length is 13.56mm

Arduino ProMini 3.3V 8MHz

SMA
male

RAK3172
with or without ipex

1 KOhm
resistor
603 type

## Difference compared to PCB v4.1

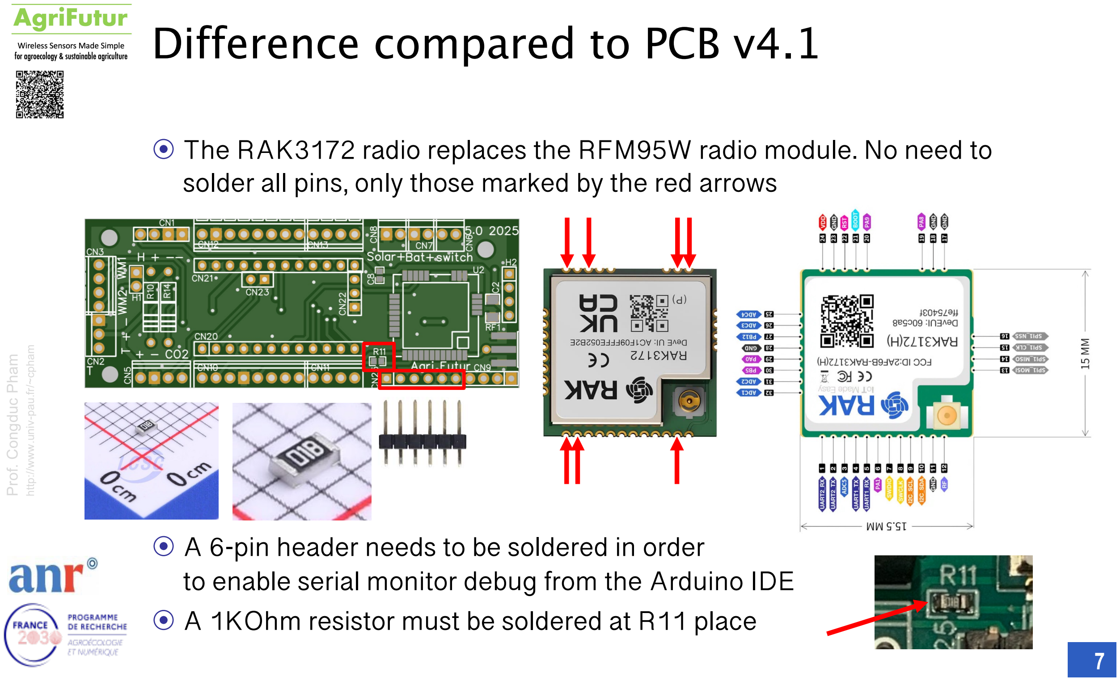
[picture p298: page 7]

Prof. Congduc Pham

http://www.univ-pau.fr/~cpham

7

⊙ The RAK3172 radio replaces the RFM95W radio module. No need to solder all pins, only those marked by the red arrows

⊙ A 6-pin header needs to be soldered in order
to enable serial monitor debug from the Arduino IDE ⊙ A 1KOhm resistor must be soldered at R11 place

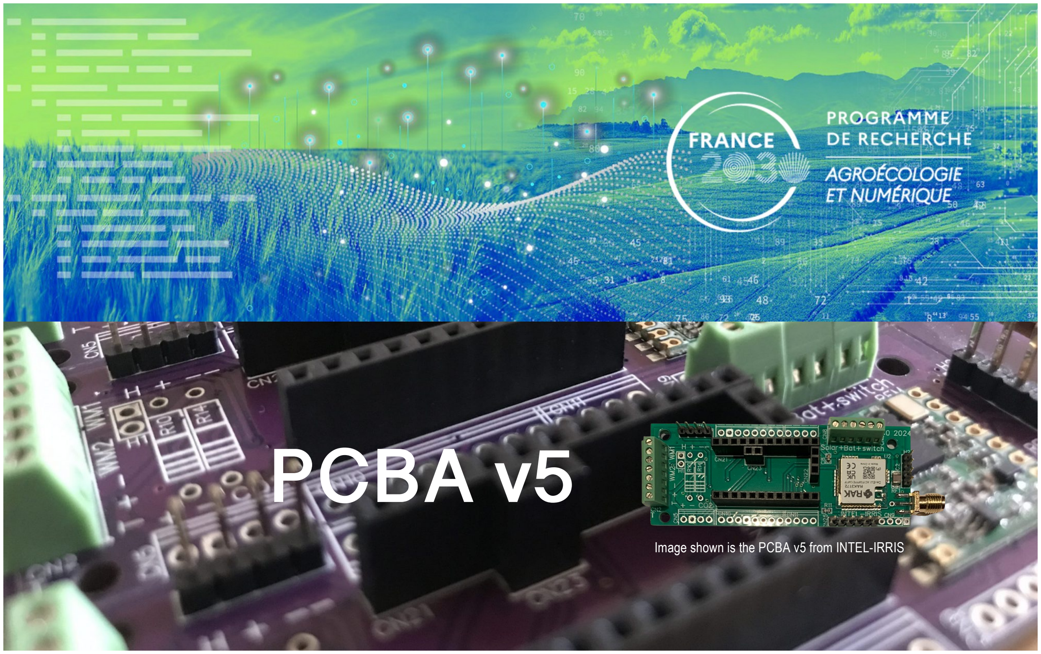
[picture p299: page 8]

# PCBA v5

Image shown is the PCBA v5 from INTEL-IRRIS


Prof. Congduc Pham

http://www.univ-pau.fr/~cpham


9

## PCB/PCBA v5 pin description

⊙ The PCB has the following pre-defined wiring to Arduino ProMini pin
https://github.com/CongducPham/PEPR_AgriFutur/blob/main/PCBs/IRD_PCB_5/Schematic_IISS_5_2024-05-06.pdf

D6

D8
A2
D7
A2

A0

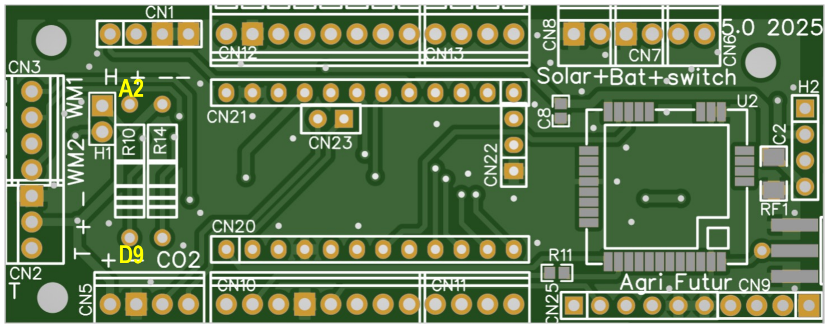
[picture p300: figure]

A5 A4

## Soil device with PCBA v5, final result

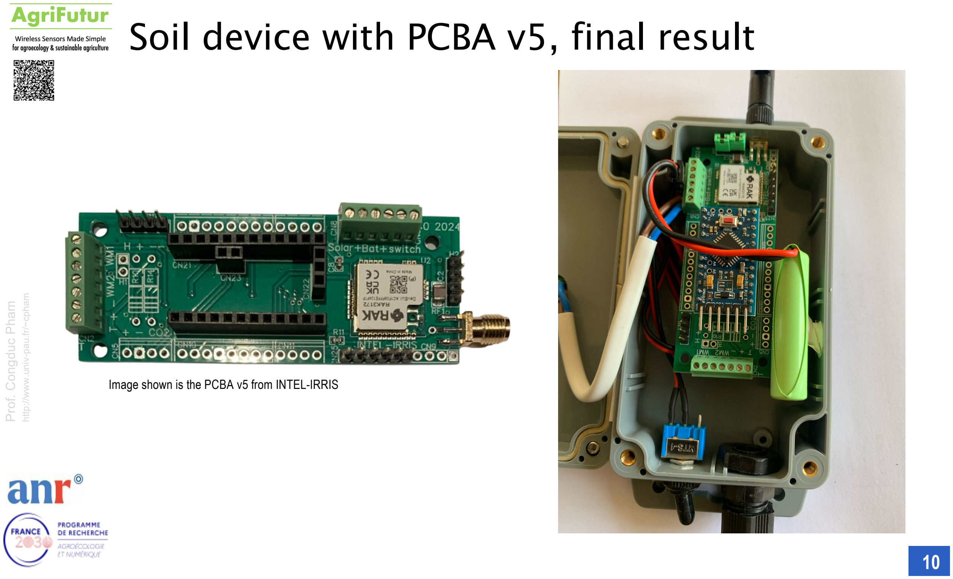
[picture p301: page 10]

Prof. Congduc Pham

http://www.univ-pau.fr/~cpham

10

Image shown is the PCBA v5 from INTEL-IRRIS

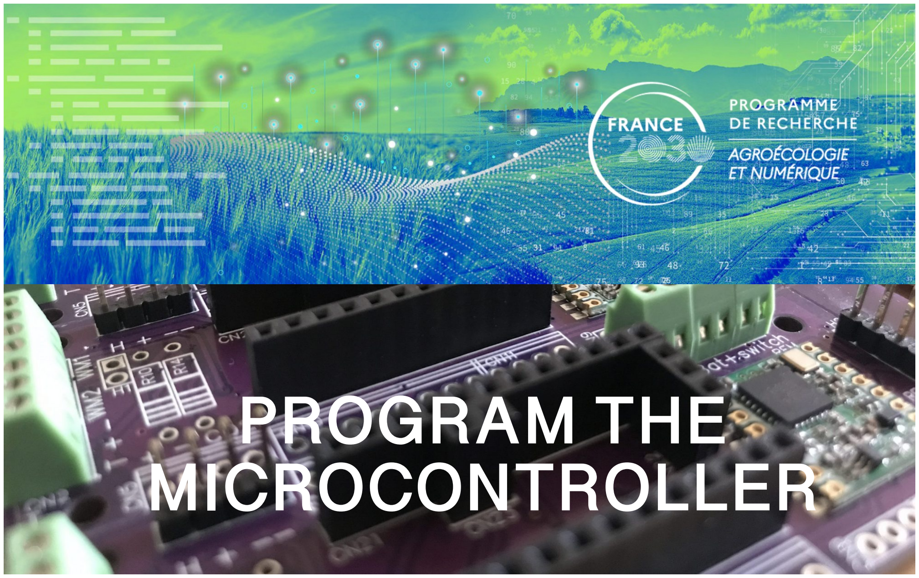
[picture p302: page 11]

# PROGRAM THE MICROCONTROLLER

Prof. Congduc Pham

http://www.univ-pau.fr/~cpham

12

## Configuration for PCB/PCBA v5 (1)

⊙ For raw version, uncomment IRD_PCB in BoardSettings.h ⊙ For PCBA version, also uncomment IRD_PCBA


⊙ ONLY for solar version, uncomment SOLAR_BAT


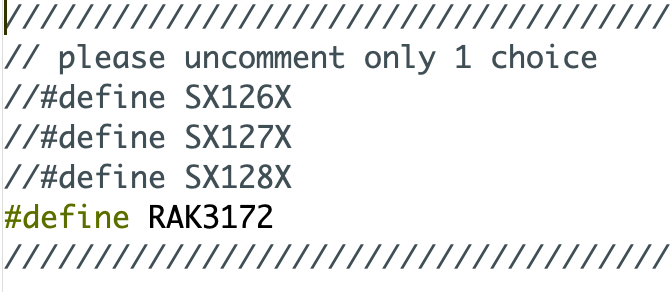
[picture p303: figure]

Prof. Congduc Pham

http://www.univ-pau.fr/~cpham

13

## Configuration for PCB/PCBA v5 (2)

⊙ Uncomment SOFT_SERIAL_DEBUG in BoardSettings.h

⊙ Uncomment RAK3172 in RadioSettings.h

Prof. Congduc Pham

http://www.univ-pau.fr/~cpham

14

## Serial monitor with PCB v5

⊙ After flashing the Arduino, it is usually desirable to watch at the text output from the Arduino IDE serial monitor to check that everything went OK
⊙ With PCB v5, the RAK radio module is controlled by AT commands received on its serial port and sent by the Arduino on its serial port (baud rate is normally set to 38400)
⊙ Therefore, Arduino's TX/RX pins are connected to the RAK3172 and the serial monitor used traditionally to look at text output can not use the default Arduino TX/RX pins
⊙ The PCB v5 uses a software defined serial port for the text output where only TX is defined on digital pin 2

Prof. Congduc Pham

http://www.univ-pau.fr/~cpham

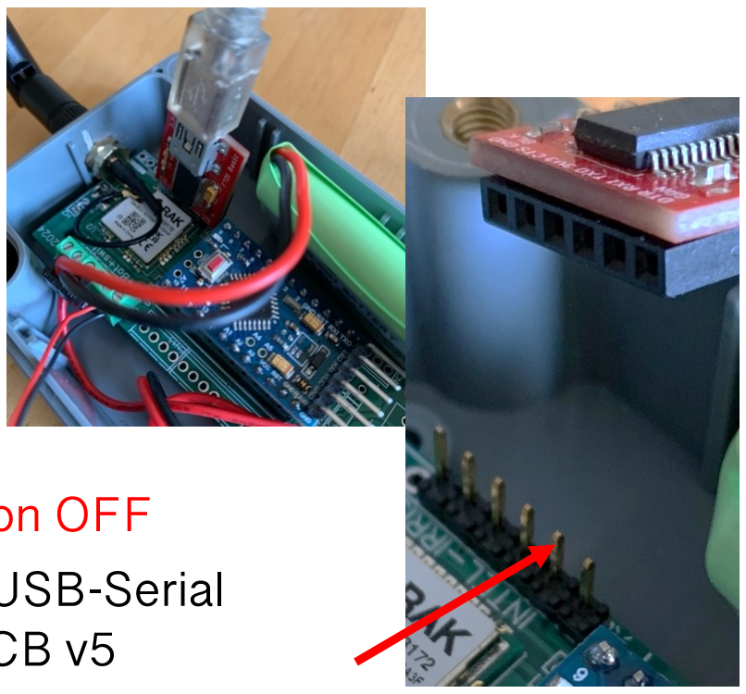
[picture p304: figure]

15

## Connect the FTDI USB-Serial

⊙ After flashing the Arduino with the FTDI USB-Serial cable (left photo), unplug it in order to plug it again on the dedicated debug header on the PCB v5 (middle & right photo)

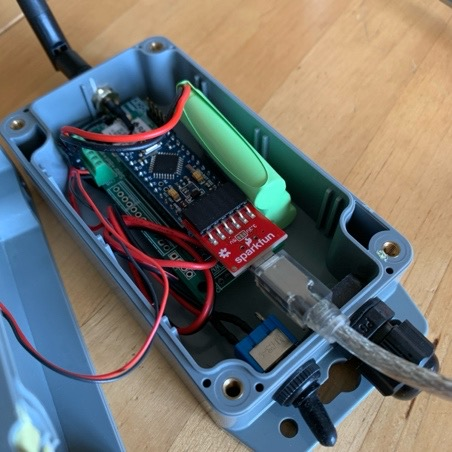
[picture p305: figure]
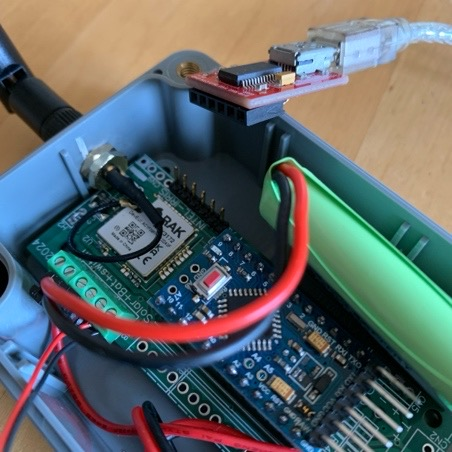
[picture p306: figure]

⊙ Battery should be connected, but switch is on OFF
⊙ Be sure to connect the RX pin of the FTDI USB-Serial to the TX pin of the debug header on the PCB v5

Image shown is the PCBA v5 from INTEL-IRRIS

## Getting text output from the board

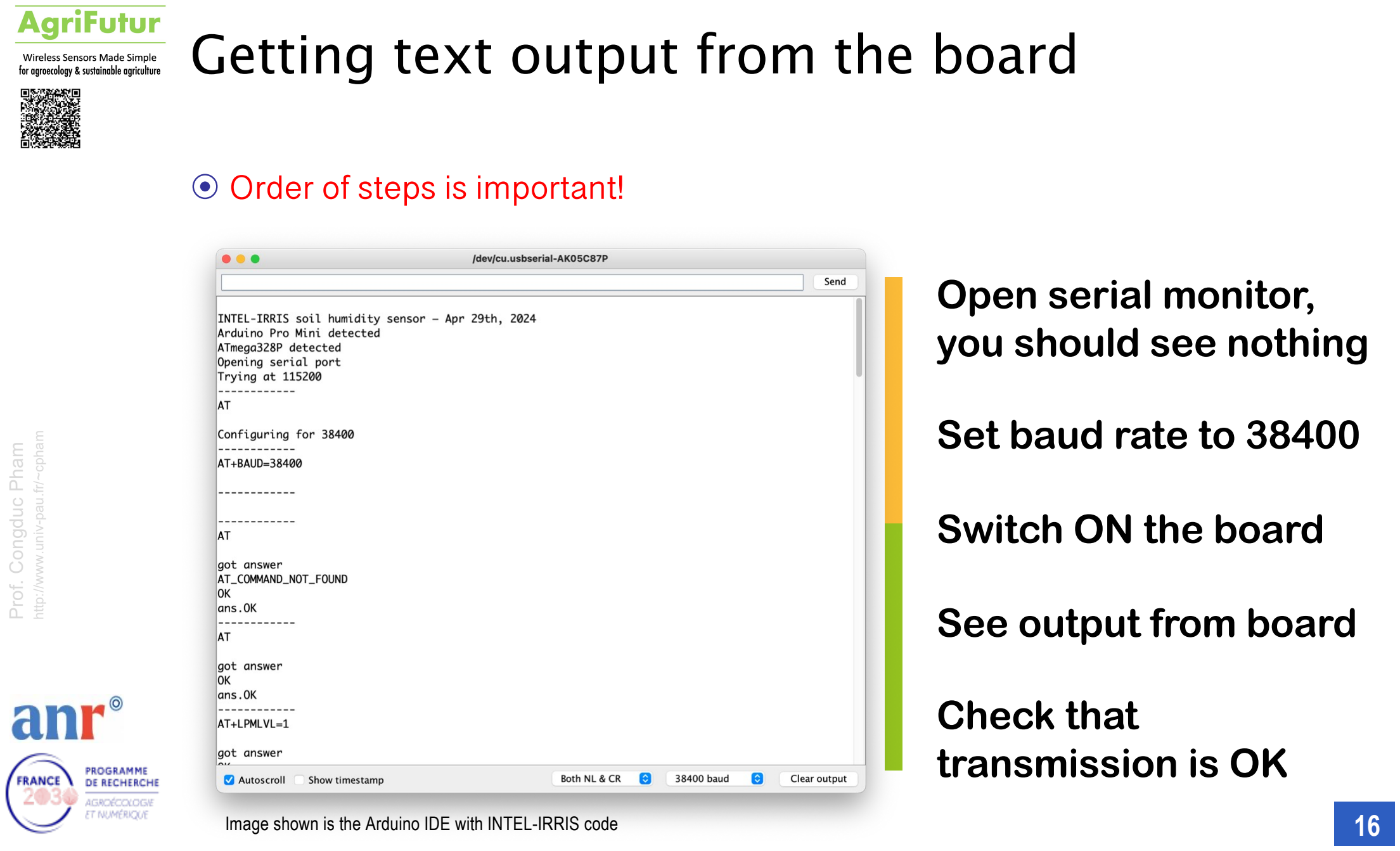
[picture p307: page 16]

Prof. Congduc Pham

http://www.univ-pau.fr/~cpham

16

⊙ Order of steps is important!

Open serial monitor,
you should see nothing

Set baud rate to 38400

Switch ON the board

See output from board

Check that
transmission is OK

Image shown is the Arduino IDE with INTEL-IRRIS code

Prof. Congduc Pham

http://www.univ-pau.fr/~cpham

17

## Configuration summary: check list

⊙ PCBA v5 à
⊙ comment SX127X
⊙ uncomment SOFT_SERIAL_DEBUG and RAK3172
⊙ RAW PCB v5 à comment IRD_PCBA
⊙ No solar panel à default configuration, nothing to do
⊙ Solar panel à uncomment SOLAR_BAT, typically use 3xAAA NiMh ⊙ See "Part 1: sensor device with PCB v4.1" for sensor configuration

Prof. Congduc Pham

http://www.univ-pau.fr/~cpham

18

## Annex: RAK3172 baud rate

⊙ Latest version of RAK3172 is using by default (factory setting) a baud rate of 115200, which is too fast (mostly for RX) for the Arduino Pro mini based on ATMega328P microcontroller
⊙ The device code is actually reprogramming the RAK3172 to use a baud rate of 38400, therefore you do not need to worry about setting the correct baud rate on the RAK3172, especially with the fully assembled version of the PCB where the RAK3172 is provided and assembled on the PCB by the PCB manufacturer

## Annex: IPEX or not IPEX?

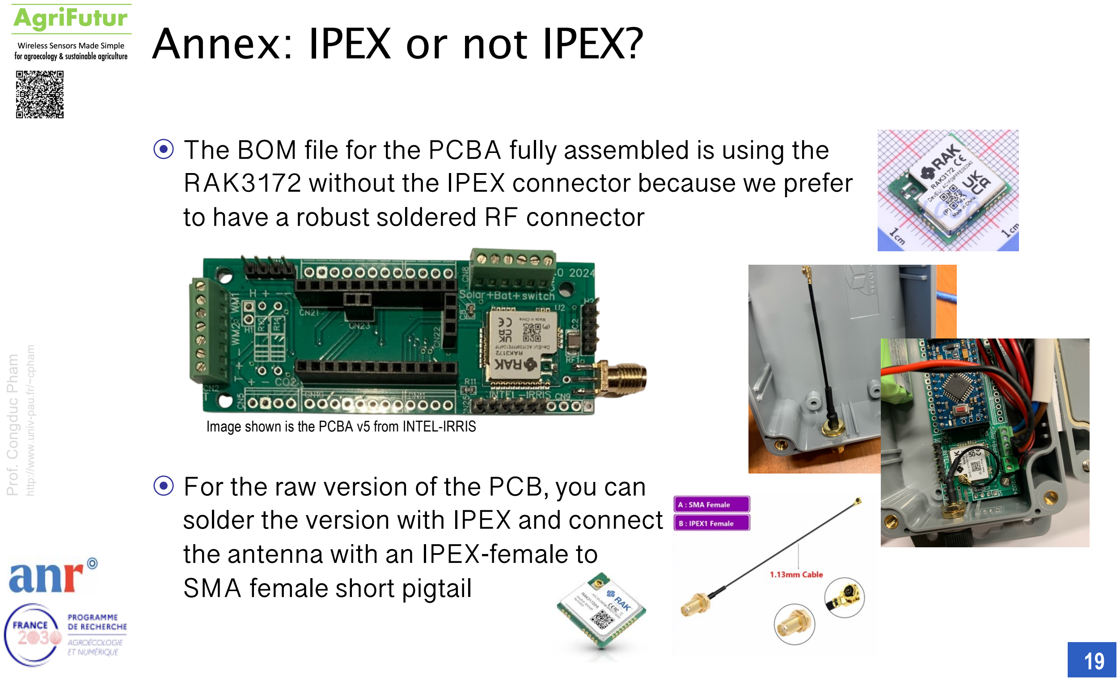
[picture p308: page 19]

Prof. Congduc Pham

http://www.univ-pau.fr/~cpham

19

⊙ The BOM file for the PCBA fully assembled is using the RAK3172 without the IPEX connector because we prefer to have a robust soldered RF connector

⊙ For the raw version of the PCB, you can solder the version with IPEX and connect the antenna with an IPEX-female to
SMA female short pigtail

Image shown is the PCBA v5 from INTEL-IRRIS

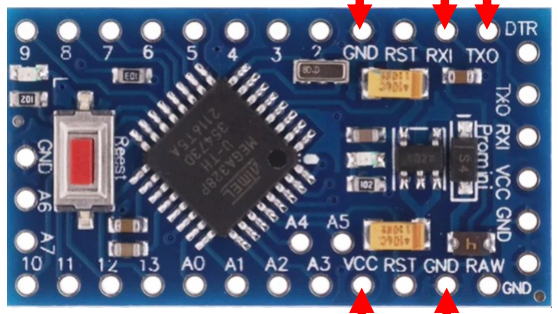
[picture p309: figure]
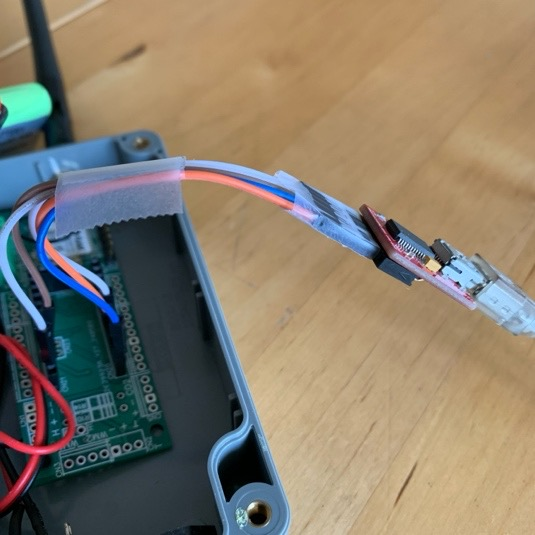
[picture p310: figure]
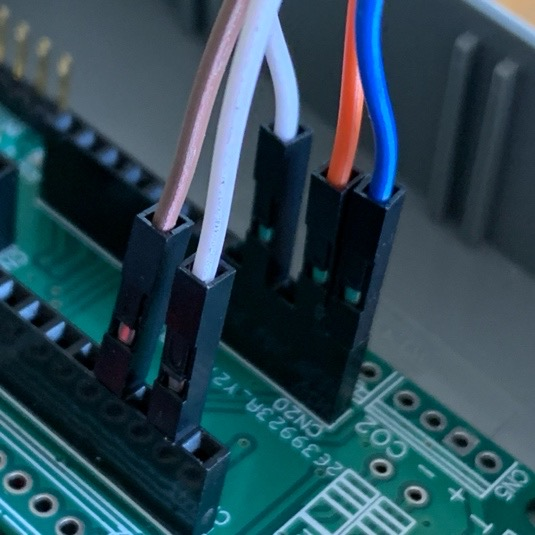
[picture p311: figure]
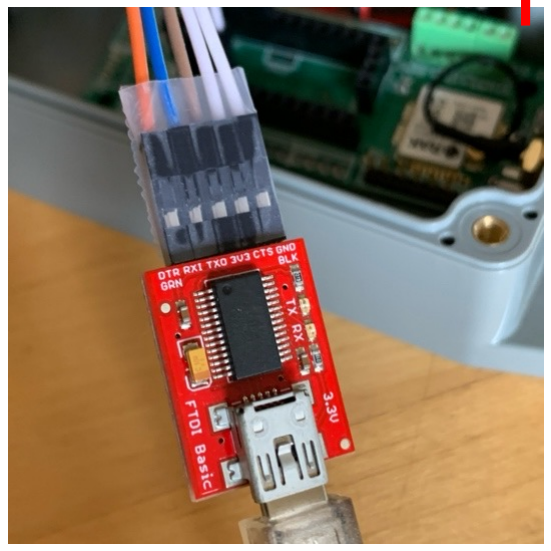
[picture p312: figure]

Prof. Congduc Pham

http://www.univ-pau.fr/~cpham

20

## Annex: update firmware of RAK3172

⊙ The RAK3172's firmware can be upgraded with the RAK DFU tool ⊙ You can use Dupont wires to directly connect
VCC, GND, RX and TX of the FTDI USB-serial
cable to corresponding pins on the female
headers after removing the Arduino Pro Mini from its socket. DTR is not connected

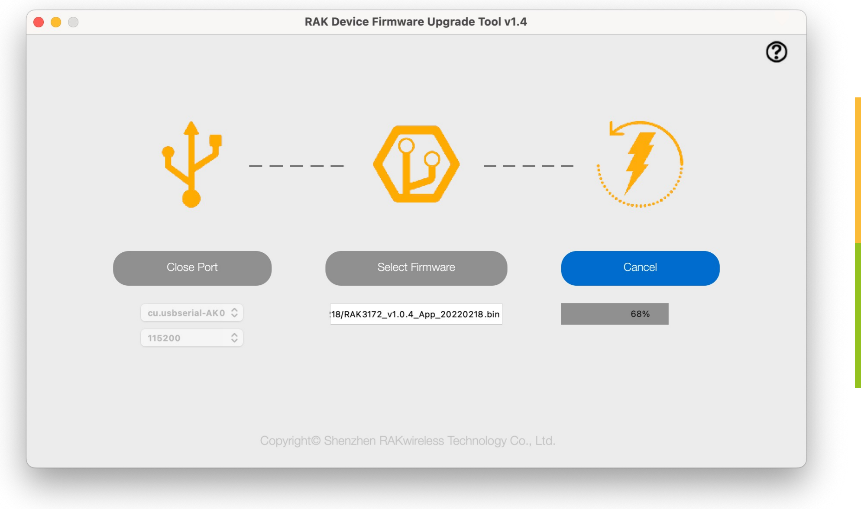
[picture p313: figure]

Prof. Congduc Pham

http://www.univ-pau.fr/~cpham

21

## Annex: RAK DFU tool

⊙ Get latest RAK3172 firmware from https://downloads.rakwireless.com/#RUI/RUI3/Image/usually, it is the RAK3172-E_latest.bin file
⊙ Use RAK DFU tool to flash the new firmware

You may need to issue
AT+BOOT from a serial
tool in order to be
able to upgrade with
DFU tool

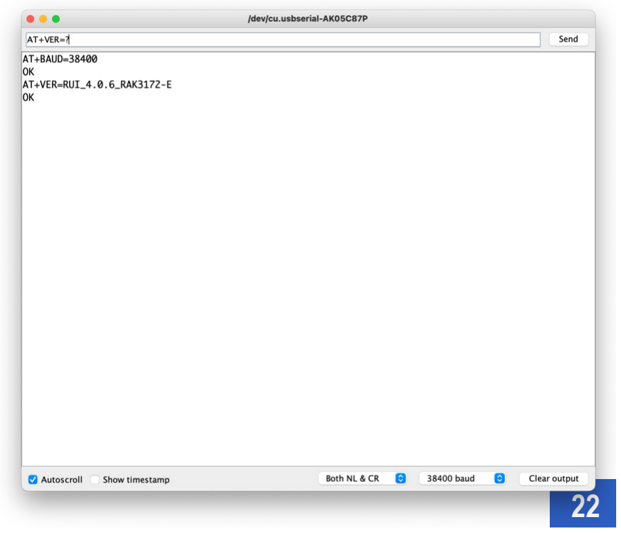
[picture p314: figure]

Prof. Congduc Pham

http://www.univ-pau.fr/~cpham

## Annex: send direct AT commands

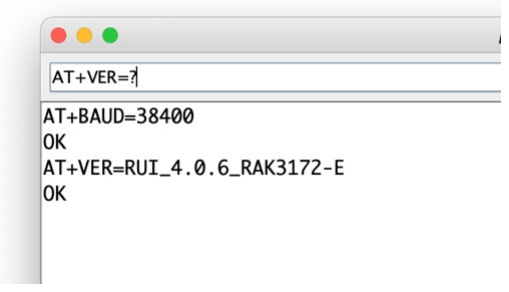
[picture p315: figure]

⊙ With the FTDI USB-serial cable
connected to the PCB v5 without the
Arduino Pro Mini, as show on the previous slide, you can directly communicate with the RAK3172 to send AT commands for test purposes ⊙ Any serial communication tool can be used, including the Arduino IDE serial monitor
⊙ RAK also proposes the WisToolBox software to communicate with RAK components

Prof. Congduc Pham

http://www.univ-pau.fr/~cpham

23

## Annex: AT commands at startup

⊙ Here is the list of AT commands used by the device
⊙ During setup(), for ABP mode in EU868 band, for capacitive

⊙ AT+BAUD=38400
⊙ AT+LPMLVL=1
⊙ AT+LPM=0
⊙ AT+LPM=? ; AT+VER=? ; AT+BAND=? ; AT+ADR=? ; AT+NJM=? ; AT+DEVADDR=?; AT+NWKSKEY=? ; AT+APPSKEY=?
⊙ AT+NJM=0 ; AT+CLASS=A ; AT+BAND=4 ; AT+ADR=0
⊙ AT+DEVADDR=26011DAA
⊙ AT+NWKSKEY=23158D3BBC31E6AF670D195B5AED5525 ⊙ AT+APPSKEY=23158D3BBC31E6AF670D195B5AED5525
⊙ AT+LPMLVL=2
⊙ AT+LPM=1
⊙ On wake up, to transmit (e.g. sending 898 and 3.45, LPP format)
⊙ AT+SEND=1:0067231406020159
⊙ AT+SLEEP

Prof. Congduc Pham

http://www.univ-pau.fr/~cpham

24

## Annex: OTAA with RAK3172 (1)

⊙ The device with the RAK3172 can be integrated into a LoRaWAN ecosystem and configured by OTAA (Over The Air Activation) to dynamically get its address & session keys
⊙ Uncomment ENABLE_OTAA in native_at_lorawan.h

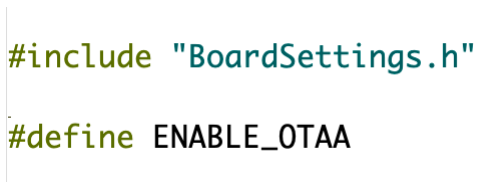
[picture p316: figure]

⊙ When using OTAA, you need to know

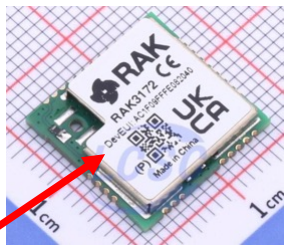
[picture p317: figure]

⊙ DevEUI: unique identifier of the device, it is usually pre-provisioned by the radio module manufacturer and indicated on the radio module
⊙ AppEUI: or JoinEUI, it is usually pre-provisioned by the radio module manufacturer. For RAK, it is usually AC1F09FFF8683172
⊙ AppKey: it is usually pre-provisioned by the radio module manufacturer. For RAK it is usually DevEUI+AppEUI

Prof. Congduc Pham

http://www.univ-pau.fr/~cpham

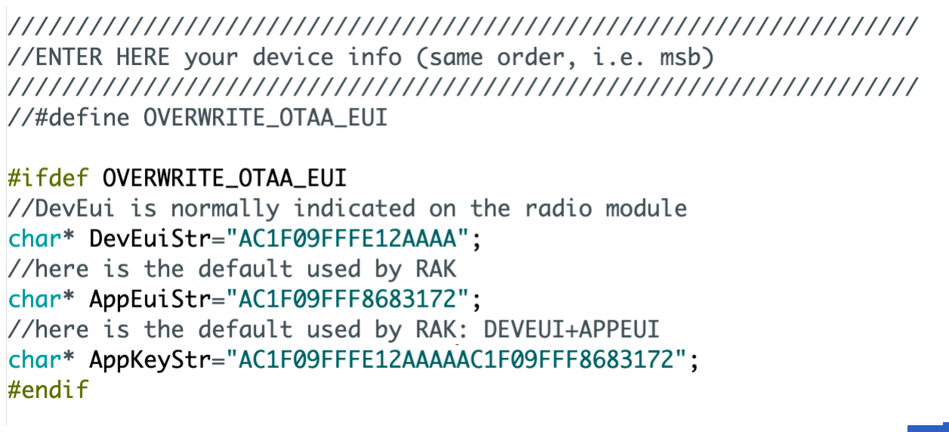
[picture p318: figure]

25

## Annex: OTAA with RAK3172 (2)

⊙ It is possible to use the default values pre-provisioned by the manufacturer for DevEUI, AppEUI and AppKey IF YOU DIDN'T UPGRADE THE FIRMWARE
⊙ Leave OVERWRITE_OTAA_EUI commented
⊙ If RAK3172 firmware has been updated, they may not be set anymore! In this case, uncomment OVERWRITE_OTAA_EUI in native_at_lorawan.cpp and set in DevEUI, AppEUI and AppKey
⊙ Flash device and run once
to set DevEUI, AppEUI and
AppKey in the RAK module
⊙ Then, comment
OVERWRITE_OTAA_EUI
to flash again and run

Prof. Congduc Pham

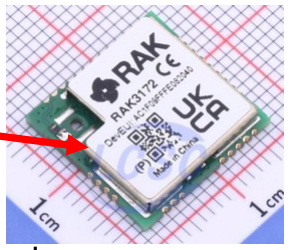
[picture p319: figure]

http://www.univ-pau.fr/~cpham

26

## Annex: register an OTAA device

⊙ To register your RAK3172 OTAA device on a LoraWAN Network Server such as TheThingNetwork (TTN) you can then just enter
⊙ DevEUI: get it from the sticker
For instance AC1F09FFFE12AAAA
⊙ AppEUI or JoinEUI: it is AC1F09FFF8683172
⊙ AppKey: should be AC1F09FFFE12AAAAAC1F09FFF8683172
⊙ That's all. Once powered your device will join and you should receive data if a LoRaWAN gateway is near your device
⊙ IMPORTANT, the gateway is not full LoRaWAN in its single-channel version
⊙ We will discuss how to get data from an OTAA device, locally on the gateway in a dedicated tutorial
