CongducPham/PEPR_AgriFutur/Tutorials/slides-summary.pdf

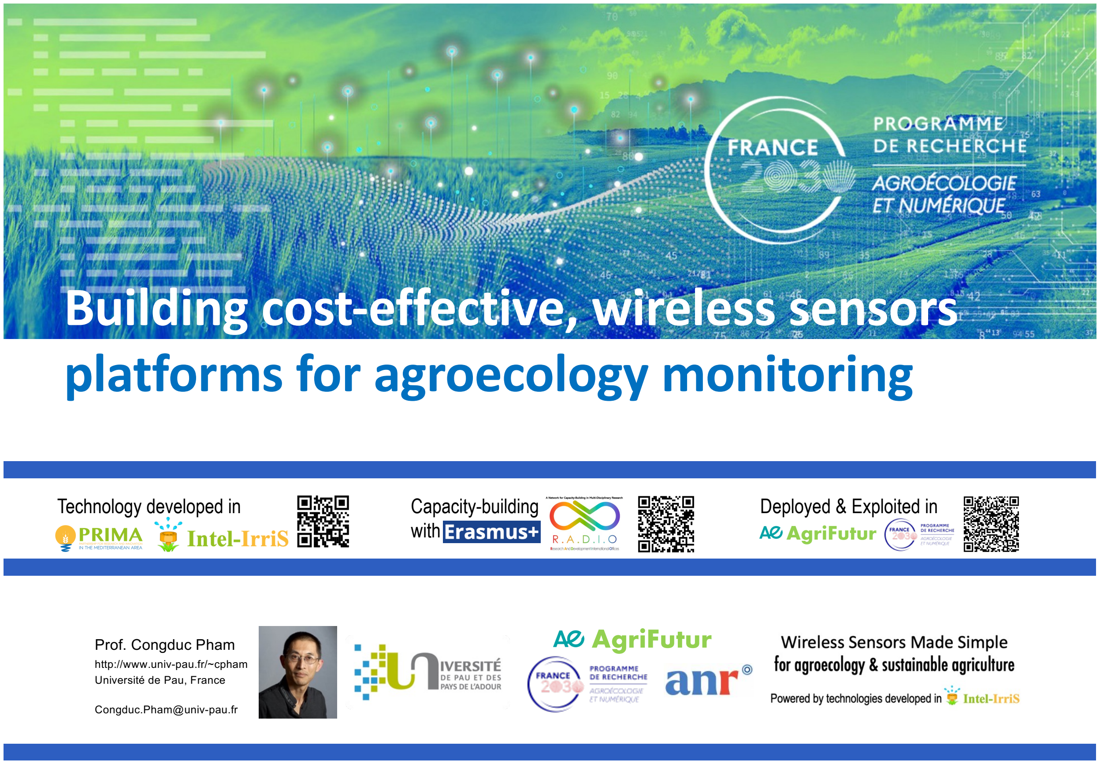
[picture p320: page 1]

Prof. Congduc Pham

http://www.univ-pau.fr/~cpham Université de Pau, France

Congduc.Pham@univ-pau.fr

AgriFutur

# Building cost-effective, wireless sensors platforms for agroecology monitoring

Technology developed in | Capacity-building with

Deployed & Exploited in
AgriFutur

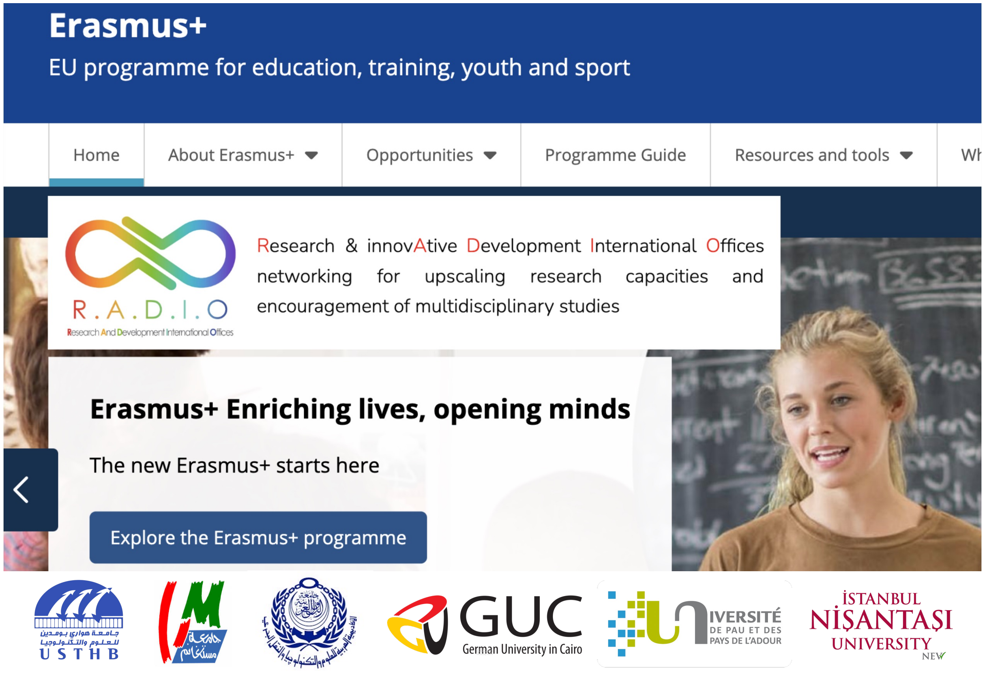
[picture p321: page 2]

Prof. Congduc Pham

http://www.univ-pau.fr/~cpham

Technology developed in | Capacity-building with

Deployed & Exploited in
AgriFutur

# BUILDING AN ECOSYSTEM OF SENSORS

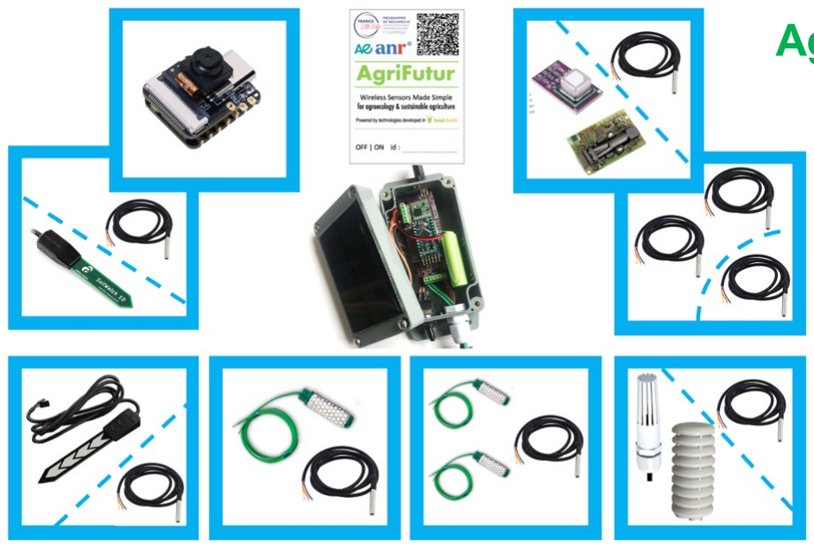
[picture p322: figure]

# Agriculture

# Agroecology

# Biodiversity

# Environment

# Surveillance

# Wildlife

# DESIGNING A CUSTOM PCB

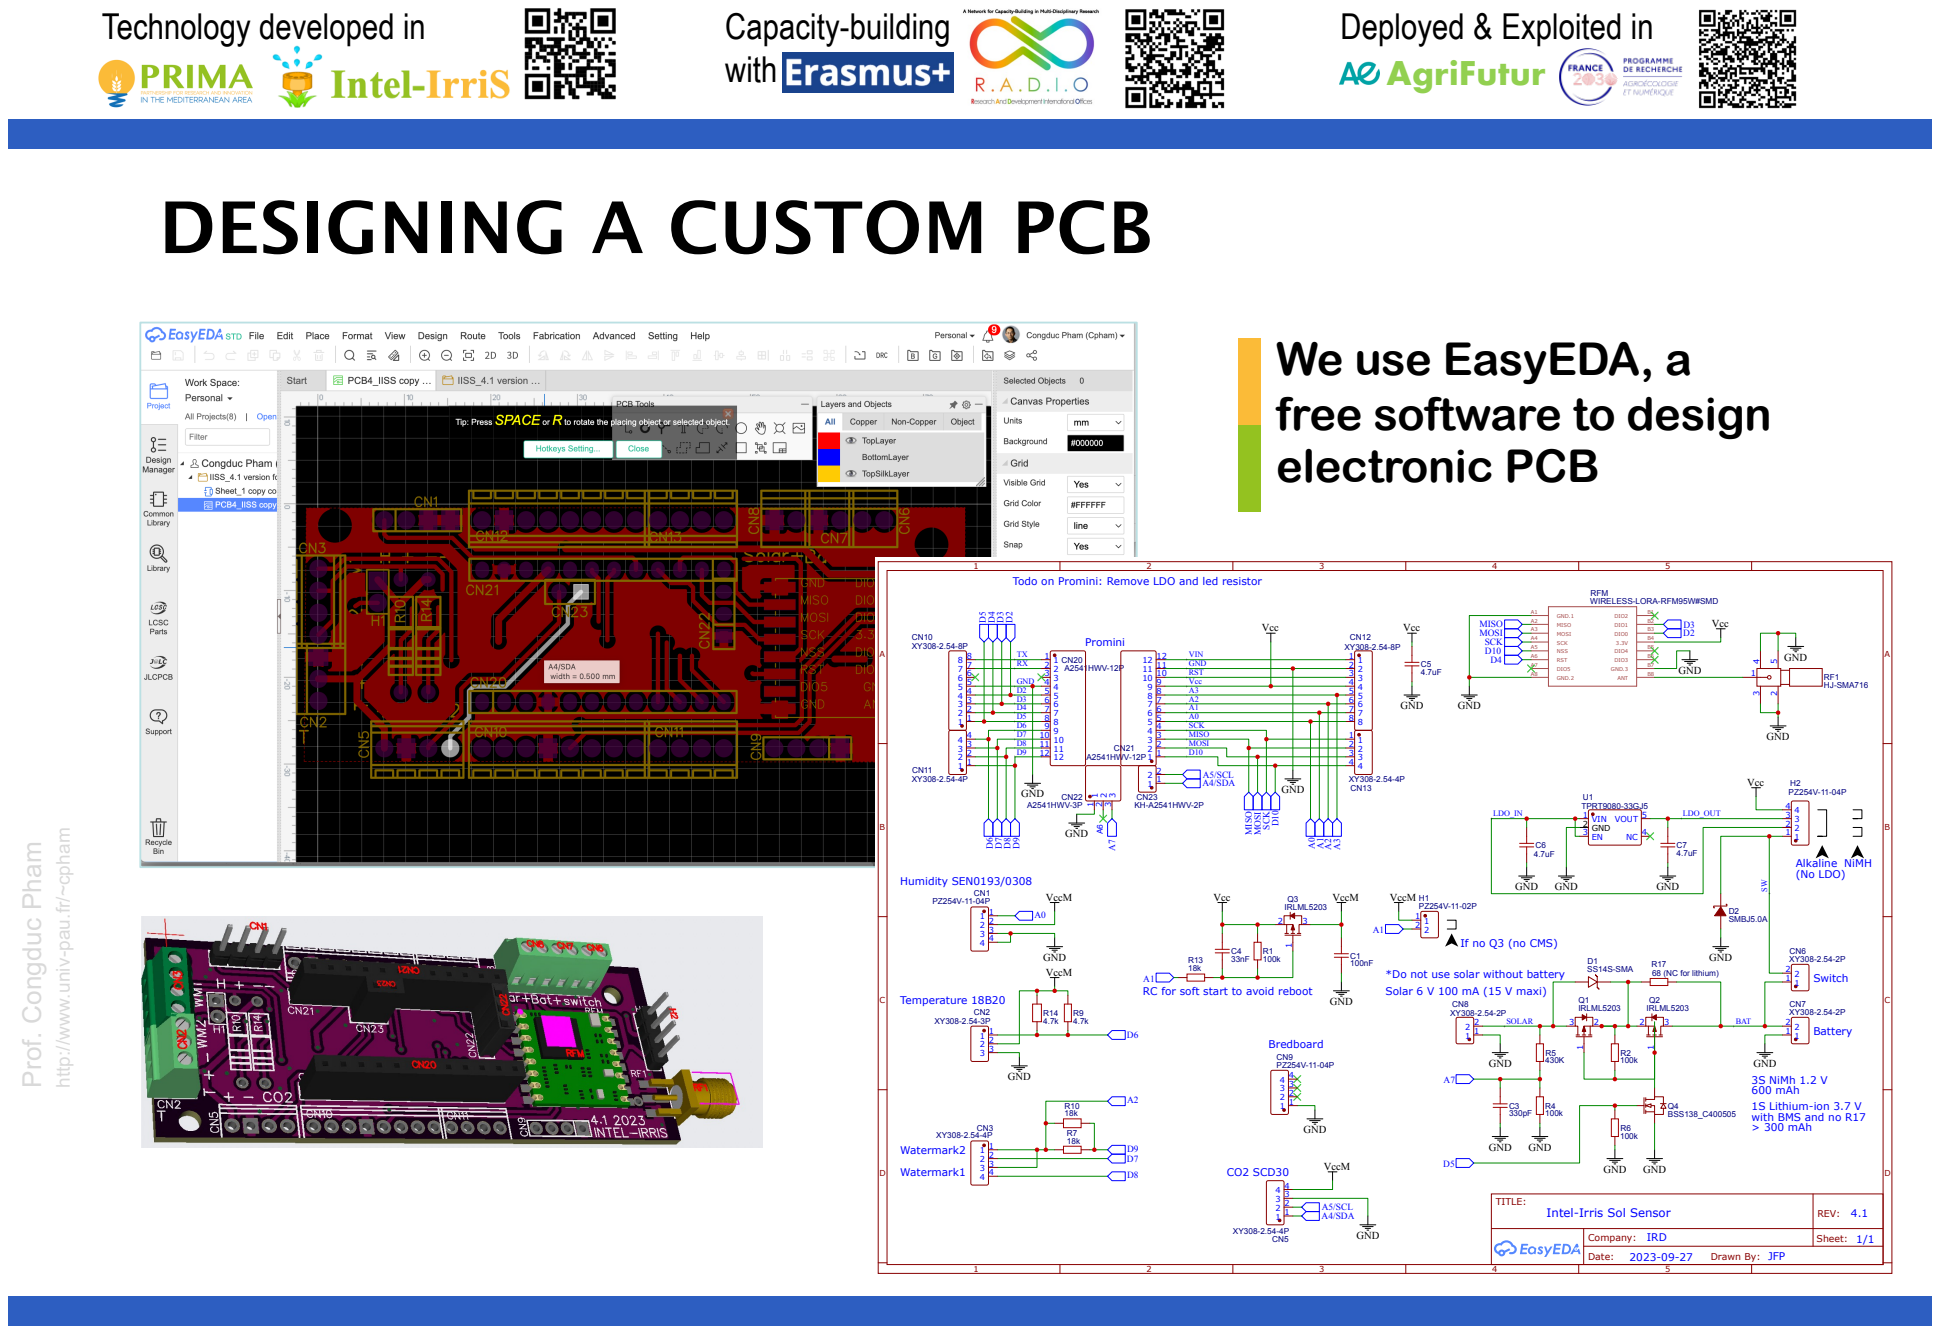
[picture p323: page 4]

We use EasyEDA, a
free software to design
electronic PCB

Todo on Promini: Remove LDO and led resistor

WIRELESS-LORA-RFM95W#SMD RFM

http://www.univ-pau.fr/~cpham

If no Q3 (no CMS)

*Do not use solar without battery
Solar 6 V 100 mA (15 V maxi)

RC for soft start to avoid reboot

1S Lithium-ion 3.7 V
with BMS and no R17 > 300 mAh

# ORDERING THE PCB

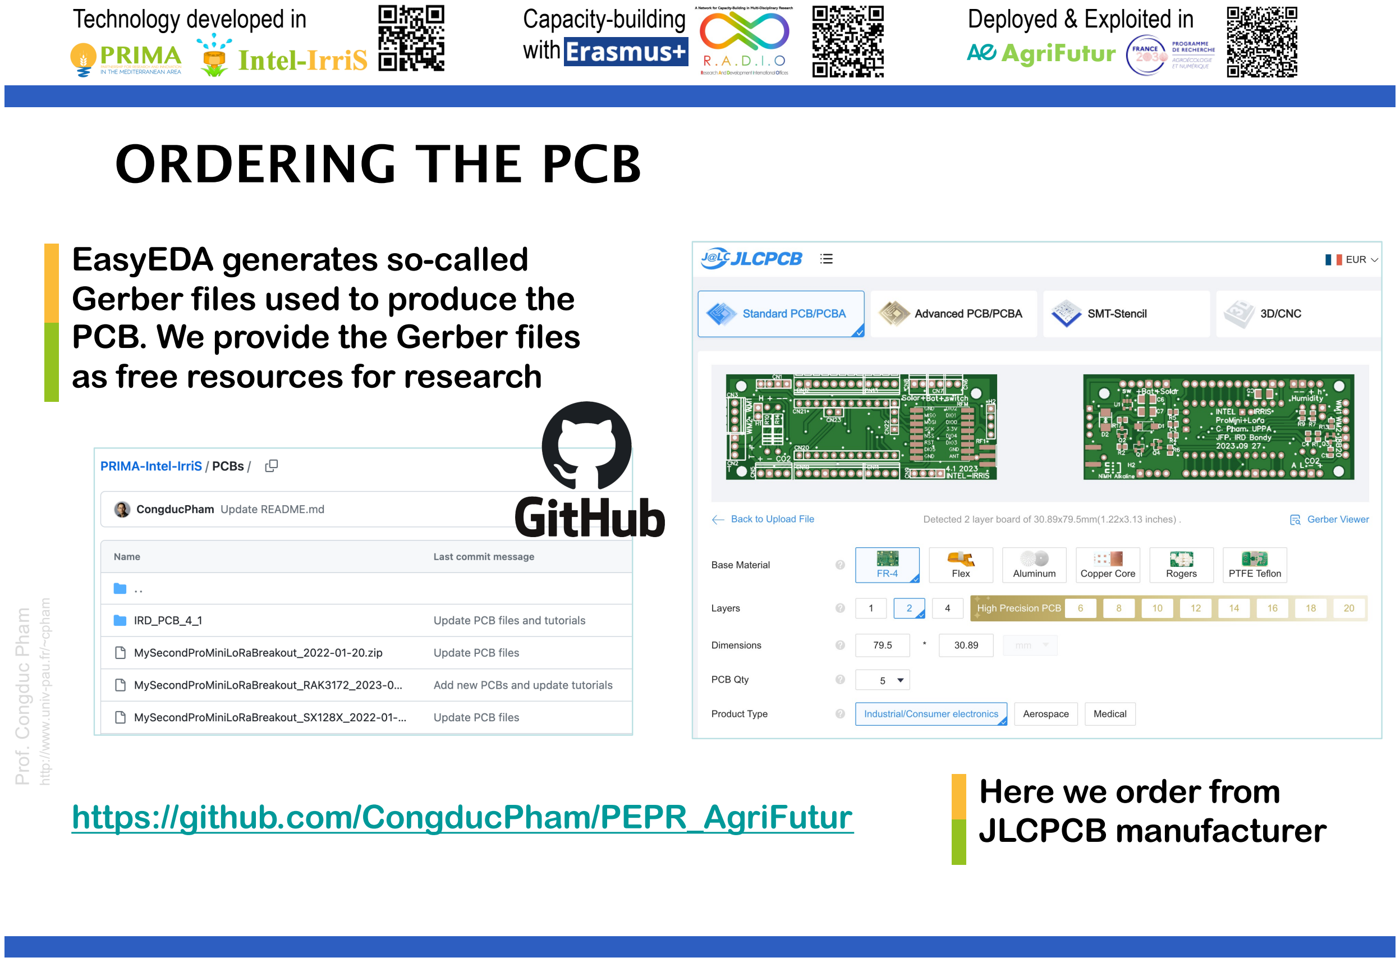
[picture p324: page 5]

Prof. Congduc Pham

http://www.univ-pau.fr/~cpham

with
AgriFutur

### Here we order from JLCPCB manufacturer

### EasyEDA generates so-called Gerber files used to produce the PCB. We provide the Gerber files as free resources for research

### https://github.com/CongducPham/PEPR_AgriFutur

# DO-IT-YOURSELF APPROACH – RAW PCB

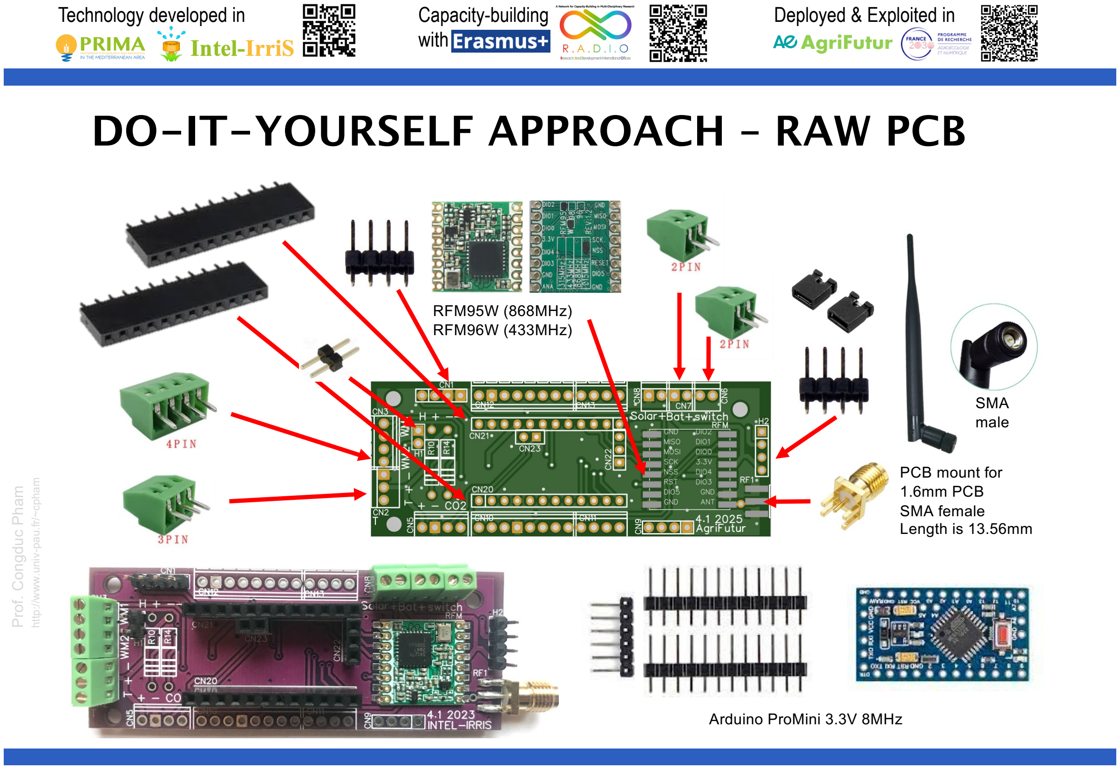
[picture p325: page 6]

Prof. Congduc Pham

http://www.univ-pau.fr/~cpham

with
AgriFutur

RFM95W (868MHz)
RFM96W (433MHz)

PCB mount for
1.6mm PCB
SMA female
Length is 13.56mm

Arduino ProMini 3.3V 8MHz

SMA
male

# ORDER THE FULLY ASSEMBLED VERSION

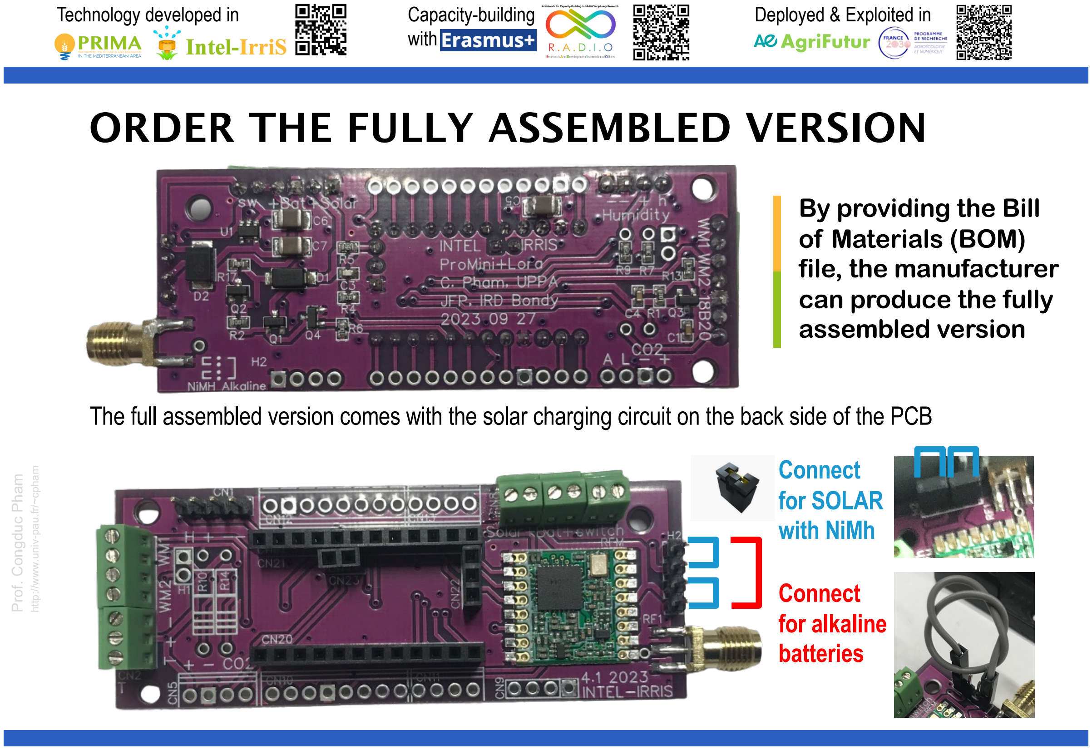
[picture p326: page 7]

Prof. Congduc Pham

http://www.univ-pau.fr/~cpham

with
AgriFutur

### Connect for SOLAR with NiMh

### Connect for alkaline batteries

The full assembled version comes with the solar charging circuit on the back side of the PCB

### By providing the Bill of Materials (BOM) file, the manufacturer can produce the fully assembled version

# CASING AND INTEGRATION

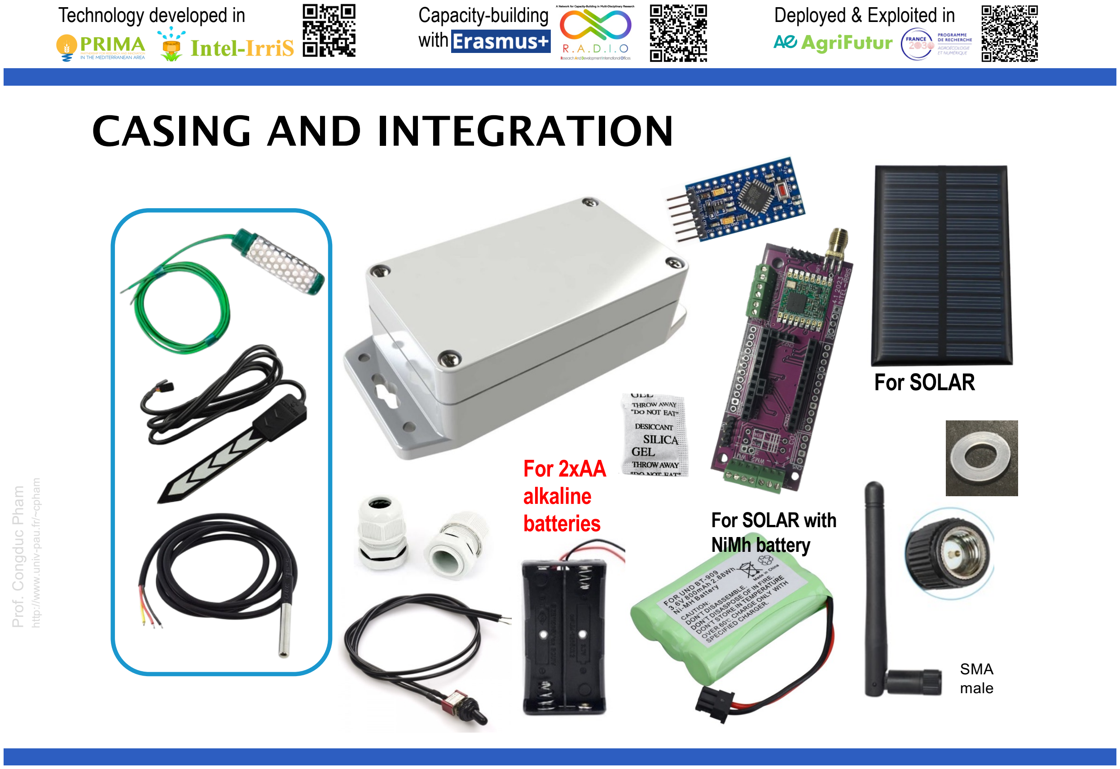
[picture p327: page 8]

Prof. Congduc Pham

http://www.univ-pau.fr/~cpham

with
AgriFutur

SMA
male

For SOLAR with
NiMh battery

For 2xAA
alkaline
batteries

For SOLAR

# ADDING PHYSICAL SENSORS. EX:

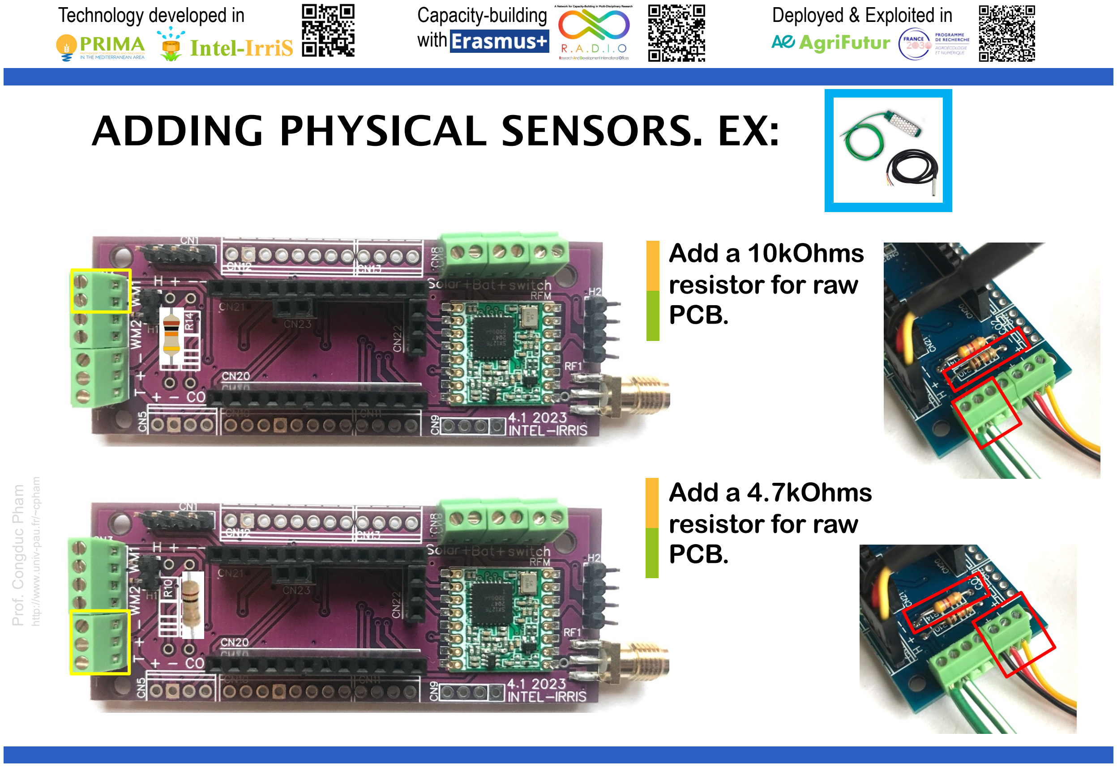
[picture p328: page 9]

Prof. Congduc Pham

http://www.univ-pau.fr/~cpham

with
AgriFutur

### Add a 4.7kOhms resistor for raw

PCB.

### Add a 10kOhms resistor for raw

PCB.

# ADD THE MICROCONTROLLER

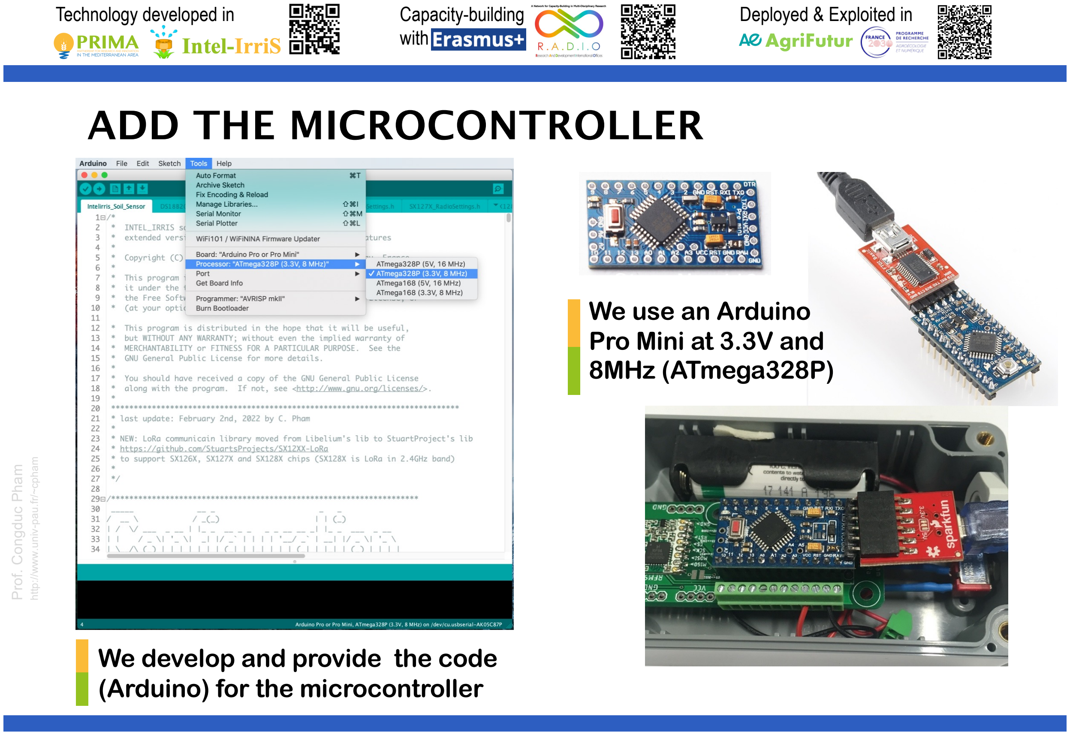
[picture p329: page 10]

Prof. Congduc Pham

http://www.univ-pau.fr/~cpham

with
AgriFutur

### We develop and provide the code (Arduino) for the microcontroller

### We use an Arduino Pro Mini at 3.3V and 8MHz (ATmega328P)

# FINAL RESULTS

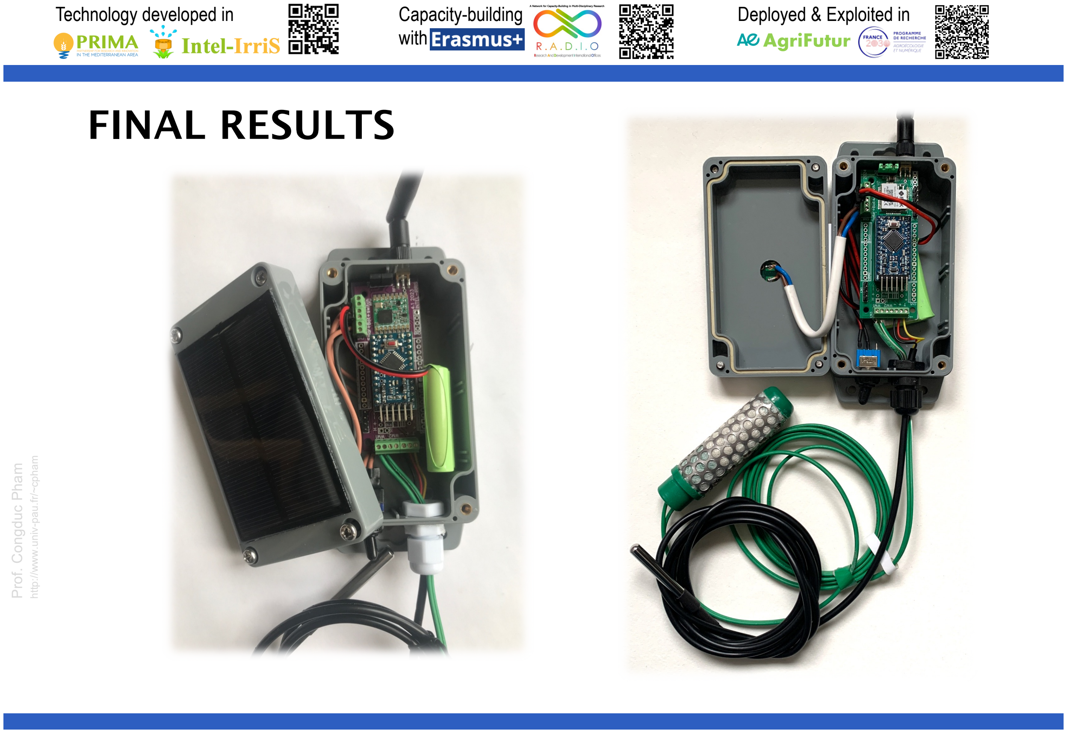
[picture p330: page 11]

Prof. Congduc Pham

http://www.univ-pau.fr/~cpham

with
AgriFutur

# DEPLOYMENT & PILOTING

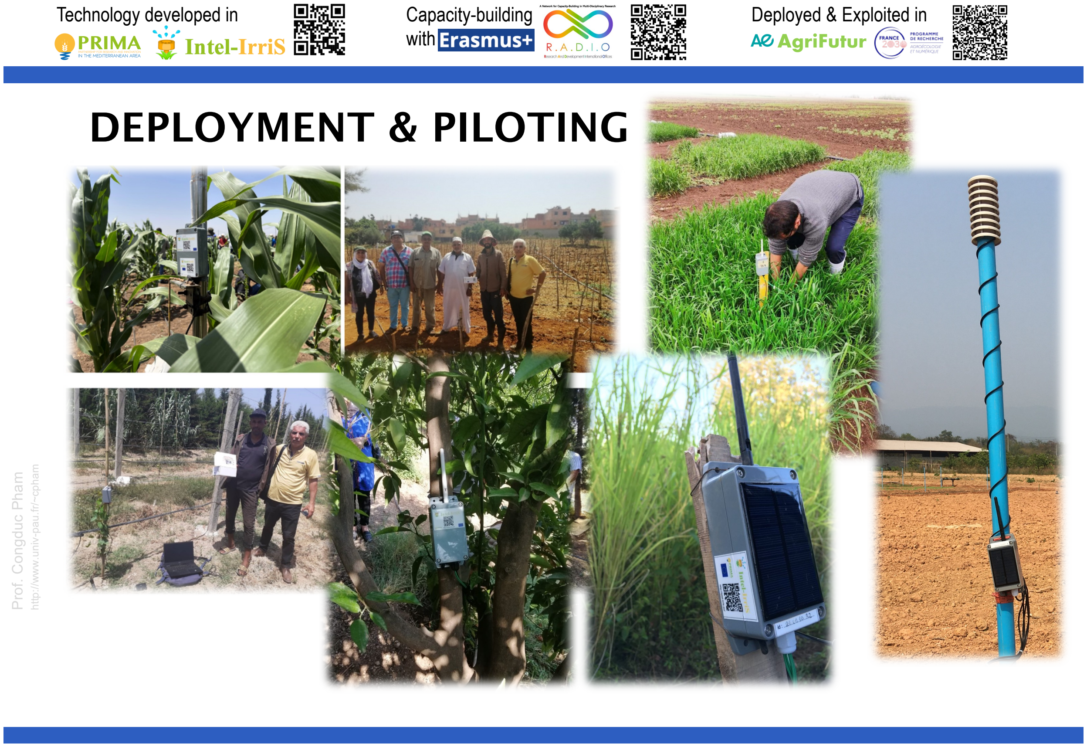
[picture p331: page 12]

Prof. Congduc Pham

http://www.univ-pau.fr/~cpham

with
AgriFutur

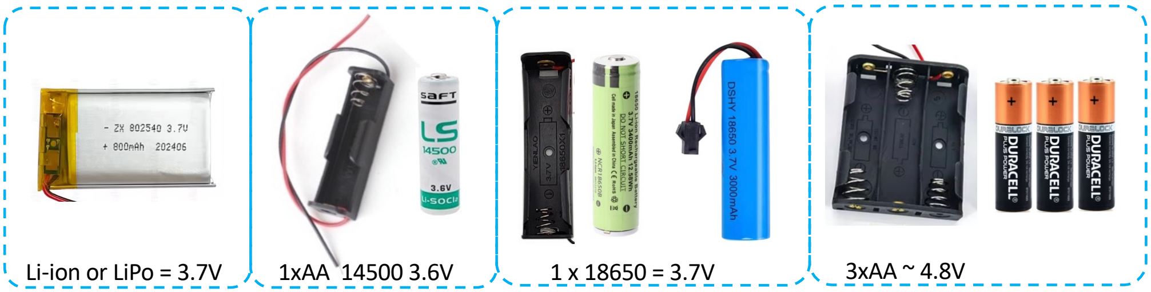
[picture p332: figure]
Li-ion or LiPo = 3.7V; 1xAA 14500 3.6V; 3xAA ~ 4.8V

Prof. Congduc Pham

http://www.univ-pau.fr/~cpham

with
AgriFutur

# ENERGY EFFICIENCY

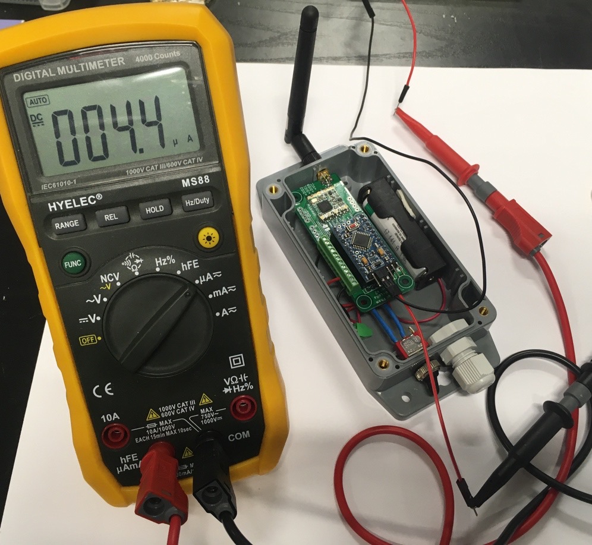
[picture p333: figure]

## Measured below 5uA in deep sleep, between 2 active periods with transmissions

## Expected autonomy with 1 transmission / hour is over 2 years with 2 AA batteries

# DATA TRANSMISSION TO GATEWAY

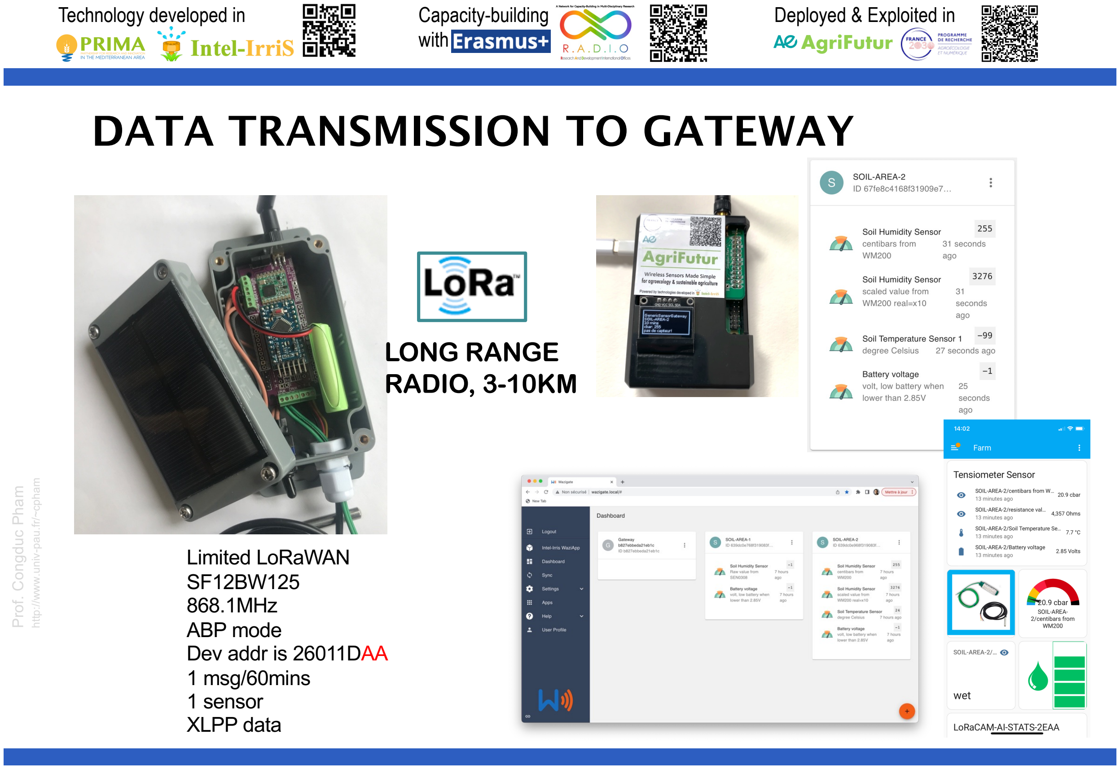
[picture p334: page 14]

Prof. Congduc Pham

http://www.univ-pau.fr/~cpham

with
AgriFutur

Limited LoRaWAN
SF12BW125
868.1MHz
ABP mode
Dev addr is 26011DAA
1 msg/60mins
1 sensor
XLPP data

### LONG RANGE RADIO, 3-10KM

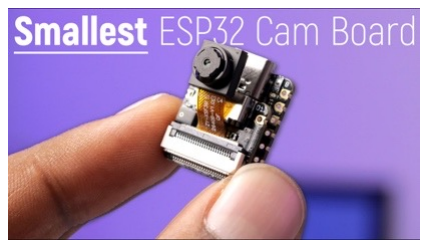
[picture p335: figure]
Sense

Prof. Congduc Pham

http://www.univ-pau.fr/~cpham

with
AgriFutur

# ADVANCED SENSING SYSTEMS

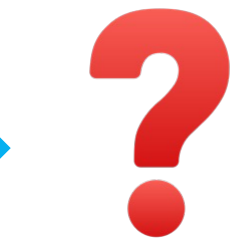
[picture p336: figure]
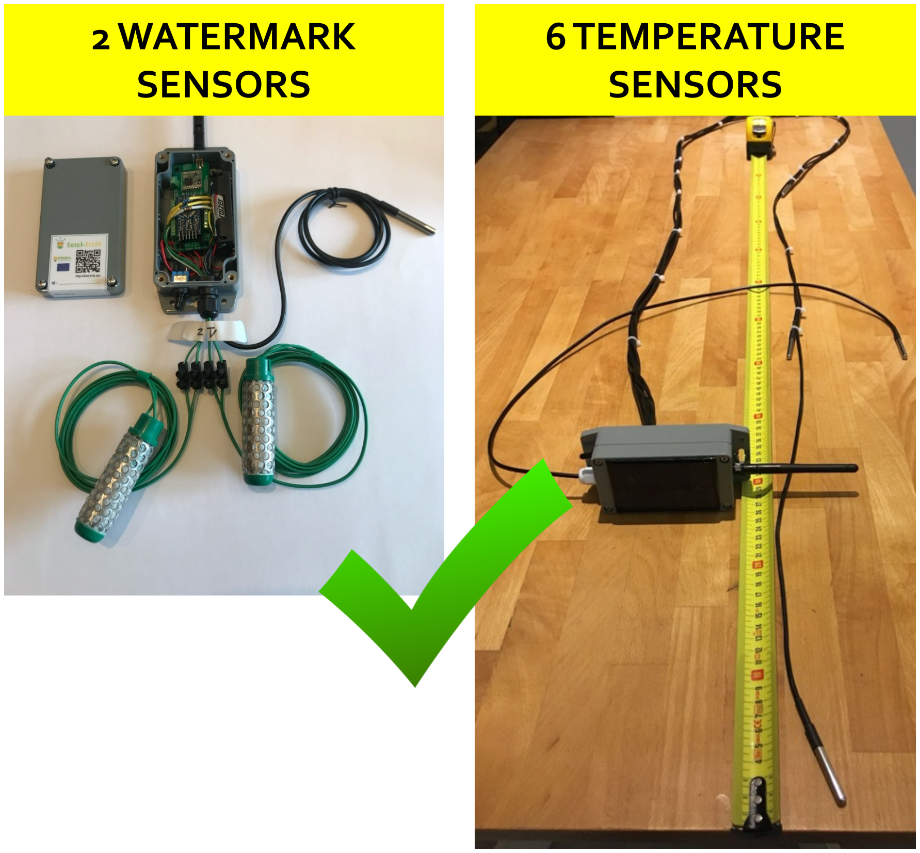
[picture p337: figure]
2 WATERMARK SENSORS; 6 TEMPERATURE SENSORS

## ⊙ Many applications need visual information à Image Sensing IoT

AIR
TEMP/HUM

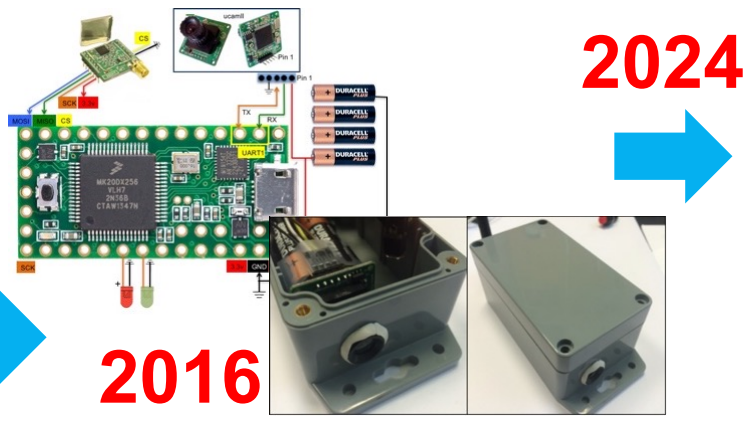
[picture p338: figure]
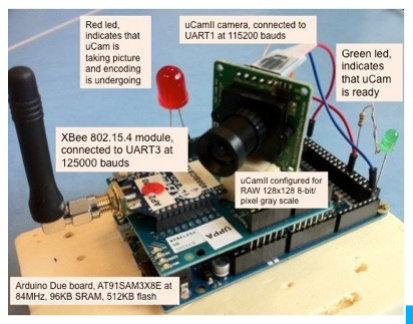
[picture p339: figure]

2012 2016

## XIAO ESP32S3

ESP32S3 32-
bit, dual-core,
up to 240
MHz

# PROOF-OF-CONCEPT: LORACAM-AI

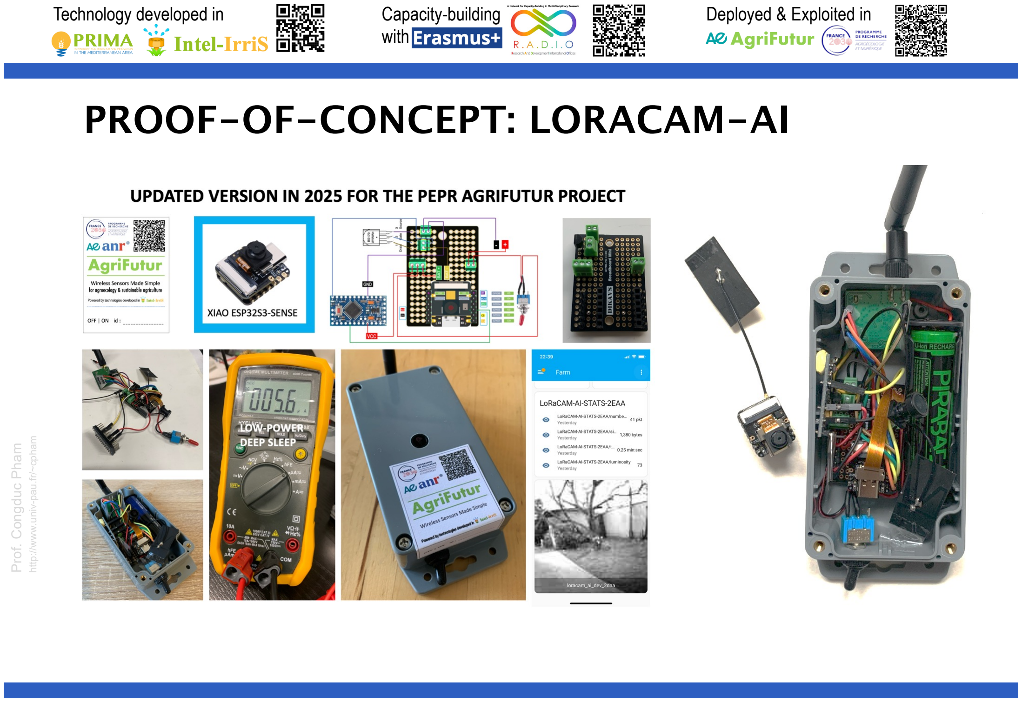
[picture p340: page 16]

Prof. Congduc Pham

http://www.univ-pau.fr/~cpham

with
AgriFutur

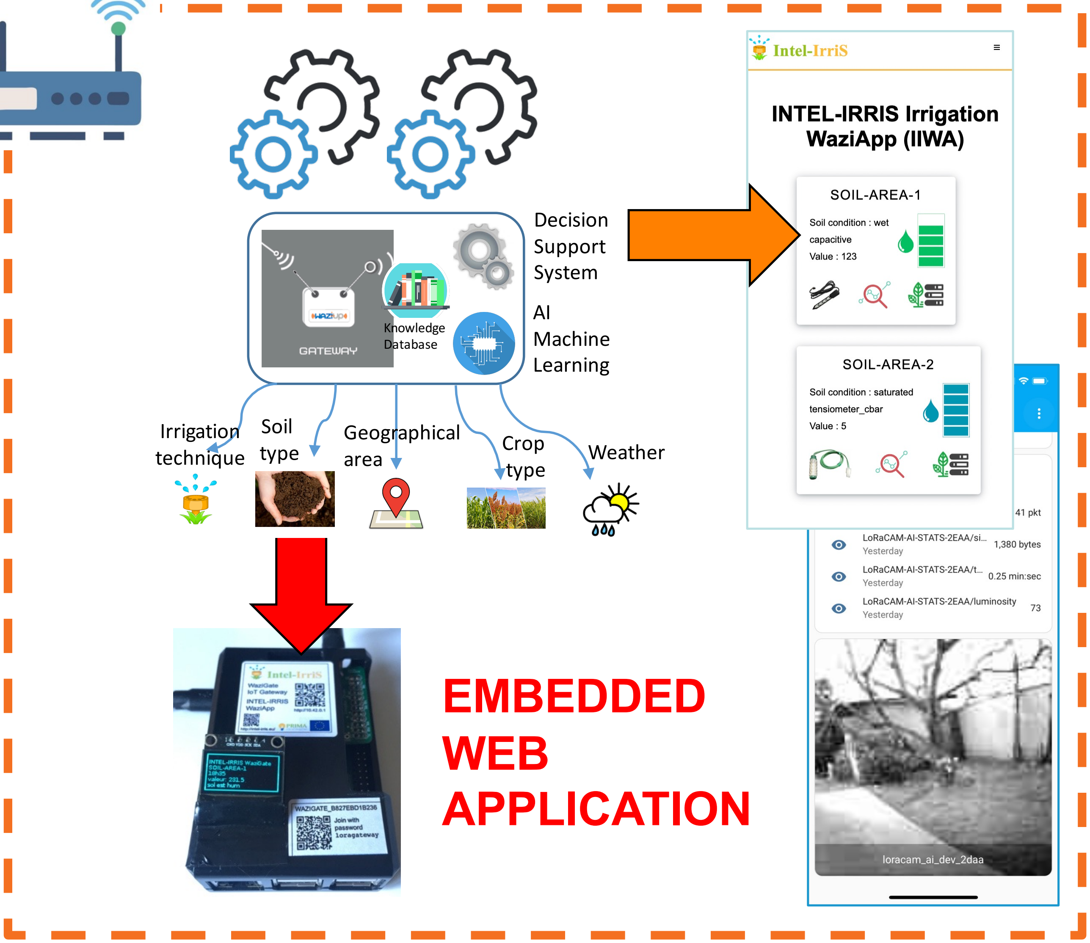
[picture p341: figure]
Soil; type; Weather Crop; Geographical area; Decision Support System; AI Machine Learning; Knowledge Database; Irrigation technique; EMBEDDED WEB APPLICATION

Prof. Congduc Pham

http://www.univ-pau.fr/~cpham

with
AgriFutur

# INTELLIGENCE AT THE EDGE

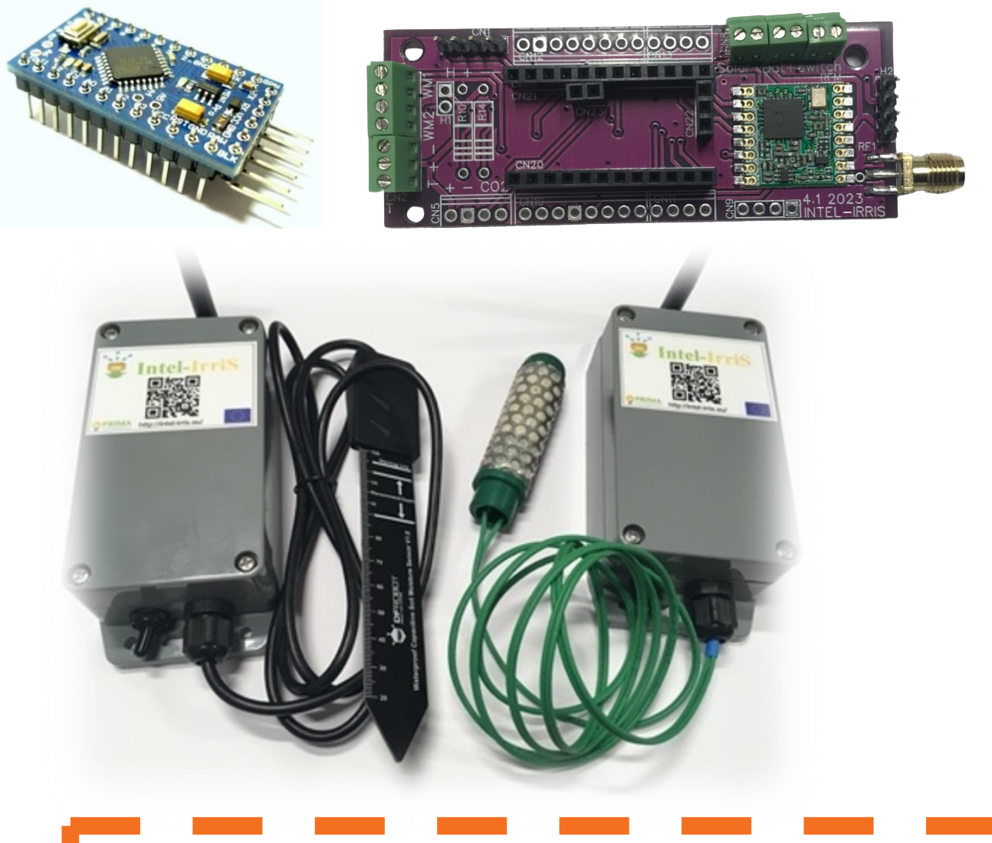
[picture p342: figure]
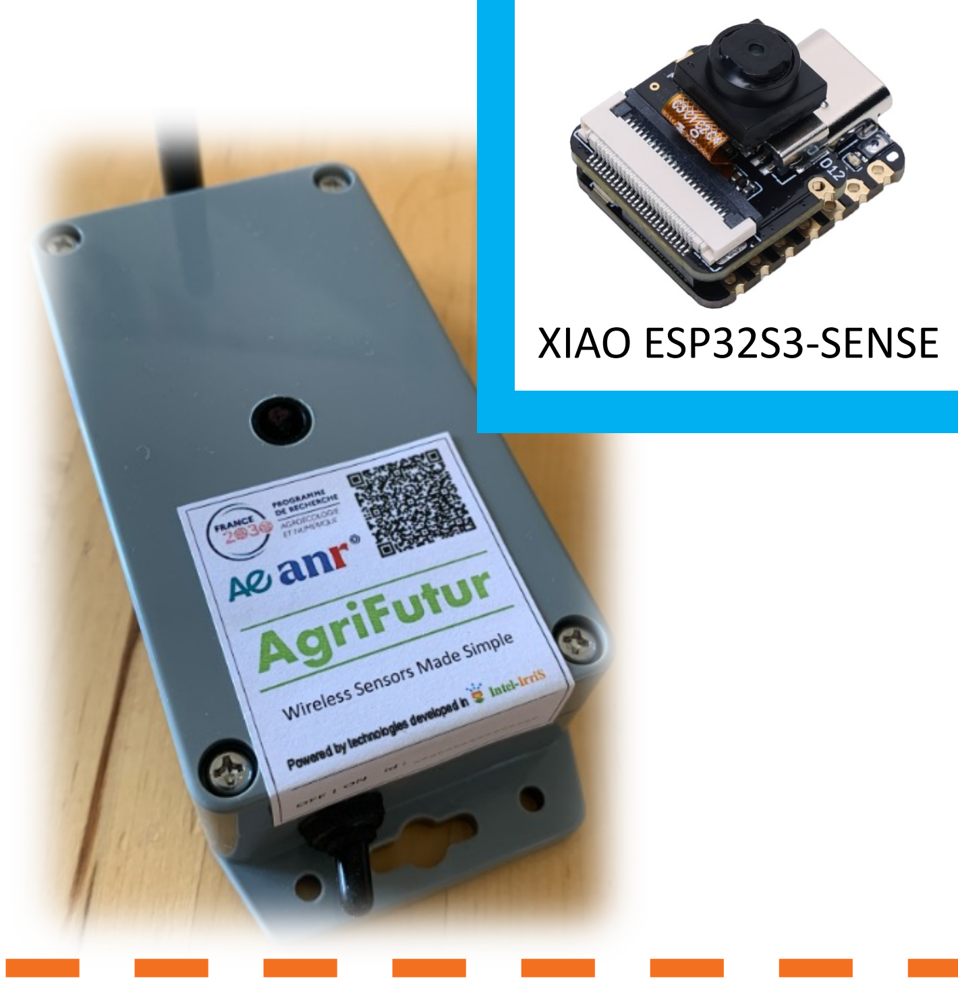
[picture p343: figure]
XIAO ESP32S3-SENSE

TinyML, TensorFlow Lite,
CMSIS-NN, Edge Impulse, etc
