CongducPham/PEPR_AgriFutur/Gateway/scripts/sensecaps2120/SenseCap-S2120-WaziGate_OTAA_instructions.pdf

# SenseCap S2120 LoRaWAN Weather Station integration with the WaziGate

The SenseCap S2120 Weather Station by Seeed Studio is an exceptional addition to your Internet of Things (IoT) solution. This weather station is engineered to provide comprehensive weather data with a focus on meteorological measurements. Equipped with a range of environmental sensors, the S2120 delivers real-time weather information and ensures data accuracy through advanced technology.

The SenseCap S2120 incorporates state-of-the-art sensors for temperature, humidity, air pressure, wind speed, wind direction, rainfall, and more. These sensors work together seamlessly to capture precise meteorological data, which is then transmitted wirelessly to your designated IoT server using LoRaWAN technology. LoRaWAN ensures long-range data communication with minimal power consumption, making it a robust choice for remote and wide-area deployments.

Powered by a long-lasting battery, the S2120 weather station can operate continuously for an extended period, minimizing maintenance and enabling uninterrupted data collection. Its exceptional design and quality construction make it a reliable choice for various environmental monitoring applications.

The SenseCap S2120 Weather Station is the ideal solution for applications such as weather monitoring, environmental research, precision agriculture, and smart city projects. With its accurate and timely weather data, this weather station empowers your IoT infrastructure, enabling data-driven decisions for a wide range of industries and applications. Experience the future of weather monitoring with the SenseCap S2120 Weather Station by Seeed Studio.

# 1)Connecting to WaziGate - OTAA mode

## Step 1 : Setup a WaziGate & Seeedstudio SenseCap S2120

Recommended Hardware:
- WaziGate
- RAK 2247 LoRa HAT: For LoRa Over The Air Activation (OTAA) a multichannel LoRa module is needed. It has benefits in many areas like:Improved Network Accessibility, Robustness, Enhanced Network Capacity, Load Balancing, Compatibility, Future-Proofing
- Antennas for the selected frequency
- Micro SD-Card

Setup WaziGate:
Here is a tutorial on how to setup a Wazigate: https://lab.waziup.io/resources/waziup/wazigate#prepare-the-gateway-hardware

Setup SenseCap S2120:
In the following there are the steps explained to change the connection settings of the SenseCap weather station. It is done by using an Android or iOS app. The name of the App is SenseCap, you will find it in PlayStore (https://play.google.com/store/apps/details?id=cc.seeed.sensecapmate&hl=en&gl=US) or AppStore. (https://apps.apple.com/gb/app/sensecap-mate/id1619944834)

After installing you can make a connection to the sensor, it is done via bluetooth, so you need to be close to the weather station.

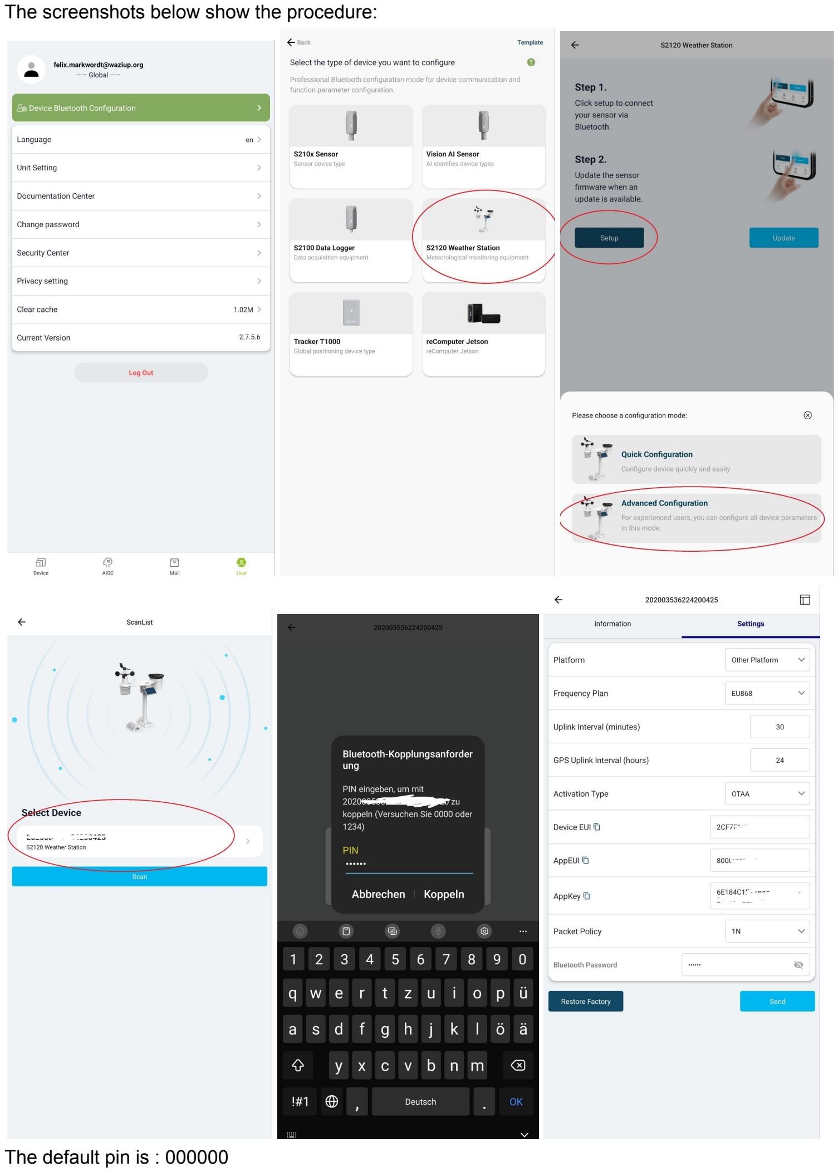
[picture p354: page 3]

The screenshots below show the procedure:

The default pin is : 000000

## Step 2 : Create a new device profile on ChirpStack

Using a Web browser, open ChirpStack UI at wazigate.local:8080 (http://wazigate.local:8080/#/) . The default username and password is admin admin.

Next, go to the “Device-profiles” and click the “ + Create” button.


Now we need to enter the following details for the new device profile. Feel free to use a different “Device-profile name”

(a) For “GENERAL” enter the following information:
- Network-server * = Local ChirpStack Network Server
- LoRaWAN MAC version * = 1.0.3
- LoRaWAN Regional Parameters revision * = A
- Max EIRP * = 14
- Uplink interval (seconds) * = 1200

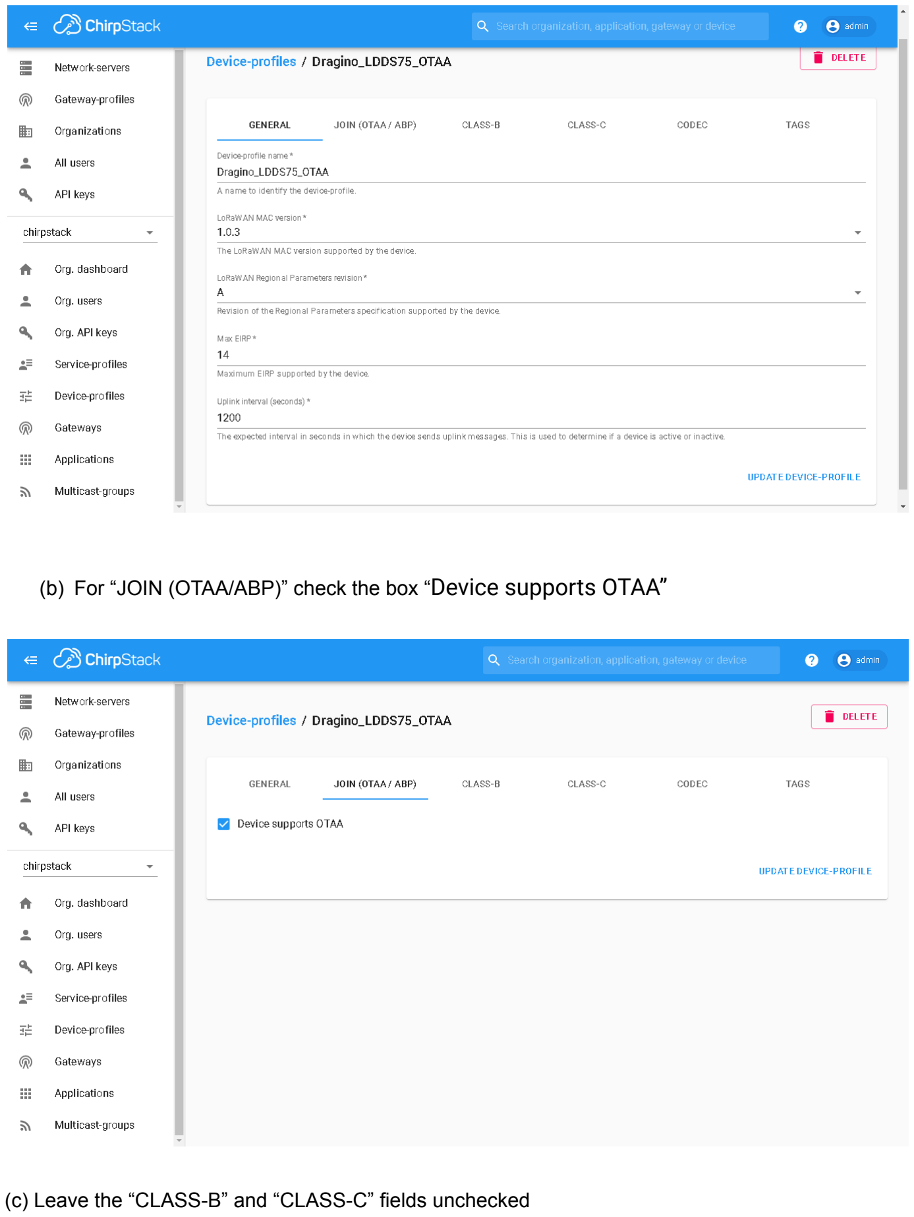
[picture p355: page 5]

(b) For “JOIN (OTAA/ABP)” check the box “Device supports OTAA”
(c) Leave the “CLASS-B” and “CLASS-C” fields unchecked

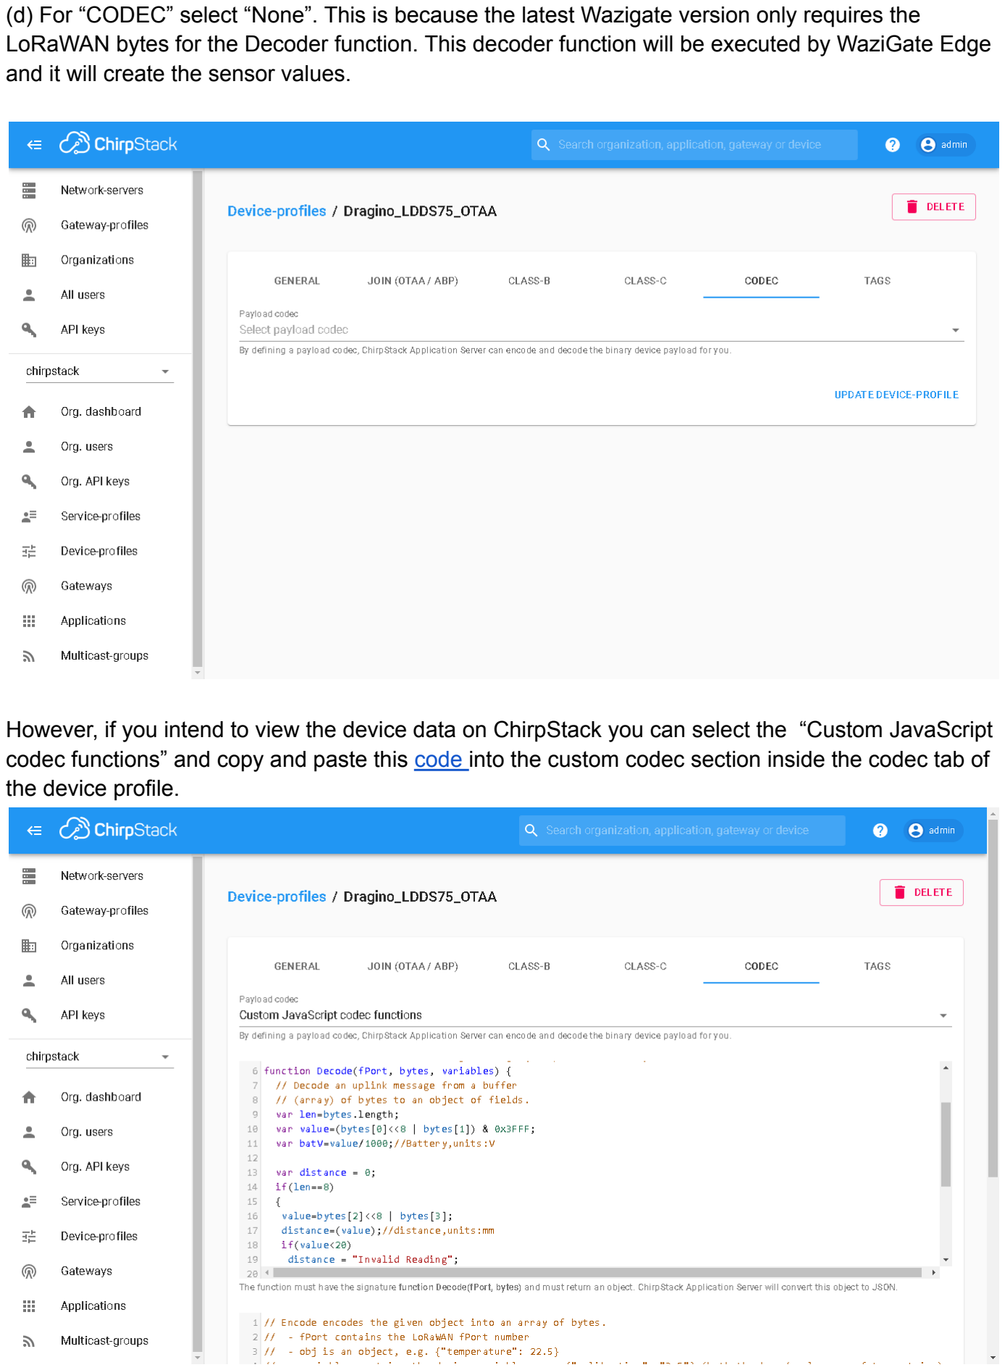
[picture p356: page 6]

(d) For “CODEC” select “None”. This is because the latest Wazigate version only requires the LoRaWAN bytes for the Decoder function. This decoder function will be executed by WaziGate Edge and it will create the sensor values.

However, if you intend to view the device data on ChirpStack you can select the “Custom JavaScript codec functions” and copy and paste this code (https://github.com/Waziup/WaziGate-SenseCap-S2120-integration/blob/main/SenseCap_LoRaWAN_own_Decoder_For_ChirpstackV3_key_value.js) into the custom codec section inside the codec tab of the device profile.

(e) Finally, click the “CREATE DEVICE-PROFILE” button. The new device profile will be listed under “Device-profiles”.

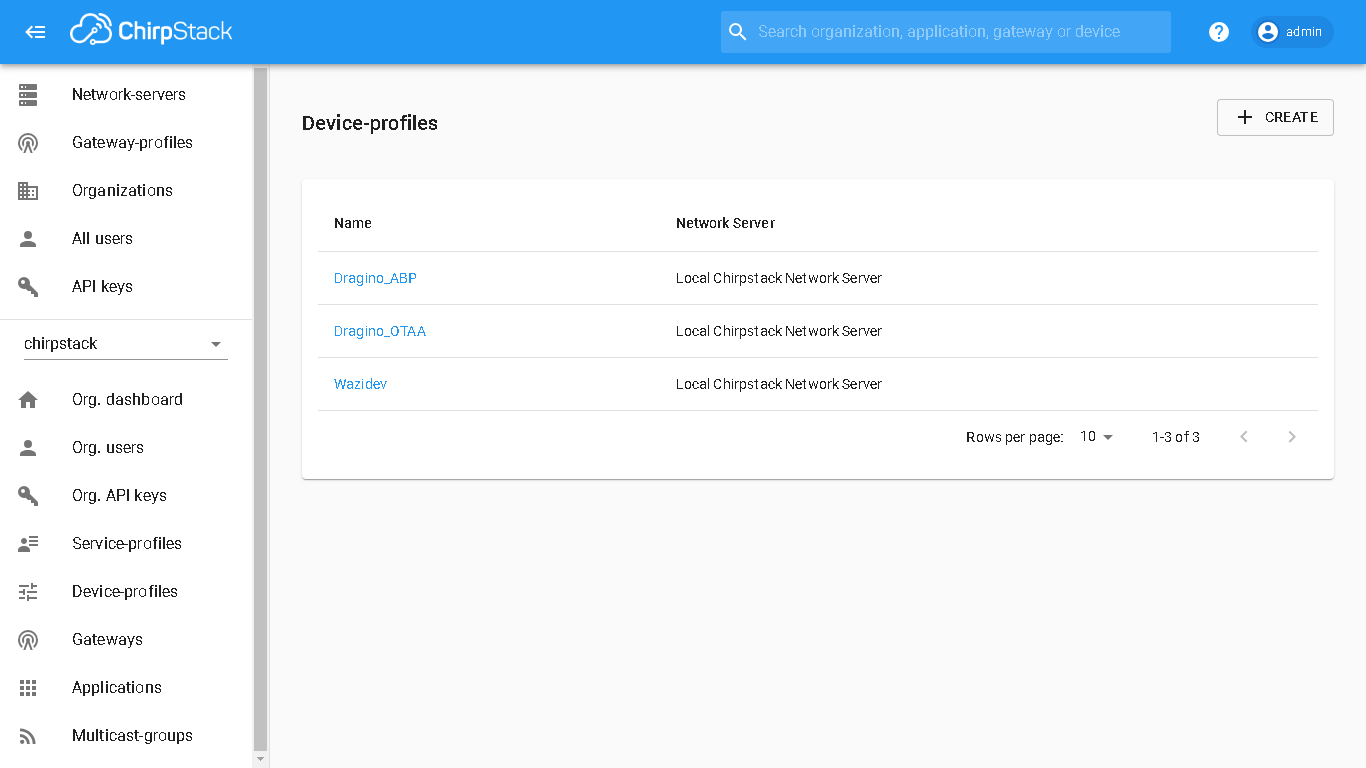
[picture p357: figure]

## Step 3 : Create a OTAA device for WaziGate using WaziGate Edge API

Using the WaziGate Edge API, we can create a new device (https://github.com/Waziup/wazigate-edge#create-a-new-device) that will be defined by a Device EUI and the “Other” LoRaWAN profile. We can run this JavaScript code (https://github.com/Waziup/WaziGate-SenseCap-S2120-integration/blob/main/create_OTAA_device.js) to create the device on WaziGate. In the code, we give the Device EUI of the SenseCap S2120 LoRaWAN device.This key can be obtained from the sticker that is on the bottom of the arm that leads to the wind speed sensor. The credentials for connection can also be changed via the SenseCap Mate application, described in
Step 1.


The JavaScript code also assigns a custom codec to this device using the WaziGate Edge codec’s id. The codec has already been added to the WaziGate for you, you should replace the codec id in the JavaScript code to the one you will find under http://wazigate.local/codecs, if you get a message “Unauthorized”, you just have to log in to the UI again (http://wazigate.local).

If you do not have a custom codec on WaziGate, you can still run the JavaScript code. Afterwards add a custom codec on WaziGate and assign this to the respective device.

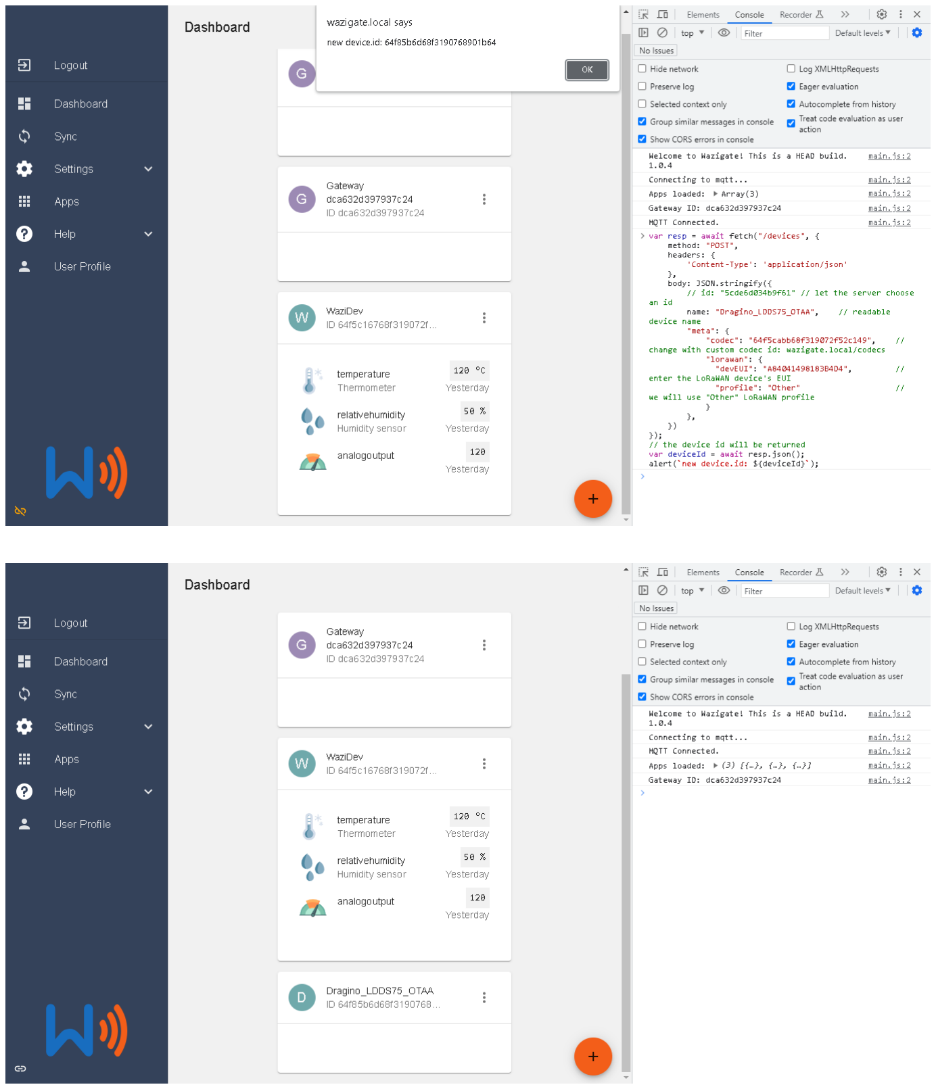
[picture p358: page 9]

## Step 4 : Select the custom WaziGate codec for the SenseCap

Since the SenseCap S2120 Codec is included in the WaziGate you just have to select it after creating the device.

Upload codecs via the WaziGates API (optional, not needed for Seeedstudio SenseCap S2120):

Before we can save and view the sensor data on WaziGate, we need to add a custom decoder function for the bytes that WaziGate is receiving from ChirpStack. The WaziGate Edge GitHub repository has a codec documentation (https://github.com/Waziup/wazigate-edge/blob/f3c77c1d12abdceb597a0b0d941c82e61f223d8b/edge/codecs/README.md) that shows how we can update the codecs. Note that the custom codec should have a Decoder function that is TTN format (chirpstack codec formats are also supported now).

First we need to add a custom codec to WaziGate. We can use this Javascript code (https://github.com/Waziup/WaziGate-SenseCap-S2120-integration/blob/main/SenseCap_LoRaWAN_own_Decoder_For_TTN_cmd_to_add.js) for that. We can run the Javascript code on a web browser’s console provided that the WaziGate is connected to the same network as the PC being used.

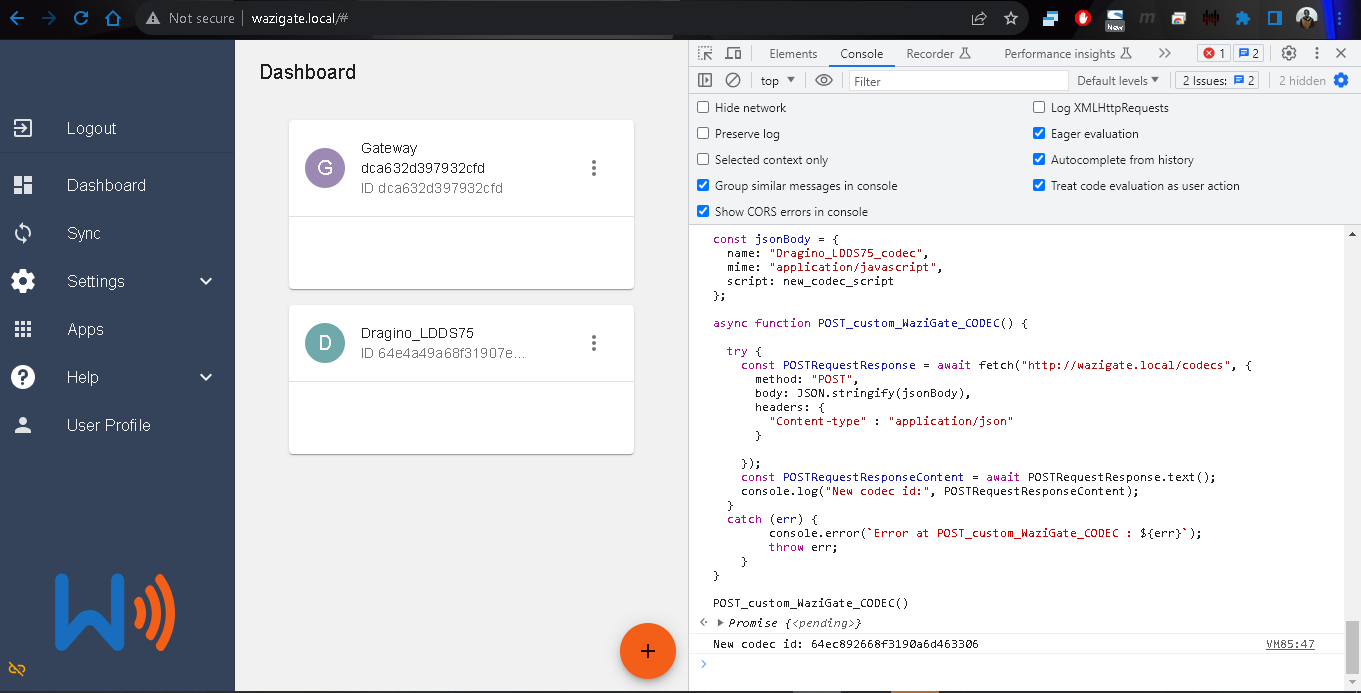
[picture p359: figure]

This will add a new codec called SenseCap S2120 to WaziGate. The last step is to select this codec for the Dragino device that was setup on the WaziGate Dashboard.

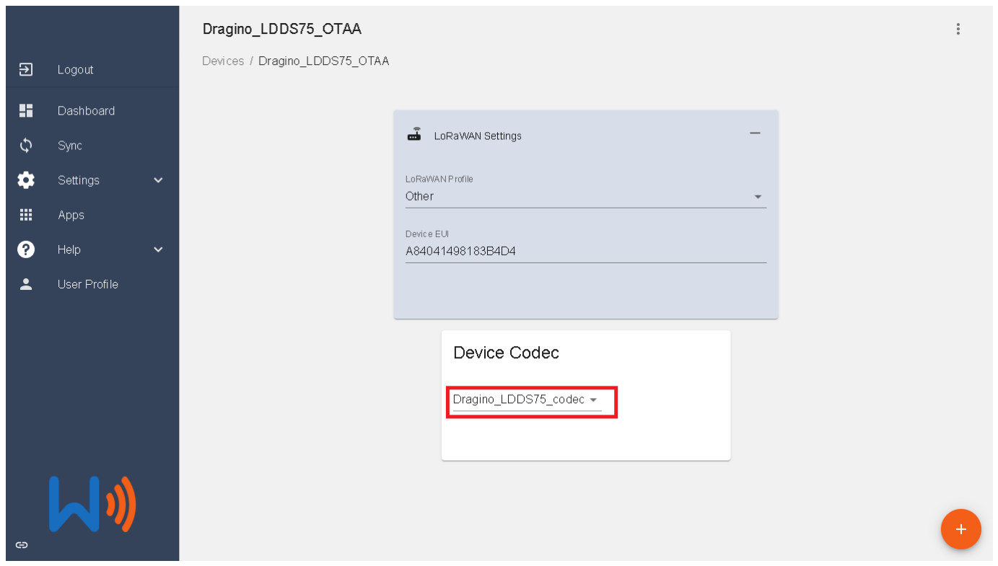
[picture p360: figure]

## Step 5 : Add the WaziGate device to ChirpStack

After creating the LoRaWAN device on WaziGate Dashboard, it does not appear on ChirpStack. To fix this we can use ChirpStack REST API to create the device for the Wazigate application.

First, open ChirpStack Application Server REST API Swagger documentation at http://wazigate.local:8080/api

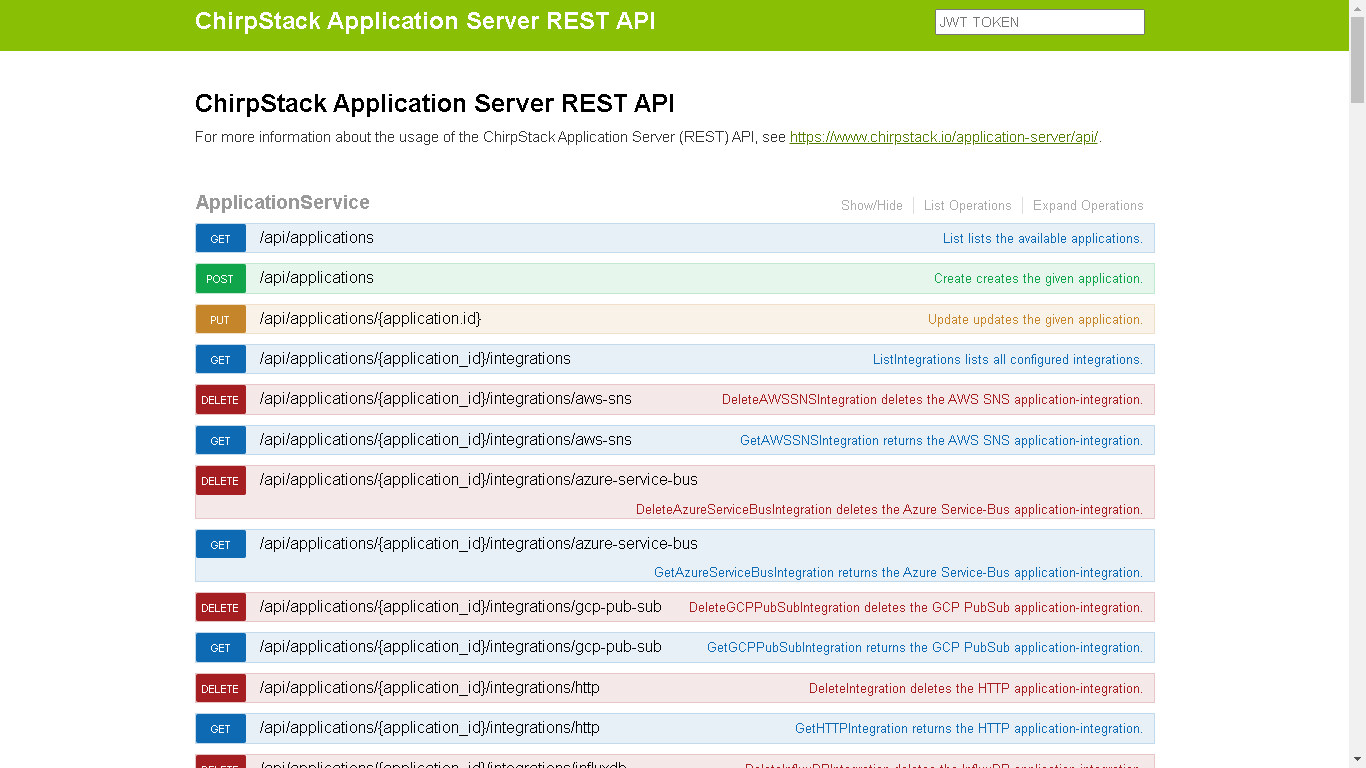
[picture p361: figure]

Unset

Next, scroll to the section “InternalService” and click “POST /api/internal/login”. Here, we need to provide the login details and a JWT token will be provided if the login credentials are correct. For default login credentials, we can paste the following JSON data in the POST request body.

{ "email":"admin", "password":"admin"}

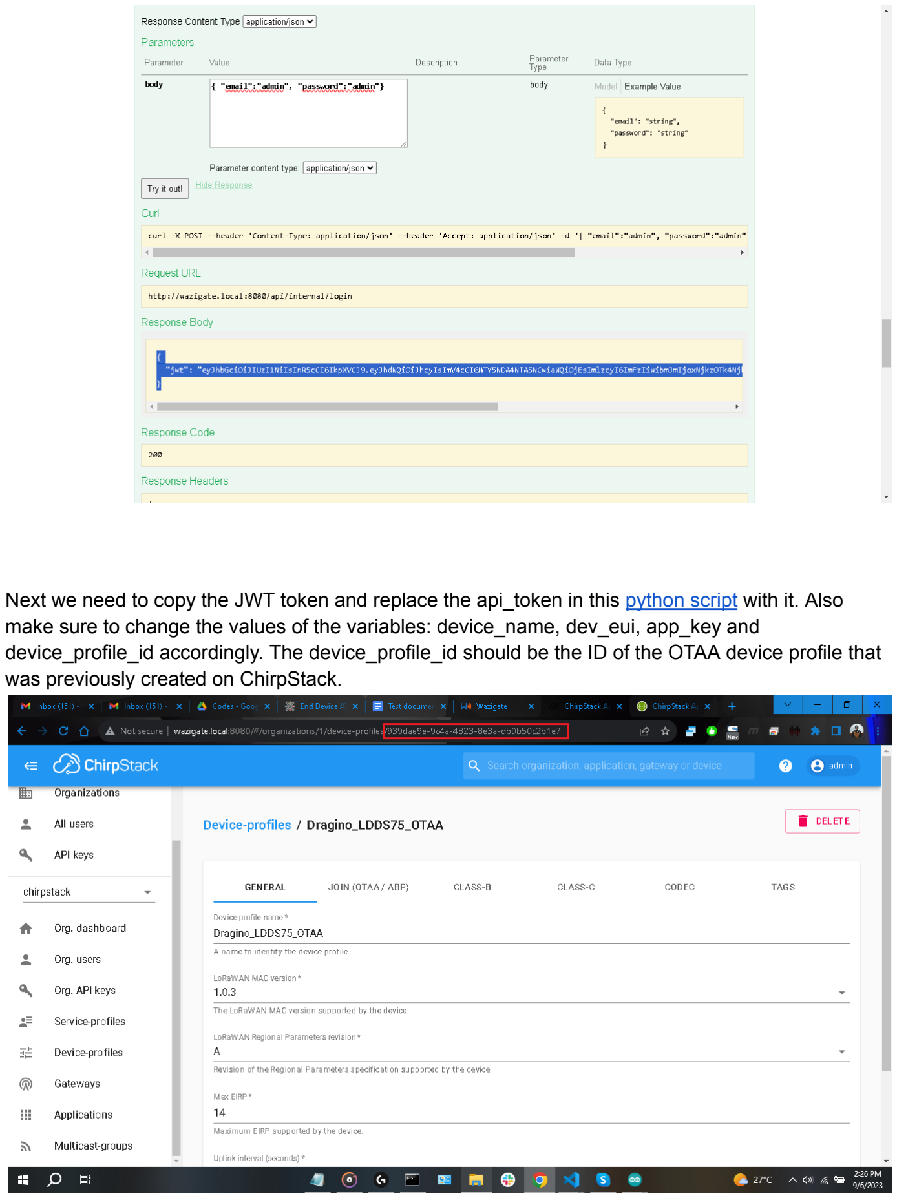
[picture p362: page 13]

Next we need to copy the JWT token and replace the api_token in this python script (https://github.com/Waziup/WaziGate-SenseCap-S2120-integration/blob/main/Add_WaziGate_device_to_ChirpStack.py) with it. Also make sure to change the values of the variables: device_name, dev_eui, app_key and device_profile_id accordingly. The device_profile_id should be the ID of the OTAA device profile that was previously created on ChirpStack.

Finally, run the python script on any computer that is connected to the same subnetwork as the WaziGate. The script will create a device on ChirpStack with the same Device EUI used for the WaziGate device. Afterwards, the script sets the Application Key for this device.

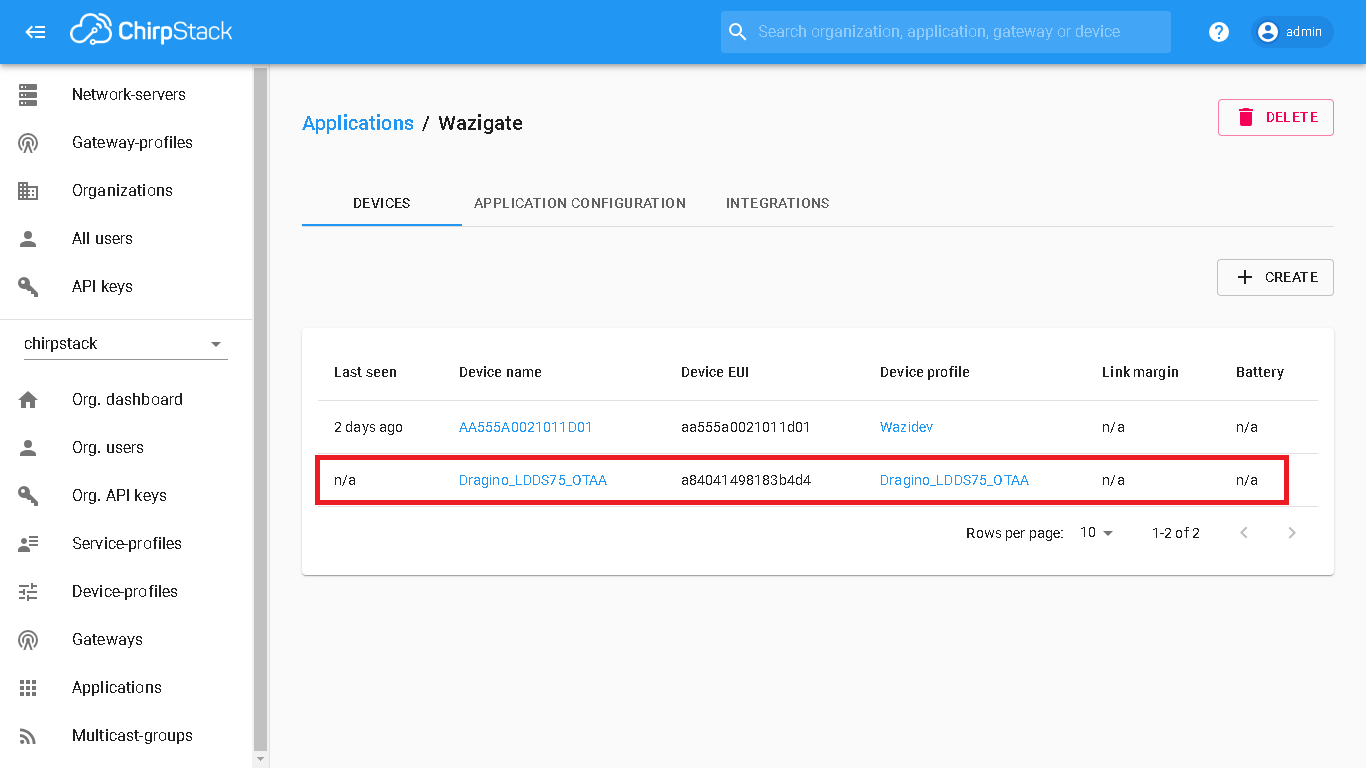
[picture p363: figure]

## Step 6 : Power on SenseCap S2120 Weather Station

To power the device insert the batteries. To restart the device, press the reset button. The device will send join requests to the gateway afterwards.

## Step 7 : View SenseCapS2120 Weather Station on the WaziGate Dashboard

The SenseCapS2120 Weather Station join mode should be OTAA. This is the default join mode, but if it was changed, we can use the SenseCAP app to change it.

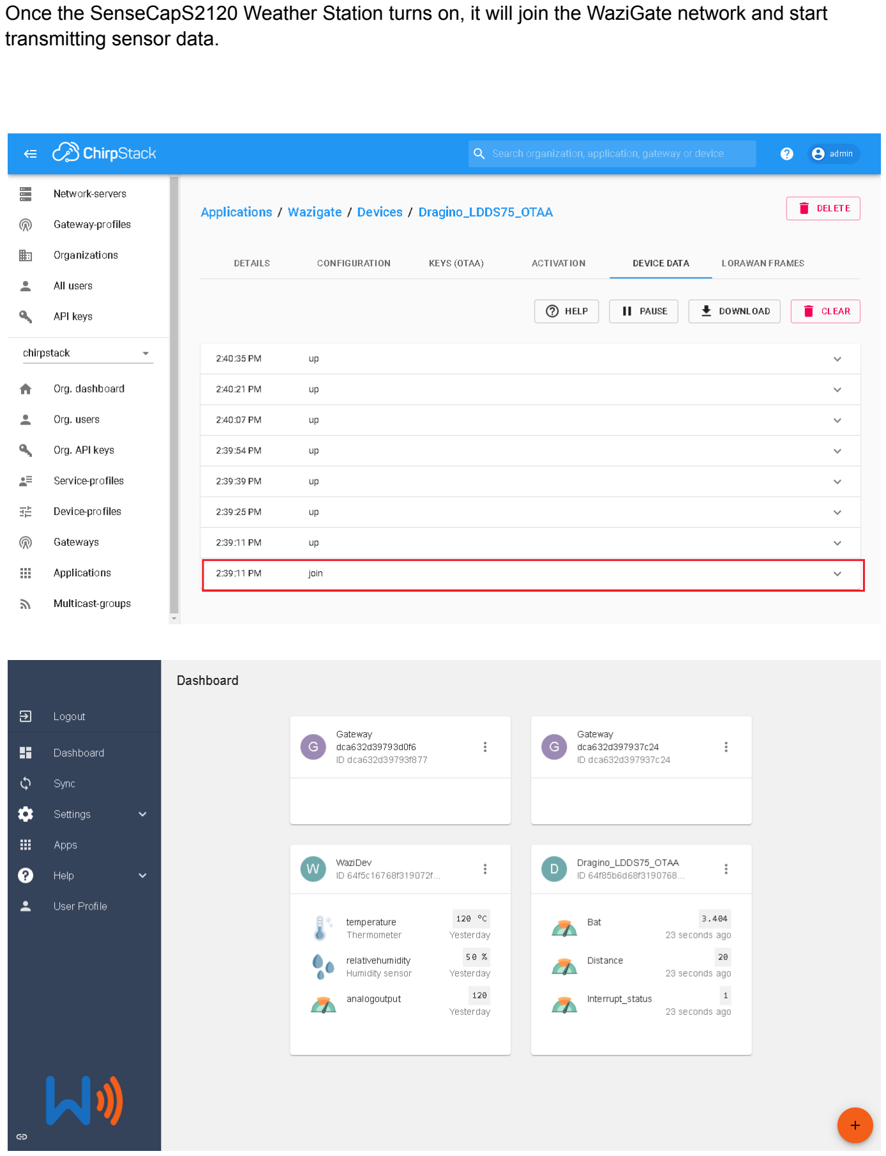
[picture p364: page 15]

Once the SenseCapS2120 Weather Station turns on, it will join the WaziGate network and start transmitting sensor data.
