CongducPham/PEPR_AgriFutur/Gateway/scripts/loracam-ai/tools/128x128-ESP32S3-test.bmp

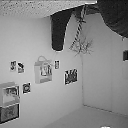
Gateway/scripts/loracam-ai/tools/128x128-ESP32S3-test.bmp
