CongducPham/PEPR_AgriFutur/PCBs/IRD_PCB_4_1/Schematic_IISS_4_1_2023-09-27.pdf

### GND

### GND

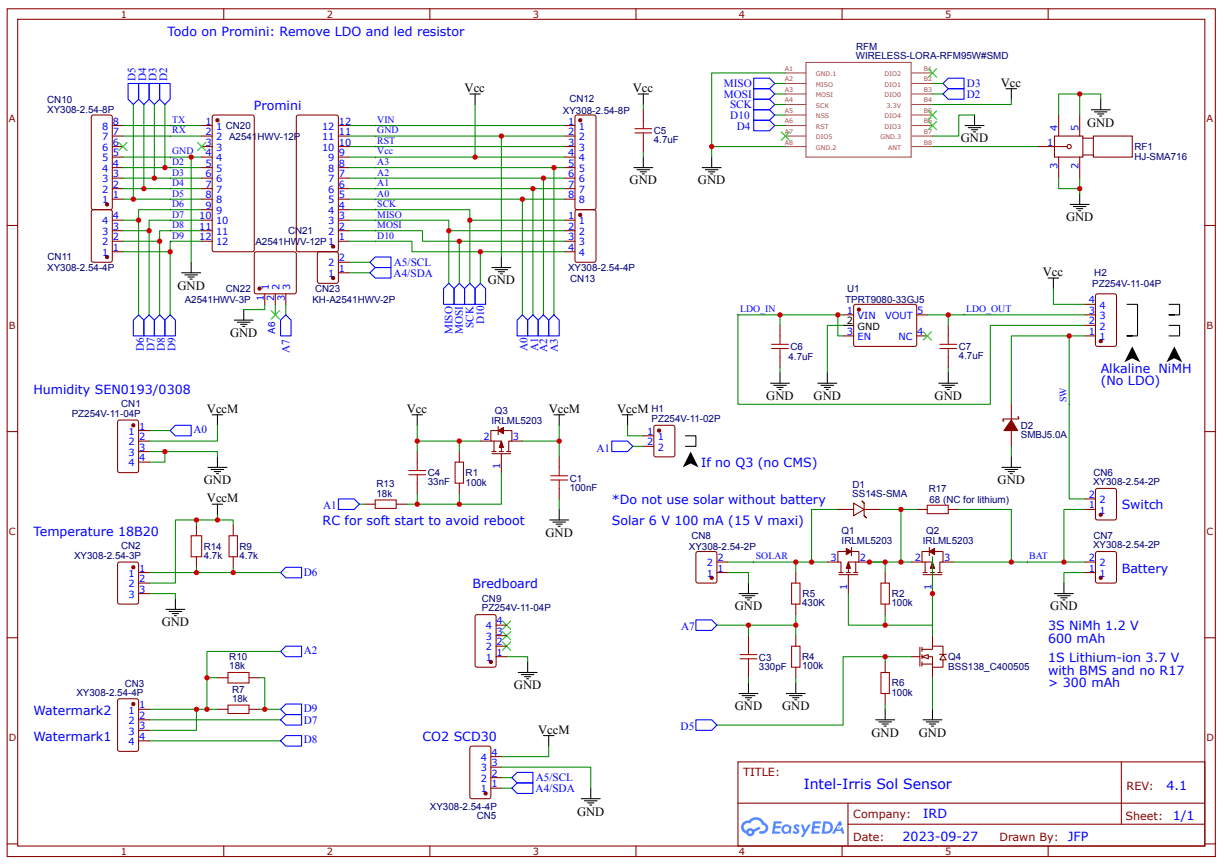
[picture p366: page 1]

Todo on Promini: Remove LDO and led resistor

*Do not use solar without battery
Solar 6 V 100 mA (15 V maxi)

RC for soft start to avoid reboot
