CongducPham/PEPR_AgriFutur/PCBs/IRD_PCB_5/Schematic_IISS_5_2024-05-06.pdf

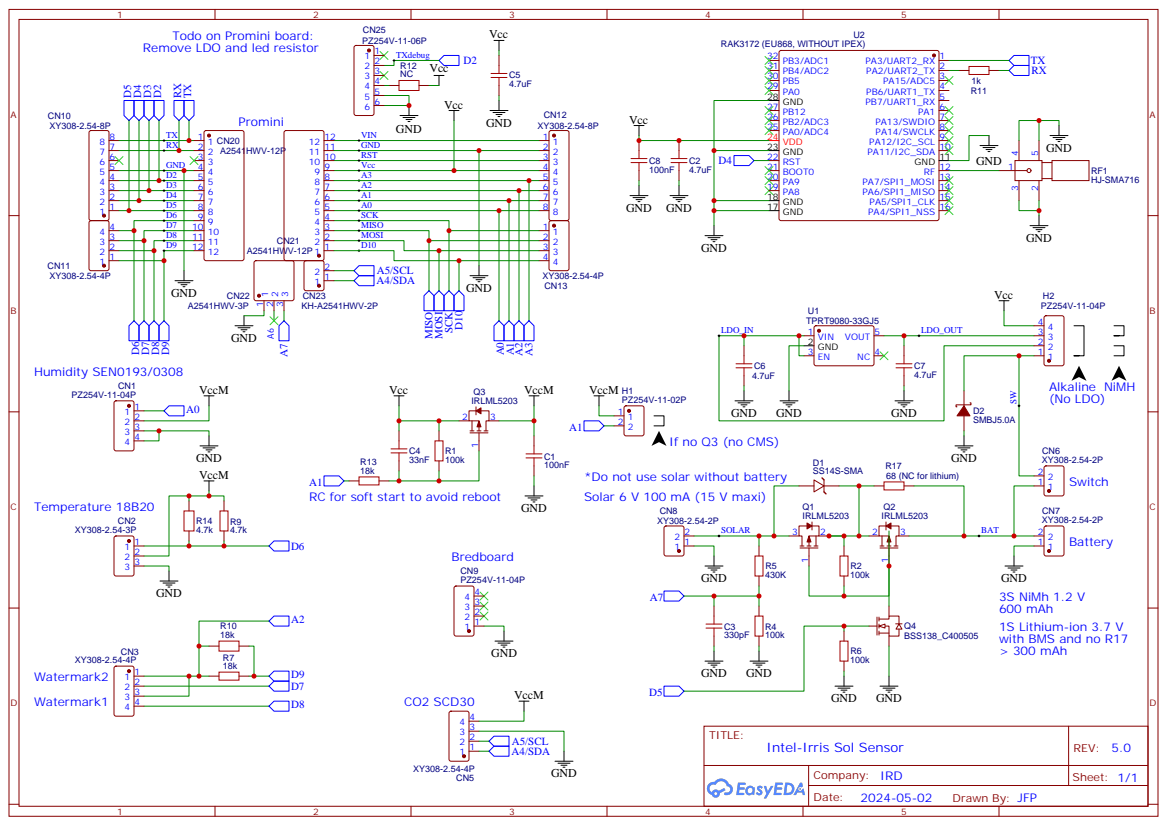
[picture p367: page 1]

Todo on Promini board:
Remove LDO and led resistor

PA4/SPI1_NSS 16 GND 17 GND 18 PA8 19 PA9 20 BOOT0 21 RST 22 GND 23 VDD 24 PA0/ADC4 25 PB2/ADC3 26 PB12 27 GND 28 PA0 29 PB5 30 PB4/ADC2 31 PB3/ADC1 32

*Do not use solar without battery
Solar 6 V 100 mA (15 V maxi)

RC for soft start to avoid reboot
