CongducPham/PEPR_AgriFutur/Arduino_ESP32/Arduino_ESP32_LoRaCAM_AI_on_esp32v3/camera_index.h

//New
#define index_ov2640_new_html_gz_len 6770
const unsigned char index_ov2640_new_html_gz[] = {
0x1f, 0x8b, 0x08, 0x08, 0xf1, 0x06, 0x92, 0x67, 0x00, 0xff, 0x69, 0x6e, 0x64, 0x65, 0x78, 0x2e, 0x68, 0x74, 0x6d, 0x6c, 0x2e, 0x67, 0x7a, 0x00, 0xed, 0x5d, 0x7b, 0x77, 0xda, 0x48, 0x96, 0xff, 0x7b, 0xe7, 0x53, 0x28, 0x74, 0x8f, 0xc1, 0xc7, 0x80, 0x0d, 0x76, 0x3b, 0x69, 0x8f, 0x4d, 0x36, 0x71, 0xdc, 0x49, 0x76, 0xe3, 0xee, 0x4c, 0xbb, 0x1f, 0x99, 0x33, 0x67, 0x4e, 0x5a, 0x40, 0x01, 0xea, 0x08, 0x89, 0x91, 0x84, 0x1f, 0xdd, 0xc7, 0x9f, 0x73, 0xbf, 0xce, 0xfc, 0x6e, 0x55, 0x49, 0x2a, 0x49, 0xa5, 0x17, 0xd8, 0x90, 0xe9, 0x59, 0xe0, 0x80, 0x50, 0x55, 0xdd, 0xba, 0x75, 0x5f, 0x75, 0xeb, 0xd6, 0x43, 0xa7, 0x4f, 0xc6, 0xee, 0x28, 0xb8, 0x5b, 0x30, 0x63, 0x16, 0xcc, 0xed, 0xc1, 0x9f, 0x4e, 0xc5, 0x8f, 0x81, 0xd7, 0xe9, 0x8c, 0x99, 0x63, 0x71, 0xc9, 0xff, 0xce, 0x59, 0x60, 0x1a, 0xa3, 0x99, 0xe9, 0xf9, 0x2c, 0x38, 0x6b, 0x2c, 0x83, 0x49, 0xe7, 0x59, 0x23, 0x9d, 0xec, 0x98, 0x73, 0x76, 0xd6, 0xb8, 0xb6, 0xd8, 0xcd, 0xc2, 0xf5, 0x82, 0x86, 0x31, 0x72, 0x9d, 0x80, 0x39, 0xc8, 0x7e, 0x63, 0x8d, 0x83, 0xd9, 0xd9, 0x98, 0x5d, 0x5b, 0x23, 0xd6, 0xe1, 0x7f, 0xda, 0x96, 0x63, 0x05, 0x96, 0x69, 0x77, 0xfc, 0x91, 0x69, 0xb3, 0xb3, 0x9e, 0x0a, 0x2b, 0xb0, 0x02, 0x9b, 0x0d, 0x2e, 0xae, 0xde, 0x1f, 0xf6, 0x8d, 0xef, 0x7e, 0xea, 0x1f, 0x1d, 0x1f, 0x9c, 0xee, 0x8b, 0x7b, 0x71, 0x1e, 0x3f, 0xb8, 0x53, 0xff, 0xd3, 0x6b, 0xe8, 0x8e, 0xef, 0x8c, 0xdf, 0x13, 0xb7, 0xe8, 0x35, 0x01, 0x12, 0x9d, 0x89, 0x39, 0xb7, 0xec, 0xbb, 0x13, 0xe3, 0x85, 0x87, 0x3a, 0xdb, 0x6f, 0x98, 0x7d, 0xcd, 0x02, 0x6b, 0x64, 0xb6, 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
  0x44, 0xCF, 0x88, 0xDC, 0x3A, 0x99, 0x6A, 0x2B, 0xD3, 0xCB, 0x91, 0xB7, 0xD6, 0xC1, 0x7F, 0x59, 0x3D, 0x52, 0xF7, 0xFA, 0x0D, 0x6B, 0x20, 0xE7, 0xD4, 0x25,
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

};
