CongducPham/PEPR_AgriFutur/Arduino_ESP32/Arduino_ESP32_LoRaCAM_AI_on_esp32v3/local_lorawan.h

#ifndef LOCAL_LORAWAN
#define LOCAL_LORAWAN

#if ARDUINO >= 100
 #include "Arduino.h"
#else
 #include "WProgram.h"
#endif

#include "AES-128_V10.h"
#include "Encrypt_V31.h"

//#define AES_SHOWB64
#ifdef AES_SHOWB64
#include "Base64.h" 
#endif

extern unsigned char DevAddr[4];

/* FROM lorabase.h of LMIC */

enum {
    // Data frame format
    OFF_DAT_HDR      = 0,
    OFF_DAT_ADDR     = 1,
    OFF_DAT_FCT      = 5,
    OFF_DAT_SEQNO    = 6,
    OFF_DAT_OPTS     = 8,
};

enum {
    // Bitfields in frame control octet
    FCT_ADREN  = 0x80,
    FCT_ADRARQ = 0x40,
    FCT_ACK    = 0x20,
    FCT_MORE   = 0x10,   // also in DN direction: Class B indicator
    FCT_OPTLEN = 0x0F,
};

/*------------------------ */

uint8_t local_aes_lorawan_create_pkt(uint8_t* message, uint8_t pl, int fc=-1, unsigned char* dev_addr=NULL);
int8_t local_lorawan_decode_pkt(uint8_t* message, uint8_t pl);

#endif
