CongducPham/PEPR_AgriFutur/Arduino/Generic_Simple_Sensor_Node/DS18B20.h

/*
* Copyright (C) 2016-2023 Congduc Pham, University of Pau, France
*
* Congduc.Pham@univ-pau.fr
*/

#ifndef DS18B20_H
#define DS18B20_H

#include "Sensor.h"
#include "OneWire.h"
#include "DallasTemperature.h"

#define DS18B20_addr 0x28

class DS18B20 : public Sensor {
  public:
    DS18B20(const char* nomenclature, bool is_analog, bool is_connected, bool is_low_power, int pin_read, int pin_power);
    double get_value();
    void update_data();
    
  private:
    OneWire* ds = NULL;
    DallasTemperature* sensors = NULL;
};

#endif
