CongducPham/PEPR_AgriFutur/Arduino/Generic_Simple_Sensor_Node/rawAnalog.h

/*
* Copyright (C) 2016 Congduc Pham, University of Pau, France
*
* Congduc.Pham@univ-pau.fr
*/

#ifndef RAWANALOG_H
#define RAWANALOG_H
#include "Sensor.h"

#define RAWANALOG_SCALE _BOARD_MVOLT_SCALE

class rawAnalog : public Sensor {
  public:    
    rawAnalog(const char* nomenclature, bool is_analog, bool is_connected, bool is_low_power, int pin_read, int pin_power);
    void update_data();
    double get_value();
    uint16_t convert_to_millivolt(double value, uint16_t maxvalue);
};

#endif
