CongducPham/PEPR_AgriFutur/(commit log)

2024-11-19 First commit – extends INTEL-IRIS work
2024-11-23 Update distribution
    [BOM_SMT_TB_RAK3172_868_IISS_PCB5.xlsx, BOM_SMT_TB_RFM95_868_IISS_PCB4_1_wH2.xlsx, BOM_SMT_TB_RFM96_433_IISS_PCB4_1_wH2.xlsx, dump-serial-debug.txt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]
2024-12-18 Update BOM & CPL
    [BOM_SMT_TB_RAK3172_868_IISS_PCB5.xlsx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]
2025-01-17 Update with tools for image sensor device
2025-01-24 Add image sensor PoC code and tools
    [partitions.csv]
2025-01-24 Update with image of the PoC ESP32-S3 LoRaCam
2025-01-29 fix bug in low power management
    [Arduino_ESP32_CAM_CameraWebServer_3_1_1.ino]
2025-02-03 Change name to LoRaCAM and add real LoRa transmission
    [partitions.csv]
2025-02-07 Simplification of Generic Sensor Node's code
2025-02-07 Add slave mode where power cycling is handled by external microcontroller
2025-02-10 Add external power control by Pro Mini driving MOSFET
2025-02-10 add low power description
2025-02-14 Update to name to LoRaCAM-AI, low-power mode validated
    [partitions.csv]
2025-02-21 Update PCBv4.1 and packet format for LoRaCAM-AI
    [BOM_SMT_TB_RFM95_868_IISS_PCB4_1_wH2.xlsx, BOM_SMT_TB_RFM95_868_IISS_PCB4_1_wH2_last-modified-noCN1-noCN5.xlsx, BOM_SMT_TB_RFM95_868_IISS_PCB4_1_wH2_last-modified.xlsx, BOM_SMT_TB_RFM96_433_IISS_PCB4_1_wH2.xlsx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]
2025-02-21 Update PCB files branded for AgriFutur
    [BOM_SMT_TB_RAK3172_868_IISS_PCB5-noCN1-noCN5.xlsx, BOM_SMT_TB_RAK3172_868_IISS_PCB5.xlsx]
2025-02-28 Add gateway component
    [gw-auto-config-service.service.txt]
2025-03-04 Update camera settings
    [gw-auto-config-service.service.txt]
2025-04-15 Update Generic Sensor code and tutorials
2026-02-17 Update for Sensirion SCD30/SCD40 CO2 sensors
2026-02-17 Update tutorials (additional info in wiring sensors)
2026-02-19 Update tutorial on power management
2026-03-13 Fix bug thank you https://github.com/CongducPham/PEPR_AgriFutur/issues/3
    [Generic_Simple_Sensor_Node.ino]
2026-03-13 Fix bug in loop() when no LOW_POWER, see https://github.com/CongducPham/PEPR_AgriFutur/issues/3
    [Generic_Simple_Sensor_Node.ino]
2026-03-17 Update for backup/restore of loracam devices
2026-03-19 fix bug in device id
2026-04-28 Update pictures to new device naming
2026-04-28 Add logical sensor information
2026-04-30 Add scripts to insert sensor test values
2026-05-04 Update scripts for OTAA devices
    [watermark.xlsx]
2026-05-21 3D gateway enclosure
    [TTNRak831Case.step, TTNRak831CaseBottom.stl, TTNRak831CaseTop.stl, TTNRak831Foot.stl, TTNRak831PanelBack.stl, TTNRak831PanelFront.stl]
2026-05-26 Add RFM95Breakout pcb for single-channel LoRa hat
2026-05-27 Additional parts for the new 3D printed enclosure
    [TTNRak831OledCover.stl, TTNRak831PanelBackNew.stl]
2026-05-28 Update 3D enclosure files and photos
    [TTNRak831PanelBack.stl, TTNRak831PanelFront.stl, TTNRak831PanelFrontNew.stl]
2026-05-28 update gateway pictures with 3D enclosure
2026-06-03 Update scripts for OTAA devices and SenseCap2120 integration
2026-06-03 Add support for Aqua-Scope LoRain rain gauge sensor
2026-06-08 Update Arduino code
2026-06-17 Fix bug in restoration of device's data
2026-07-12 fix problem with capacitive and soil temperature combination
    [Generic_Simple_Sensor_Node.ino]
2026-07-14 add device picture
