CongducPham/PEPR_AgriFutur/(notices)

Notices in the files:
Arduino_ESP32/Arduino_ESP32_LoRaCAM_AI_on_esp32v3/local_lorawan.cpp:
This program is free software: you can redistribute it and/or modify
it under the terms of the GNU General Public License as published by
the Free Software Foundation, either version 3 of the License, or
(at your option) any later version.
