CongducPham/PEPR_AgriFutur/images/lora_cam_8.jpg

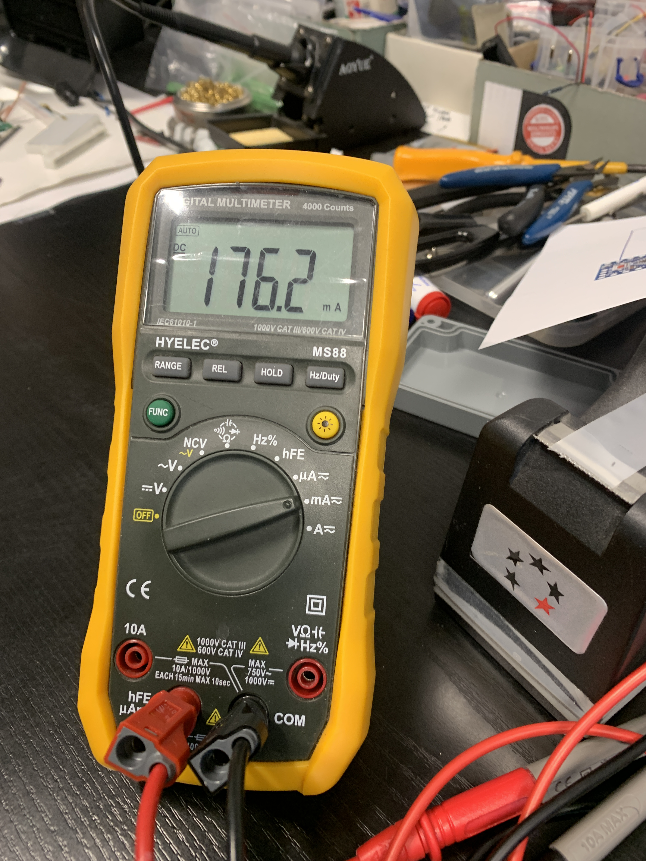
[picture p29: images/lora_cam_8.jpg]
images/lora_cam_8.jpg
