CongducPham/PEPR_AgriFutur/images/lora_cam_9.jpg

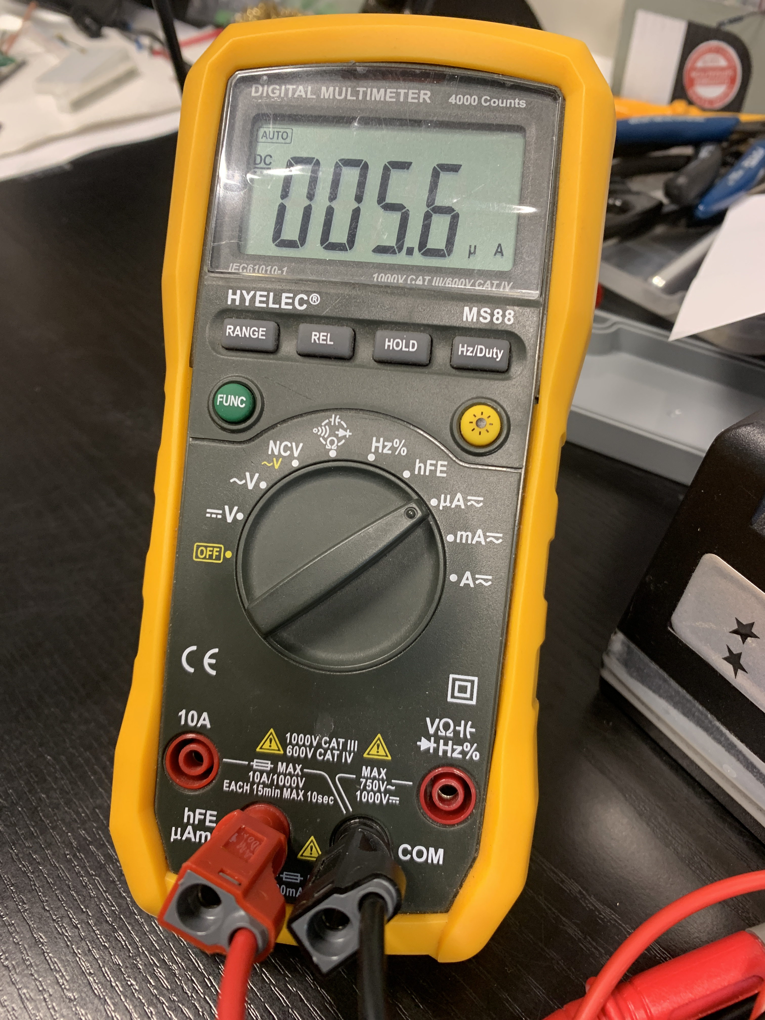
[picture p30: images/lora_cam_9.jpg]
images/lora_cam_9.jpg
